HeinVerhallen/Audio-DSP/Documentation/Module Design Document/main.tex

\documentclass[11pt, a4paper]{report}
\usepackage{graphicx}
\usepackage[table,xcdraw]{xcolor}
\usepackage{geometry}
\usepackage{float}
\usepackage{authblk}
\usepackage{anyfontsize}
\usepackage[document]{ragged2e}
\usepackage{titlesec}
\usepackage[parfill]{parskip}
\usepackage{color}   %May be necessary if you want to color links
\usepackage{hyperref}
\usepackage{caption}
\usepackage{longtable}
\usepackage{blindtext}
\usepackage{pdfpages}
\usepackage{cleveref}
\usepackage{calc}
\usepackage[backend=biber]{biblatex}
\usepackage{longtable}

\bibliography{./bibfolder/ref.bib}
\usepackage{listings}
\usepackage{color}

\definecolor{dkgreen}{rgb}{0,0.6,0}
\definecolor{gray}{rgb}{0.5,0.5,0.5}
\definecolor{mauve}{rgb}{0.58,0,0.82}

\lstset{frame=tb,
  language=VHDL,
  aboveskip=3mm,
  belowskip=3mm,
  showstringspaces=false,
  columns=flexible,
  basicstyle={\small\ttfamily},
  numbers=none,
  numberstyle=\tiny\color{gray},
  keywordstyle=\color{blue},
  commentstyle=\color{dkgreen},
  stringstyle=\color{mauve},
  breaklines=true,
  breakatwhitespace=true,
  tabsize=3
}

\hypersetup{
    colorlinks=true, %set true if you want colored links
    linktoc=all,     %set to all if you want both sections and subsections linked
    linkcolor=black,  %choose some color if you want links to stand out
}
\titleformat{\chapter}[hang]
{\normalfont\huge\bfseries}{\chaptertitlename\ \thechapter}{1em}{} 
\geometry{left=2.5cm,right=2.5cm,top=2.5cm,bottom=2.5cm}
\graphicspath{ {./images/} }

\begin{document}  
    \input{titlepage.tex}

    \chapter{Introduction}
    \input{Introduction.tex}

    \chapter{Problem description}
    \input{Problem_description.tex}

    \chapter{Research}
    \input{Research.tex}

    \chapter{Concept Development}
    \input{Concept_development.tex}

    \chapter{Realization}
    \input{Realization.tex}

    \chapter{Verification}
    \input{Verification.tex}

    \chapter{Conclusions}
    \input{Conclusions.tex}

    \chapter{Recommendations}
    \input{Recommendations.tex}

    \nocite{*}
    \printbibliography
    \addcontentsline{toc}{chapter}{Bibliography} 

    \input{Appendix_statespace.tex}
    \input{Appendix_VHDL_Code.tex}
    \input{Appendix_schematics.tex}
    \input{Appendix_Case_and_UI}
    \input{Appendix_verification.tex}
    \input{Appendix_simulation_results.tex}
    \input{Appendix_RD_G.tex}
    
    \end{justify}
\end{document}
