HeinVerhallen/Audio-DSP/Documentation/Module Design Document/Appendix_schematics.tex

\chapter*{Appendix C: Schematics}
\addcontentsline{toc}{chapter}{Appendix C: Schematics}  
\label{chap:appendix-C-schematics}

\section*{Buck converter schematic} \label{Appendix_buck_schematic}
\phantomsection
\addcontentsline{toc}{section}{Buck converter schematic}
\begin{figure}[ht]  
    
    \caption{Schematic of Buck Converter}
    \label{fig:buck-schematic}
\end{figure}

\section*{SEPIC schematic} \label{Appendix_SEPIC_schematic}
\addcontentsline{toc}{section}{SEPIC schematic}  
\begin{figure}[!ht]
    
    \caption{Schematic of SEPIC}
    \label{fig:SEPIC-schematic}
\end{figure}
    
\section*{Linear regulator schematic}\label{Appendix_lin_schematic}
\addcontentsline{toc}{section}{Linear regulator schematic}
\begin{figure}[!htb]
    
    \caption{Schematic of Linear Regulator}
    \label{fig:Linear-regulator-schematic}
\end{figure}  

\section*{Main board schematic} \label{Appendix_main_schematic}
\addcontentsline{toc}{section}{Main board schematic}\

\includepdf[angle=90, pages={2,3,4,5,6,7,8}]{Main_board_schematic.pdf}

\section*{Buck converter calculations} \label{Appendix_buck_calculations}
\addcontentsline{toc}{section}{Buck converter calculations}
  
\includepdf[pages={2,3,4,5,6}]{Calculations_buck_converter.pdf}

\section*{SEPIC calculations} \label{Appendix_SEPIC_calculations}
\addcontentsline{toc}{section}{SEPIC calculations}  
