HeinVerhallen/Audio-DSP/Documentation/Module Design Document/Appendix_statespace.tex

\chapter*{Appendix A: State-space}
\addcontentsline{toc}{chapter}{Appendix A: State-space}  
\label{chap:appendix-A-statespace}

\begin{figure}[!htb]
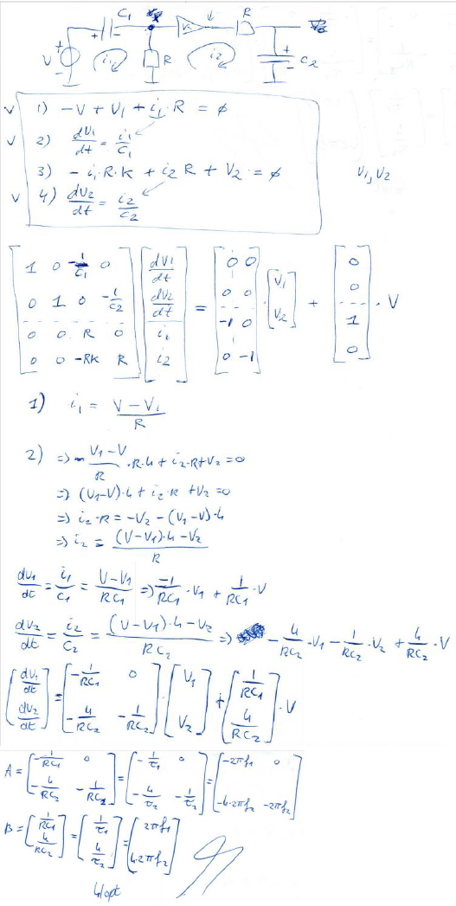
[picture p18: Documentation/Module Design Document/images/State-space_notation_solution.png]
    
    \caption{State-space notation derived from band-pass filter circuit}
    \label{fig:state-space-derived-bpf}
\end{figure}
