HeinVerhallen/Audio-DSP/Documentation/Module Design Document/Realization.tex

\section{Hardware}
\subsection{Schematic}
\input{Schematic.tex}

\subsection{Printed circuit board}
\input{Printed_circuit_board.tex}

\subsection{Case}
\input{Case.tex}

\section{Firmware}
\input{Firmware.tex}

\section{User interface}
\input{UserInterface.tex}
