HeinVerhallen/Audio-DSP/Documentation/PlanOfApproach/Costbenefitoverview.tex

From Fontys we get a budget of €300, - for this project. The most expensive parts will be the FPGA, the ADC’s and the DAC’s.
