HeinVerhallen/Audio-DSP/Plan of Approach.tex

\documentclass[*]{report}
\usepackage{lipsum}
\usepackage{graphicx}
\begin{document}
\title{Plan of Approach \\ \large audio DSP}
\author{Busse Lommers \and Robin van den Dungen \and Silas Kamphuis \and Mahmud Gurler \and Youri Tils \and Ahmed Abdelrahim \and Hein Verhallen}
\date{\today}
\maketitle
\tableofcontents

\chapter{Background}

\section{Be Creative}

\section{The Assignment}

\chapter{Project Result}
\begin{table}
\begin{tabular}{|p{1cm}|l|p{4cm}|l|p{3cm}|l|l|}
\hline
ID & Version & Requirement & Source & Rationale & Priority & Status \\
\hline
U1 & 1 & Two RCA audio inputs & Client & From the project template & Must & Proposed \\
\hline
U2 & 1 & Two XLR audio inputs & Client & From the project template & Must & Proposed \\
\hline
U3 & 1 & Two 6,35mm TRS plug audio inputs & Client & From the project template & Must & Proposed \\
\hline
U4 & 1 & USB type B audio input & Client & From the project template & Must & Proposed \\
\hline
U5 & 1 & Two RCA audio outputs & Client & From the project template & Must & Proposed \\
\hline
U6 & 1 & Four XLR audio outputs & Client & From the project template & Must & Proposed \\
\hline
U7 & 1 & Two 6,35mm TRS plug audio outputs & Client & From the project template & Must & Proposed \\
\hline
U8 & 1 & The system should have a bandwidth (±3 dB) of at least 20 Hz up and till 20 kHz without any filters applied. & Client & From the project template & Must & Proposed \\
\hline
U9 & 1 & Audio sample rate of at least 44.1 kHz & Client & From the project template & Must & Proposed \\
\hline
U10 & 1 & 16-bit ADC & Client & From the project template & Must & Proposed \\
\hline
U11 & 1 & 16-bit DAC & Client & From the project template & Must & Proposed \\
\hline
U12 & 1 & •	The system must work stand alone and be configurable via a basic graphical user interface. & Client & From the project template & Must & Proposed \\
\hline
U13 & 1 &  & Client & From the project template & Must & Proposed \\
\hline
U14 & 1 &  & Client & From the project template & Must & Proposed \\
\hline
U15 & 1 &  & Client & From the project template & Must & Proposed \\
\hline
U16 & 1 &  & Client & From the project template & Must & Proposed \\
\hline
U17 & 1 &  & Client & From the project template & Must & Proposed \\
\hline
U18 & 1 &  & Client & From the project template & Should & Proposed \\
\hline
U19 & 1 &  & Client & From the project template & Should & Proposed \\
\hline
U21 & 1 &  & Client & From the project template & Should & Proposed \\

\hline
\end{tabular}
\caption{User Requirements}
\end{table}

\chapter{Project Activities}
\begin{figure}

\caption{luca me zunne blijen bakkes	}
\end{figure}

\chapter{Project boundaries}
\lipsum[2-5]

\chapter{Milestones}
\lipsum[2-5]

\chapter{Planning}
\lipsum[2-5]

\chapter{Risk Analysis}
\lipsum[2-5]

\end{document}
