HeinVerhallen/Audio-DSP/Documentation/Research document/Research document.tex

\documentclass[11pt, a4paper]{report}
\usepackage{graphicx}
\usepackage[table,xcdraw]{xcolor}
\usepackage{geometry}
\usepackage[backend=biber]{biblatex}
\usepackage{float}
\usepackage{authblk}
\usepackage{anyfontsize}
\usepackage[document]{ragged2e}
\usepackage{titlesec}
\usepackage[parfill]{parskip}
\usepackage{amsmath}
\titleformat{\chapter}[hang] 
{\normalfont\huge\bfseries}{\chaptertitlename\ \thechapter:}{1em}{} 
\geometry{left=2.5cm,right=2.5cm,top=2.5cm,bottom=2.5cm}
\graphicspath{ {./images/} }

\addbibresource{bibfolder/ref.bib}

% CHECK https://www.youtube.com/watch?v=ZYvS52511oQ FOR INFO ON SETTINGS FOR biblatex

\begin{document}

\pagestyle{empty}
\centering
\fontsize{2cm}{2cm}\selectfont{Research document} \\
\vspace{2mm}
\fontsize{1cm}{1cm}\selectfont Audio digital signal processor \\
\vspace{2mm}
\large BeCreative Minor\\
\normalsize
\vspace{4cm}
\\
\vfill
\normalsize Busse Lommers \\
Robin van den Dungen \\
Mahmud Gürler \\
Silas Kamphuis \\
Hein Verhallen \\
Youri Tils \\
Ahmed Abdelrahim \\
Fontys Hogescholen, De Rondom 1, 5612 AP Eindhoven \\
\today

\begin{justify}

\newpage
\tableofcontents
\thispagestyle{empty}

\listoffigures
\thispagestyle{empty}

\listoftables
\thispagestyle{empty}

\newpage
\pagestyle{plain}
\setcounter{page}{1}

\chapter*{List of Abbreviations}
\begin{table}[!h]
	\centering
\begin{tabular}{|c|c|}
	\hline
\textbf{Abbreviation} & \textbf{Explanation}        			\\ \hline
DSP                   & Digital Signal Processor    			\\ \hline
ADC                   & Analog-to-Digital Converter				\\ \hline
DAC                   & Digital-to-Analog Converter				\\ \hline
SNR 				  & Signal-to-Noise Ration    				\\ \hline
THD 				  & Total Harmonic Distortion 				\\ \hline
ENOB 				  & Effective Number Of Bits 		   		\\ \hline
SINAD 				  & Signal-to-noise and distortion ratio	\\ \hline
\end{tabular}
\caption{List of commonly used Abbreviations}
\label{Abbreviation list}
\end{table}

\chapter{Introduction}
%	\input{introduction.tex}

\chapter{Research questions}

	\input{question1.tex}

% Bibliography with heading so it pops up in the table of contents (idkwhy but this is how it works)
\printbibliography[
	heading=bibintoc,
	title={Bibliography}
]

\appendix

\chapter{Appendix A}

\end{justify}
\end{document}
