HeinVerhallen/Audio-DSP/Documentation/PlanOfApproach/PlanOfApproach.tex

\documentclass[11pt, a4paper]{report}
\usepackage{graphicx}
\usepackage[table,xcdraw]{xcolor}
\usepackage{geometry}
\usepackage{float}
\usepackage{authblk}
\usepackage{anyfontsize}
\usepackage[document]{ragged2e}
\usepackage{titlesec}
\usepackage[parfill]{parskip}
\usepackage{color}   %May be necessary if you want to color links
\usepackage{hyperref}
\usepackage{caption}
\usepackage{tabularx}
\usepackage{longtable}
\usepackage{blindtext}
\hypersetup{
    colorlinks=true, %set true if you want colored links
    linktoc=all,     %set to all if you want both sections and subsections linked
    linkcolor=black,  %choose some color if you want links to stand out
}
\titleformat{\chapter}[hang] 
{\normalfont\huge\bfseries}{\chaptertitlename\ \thechapter:}{1em}{} 
\geometry{left=2.5cm,right=2.5cm,top=2.5cm,bottom=2.5cm}
\graphicspath{ {./images/} }

% Handy link: https://artofproblemsolving.com/wiki/index.php/LaTeX:Layout

% CHECK https://www.youtube.com/watch?v=ZYvS52511oQ FOR INFO ON SETTINGS FOR biblatex

\begin{document}
\pagestyle{empty}
\centering
\fontsize{2cm}{2cm}\selectfont{Plan of Approach} \\
\vspace{2mm}
\fontsize{1cm}{1cm}\selectfont Audio digital signal processor \\
\vspace{2mm}
\large BeCreative Minor\\
\normalsize
\vspace{4cm}
\\
\vfill
\normalsize Busse Lommers \\
Robin van den Dungen \\
Mahmud Gürler \\
Silas Kamphuis \\
Hein Verhallen \\
Youri Tils \\
Ahmed Abdelrahim \\
Fontys Hogescholen, De Rondom 1, 5612 AP Eindhoven \\
\today

\begin{justify}

\newpage
\tableofcontents
\thispagestyle{empty}

\listoffigures
\thispagestyle{empty}

\listoftables
\thispagestyle{empty}

\newpage
\pagestyle{plain}
\setcounter{page}{1}

\chapter*{Abbreviation List}

\begin{table}[!h]
	\centering
\begin{tabular}{|c|c|}
	\hline
\textbf{Abbreviation} & \textbf{Explanation}        \\ \hline
DSP                   & Digital Signal Processor    \\ \hline
ADC                   & Analog-to-Digital Converter \\ \hline
DAC                   & Digital-to-Analog Converter \\ \hline
\end{tabular}
\caption{List of commonly used Abbreviations}
\label{Abbreviation list}
\end{table}

\chapter{Background}
	\input{Background}

\chapter{Project result}
	\input{Projectresult}
	
\chapter{Project activities}
	\input{Projectactivities}

\chapter{Project boundaries}
	\input{Projectboundaries}
	
\chapter{Milestones}
	\input{Milestones}

\chapter{Quality assurance}
	\input{Qualityassurance}

\chapter{Project organisation}
	\input{Projectorganisation}

\chapter{Planning}
	\input{Planning}

\chapter{Cost-benefit overview}
	\input{Costbenefitoverview}

\chapter{Risk Analysis}
	\input{Riskanalysis}

% Bibliography with heading so it pops up in the table of contents (i don't know why but this is how it works)
% \printbibliography[
% heading=bibintoc,
% title={Bibliography}
% ]
	\end{justify}
\end{document}
