HeinVerhallen/Audio-DSP/Documentation/PlanOfApproach/Milestones.tex

%Milestones
The following milestones will be achieved as a result of the project activities as in Chapter 3.
\begin{itemize}
    \setlength\itemsep{-0.2em}
    \item Reports:
    \begin{itemize}
        \setlength\itemsep{-0.2em}
        \item Research document
        \item SRD
        \item SDD
        \item MDD
        \item Final report
    \end{itemize}
    \item Designs:
    \begin{itemize}
        \setlength\itemsep{-0.2em}
        \item Firmware design:
        \begin{itemize}
            \setlength\itemsep{-0.2em}
            \item Input MUX design
            \item Sampler design
            \item USB decoder design
            \item Output MUX design
            \item signal processor design
            \begin{itemize}
                \setlength\itemsep{-0.2em}
                \item Effect manager design
                \item Effects design/model
                \item Filters design/model
            \end{itemize}
            \item controller design
        \end{itemize}
        \item Hardware design:
        \begin{itemize}
            \setlength\itemsep{-0.2em}
            \item Input selector design
            \item Anti-aliasing filters design
            \item Output filter design
            \item Buffer design
            \item XLR balanced-to-unbalanced converter design
            \item XLR unbalanced-to-balanced converter design
            \item processor core design
            \item Local power supplies design
            \item Housing design
        \end{itemize}
        \item User interface design
    \end{itemize}
    \item Realistation:
    \begin{itemize}
        \setlength\itemsep{-0.2em}
        \item Firmware:
        \begin{itemize}
            \setlength\itemsep{-0.2em}
            \item Program ADC and DAC interface
            \item Program sampler
            \item Program USB decoder
            \item Program MUX
            \item Program signal processor
            \begin{itemize}
                \setlength\itemsep{-0.2em}
                \item Program effect manager
                \item Program filters
                \item Program effects
            \end{itemize}
            \item Program controller
        \end{itemize}
        \item Hardware:
        \begin{itemize}
            \setlength\itemsep{-0.2em}
            \item Housing
            \item PCB
        \end{itemize}
        \item User interface
    \end{itemize}
\end{itemize}
