HeinVerhallen/Audio-DSP/Documentation/PlanOfApproach/Qualityassurance.tex

To assure that the quality is monitored the following things will be done:
\begin{itemize}
	\setlength\itemsep{-0.3em}
    \item Version-control with GitHub
    \item Documents will be written in LaTeX
    \item Weekly activities will be monitored to guard the process.
    \item The PCB design will be made in KiCad
    \item C++ code is written with Microsoft Visual Studio
\end{itemize}
