HeinVerhallen/Audio-DSP/Firmware/DASstudent2021/DAS docent 1 board.docx

DAS docent 1 board:

1. Start testdas project
2. Compile all by runnig synthesis and analysis
3. Start modelsim
4. Compile das.vhd and all related testbench files
5. Run the do file for adding signals or add them by yourself
6. Run 30000000 or any other number
7. Check the results.
8. Generate programming file
9. Test it.
