HeinVerhallen/Audio-DSP/LTspice/Negatve supply (-15V SEPIC)/LT3579_calculations.docx

Step | PARAMETERS/EQUATIONS
1: Inputs | Pick V_(in) , V_(out) ,and f_(osc) to calculate equations below. | V_(in) =18 V V_(out) =-15 V f_(osc) =1 MHz (<f_(max) =2.5MHz)
2: DC | DC≅(|V_(OUT) |+0.5V)/(V_(IN) +|V_(OUT) |+0.5V-0.27V) | DC≅(|-15|+0.5)/(18+|-15|+0.5-0.27)=46.6%
3: L | L_(TYP) =((V_(IN) -0.27V)∙DC)/(f_(OSC) ∙1.8A) L_(MIN) =((V_(IN) -0.27V)∙(2DC-1))/(4A∙f_(OSC) ∙(1-DC)) L_(MAX) =((V_(IN) -0.27V)∙DC)/(f_(OSC) ∙0.5A) | L_(TYP) =((18-0.27)∙0.466)/(1∙10^6 ∙1.8)=4.59 µH L_(MIN) =((18-0.27)∙(2∙0.466-1))/(4∙1∙10^6 ∙(1-0.466))=-564 nH→564 nH L_(MAX) =((18-0.27)∙0.466)/(1∙10^6 ∙0.5)=16.5 µH
4: I_(RIPPLE) | I_(RIPPLE) =((V_(IN) -0.27)∙DC)/(f_(OSC) ∙L) | I_(RIPPLE) =((18-0.27)∙0.466)/(1∙10^6 ∙4∙10^(-6))=2.066 A
5: I_(OUT) | I_(OUT) =(6A-(I_(RIPPLE))/2)∙(1-DC) | I_(OUT) =(6-2.066/2)∙(1-0.466)=2.652 A
6: D_1 | V_R >V_(IN) +|V_(OUT) |;I_(AVG) >I_(OUT) | V_R >18+|-15|→V_R >33 V I_(AVG) >1vA
7: C_1 | 4.7 μF (typical);V_(RATING) >V_(IN) +|V_(OUT) | | C_1 =4.7 μF V_(RATING) >18+|-15|→V_(RATING) >33 V
8: C_(OUT) | C_(OUT) =(I_(RIPPLE))/(8∙f_(OSC) ∙5∙10^(-3) ∙|V_(OUT) |) | C_(OUT) =2.066/(8∙1∙10^6 ∙5∙10^(-3) ∙|-15|)=3.443 μF
9: C_(IN) | C_(IN) =C_(PWR) +C_(VIN) C_(IN) =(I_(RIPPLE))/(8∙f_(OSC) ∙5∙10^(-3) ∙V_(IN))+(6A∙DC)/(40∙f_(OSC) ∙5∙10^(-3) ∙V_(IN)) | C_(IN) =2.066/(8∙1∙10^6 ∙5∙10^(-3) ∙18)+(6∙0.466)/(40∙1∙10^6 ∙5∙10^(-3) ∙18)=3.646 μF
10: R_(FB) | R_(FB) =(|V_(OUT) |+9mV)/(83.3μA) | R_(FB) =(|-15|+9∙10^(-3))/(83.3∙10^(-6))=180.180 kΩ→180 kΩ
11: R_T | R_T =87.6/(f_(OSC))-1;f_(OSC) in MHz and R_T in kΩ | R_T =87.6/1-1=86.6 kΩ→82 kΩ
