HeinVerhallen/Audio-DSP/LTspice/Front-end/High side switch level shifter schematic.pdf

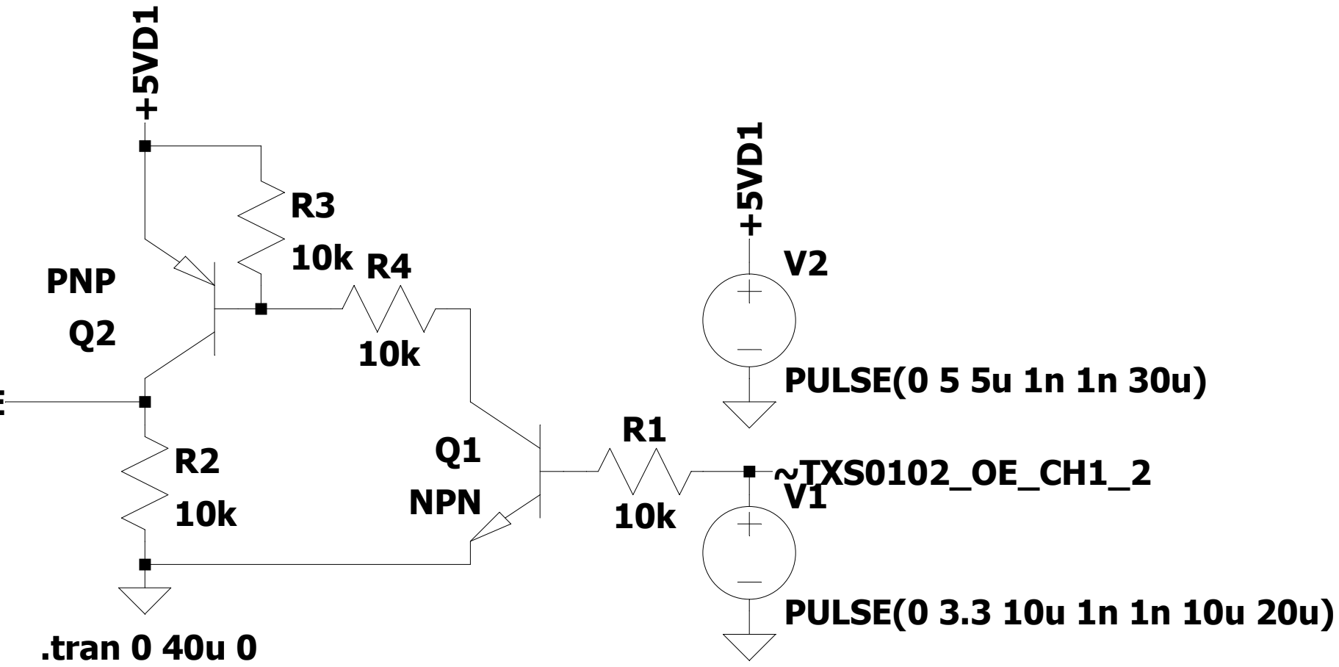
[picture p43: figure]
Q1 NPN; PNP; PULSE(0 3.3 10u 1n 1n 10u 20u); PULSE(0 5 5u 1n 1n 30u) ⁺⁵VD¹; +⁵VD¹; ~TXS0102_OE_CH1_2; .tran 0 40u 0

OE

--- C:\Users\robin\OneDrive\Documenten\School\Fontys\Minor\Be creative minor\Git\Audio-DSP\LTspice\Front-end\High side switch level shifter.asc ---
