HeinVerhallen/Audio-DSP/Block diagrams/System design/Back-end detailed.pdf

# Legend

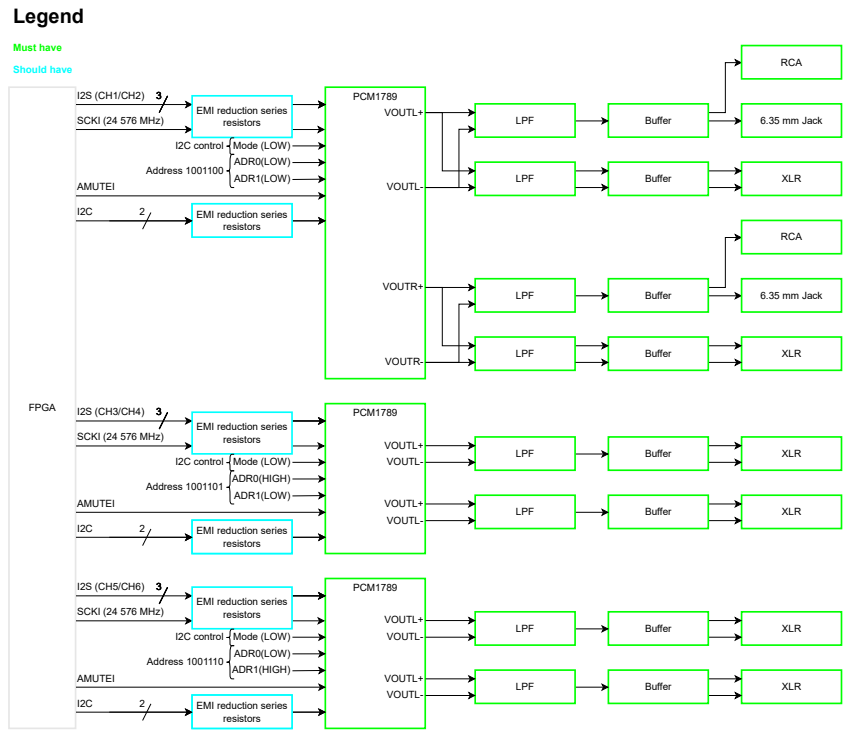
[picture p44: page 1]
Must have; Should have; FPGA; Mode (LOW); SCKI (24 576 MHz)3; PCM1789; LPF; Buffer; XLR; 6.35 mm Jack; RCA; VOUTL-; VOUTL+; ADR0(LOW); ADR1(LOW); AMUTEI; EMI reduction series; VOUTR-; VOUTR+; ADR0(HIGH); I2C control; Address 1001100; Address 1001101; ADR1(HIGH); Address 1001

EMI reduction series
resistors

EMI Red Resistors
