HeinVerhallen/Audio-DSP/Documentation/Module Design Document/images/Calculations_buck_converter.pdf

## Calculations 5V buck:

- Fs = 1MHz
- Cout = 50 uF DC derated
- Vin = 24V
- Vout = 5V
- Iout = 2A
- Fc = Fs/10 = 100KHz
- Vout = 10mV
- ESR = 10mΩ

L =

0.7 ∗ Vout
Fs

=

0.7 ∗ 5
1MHz = 0.0000035H = 3.5μH => 4.7μH

D =

Vout

Vin

=

5V
24V

= 0.208

T =

1
Fs

=

1
1MHz = 1μS

∆Il =

Vin − Vout
L

∗ D ∗ T =

24 − 5
4.7μH ∗ 0.208 ∗ 1μS = 0.841A

Cout =

∆Q

∆Vcout

=

∆Il

8 ∗ Fs ∗ ∆Vcout

=

0.841A
8 ∗ 1MHz ∗ 10mV = 1.5 ∗ 10⁻⁵ = 10.5μF

∆Vcout =

∆Q

Cout

=

∆Il

8 ∗ Fs ∗ Cout

=

0.841A
8 ∗ 1MHz ∗ 50μF = 2.10 ∗ 10⁻³ = 2.10mV

Met ESR:

∆Vcout = ∆Il (

1

8 ∗ Fs ∗ Cout

+ ESR) = 0.841 (

1
8 ∗ 1MHz ∗ 50μF + 10mΩ) = 0.0105 = 10.5mV

## Calculations 8V buck:

- Fs = 1MHz
- Cout = 50 uF DC derated
- Vin = 24V
- Vout = 8V
- Iout = 2A
- Fc = Fs/10 = 100KHz
- Vout = 10mV
- ESR = 10mΩ

L =

0.7 ∗ Vout
Fs

=

0.7 ∗ 8
1MHz = 5.6 ∗ 10⁻⁶ = 5.6μH => 6.8μH

D =

Vout

Vin

=

8V
24V

= 0.3333

T =

1
Fs

=

1
1MHz = 1μS

∆Il =

Vin − Vout
L

∗ D ∗ T =

24 − 8
6.8μH ∗ 0.3333 ∗ 1μS = 0.784

Cout =

∆Q

∆Vcout

=

∆Il

8 ∗ Fs ∗ ∆Vcout

=

0.784A
8 ∗ 1MHz ∗ 10mV = 9.8 ∗ 10⁻⁶ = 9.8μF

∆Vcout =

∆Q

Cout

=

∆Il

8 ∗ Fs ∗ Cout

=

0.784A
8 ∗ 1MHz ∗ 50μF = 1.96 ∗ 10⁻³ = 1.96mV

Met ESR:

∆Vcout = ∆Il (

1

8 ∗ Fs ∗ Cout

+ ESR) = 0.784 (

1
8 ∗ 1MHz ∗ 50μF + 10mΩ) = 9.8 ∗ 10⁻³ = 9.8mV

## Calculations 12V buck:

- Fs = 1MHz
- Cout = 50 uF DC derated
- Vin = 24V
- Vout = 12V
- Iout = 4A of 2A
- Fc = Fs/10 = 100KHz
- Vout = 10mV
- ESR = 10mΩ

L =

0.7 ∗ Vout
Fs

=

0.7 ∗ 12
1MHz = 8.4 ∗ 10⁻⁶ = 8.4μH => 10μH

D =

Vout

Vin

=

12V
24V

= 0.5

T =

1
Fs

=

1
1MHz = 1μS

∆Il =

Vin − Vout
L

∗ D ∗ T =

24 − 12
10μH ∗ 0.5 ∗ 1μS = 0.6

Cout =

∆Q

∆Vcout

=

∆Il

8 ∗ Fs ∗ ∆Vcout

=

0.6A
8 ∗ 1MHz ∗ 10mV = 7.5 ∗ 10⁻⁶ = 7.5μF

∆Vcout =

∆Q

Cout

=

∆Il

8 ∗ Fs ∗ Cout

=

0.6A
8 ∗ 1MHz ∗ 50μF = 1.5 ∗ 10⁻³ = 1.5mV

Met ESR:

∆Vcout = ∆Il (

1

8 ∗ Fs ∗ Cout

+ ESR) = 0.6 (

1
8 ∗ 1MHz ∗ 50μF + 10mΩ) = 7.5 ∗ 10⁻³ = 7.5mV

## Calculations 15V buck:

- Fs = 1MHz
- Cout = 50 uF DC derated
- Vin = 24V
- Vout = 15V
- Iout = 2A
- Fc = Fs/10 = 100KHz
- Vout = 10mV
- ESR = 10mΩ

L =

0.7 ∗ Vout
Fs

=

0.7 ∗ 15
1MHz = 10.5 ∗ 10⁻⁶ = 10.5μH => 15μH

D =

Vout

Vin

=

15V
24V

= 0.625

T =

1
Fs

=

1
1MHz = 1μS

∆Il =

Vin − Vout
L

∗ D ∗ T =

24 − 15
15μH ∗ 0.625 ∗ 1μS = 0.375

Cout =

∆Q

∆Vcout

=

∆Il

8 ∗ Fs ∗ ∆Vcout

=

0.375A
8 ∗ 1MHz ∗ 10mV = 4.68 ∗ 10⁻⁶ = 4.68μF

∆Vcout =

∆Q

Cout

=

∆Il

8 ∗ Fs ∗ Cout

=

0.375A
8 ∗ 1MHz ∗ 50μF = 0.937 ∗ 10⁻³ = 0.937mV

Met ESR:

∆Vcout = ∆Il (

1

8 ∗ Fs ∗ Cout

+ ESR) = 0.375 (

1
8 ∗ 1MHz ∗ 50μF + 10mΩ) = 4.7 ∗ 10⁻³ = 4.7mV

## Voltage divider 5V:

- Vout = 5V
- Feedback voltage = 0.9V

divison =

5
0.9

= 5.55

Vref = Vout ∗

R2
R2 + R1

= 5 ∗

22
100 + 22 = 0.901V

E12 : 100k and 22K for 0.1%

Voltage divider 8V:

- Vout = 8V
- Feedback voltage = 0.9V

divison =

8
0.9

= 8.88

Vref = Vout ∗

R2
R2 + R1

= 8 ∗

15K
120K + 15K

= 0.88V

E12 : 120k and 15K for 1.52%

Voltage divider 12V:

- Vout = 12V
- Feedback voltage = 0.9V

divison =

12
0.9

= 13.33

Vref = Vout ∗

R2
R2 + R1

= 12 ∗

22K
270K + 22K

= 0.904V

E12 : 270k and 22K for 0.47%

Voltage divider 15V:

- Vout = 15V
- Feedback voltage = 0.9V

divison =

12
0.9

= 16.66

Vref = Vout ∗

R2
R2 + R1

= 15 ∗

30K
470K + 30K

= 0.9V

E24 : 470k and 30K for 0.04%

Cin =

Iout(max) ∗ D ∗ (1 − D)
η ∗ Fsw ∗ ∆Vin

=

2A ∗ 0.208 ∗ (1 − 0.208)
0.9 ∗ 1MHz ∗ 200mV = 1.83 ∗ 10⁻⁶ = 1.83 μF

Setting up UVLO. Datasheet recommends for R1 to be 3.3MΩ. Vinu needs to be higher than 0.8 * Vout to avoid hiccups during slow power-up. The highest Vout = 15V so the min Vinu should be 12V. since we want to use a Vout of 15V and we use a buck converter we should set this to more than 15V, let's say 18V

R2 =

R1 ∗ 1.215
Vinu − 1.215 =

3.3MΩ ∗ 1.215
18 − 1.215 = 238873Ω ≈ 220K

This will give a UVLO of:

Vinu =

R1 ∗ 1.215
R2 − 1.215 =

3.3M ∗ 1.215
220K − 1.215 = 18.225V

SS (Soft-Start) Soft-Start Capacitor Selection:

The device implements adjustable soft-start operation to reduce inrush current. A capacitor connected from the SS pin to SGND programs the soft-start time. The selected output capacitance (CSEL) and the output voltage (VOUT) determine the minimum required soft-start capacitor as follows:

Css ≥ 28 × 10⁻⁶ × CSEL × VOUT

The soft-start time (tSS) is related to the capacitor connected at SS (CSS) by the following equation:

tSS =

CSS
5.55 × 10⁻⁶

Because of multiple output voltages, the SS with the highest output voltage is leading. Therefore 15V as the output voltage is the one to choose.

Css ≥ 28 × 10⁻⁶ × 50μ × 15 = 28nF Css = 33nF

tss =

33n
5.55 × 10⁻⁶ = 5.95ms

The RT resistor selection:

The RT is responsible for the switching frequency of the buck converter. In the calculations the determined switching frequency is 1MHz.

RRT(kΩ) ≅

21000

fSW(kHz)

− 1.7 =

21000
1000 − 1.7 = 19.3kΩ

RRT = 20kΩ
