HeinVerhallen/Audio-DSP/LTspice/Front-end/High side switch level shifter simulation.pdf

0µs | 4µs | 8µs | 12µs | 16µs | 20µs | 24µs | 28µs | 32µs | 36µs | 40µs

0.0V

0.5V

1.0V

1.5V

2.0V

2.5V

3.0V

3.5V

4.0V

4.5V

5.0V

0.0V

0.3V

0.6V

0.9V

1.2V

1.5V

1.8V

2.1V

2.4V

2.7V

3.0V

3.3V

0.0V

0.5V

1.0V

1.5V

2.0V

2.5V

3.0V

3.5V

4.0V

4.5V

5.0V

V(oe)

V(~txs0102_oe_ch1_2)

V(+5vd1)

--- C:\Users\robin\OneDrive\Documenten\School\Fontys\Minor\Be creative minor\Git\Audio-DSP\LTspice\Front-end\High side switch level shifter.raw ---
