HeinVerhallen/Audio-DSP/Documentation/PlanOfApproach/Planning.tex

%orange : FF9930

\arrayrulecolor{black}
    \begin{table}[!h]
        \centering
        \addtolength{\leftskip} {-2cm}
        \addtolength{\rightskip}{-2cm}
        \textcolor{white}{
            \begin{tabular}{l|l|l|l|l|l|l|l|l|l|l|l|l|l|l|l|l|l|l|l|}
            \cline{2-20}
             & \multicolumn{19}{c|}{\cellcolor{cyan}Project Week Number}                                                             \\ \hline
             \rowcolor{cyan}
             \multicolumn{1}{|l|}{\cellcolor{cyan}Activities}               &1 &2 &3 &4 &5 &6 &7 &8 &9 &10&11&12&13&14&15&16&17&18&19\\ \hline
             \rowcolor{orange}
             \multicolumn{1}{|l|}{\cellcolor{cyan}Reporting}                &&&&&&&&&&&&&&&&&&&  \\ \hline
             \multicolumn{1}{|l|}{\cellcolor{cyan}Plan of Approach}         &\cellcolor{orange}&\cellcolor{orange}&&&&&&&&&&&&&&&&&  \\ \hline
             \multicolumn{1}{|l|}{\cellcolor{cyan}Researching}              &&\cellcolor{orange}&\cellcolor{orange}&\cellcolor{orange}&&&&&&&&&&&&&&&  \\ \hline
             \multicolumn{1}{|l|}{\cellcolor{cyan}Design firmware}          &&&&\cellcolor{orange}&\cellcolor{orange}&\cellcolor{orange}&\cellcolor{orange}&\cellcolor{orange}&\cellcolor{orange}&\cellcolor{orange}&\cellcolor{orange}&\cellcolor{orange}&&&&&&&  \\ \hline
             \multicolumn{1}{|l|}{\cellcolor{cyan}Design hardware}          &&&&\cellcolor{orange}&\cellcolor{orange}&\cellcolor{orange}&\cellcolor{orange}&\cellcolor{orange}&\cellcolor{orange}&\cellcolor{orange}&\cellcolor{orange}&\cellcolor{orange}&&&&&&&  \\ \hline
             \multicolumn{1}{|l|}{\cellcolor{cyan}Program user interface}   &&&&\cellcolor{orange}&\cellcolor{orange}&\cellcolor{orange}&\cellcolor{orange}&\cellcolor{orange}&\cellcolor{orange}&\cellcolor{orange}&\cellcolor{orange}&\cellcolor{orange}&&&&&&&  \\ \hline
             \multicolumn{1}{|l|}{\cellcolor{cyan}Design user interface}    &&&&&&&&&&&&\cellcolor{orange}&\cellcolor{orange}&\cellcolor{orange}&\cellcolor{orange}&\cellcolor{orange}&\cellcolor{orange}&\cellcolor{orange}&  \\ \hline
             \multicolumn{1}{|l|}{\cellcolor{cyan}Program firmware}         &&&&&&&&&&&&\cellcolor{orange}&\cellcolor{orange}&\cellcolor{orange}&\cellcolor{orange}&\cellcolor{orange}&\cellcolor{orange}&\cellcolor{orange}&  \\ \hline
             \multicolumn{1}{|l|}{\cellcolor{cyan}Create hardware}          &&&&&&&&&&&&\cellcolor{orange}&\cellcolor{orange}&\cellcolor{orange}&\cellcolor{orange}&\cellcolor{orange}&\cellcolor{orange}&\cellcolor{orange}&  \\ \hline
             \multicolumn{1}{|l|}{\cellcolor{cyan}Testing}                  &&&&&&&&&&&&&&&&&&\cellcolor{orange}&\cellcolor{orange}  \\ \hline
            \end{tabular}
        }
        \caption{Planning}
        \end{table}
    
\par
\bigskip
\noindent
This planning will be a guideline through out this project. Small changes can be made in case that is necessary.
