HeinVerhallen/Audio-DSP/Firmware/Signal_processor/20230323_working_sequential_effect_loop.pdf

000000000000000100001110 | 111100010010101000000011 | 000000000000000000000000
000000000000000100001110 | 000000000000001000100000 | 111000100101010000001010 | 000000000000000000000100

UUUUUUUUUUUUUUUUUUUUUUUU

UUUUU

0010000011000100000101011

0000000000000000000000000

0000000000000000000000000

0000000000000000000000000

0000000000000000000000000

0000000000000000000000000

0000000000000000000000000

0000000000000000000000000

0000000000000000000000000

0000000000000000000000000

0000000000000000000000000

0000000000000000000000000

0000000000000000000000000

{0010000011000100000101011} {0000000000000000000000000} {0000000000000000000000000} {0000000000000000000000000} {0000000000000000000000000} {0000000000000000000000000} {0000000000000000000000000} {0000000000000000000000000} {0000000000000000000000000} {0000000000000000000000000} {0000000000000000000000000} {0000000000000000000000000} {0000000000000000000000000}
13

20

00000

00001

00010

00011

0 ns | 10 ns | 20 ns | 30 ns | 40 ns | 50 ns | 60 ns | 70 ns | 80 ns | 90 ns | 100 ns | 110 ns | 120 ns | 130 ns | 140 ns | 150 ns

/signal_proc/clk

/signal_proc/nrst

/signal_proc/input 000000000000000100001110 | 111100010010101000000011 | 000000000000000000000000
/signal_proc/output | 000000000000000100001110 | 000000000000001000100000 | 111000100101010000001010 | 000000000000000000000100

/signal_proc/data UUUUUUUUUUUUUUUUUUUUUUUU

/signal_proc/regSel UUUUU

/signal_proc/enData

/signal_proc/rw

/signal_proc/pos_1 0010000011000100000101011

/signal_proc/pos_2 0000000000000000000000000

/signal_proc/pos_3 0000000000000000000000000

/signal_proc/pos_4 0000000000000000000000000

/signal_proc/eq_f1 0000000000000000000000000

/signal_proc/eq_f2 0000000000000000000000000

/signal_proc/eq_f3 0000000000000000000000000

/signal_proc/eq_f4 0000000000000000000000000

/signal_proc/eff_1 0000000000000000000000000

/signal_proc/eff_2 0000000000000000000000000

/signal_proc/eff_3 0000000000000000000000000

/signal_proc/eff_4 0000000000000000000000000

/signal_proc/eff_5 0000000000000000000000000

/signal_proc/regs {0010000011000100000101011} {0000000000000000000000000} {0000000000000000000000000} {0000000000000000000000000} {0000000000000000000000000} {0000000000000000000000000} {0000000000000000000000000} {0000000000000000000000000} {0000000000000000000000000} {0000000000000000000000000} {0000000000000000000000000} {0000000000000000000000000} {0000000000000000000000000}

/signal_proc/reg_amount 13

/signal_proc/eff_num 20

/signal_proc/wire 00000

/signal_proc/distortion 00001

/signal_proc/reverb 00010

/signal_proc/delay 00011

Entity:signal_proc Architecture:arch Date: Thu Mar 23 12:18:58 CET 2023 Row: 1 Page: 1

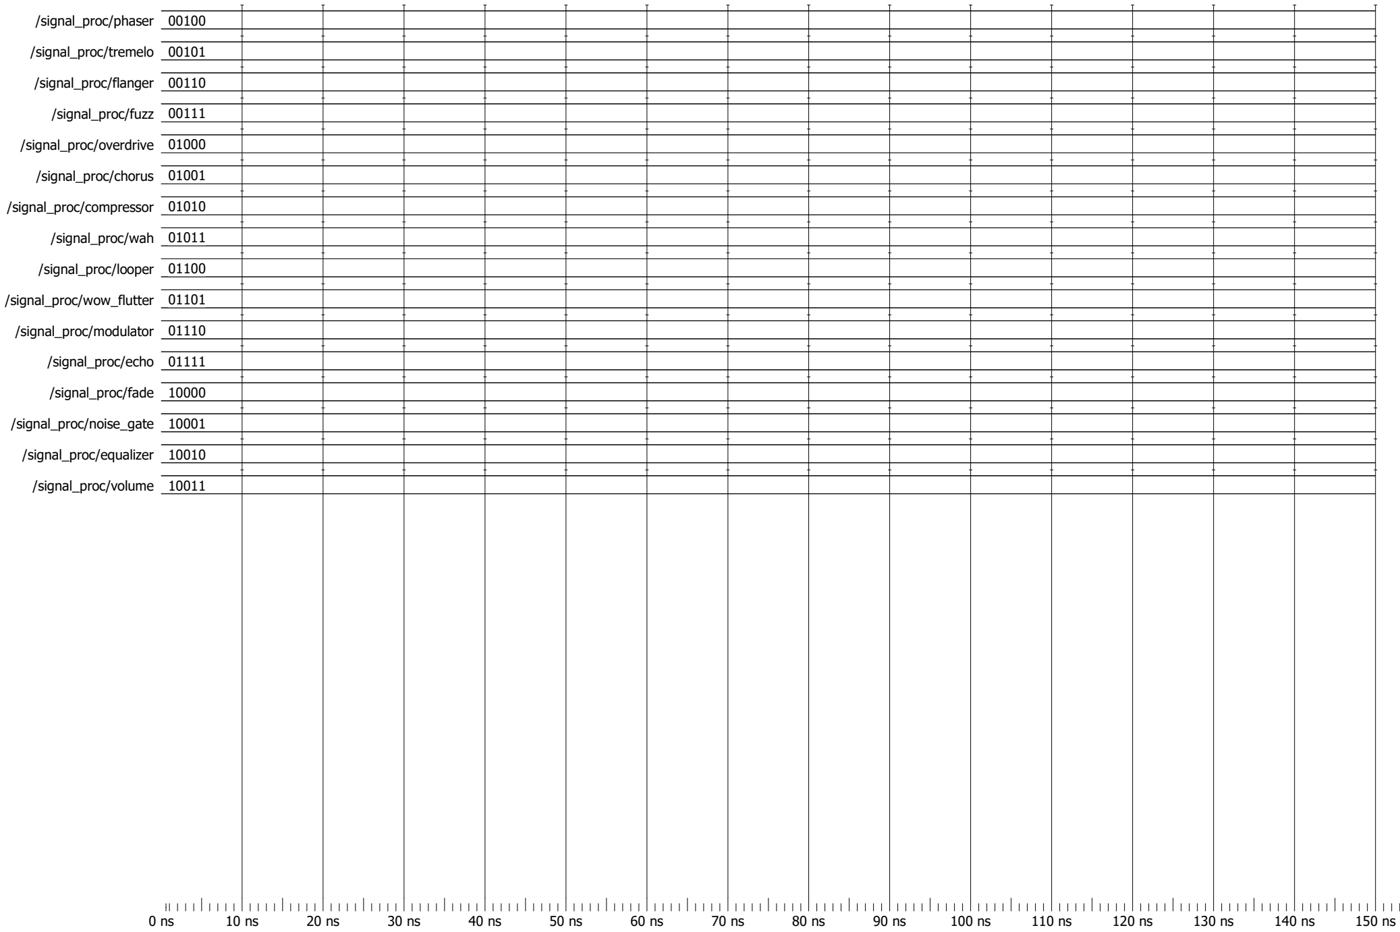
[picture p57: figure]
/signal_proc/phaser 00100; /signal_proc/tremelo 00101; /signal_proc/flanger 00110; /signal_proc/fuzz 00111; /signal_proc/overdrive 01000; /signal_proc/chorus 01001; /signal_proc/compressor 01010; /signal_proc/wah 01011; /signal_proc/looper 01100; /signal_proc/wow_flutter 01101; /signal_proc/modulator 01110; /signal_proc/echo 01111; /signal_proc/fade 10000; /signal_proc/noise_gate 10001; /signal_proc/equalizer 10010; /signal_proc/volume 10011

Entity:signal_proc Architecture:arch Date: Thu Mar 23 12:18:58 CET 2023 Row: 1 Page: 2
