HeinVerhallen/Audio-DSP/LTspice/Negatve supply (-15V SEPIC)/OLD or not working properly/Links.docx

https://www.analog.com/en/products/ltc1624.html

https://www.analog.com/en/products/lt8364.html#product-overview

https://www.analog.com/en/products/ltc7149.html#product-overview

https://www.analog.com/en/products/lt3959.html

https://www.analog.com/en/products/lt3581.html

https://www.analog.com/en/products/lt3844.html

https://www.analog.com/en/products/lt3479.html

https://www.analog.com/en/products/ltc1624.html

https://www.analog.com/en/products/lt1074.html#product-overview

https://nl.mouser.com/ProductDetail/Analog-Devices/LT3579IFEPBF?qs=hVkxg5c3xu9nCx8EMTGWfw%3D%3D

DCDC converter modules

https://nl.mouser.com/c/power/dc-dc-converters/isolated-dc-dc-converters/isolated-dc-dc-converters-through-hole/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
