HeinVerhallen/Audio-DSP/Block diagrams/System design/Sampler design.drawio.png

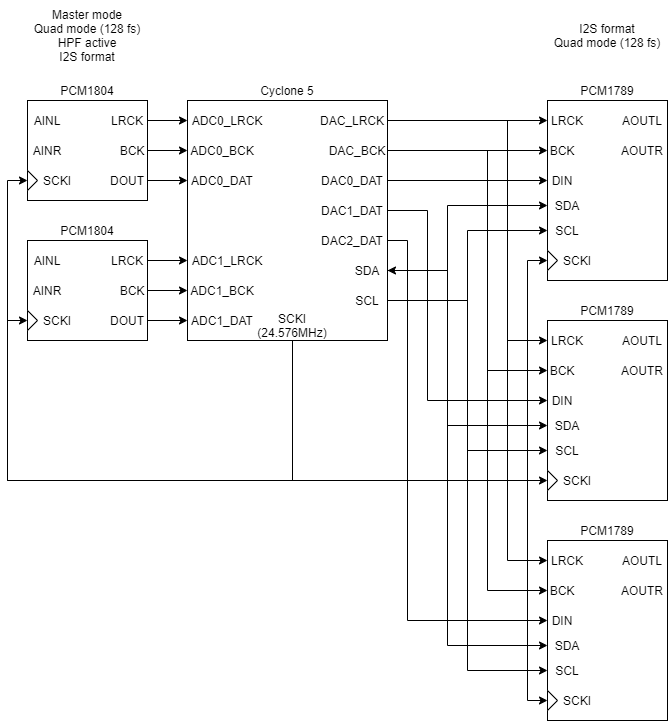
Block diagrams/System design/Sampler design.drawio.png
