HeinVerhallen/Audio-DSP/Block diagrams/System design/SDRAM_bank_assignments-Butterfly VHDL architecture.drawio.png

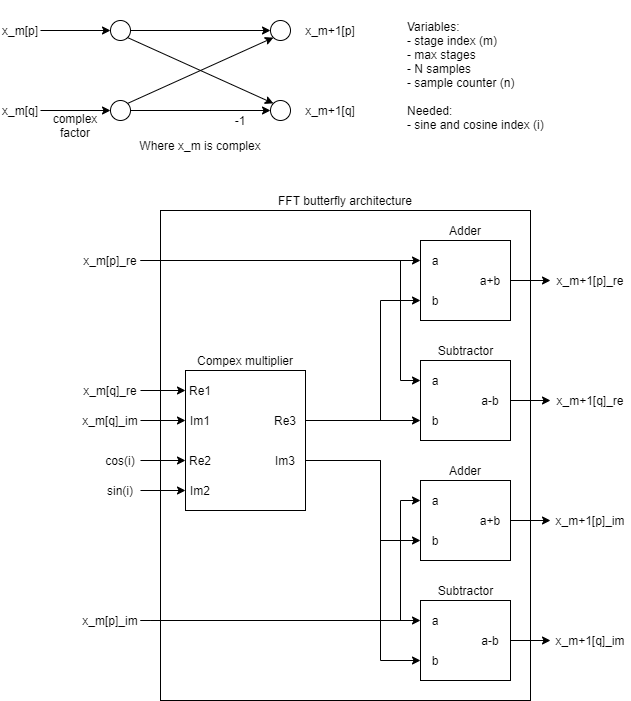
Block diagrams/System design/SDRAM_bank_assignments-Butterfly VHDL architecture.drawio.png
