HeinVerhallen/Audio-DSP/Block diagrams/System design/Signal processor sample bank and FFT process.drawio.png

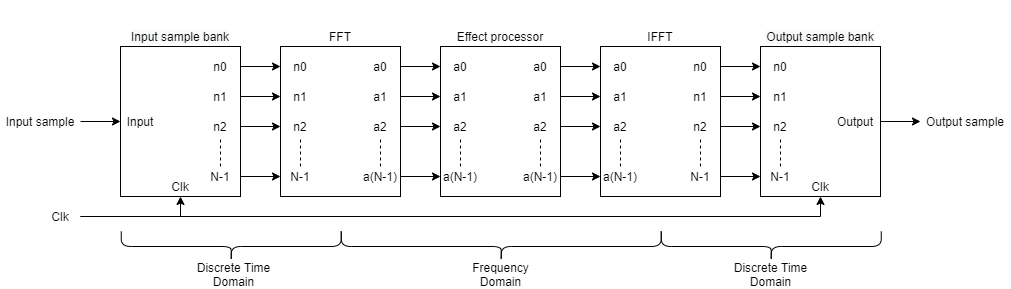
Block diagrams/System design/Signal processor sample bank and FFT process.drawio.png
