HeinVerhallen/Audio-DSP/Documentation/Module Design Document/images/1MHz_FPGA_Clock_NO_OCPGPIO_0_5.png

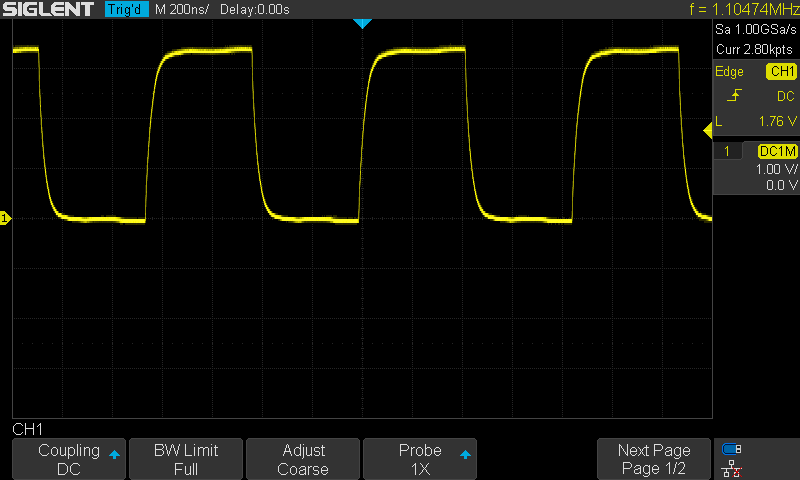
Documentation/Module Design Document/images/1MHz_FPGA_Clock_NO_OCPGPIO_0_5.png
