HeinVerhallen/Audio-DSP/Documentation/Module Design Document/images/3.3V CMOS GPIO_0_2.png

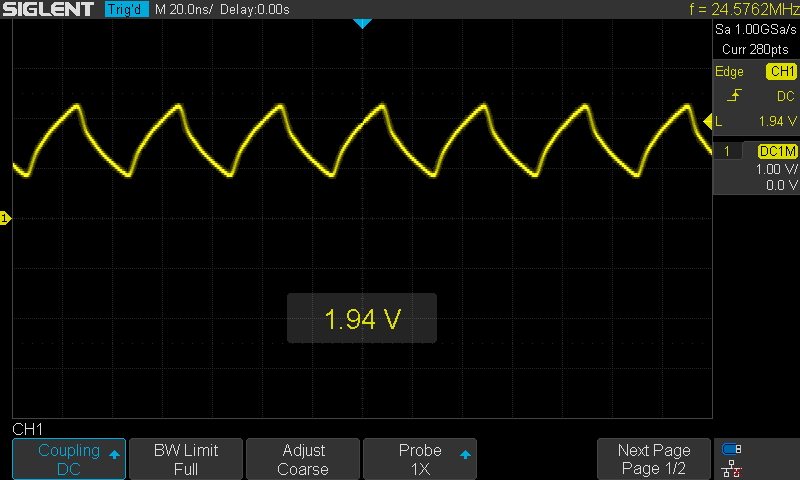
Documentation/Module Design Document/images/3.3V CMOS GPIO_0_2.png
