HeinVerhallen/Audio-DSP/Documentation/Module Design Document/images/adjustpreset1-2.jpg

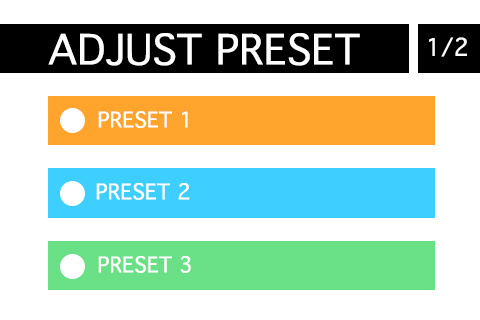
Documentation/Module Design Document/images/adjustpreset1-2.jpg
