HeinVerhallen/Audio-DSP/Documentation/Module Design Document/images/frontviewcase.png

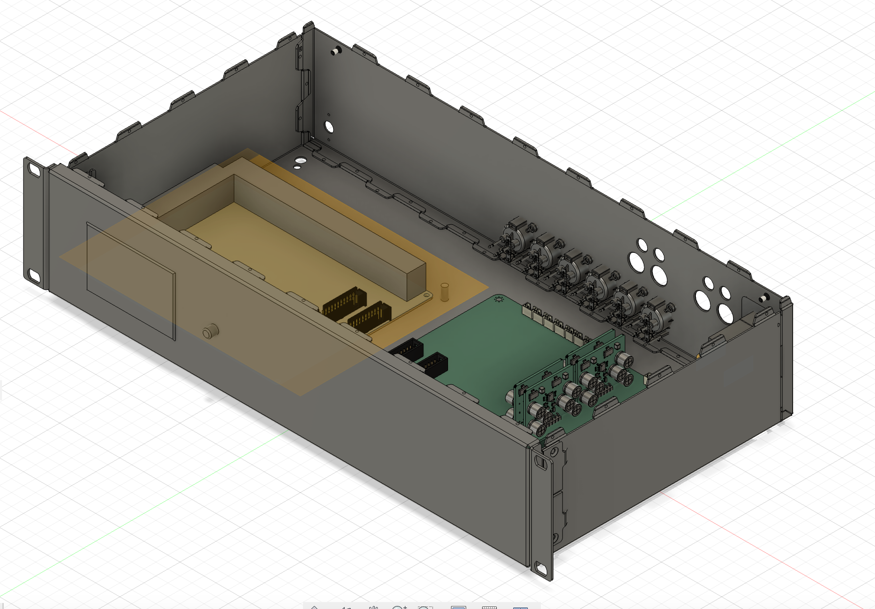
Documentation/Module Design Document/images/frontviewcase.png
