HeinVerhallen/Audio-DSP/Documentation/Module Design Document/images/MainMenu1.jpg

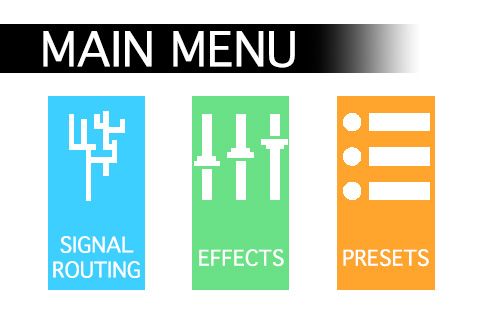
Documentation/Module Design Document/images/MainMenu1.jpg
