HeinVerhallen/Audio-DSP/Documentation/Module Design Document/images/rearviewcase.png

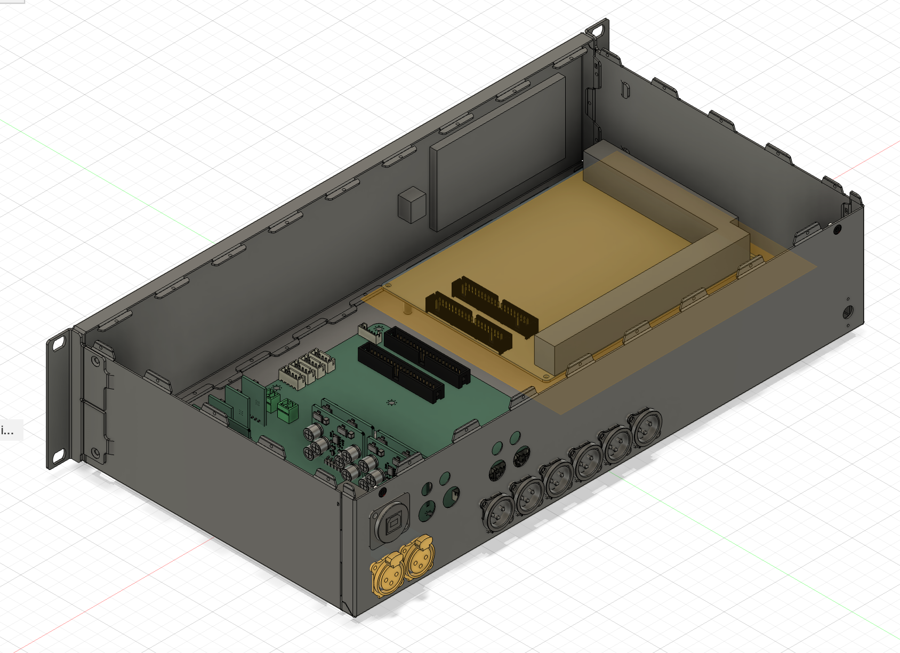
Documentation/Module Design Document/images/rearviewcase.png
