HeinVerhallen/Audio-DSP/Documentation/Module Design Document/images/topviewcase.png

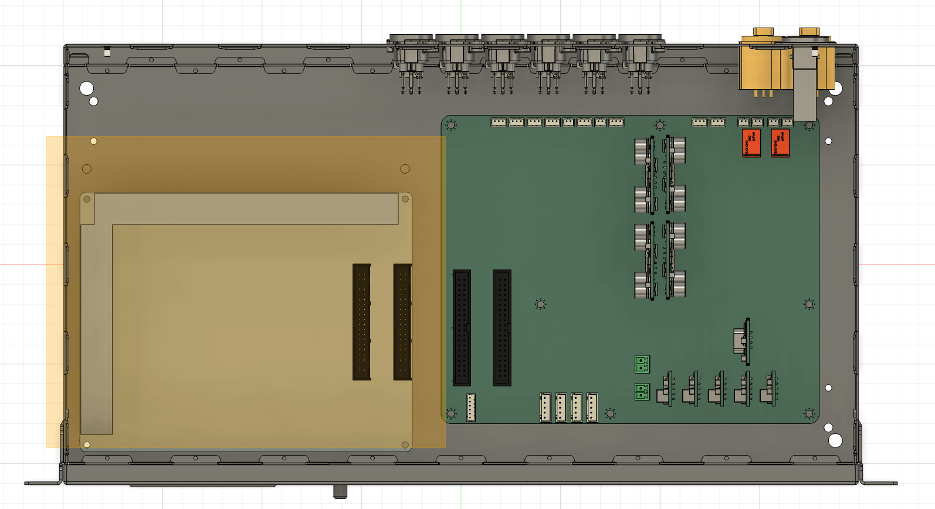
Documentation/Module Design Document/images/topviewcase.png
