HeinVerhallen/Audio-DSP/Documentation/Module Design Document/images/UI controller block diagram.jpg

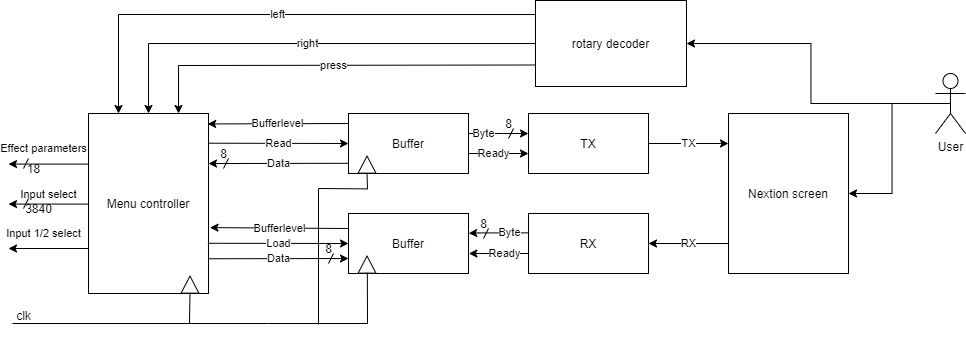
Documentation/Module Design Document/images/UI controller block diagram.jpg
