HeinVerhallen/Audio-DSP/Firmware/Audio_sampler/Compilation_report_audio-dsp_twoBPF1kHz.png

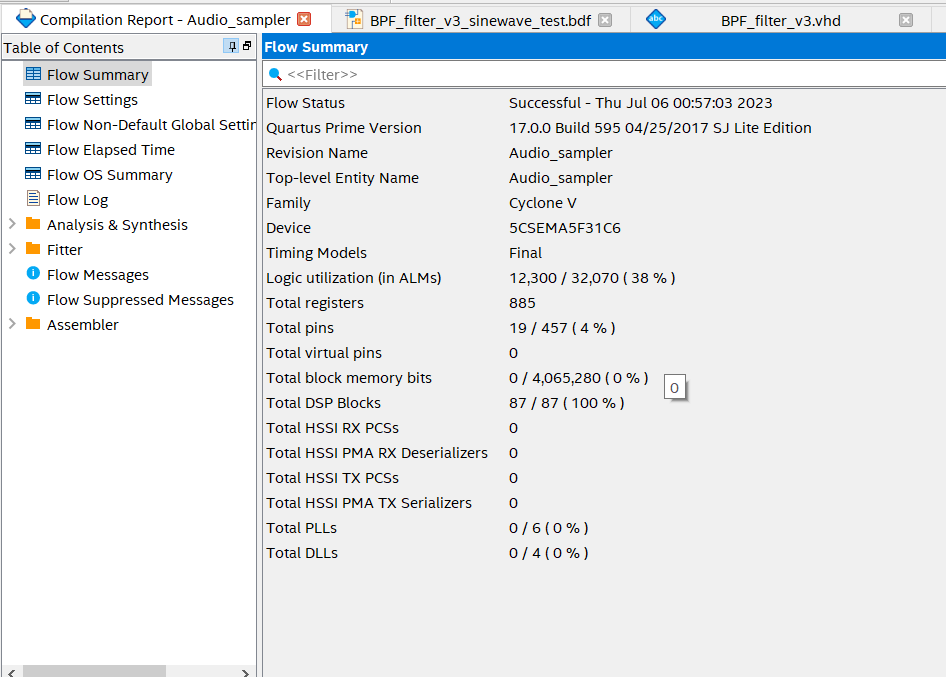
Firmware/Audio_sampler/Compilation_report_audio-dsp_twoBPF1kHz.png
