HeinVerhallen/Audio-DSP/Firmware/DASstudent2021/Compilation report 50ms delay at 84kHz.png

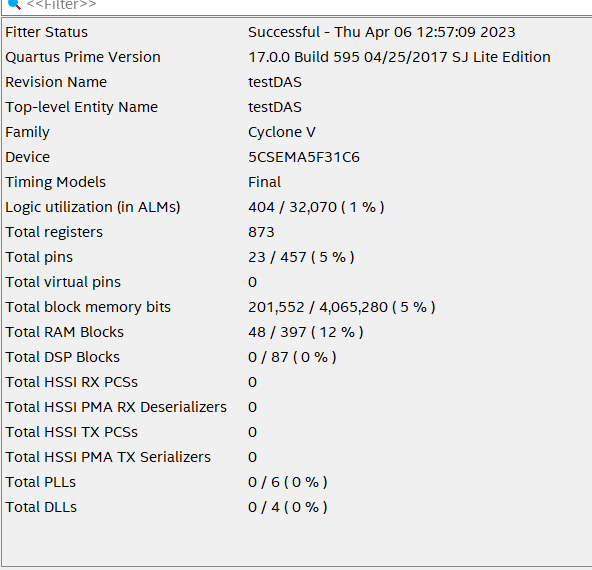
Firmware/DASstudent2021/Compilation report 50ms delay at 84kHz.png
