HeinVerhallen/Audio-DSP/Firmware/Uart protocol/design files/RX state machine.png

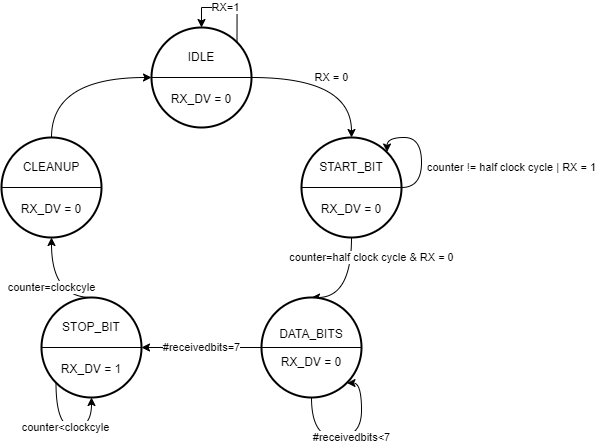
Firmware/Uart protocol/design files/RX state machine.png
