HeinVerhallen/Audio-DSP/Firmware/Uart protocol/design files/TX state machine.png

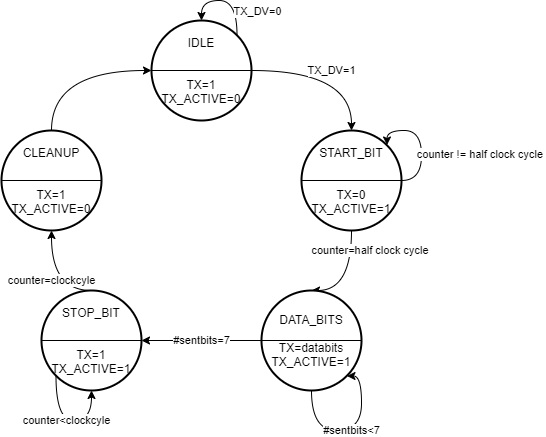
Firmware/Uart protocol/design files/TX state machine.png
