HeinVerhallen/Audio-DSP/UI/link symbol.png

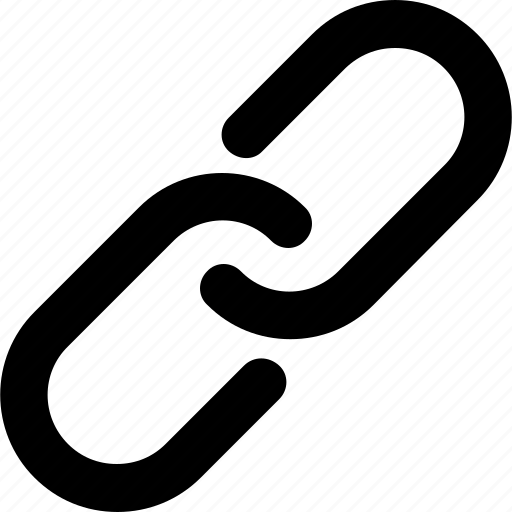
UI/link symbol.png
