HeinVerhallen/Audio-DSP/UI/Photoshop/DSP/JPG/adjustpreset_adjust_delete.jpg

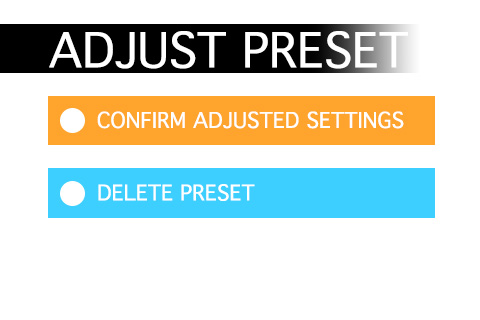
UI/Photoshop/DSP/JPG/adjustpreset_adjust_delete.jpg
