HeinVerhallen/Audio-DSP/UI/Photoshop/DSP/JPG/adjustpresetNIEUW.jpg

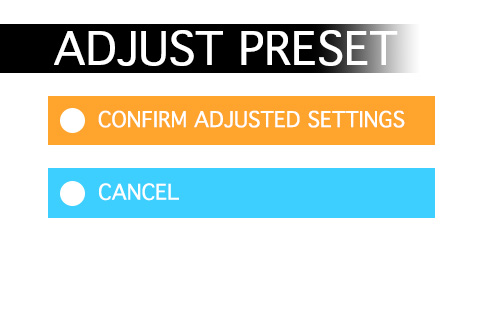
UI/Photoshop/DSP/JPG/adjustpresetNIEUW.jpg
