HeinVerhallen/Audio-DSP/UI/Photoshop/DSP/JPG/channel1-2_2-2.jpg

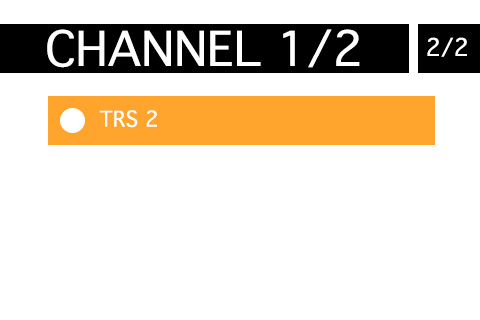
UI/Photoshop/DSP/JPG/channel1-2_2-2.jpg
