HeinVerhallen/Audio-DSP/UI/Photoshop/DSP/JPG/channel3-4.jpg

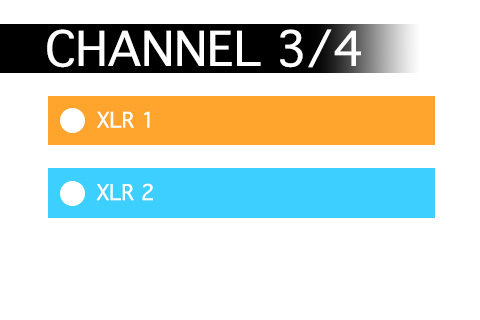
UI/Photoshop/DSP/JPG/channel3-4.jpg
