HeinVerhallen/Audio-DSP/UI/Photoshop/DSP/JPG/createpresetdesiredsettings.jpg

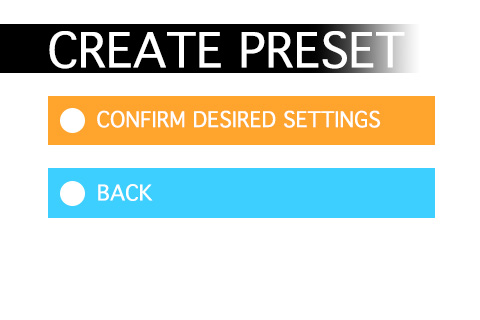
UI/Photoshop/DSP/JPG/createpresetdesiredsettings.jpg
