HeinVerhallen/Audio-DSP/UI/Photoshop/DSP/JPG/delaymenu.jpg

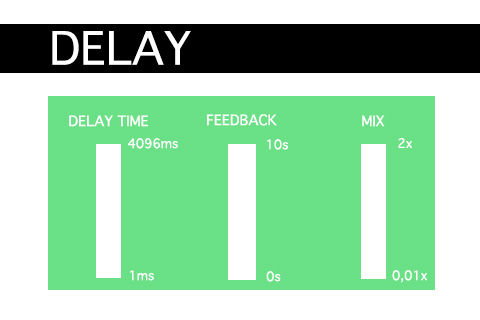
UI/Photoshop/DSP/JPG/delaymenu.jpg
