HeinVerhallen/Audio-DSP/UI/Photoshop/DSP/JPG/effects2-2.jpg

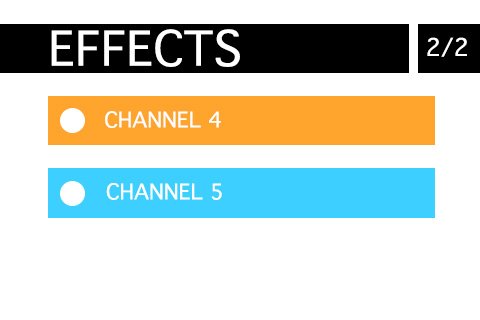
UI/Photoshop/DSP/JPG/effects2-2.jpg
