HeinVerhallen/Audio-DSP/UI/Photoshop/DSP/JPG/effectsmenu2_2.jpg

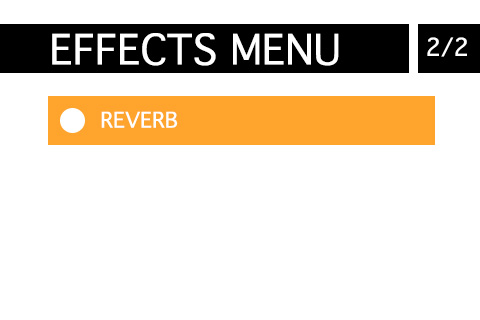
UI/Photoshop/DSP/JPG/effectsmenu2_2.jpg
