HeinVerhallen/Audio-DSP/UI/Photoshop/DSP/JPG/equalizermenuGOED1.jpg

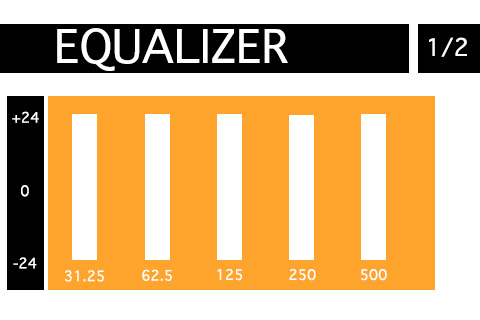
UI/Photoshop/DSP/JPG/equalizermenuGOED1.jpg
