HeinVerhallen/Audio-DSP/UI/Photoshop/DSP/JPG/equalizermenuGOED2.jpg

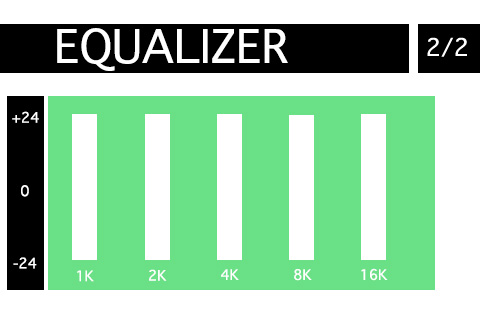
UI/Photoshop/DSP/JPG/equalizermenuGOED2.jpg
