HeinVerhallen/Audio-DSP/UI/Photoshop/DSP/JPG/equalizermenuNIEUW.jpg

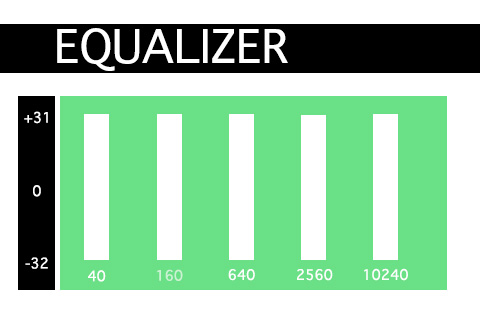
UI/Photoshop/DSP/JPG/equalizermenuNIEUW.jpg
