HeinVerhallen/Audio-DSP/UI/Photoshop/DSP/JPG/firstchannel2-2.jpg

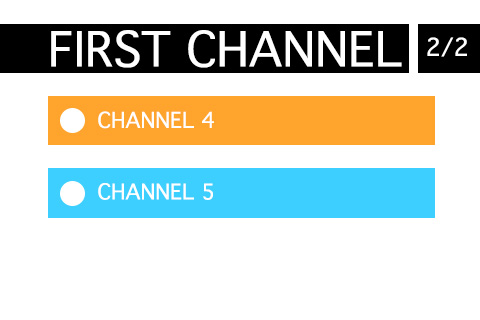
UI/Photoshop/DSP/JPG/firstchannel2-2.jpg
