HeinVerhallen/Audio-DSP/UI/Photoshop/DSP/JPG/gain_menu.jpg

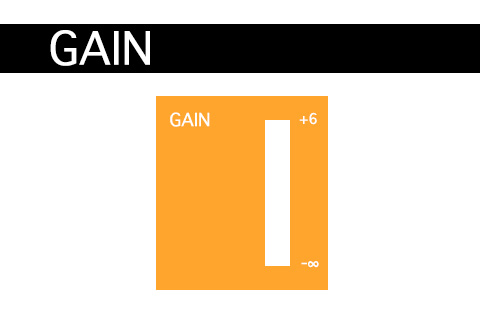
UI/Photoshop/DSP/JPG/gain_menu.jpg
