HeinVerhallen/Audio-DSP/UI/Photoshop/DSP/JPG/gain_TRS.jpg

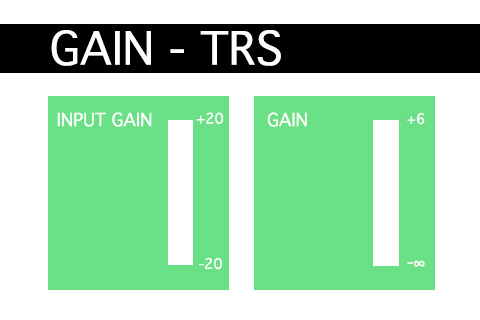
UI/Photoshop/DSP/JPG/gain_TRS.jpg
