HeinVerhallen/Audio-DSP/UI/Photoshop/DSP/JPG/inputselect1-2.jpg

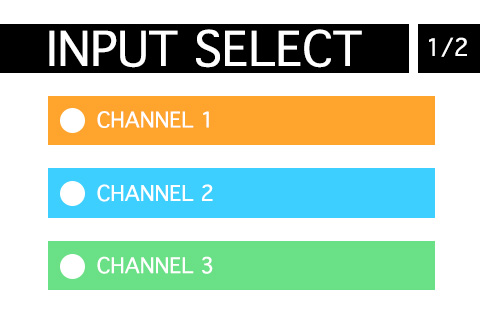
UI/Photoshop/DSP/JPG/inputselect1-2.jpg
