HeinVerhallen/Audio-DSP/UI/Photoshop/DSP/JPG/loadpreset1-2.jpg

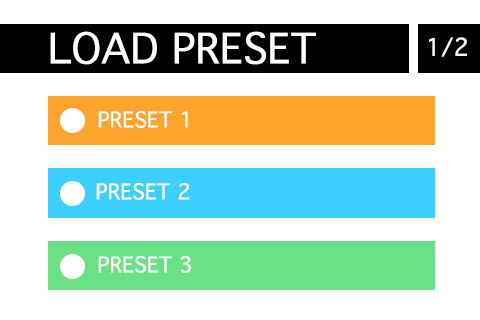
UI/Photoshop/DSP/JPG/loadpreset1-2.jpg
