HeinVerhallen/Audio-DSP/UI/Photoshop/DSP/JPG/loadpresetconfirm.jpg

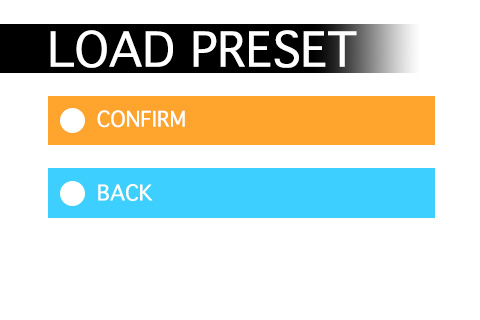
UI/Photoshop/DSP/JPG/loadpresetconfirm.jpg
