HeinVerhallen/Audio-DSP/UI/Photoshop/DSP/JPG/presetmenu.jpg

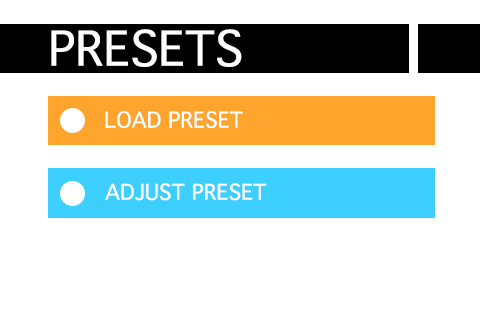
UI/Photoshop/DSP/JPG/presetmenu.jpg
