HeinVerhallen/Audio-DSP/UI/Photoshop/DSP/JPG/presets.jpg

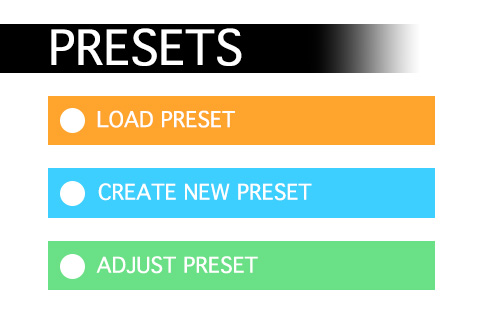
UI/Photoshop/DSP/JPG/presets.jpg
