HeinVerhallen/Audio-DSP/UI/Photoshop/DSP/JPG/reverb_menu.jpg

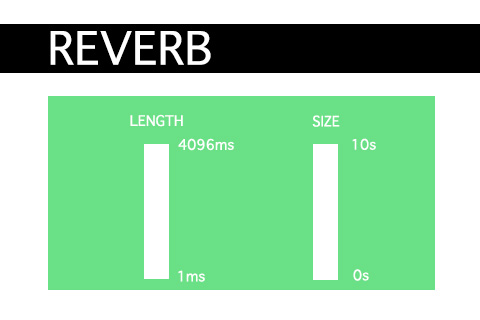
UI/Photoshop/DSP/JPG/reverb_menu.jpg
