HeinVerhallen/Audio-DSP/UI/Photoshop/DSP/JPG/secondchannel1-2.jpg

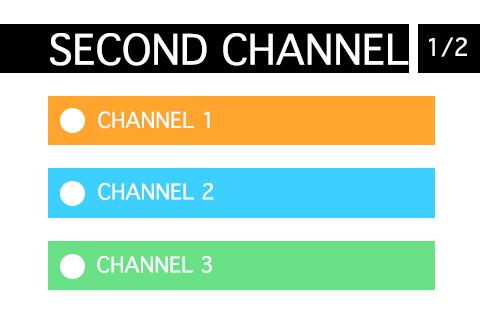
UI/Photoshop/DSP/JPG/secondchannel1-2.jpg
