HeinVerhallen/Audio-DSP/UI/Photoshop/DSP/JPG/secondchannel2_2.jpg

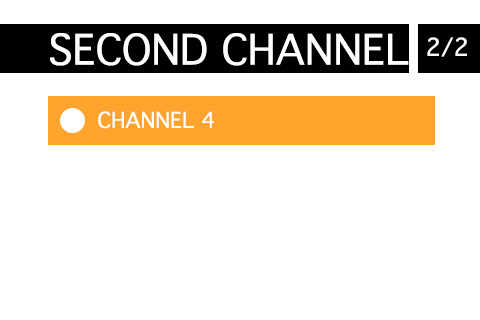
UI/Photoshop/DSP/JPG/secondchannel2_2.jpg
