HeinVerhallen/Audio-DSP/UI/Photoshop/DSP/JPG/secondchannel2_2NIEUW.jpg

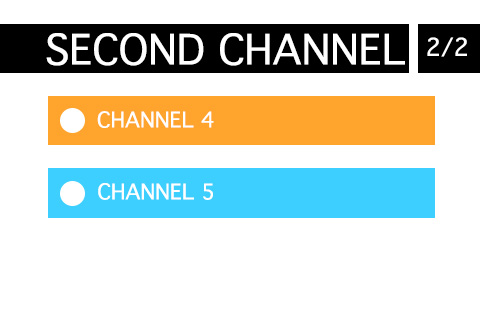
UI/Photoshop/DSP/JPG/secondchannel2_2NIEUW.jpg
