HeinVerhallen/Audio-DSP/UI/Photoshop/DSP/JPG/Signalroutingmenu1.jpg

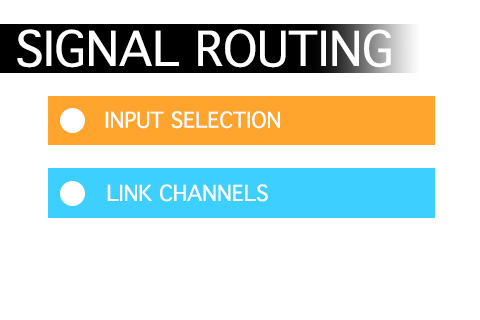
UI/Photoshop/DSP/JPG/Signalroutingmenu1.jpg
