HeinVerhallen/Audio-DSP/KiCAD/Main board/Order forms main board remaining components/Order form 14-06-2023 components main board1.xlsm

Suppliers | Projecten |  | docent
nl.rs-online.com | EXPO | Only use integers!
nl.farnell.com | PROJ2
conrad.nl | SIM |  | FOR 05-01: Aanvraag tot bestelling (V2.51)
tinytronics.nl | S6 minor wrist
leds-buy.nl | EDT
reprapworld.nl
Gegevens |  |  |  | Niet regulier
Datum (*) |  | 11-04-2023 |  | Bedrijfsnaam
Inkoop nummer |  | 043800-11539-101 |  | Naam contact
Type artikel (*) |  | Materiele inkoop | ? | Telefoon
 |  |  |  | Email
Aanvrager info |  |  |  | Adres
Voorletters (*) |  | R.J.A.W. |  | Postcode, stad
Achternaam (*) |  | van den Dungen |  | Land
 |  |  |  | Offertenummer
Kostenplaats (*) |  | 043800 - Elektrotechniek | ? (https://edu.nl/4ja64)
 |  |  |  | Ontvanger info
Deelproject nummer (*) |  | 11539-101 | ? (https://edu.nl/4ja64) | Bestelling te leveren aan | Robin van den Dungen | ?
Ruimte voor opmerkingen |  | BeCreative project Audio DSP (BC1).
 |  |  |  | PCN (*) | 458619
 |  |  |  | E-mail (*) | 458619@student.fontys.nl
Investering |  |  |  | Telefoon | +31 6 46858842
Kapitaal investering |  |  | ? | Gewenste afleverlocatie | Nexus | ?
Velden met een (*) zijn verplicht
Item | Leverancier | Artikel code | Hoeveelheid | Omschrijving (geen links) | Item prijs (excl.BTW) | Totale prijs
1 | nl.mouser.com | 81-GRM155R71H104KE4D | 100 | 100nF, X7R, 0402 | €0.01 | €0.80
2 | nl.mouser.com | 710-860010472003 | 53 | 22uF, Elec, D5 P2 | €0.08 | €4.24
3 | nl.mouser.com | 81-GRM215C1H472JA01D | 4 | 4,7nF, C0G, 0805 | €0.17 | €0.68
4 | nl.mouser.com | 81-GRM2165C2A152JA1D | 10 | 1,5nF, C0G, 0805 | €0.04 | €0.42
5 | nl.mouser.com | 710-885012007039 | 15 | 680pF, C0G, 0805 | €0.07 | €1.05
6 | nl.mouser.com | 187-CL21C222JBFNNNG | 10 | 2,2nF, C0G, 0805 | €0.08 | €0.79
7 | nl.mouser.com | 80-C0805C102J5G | 11 | 1nF, C0G, 0805 | €0.07 | €0.79
8 | nl.mouser.com | 81-GCM2165C2A272JA6J | 10 | 2,7nF, C0G, 0805 | €0.09 | €0.86
9 | nl.mouser.com | 81-GRM155Z71A105KE1D | 10 | 1uF, X7R, 0805 | €0.04 | €0.37
10 | nl.mouser.com | 81-GRM215C1H332JA01J | 10 | 3,3nF, C0G, 0805 | €0.09 | €0.93
11 | nl.mouser.com | 187-CL32B106KBJNNNE | 4 | 10uF, X7R, 1210 | €0.51 | €2.03
12 | nl.mouser.com | 81-GRM1555C1H470JA1D | 10 | 47pF, C0G, 0402 | €0.02 | €0.19
13 | nl.mouser.com | 833-1N4148WX-TP | 12 | 1N4148, SOD-323 | €0.09 | €1.02
14 | nl.mouser.com | 504-STS321050B100 | 3 | TVS 5V, SOD-323 | €0.36 | €1.07
15 | nl.mouser.com | 750-CPDT-12V | 3 | TVS 12V, SOT23 | €0.38 | €1.13
16 | tinytronics.nl | 004214 | 8 | JST PH-3 con | €0.10 | €0.80
17 | tinytronics.nl | 000617 | 8 | JST PH-3 cable | €1.24 | €9.92
18 | tinytronics.nl | 004212 | 6 | JST PH-2 con | €0.08 | €0.48
19 | tinytronics.nl | 001657 | 6 | JST PH-2 cable | €0.33 | €1.98
20 | tinytronics.nl | 004176 | 2 | Phoe 3.81mm-2 PCB | €0.33 | €0.66
21 | tinytronics.nl | 004204 | 2 | Phoe 3.81mm-2 Term | €0.54 | €1.08
22 | tinytronics.nl | 000529 | 1 | 5,5mm jack 90deg | €0.41 | €0.41
23 | nl.farnell.com | 9492453 | 1 | JST PH-6 con | €0.17 | €0.17
24 | tinytronics.nl | 003164 | 1 | JST PH-6 to UI cable | €1.65 | €1.65
25 | tinytronics.nl | 002020 | 5 | JST XH-5 con+cable | €0.74 | €3.70
26 | tinytronics.nl | 000099 | 1 | VU-LEDs | €1.65 | €1.65
27 | nl.mouser.com | 80-EA2-12NU | 2 | Relays | €2.49 | €4.98
28 | nl.mouser.com | 771-BC847C-T/R | 3 | BC847 | €0.13 | €0.40
29 | nl.mouser.com | 833-BC857B-TP | 1 | BC857 | €0.17 | €0.17
30 | nl.mouser.com | 791-RMC1/10-100JTP | 40 | 10R, 0805 | €0.02 | €0.84
31 | nl.mouser.com | 603-RC0805JR-074R7L | 10 | 4,7R, 0805 | €0.03 | €0.34
32 | nl.mouser.com | 667-ERA-6AED103V | 5 | 10kR, ERA, 0805 (4 ERA, 20std) | €0.15 | €0.77
33 | nl.mouser.com | 667-ERA-6ARW102V | 25 | 1kR, ERA, 0805 (24 ERA, 17std) | €0.62 | €15.40
34 | nl.mouser.com | 667-ERA-6AEB472V | 14 | 4,7kR, ERA, 0805 | €0.23 | €3.16
35 | nl.mouser.com | 667-ERA-6AEB821V | 5 | 820, ERA, 0805 | €0.35 | €1.74
36 | nl.mouser.com | 667-ERA-6ARB432V | 5 | 4,3k, ERA, 0805 | €0.66 | €3.29
37 | nl.mouser.com | 667-ERA-6AHD220V | 3 | 22R, ERA, 0805 | €0.40 | €1.19
38 | nl.mouser.com | 667-ERA-6AHD390V | 21 | 39R, ERA, 0805 | €0.17 | €3.55
39 | nl.mouser.com | 667-ERA-6AED272V | 10 | 2,7kR, ERA, 0805 | €0.17 | €1.69
40 | nl.mouser.com | 667-ERA-6AEB473V | 10 | 47kR, ERA, 0805 | €0.15 | €1.49
 |  |  |  |  | Totaal excl. BTW | €77.87
 |  |  |  |  | Totaal incl. BTW. | €94.23
 |  | Budgethouder:
?
 |  | 2e ondertekenaar:
