HeinVerhallen/Audio-DSP/KiCAD/Discrete_linear_regulator/Discrete_linear_regulator.csv

Source: | C:\Users\mgurl\Documents\GitHub\Audio-DSP\KiCAD\Discrete_linear_regulator\Discrete_linear_regulator.kicad_sch
Date: | 25/05/2023 12:39:21
Tool: | Eeschema 7.0.1
Generator: | C:\Program Files\KiCad\7.0\bin\scripting\plugins/bom_csv_grouped_by_value.py
Component Count: | 40
Collated Components:
Item | Qty | Reference(s) | Value | LibPart | Footprint | Datasheet | DNP | Datasheet2
1 | 2 | C1, C3 | 100nF | Device:C | Capacitor_SMD:C_0402_1005Metric | https://nl.mouser.com/ProductDetail/Murata-Electronics/GRM155R71H104KE14D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
2 | 2 | C2, C15 | 100p | Device:C | Capacitor_SMD:C_0402_1005Metric | https://nl.mouser.com/ProductDetail/KEMET/CBR04C101J5GACAUTO?qs=By6Nw2ByBD2z15b9CQ8m6A%3D%3D
3 | 2 | C4, C14 | 100n | Device:C | Capacitor_SMD:C_0402_1005Metric | https://nl.mouser.com/ProductDetail/Murata-Electronics/GRM155R71H104KE14D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
4 | 6 | C5, C6, C10, C11, C12, C16 | 100u | Device:C_Polarized | Capacitor_THT:CP_Radial_D8.0mm_P3.50mm | https://nl.mouser.com/ProductDetail/Rubycon/25ML100MEFC8X7?qs=T3oQrply3y%252BTg1YES5rCUw%3D%3D
5 | 2 | C9, C13 | 10u | Device:C | Capacitor_SMD:C_1210_3225Metric | https://nl.mouser.com/ProductDetail/Samsung-Electro-Mechanics/CL32B106KBJNNNE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
6 | 2 | D1, D3 | LED | Device:LED | LED_SMD:LED_0805_2012Metric | https://nl.mouser.com/ProductDetail/Broadcom-Avago/HSMH-C170?qs=YDL0qNrpDT6b21G9HrN9ig%3D%3D
7 | 1 | J1 | Conn_01x06 | Connector_Generic:Conn_01x06 | Connector_PinHeader_2.54mm:PinHeader_1x06_P2.54mm_Horizontal | ~
8 | 2 | Q1, Q4 | PZT2222AT3G | Audio_DSP:PZT2222AT3G | Package_TO_SOT_SMD:SOT-223 | https://nl.farnell.com/on-semiconductor/pzt2222at3g/transistor-bipol-npn-40v-sot-223/dp/2533342?st=pzt2222a
9 | 4 | Q2, Q3, Q10, Q11 | BC857 | Transistor_BJT:BC857 | Package_TO_SOT_SMD:SOT-23 | https://www.onsemi.com/pub/Collateral/BC860-D.pdf
10 | 2 | Q5, Q8 | PZT2907AT3G | Audio_DSP:PZT2907AT3G | Package_TO_SOT_SMD:SOT-223 | https://nl.farnell.com/on-semiconductor/pzt2907at3g/transistor-bipol-pnp-60v-sot-223/dp/2533343?st=pzt2907a
11 | 2 | R1, R12 | 820R | Device:R | Resistor_SMD:R_0402_1005Metric | https://nl.mouser.com/ProductDetail/YAGEO/RT0402FRE07820RL?qs=iFuT%252BolKbR7tOecAWZmkmw%3D%3D
12 | 2 | R2, R11 | 10k | Device:R | Resistor_SMD:R_0402_1005Metric | https://nl.mouser.com/ProductDetail/Vishay-Dale/CRCW040210K0FKEDC?qs=E3Y5ESvWgWPiNLcGzwCGPg%3D%3D
13 | 2 | R3, R10 | 47R | Device:R | Resistor_SMD:R_0402_1005Metric | https://nl.mouser.com/ProductDetail/YAGEO/RT0402FRE0747RL
14 | 2 | R4, R8 | 100R | Device:R | Resistor_SMD:R_0402_1005Metric | https://nl.mouser.com/ProductDetail/YAGEO/RT0402FRE07100RL
15 | 2 | R5, R9 | 100k | Device:R | Resistor_SMD:R_0402_1005Metric | https://nl.mouser.com/ProductDetail/Vishay-Dale/CRCW0402100KFKEDC?qs=E3Y5ESvWgWPiKlL6PvtQMQ%3D%3D
16 | 2 | R6, R13 | 6K8 | Device:R | Resistor_SMD:R_0402_1005Metric | https://nl.mouser.com/ProductDetail/Susumu/RG1005P-682-D-T10?qs=v5GkGT6DDHhLDDYpYvRXHQ%3D%3D |  | https://nl.mouser.com/ProductDetail/Susumu/RG1005P-272-D-T10?qs=y7y%2FNpWpM9kYXyOrAmBBBw%3D%3D
17 | 2 | R7, R14 | 1K2 | Device:R | Resistor_SMD:R_0402_1005Metric | https://nl.mouser.com/ProductDetail/Susumu/RR0510P-122-D?qs=nCAm%252BcMdy9x80DxeUz5E6w%3D%3D |  | https://nl.mouser.com/ProductDetail/Susumu/RG1005P-272-D-T10?qs=y7y%2FNpWpM9kYXyOrAmBBBw%3D%3D
18 | 1 | U1 | LM4562 | Audio_DSP:LM4562 | Package_SO:SOIC-8_3.9x4.9mm_P1.27mm | https://nl.farnell.com/texas-instruments/lm4562max-nopb/audio-amplifier-55mhz-20v-us-soic/dp/3004534?st=lm4562
