HeinVerhallen/Audio-DSP/KiCAD/Ordered from JLCPCB 27-06-2023/JLCPCB invoice.pdf

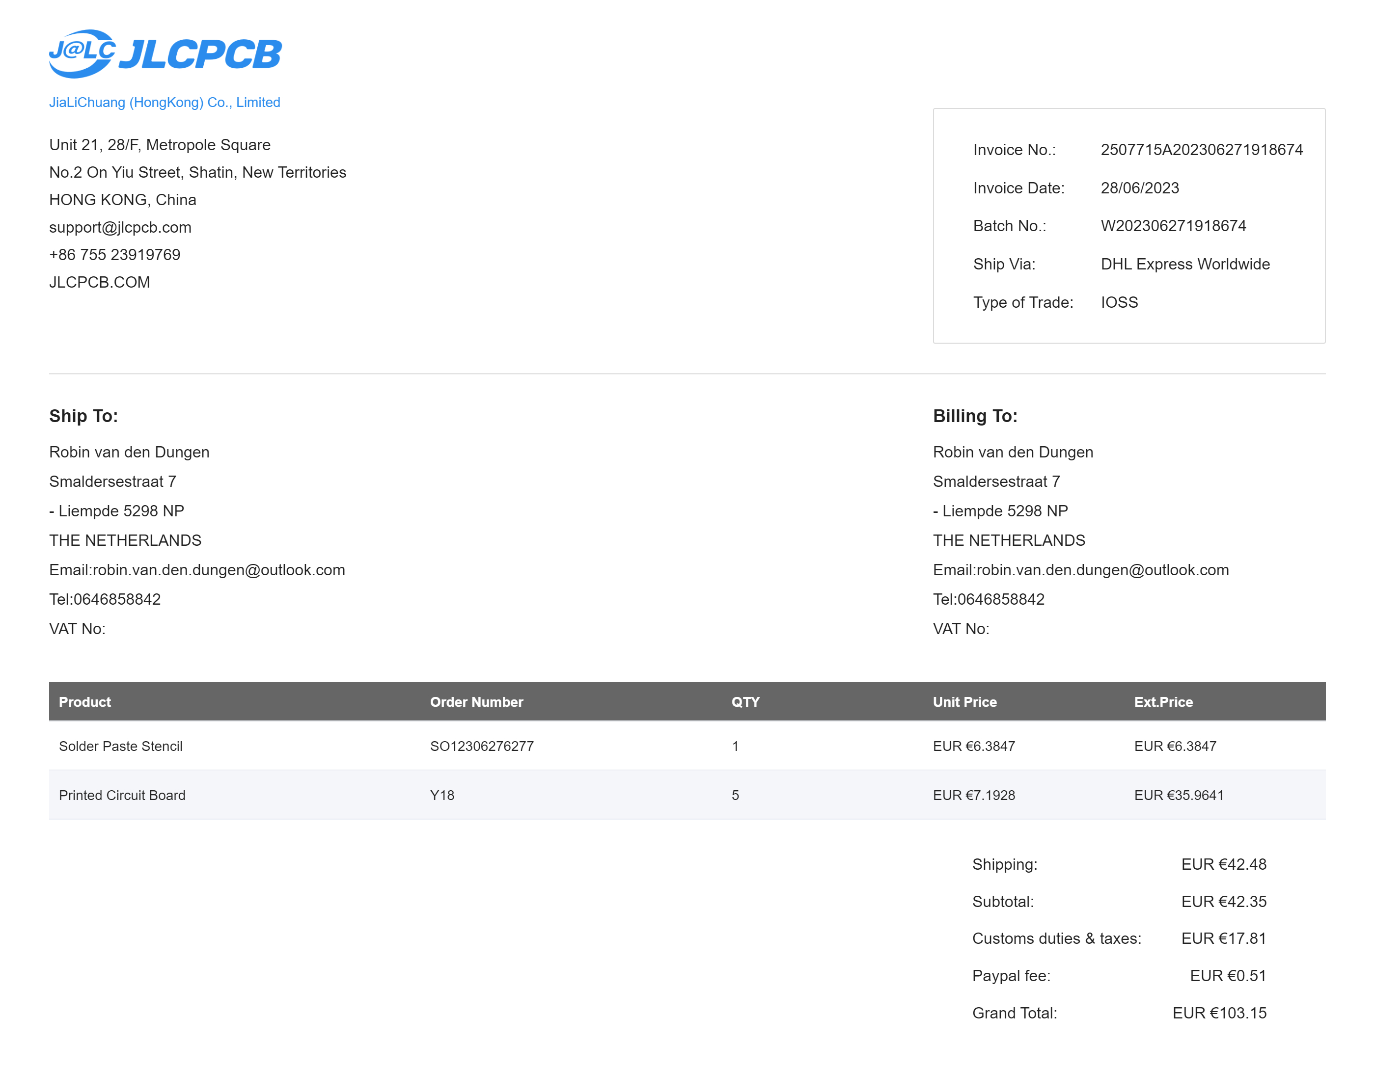
[picture p99: figure]
