HeinVerhallen/Audio-DSP/KiCAD/Ordered from JLCPCB 31-05-2023/JLCPCB invoice.pdf

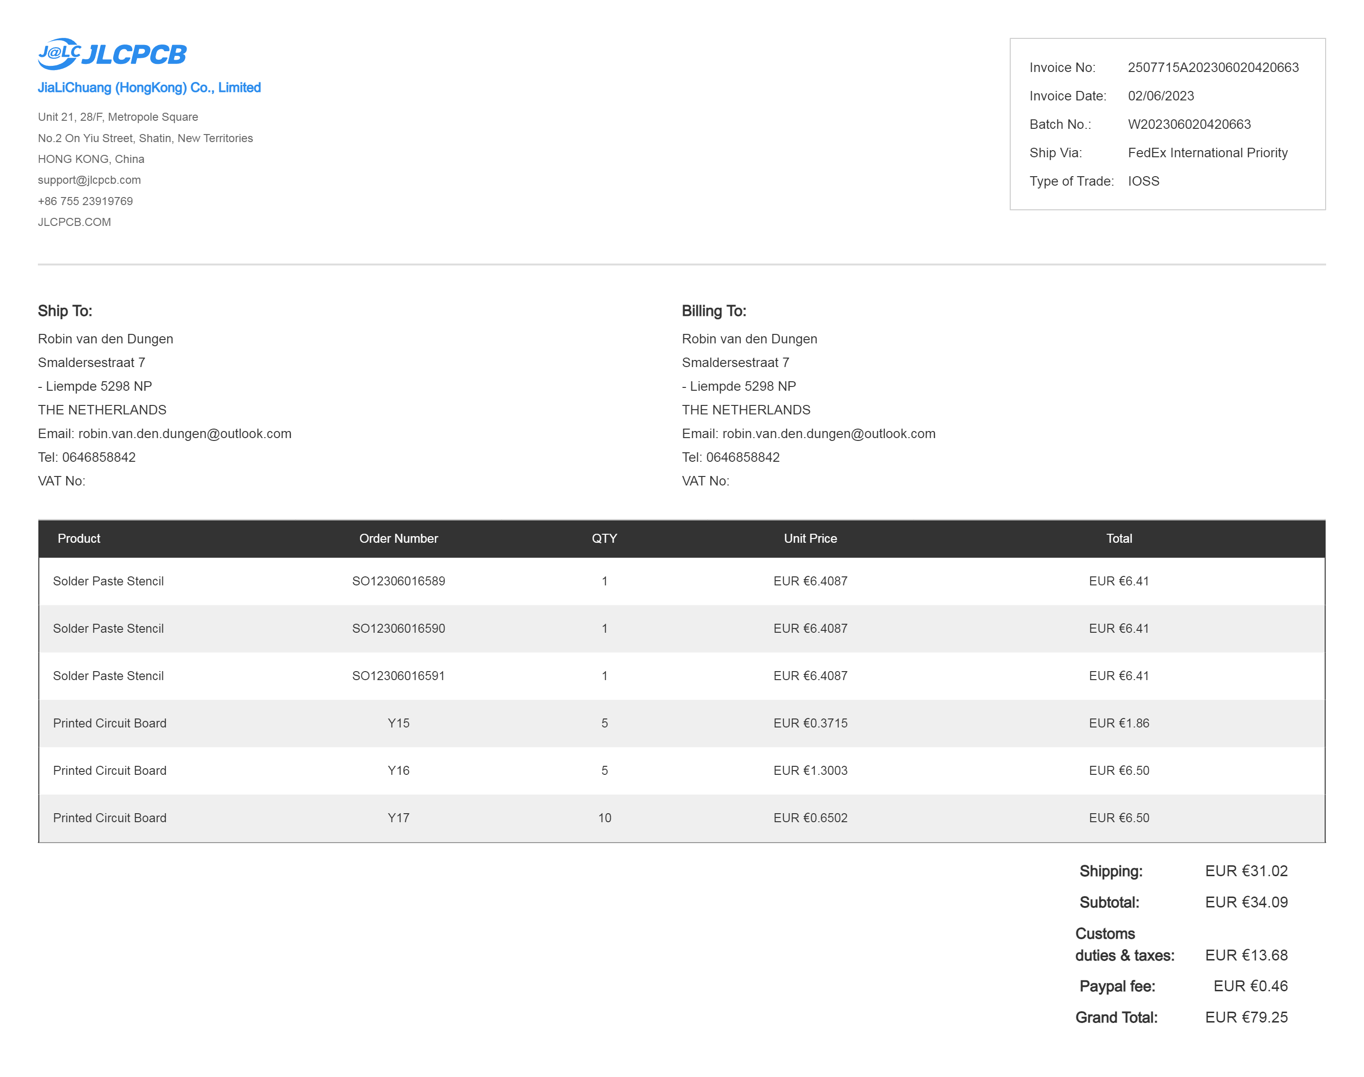
[picture p100: figure]
