HeinVerhallen/Audio-DSP/KiCAD/Ordered from JLCPCB 31-05-2023/Order form 31-05-2023 JLCPCB.xlsm

Suppliers | Projecten |  | docent
nl.rs-online.com | EXPO | Only use integers!
nl.farnell.com | PROJ2
conrad.nl | SIM |  | FOR 05-01: Aanvraag tot bestelling (V2.51)
tinytronics.nl | S6 minor wrist
leds-buy.nl | EDT
reprapworld.nl
Gegevens |  |  |  | Niet regulier
Datum (*) |  | 11-04-2023 |  | Bedrijfsnaam | JLCPCB
Inkoop nummer |  | 043800-11539-101 |  | Naam contact | Robin van den Dungen
Type artikel (*) |  | Materiele inkoop | ? | Telefoon | +31 6 46858842
 |  |  |  | Email | 458619@student.fontys.nl
Aanvrager info |  |  |  | Adres
Voorletters (*) |  | R.J.A.W. |  | Postcode, stad
Achternaam (*) |  | van den Dungen |  | Land | China
 |  |  |  | Offertenummer | 01919095JG172181V
Kostenplaats (*) |  | 043800 - Elektrotechniek | ? (https://edu.nl/4ja64)
 |  |  |  | Ontvanger info
Deelproject nummer (*) |  | 11539-101 | ? (https://edu.nl/4ja64) | Bestelling te leveren aan | Robin van den Dungen | ?
Ruimte voor opmerkingen |  | BeCreative project Audio DSP (BC1). JLCPCB
 |  |  |  | PCN (*) | 458619
 |  |  |  | E-mail (*) | 458619@student.fontys.nl
Investering |  |  |  | Telefoon | +31 6 46858842
Kapitaal investering |  |  | ? | Gewenste afleverlocatie | Nexus | ?
Velden met een (*) zijn verplicht
Item | Leverancier | Artikel code | Hoeveelheid | Omschrijving (geen links) | Item prijs (excl.BTW) | Totale prijs
1 | JLCPCB | PCBs+stencils Audio-DSP | 1 | Total PCB cost | €30.36 | €30.36
2 | JLCPCB | Shipping | 1 | Shipping cost | €39.28 | €39.28
3 |  |  |  |  |  | €0.00
4 |  |  |  |  |  | €0.00
5 |  |  |  |  |  | €0.00
6 |  |  |  |  |  | €0.00
7 |  |  |  |  |  | €0.00
8 |  |  |  |  |  | €0.00
9 |  |  |  |  |  | €0.00
10 |  |  |  |  |  | €0.00
11 |  |  |  |  |  | €0.00
12 |  |  |  |  |  | €0.00
13 |  |  |  |  |  | €0.00
14 |  |  |  |  |  | €0.00
15 |  |  |  |  |  | €0.00
16 |  |  |  |  |  | €0.00
17 |  |  |  |  |  | €0.00
18 |  |  |  |  |  | €0.00
19 |  |  |  |  |  | €0.00
20 |  |  |  |  |  | €0.00
21 |  |  |  |  |  | €0.00
22 |  |  |  |  |  | €0.00
23 |  |  |  |  |  | €0.00
24 |  |  |  |  |  | €0.00
25 |  |  |  |  |  | €0.00
26 |  |  |  |  |  | €0.00
27 |  |  |  |  |  | €0.00
28 |  |  |  |  |  | €0.00
29 |  |  |  |  |  | €0.00
30 |  |  |  |  |  | €0.00
31 |  |  |  |  |  | €0.00
32 |  |  |  |  |  | €0.00
33 |  |  |  |  |  | €0.00
34 |  |  |  |  |  | €0.00
35 |  |  |  |  |  | €0.00
36 |  |  |  |  |  | €0.00
37 |  |  |  |  |  | €0.00
38 |  |  |  |  |  | €0.00
39 |  |  |  |  |  | €0.00
40 |  |  |  |  |  | €0.00
 |  |  |  |  | Totaal excl. BTW | €69.64
 |  |  |  |  | Totaal incl. BTW. | €84.26
 |  | Budgethouder:
?
 |  | 2e ondertekenaar:
