HeinVerhallen/Audio-DSP/KiCAD/Main board/Order forms main board remaining components/Order form 14-06-2023 components main board2.xlsm

Suppliers | Projecten |  | docent
nl.rs-online.com | EXPO | Only use integers!
nl.farnell.com | PROJ2
conrad.nl | SIM |  | FOR 05-01: Aanvraag tot bestelling (V2.51)
tinytronics.nl | S6 minor wrist
leds-buy.nl | EDT
reprapworld.nl
Gegevens |  |  |  | Niet regulier
Datum (*) |  | 11-04-2023 |  | Bedrijfsnaam
Inkoop nummer |  | 043800-11539-101 |  | Naam contact
Type artikel (*) |  | Materiele inkoop | ? | Telefoon
 |  |  |  | Email
Aanvrager info |  |  |  | Adres
Voorletters (*) |  | R.J.A.W. |  | Postcode, stad
Achternaam (*) |  | van den Dungen |  | Land
 |  |  |  | Offertenummer
Kostenplaats (*) |  | 043800 - Elektrotechniek | ? (https://edu.nl/4ja64)
 |  |  |  | Ontvanger info
Deelproject nummer (*) |  | 11539-101 | ? (https://edu.nl/4ja64) | Bestelling te leveren aan | Robin van den Dungen | ?
Ruimte voor opmerkingen |  | BeCreative project Audio DSP (BC1).
 |  |  |  | PCN (*) | 458619
 |  |  |  | E-mail (*) | 458619@student.fontys.nl
Investering |  |  |  | Telefoon | +31 6 46858842
Kapitaal investering |  |  | ? | Gewenste afleverlocatie | Nexus | ?
Velden met een (*) zijn verplicht
Item | Leverancier | Artikel code | Hoeveelheid | Omschrijving (geen links) | Item prijs (excl.BTW) | Totale prijs
1 | nl.mouser.com | 667-ERA-6AEB221V | 10 | 220, ERA, 0805 | €0.15 | €1.49
2 | nl.mouser.com | 667-ERJ-6ENF2204V | 3 | 2,2M, ERJ, 0805 | €0.09 | €0.28
3 | nl.mouser.com | 594-MCU08050Z0000ZP5 | 10 | 0R, VIS, 0805 | €0.14 | €1.39
4 | nl.mouser.com | 652-CR0402-J/-000GLF | 12 | 0R, 0402 | €0.004 | €0.05
5 | nl.mouser.com | 667-ERA-6AED104V | 3 | 100k, ERA, 0805 | €0.43 | €1.30
6 | nl.mouser.com | 603-AC0805JR-07330RL | 17 | 330, 0805 | €0.02 | €0.41
7 | nl.mouser.com | 652-CR0805FX-2001ELF | 10 | 2k, 0805 | €0.03 | €0.27
8 | nl.mouser.com | 652-CR0805FX-3901ELF | 10 | 3,9k, 0805 | €0.03 | €0.29
9 | nl.mouser.com | 603-RC0805JR-0724KL | 10 | 24k, 0805 | €0.02 | €0.21
10 | nl.mouser.com | 667-ERA-6AEB271V | 10 | 270, ERA, 0805 | €0.18 | €1.80
11 | nl.mouser.com | 667-ERA-6AED154V | 10 | 150k, ERA, 0805 | €0.17 | €1.69
12 | nl.mouser.com | 667-EXB-28V220JX | 10 | RN 22R, 4x0402 | €0.04 | €0.41
13 | nl.mouser.com | 595-TL072CDRG4 | 5 | TL072, SO8 | €0.40 | €2.02
14 | nl.mouser.com | 595-LM339PWR | 4 | LM339, TSSOP14 | €0.37 | €1.47
15 | nl.mouser.com | 595-TXS0102DCUR | 1 | 2B level shifter | €0.90 | €0.90
16 | nl.mouser.com | 603-RC0805JR-101KL | 18 | 1k, 0805 (24 ERA, 17std) | €0.02 | €0.38
17 | nl.mouser.com | 603-AA0805FR-0710KL | 21 | 10k, 0805 (4 ERA, 20std) | €0.04 | €0.82
18 | nl.farnell.com | 3269809 | 3 | MAX17634C | €3.42 | €10.26
19 | tinytronics.nl | 000469 | 1 | Encoder | €0.62 | €0.62
20 | tinytronics.nl | 000124 | 1 | Encoder knob | €0.62 | €0.62
21 | tinytronics.nl | 001322 | 1 | 5,5/2,1 DC jack | €0.41 | €0.41
22 | nl.mouser.com | 187-CL32B106KBJNNNE | 10 | 10u, 1210 | €0.35 | €3.55
23 | nl.mouser.com | 81-GRM155Z71A225KE1D | 1 | 2,2u, 0402 | €0.17 | €0.17
24 | nl.mouser.com | 81-GCM155R71E333KA5D | 1 | 33n, 0402 | €0.09 | €0.09
25 | nl.farnell.com | 2289091 | 1 | 10uH | €3.84 | €3.84
26 | nl.mouser.com | 71-CRCW040222K0FKEDC | 2 | 22k, 0402 | €0.09 | €0.19
27 | nl.mouser.com | 71-CRCW0402270KFKEDC | 1 | 270k, 0402 | €0.09 | €0.09
28 | nl.mouser.com | 667-ERJ-2RKF2002X | 1 | 20k, 0402 | €0.09 | €0.09
29 | nl.mouser.com | 71-CRCW04023M30FKEDC | 1 | 3M3, 0402 | €0.09 | €0.09
30 | nl.mouser.com | 71-CRCW040210K0FKEDC | 1 | 10k, 0402 | €0.09 | €0.09
31 | nl.mouser.com | 71-CRCW0402220KFKEDC | 1 | 220k, 0402 | €0.09 | €0.09
32 |  |  |  |  |  | €0.00
33 |  |  |  |  |  | €0.00
34 |  |  |  |  |  | €0.00
35 |  |  |  |  |  | €0.00
36 |  |  |  |  |  | €0.00
37 |  |  |  |  |  | €0.00
38 |  |  |  |  |  | €0.00
39 |  |  |  |  |  | €0.00
40 |  |  |  |  |  | €0.00
 |  |  |  |  | Totaal excl. BTW | €35.39
 |  |  |  |  | Totaal incl. BTW. | €42.82
 |  | Budgethouder:
?
 |  | 2e ondertekenaar:
