HeinVerhallen/Audio-DSP/KiCAD/Generic_Buck_Converter/Generic_Buck_Converter.xlsx

Prj: | Generic_Buck_Converter.xml |  |  |  | Board Qty: | 100
Co.: |  |  |  |  | Unit Cost: | $0.00
Prj date: | 11/05/2023 11:53:13 |  |  |  | Total Cost: | $0.00
$ date: | 2023-06-14 15:09:15
Global Part Info
Refs | Value | Footprint | Manf# | Qty | Unit$ | Ext$
C1,C2,C4,C7-C11 | 10u | C_1210_3225Metric | https://nl.mouser.com/ProductDetail/Samsung-Electro-Mechanics/CL32B106KBJNNNE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 | 800
C3 | 2.2u | C_0402_1005Metric | https://eu.mouser.com/ProductDetail/Murata-Electronics/GRM155Z71A225KE01D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 | 100
C5 | 0.1u | C_0402_1005Metric | https://nl.mouser.com/ProductDetail/Murata-Electronics/GRM155R71H104KE14D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 | 100
C6 | 33n | C_0402_1005Metric | https://nl.mouser.com/ProductDetail/Murata-Electronics/GCM155R71E333KA55D?qs=pDxNbvYGEH41UMKAOj1GxA%3D%3D | 100
IC1 | MAX17634C | TQFN-20-1EP_4x4mm_P0.5mm_EP2.9x2.9mm_ThermalVias_(JLCPCB_Compatible) | https://nl.farnell.com/analog-devices/max17634catp/dc-dc-conv-sync-buck-2-2mhz-125deg/dp/3269809?st=max17634c | 100
J1 | Conn_01x05 | PinHeader_1x05_P2.54mm_Horizontal |  | 100
L1 | X | L_Coilcraft_XAL6060-XXX | https://nl.farnell.com/coilcraft/xal6060-472mec/inductor-4-7uh-11a-20-pwr-21mhz/dp/2289085?ost=2289085 | 100
R1,R2 | X | R_0402_1005Metric |  | 200
R3 | 20k | R_0402_1005Metric | https://nl.mouser.com/ProductDetail/Panasonic/ERJ-2RKF2002X?qs=H7k1u0Mp9JTOxRcN%252B6dzQw%3D%3D | 100
R4 | 3M3 | R_0402_1005Metric | https://nl.mouser.com/ProductDetail/Vishay-Dale/CRCW04023M30FKEDC?qs=E3Y5ESvWgWOo6fd7ydr7cw%3D%3D | 100
R5 | 10k | R_0402_1005Metric | https://nl.mouser.com/ProductDetail/Vishay-Dale/CRCW040210K0FKEDC?qs=E3Y5ESvWgWPiNLcGzwCGPg%3D%3D | 100
R6 | 220k | R_0402_1005Metric | https://nl.mouser.com/ProductDetail/Vishay-Dale/CRCW0402220KFKEDC?qs=E3Y5ESvWgWPROPxHdQlAsQ%3D%3D | 100
KiCost® v1.1.17
