HeinVerhallen/Audio-DSP/Firmware/Test_FPGA_routing/Compilation_Test_FPGA_routing_const_order.png

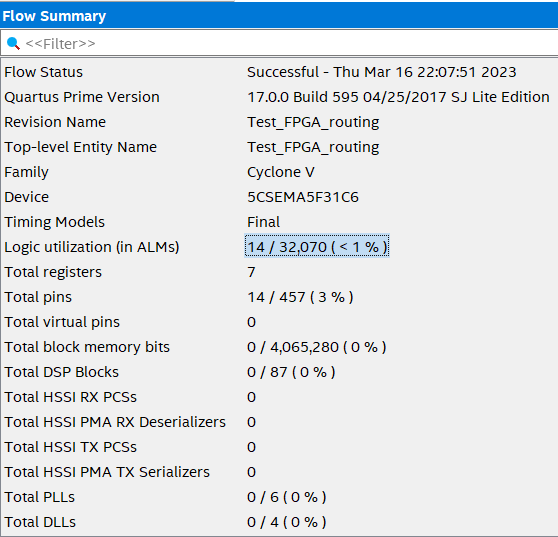
Firmware/Test_FPGA_routing/Compilation_Test_FPGA_routing_const_order.png
