HeinVerhallen/Audio-DSP/KiCAD/Main board/VU-meter-wiring.png

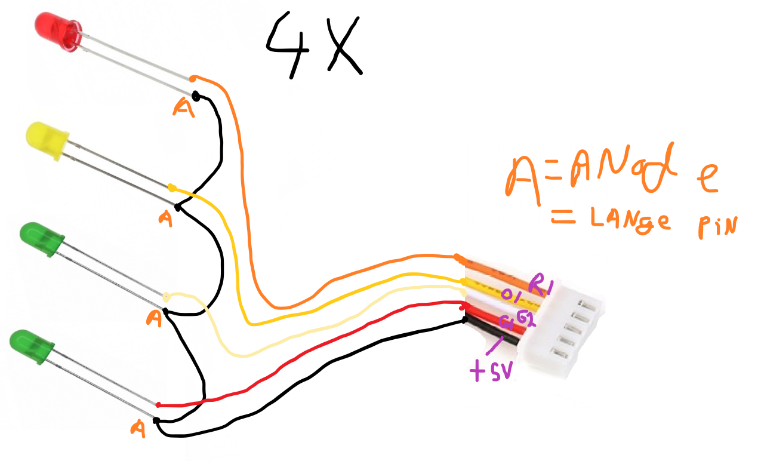
KiCAD/Main board/VU-meter-wiring.png
