HeinVerhallen/Audio-DSP/Documentation/Module Design Document/Appendix_simulation_results.tex

\chapter*{Appendix G: Simulation results of Firmware}
\addcontentsline{toc}{chapter}{Appendix G: Simulation results of Firmware}  
\label{chap:appendix-G-simulation-results}

\begin{figure}[!ht]
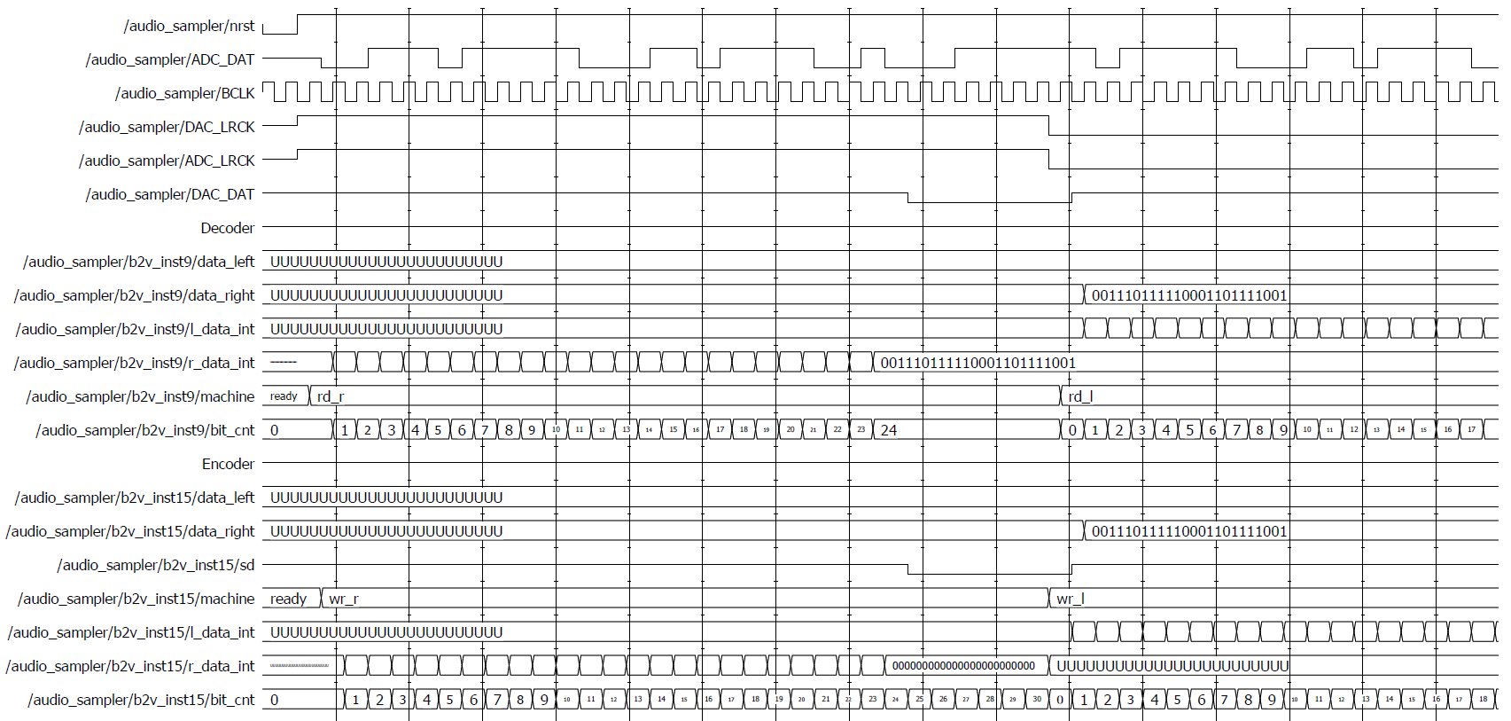
[picture p103: Documentation/Module Design Document/images/Audio_sampler_result.png]
    
    \caption{Simulation result of I2S decoder and encoder}
    \label{fig:sim_result_i2s_dec_enc}
\end{figure}

\begin{figure}[!ht]
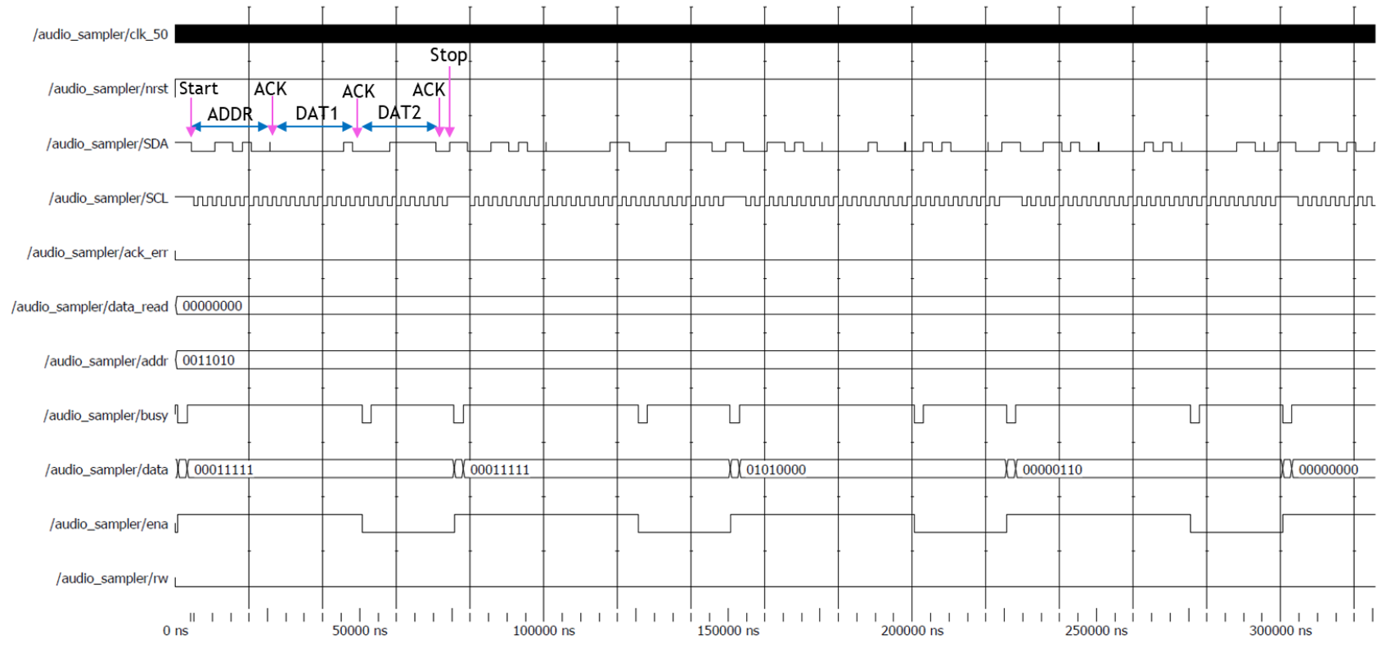
[picture p104: Documentation/Module Design Document/images/I2C_master_result.png]
    
    \caption{Simulation result of I2C master}
    \label{fig:sim_result_i2c-master}
\end{figure}

\begin{figure}[!ht]
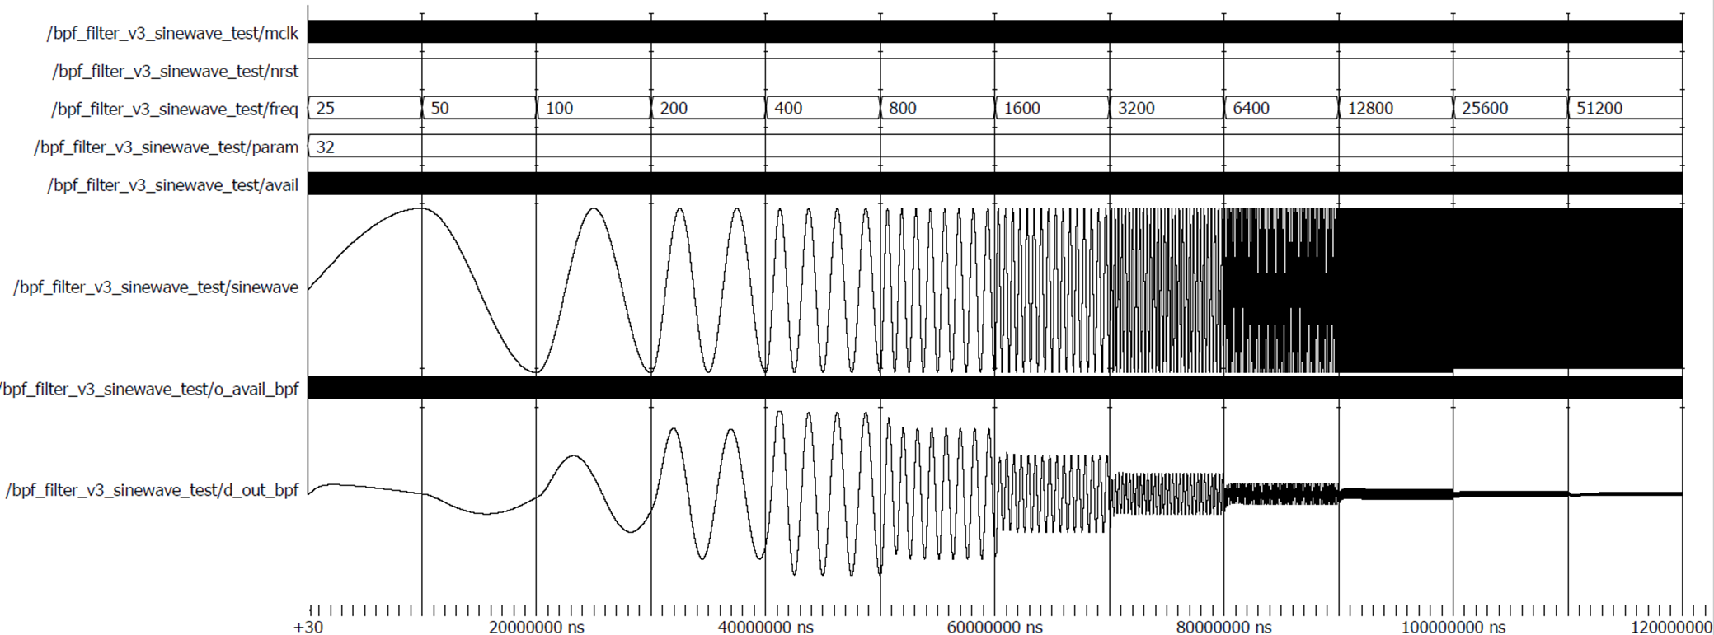
[picture p105: Documentation/Module Design Document/images/bpf_frequency_response_result.png]
    
    \caption{Simulation result of frequency response of state-space BPF}
    \label{fig:sim_result_bpf}
\end{figure}

\begin{figure}[!ht]
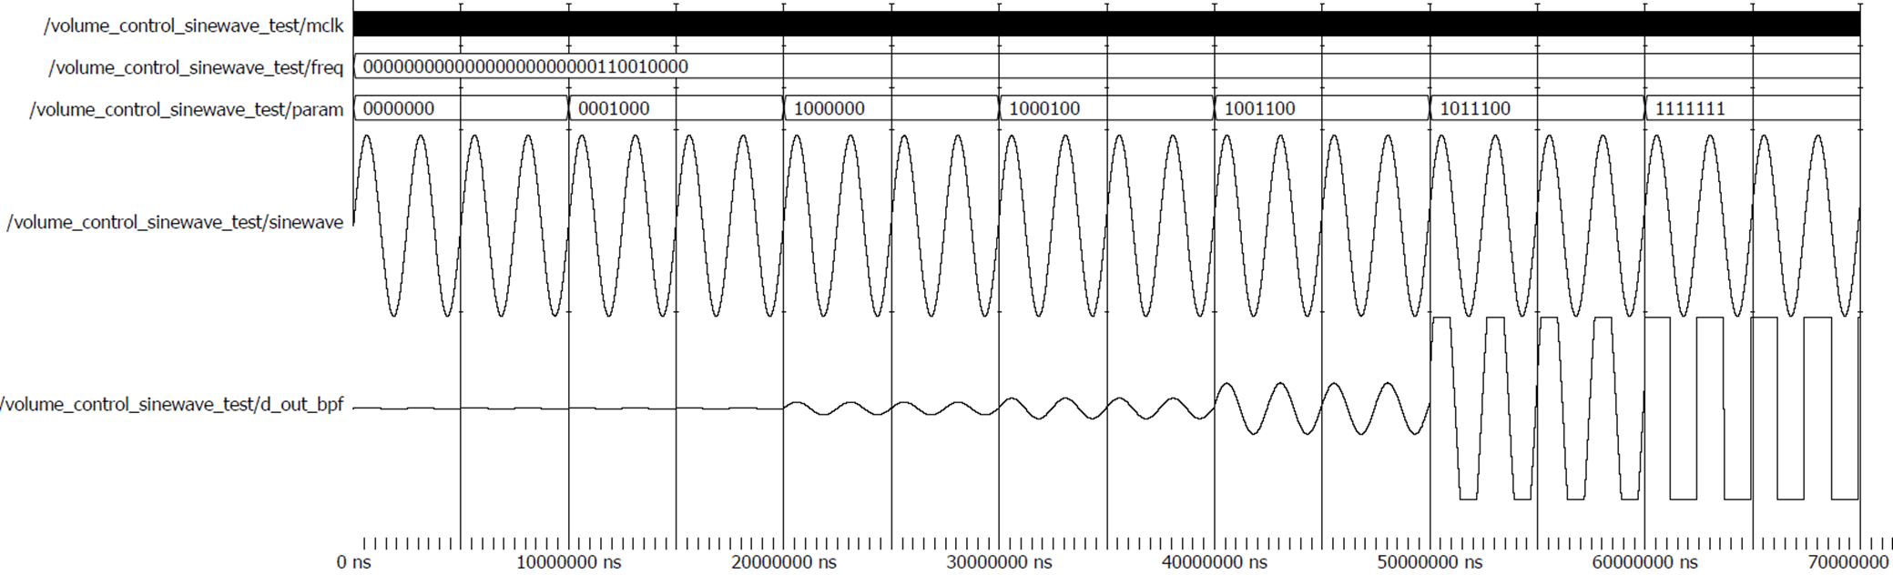
[picture p106: Documentation/Module Design Document/images/volume_control_result.png]
    
    \caption{Simulation result of volume control}
    \label{fig:sim_result_vol_ctrl}
\end{figure}
