HeinVerhallen/Audio-DSP/Hardware verification/Pictures of boards/Bare main board/WhatsApp Image 2023-07-03 at 19.37.03.jpeg

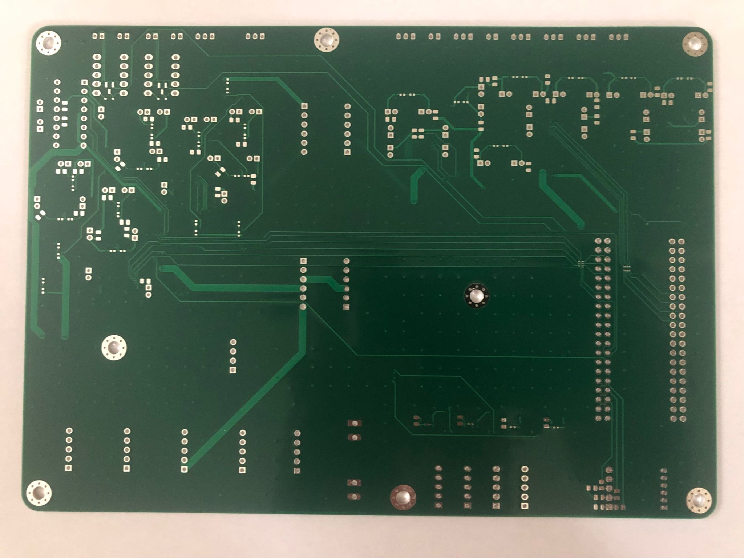
Hardware verification/Pictures of boards/Bare main board/WhatsApp Image 2023-07-03 at 19.37.03.jpeg
