HeinVerhallen/Audio-DSP/Hardware verification/Pictures of boards/Buck converters.jpeg

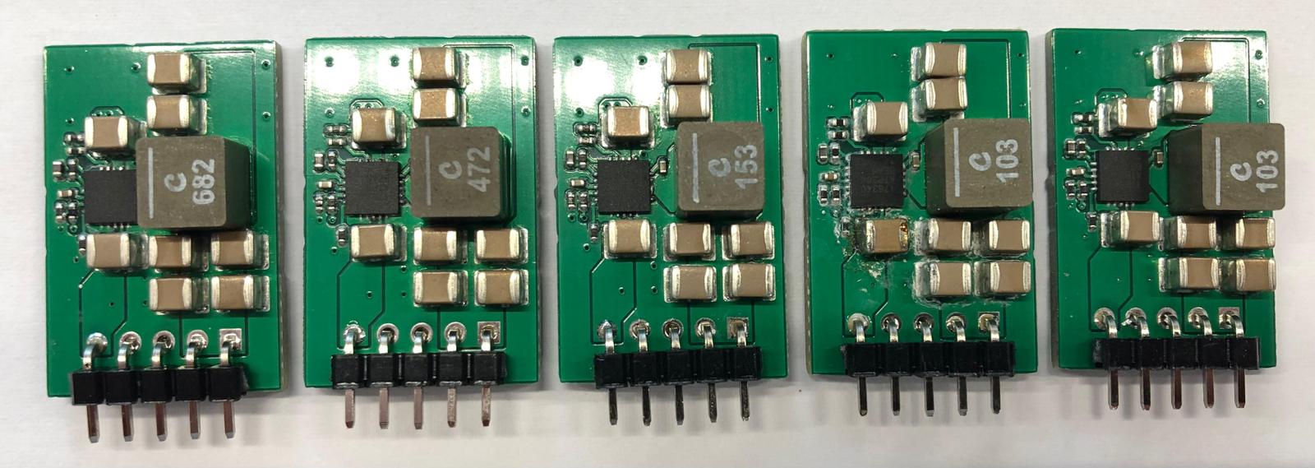
Hardware verification/Pictures of boards/Buck converters.jpeg
