HeinVerhallen/Audio-DSP/Hardware verification/Pictures of boards/Discrete linear voltage regulators.jpeg

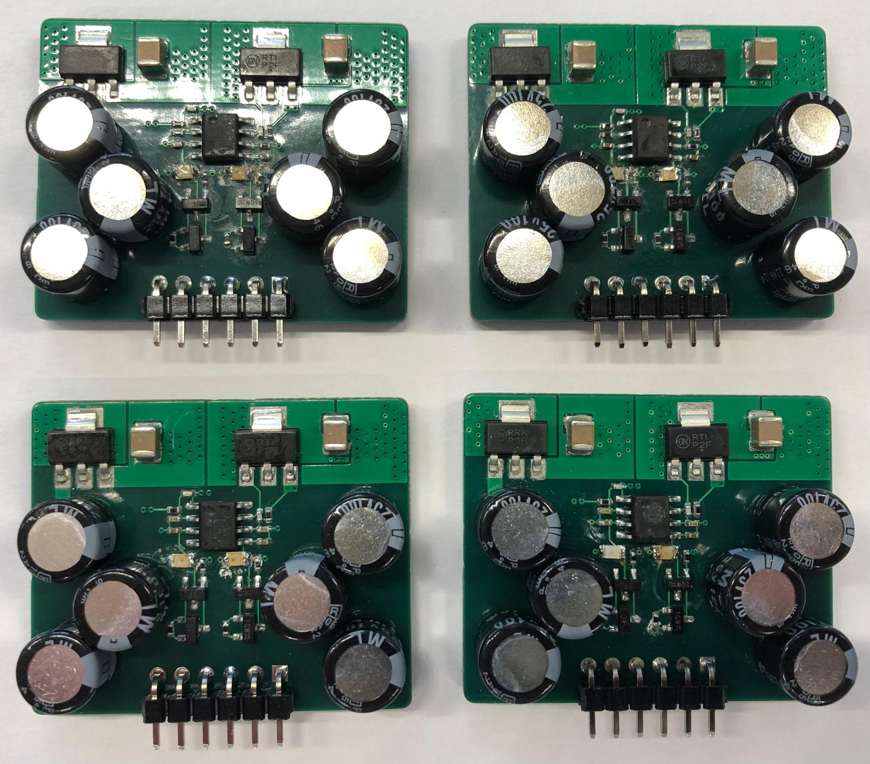
Hardware verification/Pictures of boards/Discrete linear voltage regulators.jpeg
