HeinVerhallen/Audio-DSP/Hardware verification/Pictures of boards/Main board/WhatsApp Image 2023-07-11 at 09.10.42 (5).jpeg

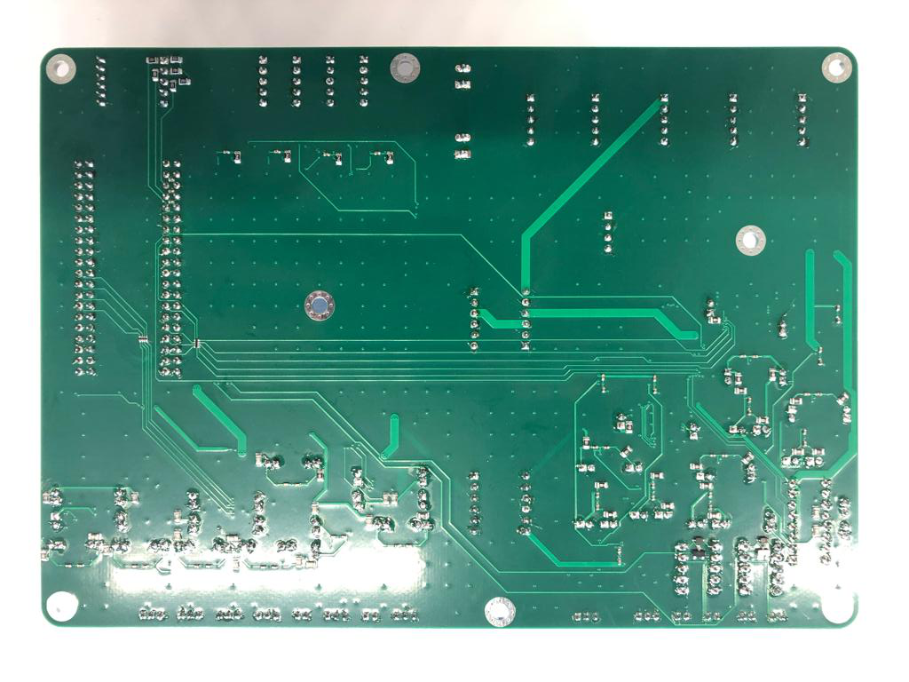
Hardware verification/Pictures of boards/Main board/WhatsApp Image 2023-07-11 at 09.10.42 (5).jpeg
