HeinVerhallen/Audio-DSP/Hardware verification/Pictures of boards/SEPIC.jpeg

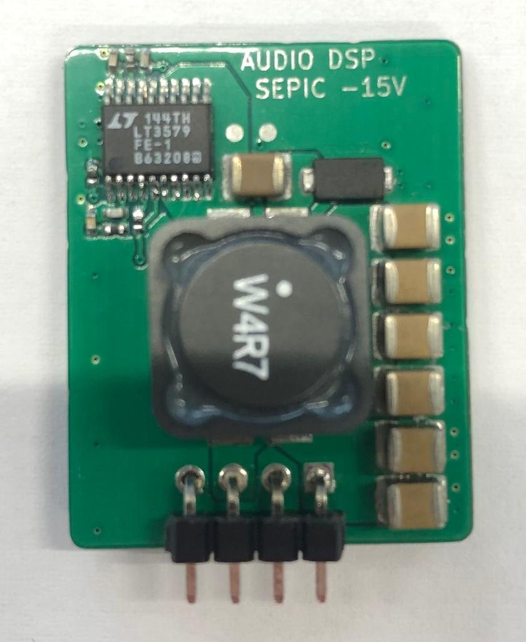
Hardware verification/Pictures of boards/SEPIC.jpeg
