HeinVerhallen/Audio-DSP/Hardware verification/SEPIC/Sepic_1A.png

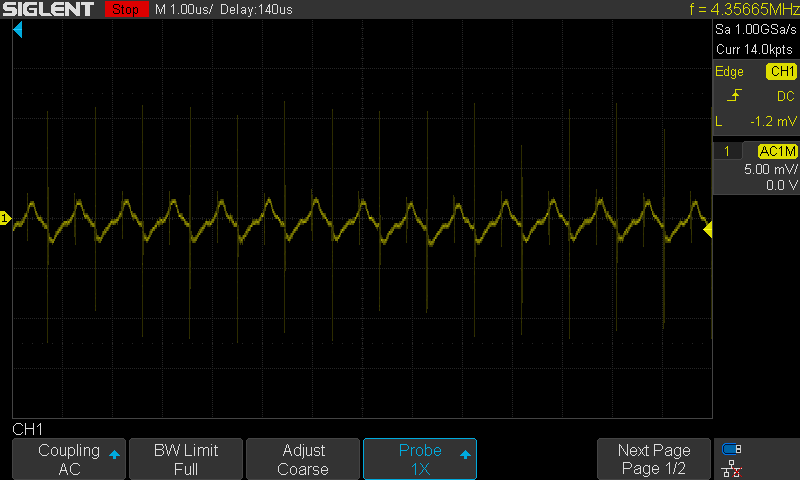
Hardware verification/SEPIC/Sepic_1A.png
