HeinVerhallen/Audio-DSP/Hardware verification/SEPIC/Sepic_500mA.png

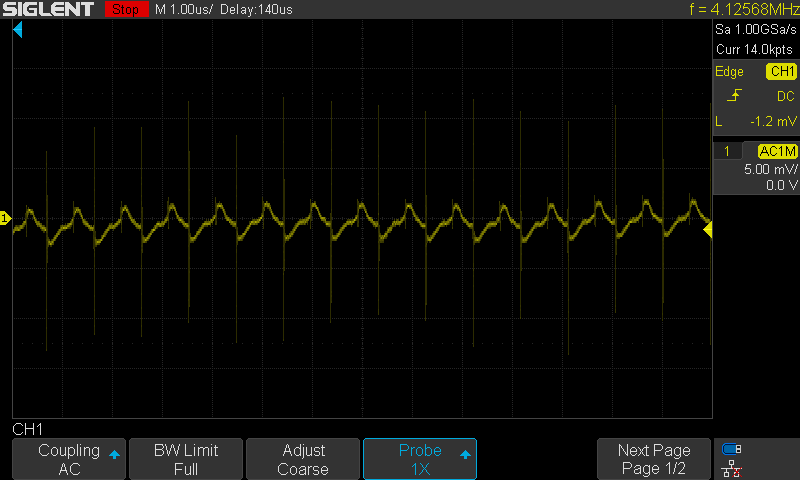
Hardware verification/SEPIC/Sepic_500mA.png
