HeinVerhallen/Audio-DSP/Hardware verification/SEPIC/Sepic_No_Load.png

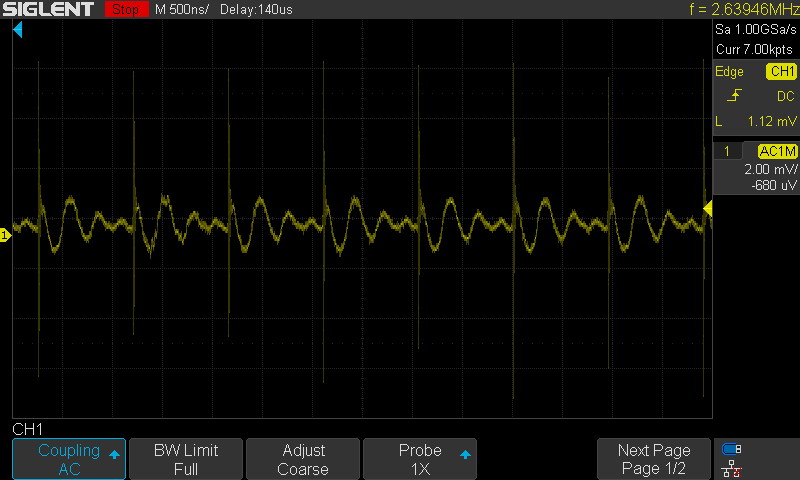
Hardware verification/SEPIC/Sepic_No_Load.png
