HeinVerhallen/Audio-DSP/Documentation/PlanOfApproach/Riskanalysis.tex

%FILE FOR RISK ANALYSIS
There are many risks and reasons why a project might fail or go bad, A change in organizational priorities is the most common reason. A change in project objectives is also common as poor communication and unclear risk definition.
	\begin{itemize}
		\setlength\itemsep{-0.3em}
		\item Unclear or shifting goals.
		\item lack of planning.
		\item lack of follow up.
		\item timing issues 
		\item Lack of risk management.
		\item Unsuitable tools.
		\item Too many unsuitable tools
	\end{itemize}

\noindent
For these reasons and many more, we’ve created an overall table with ratings which rate the opportunity/effect and risk.
	
% Please add the following required packages to your document preamble:
% \usepackage{graphicx}
% \usepackage[table,xcdraw]{xcolor}
% If you use beamer only pass "xcolor=table" option, i.e. \documentclass[xcolor=table]{beamer}
% \begin{table}[!h]
% \centering
% \resizebox{\textwidth}{!}{%
% \begin{tabular}{|l|
% >{\columncolor[HTML]{9AFF99}}l |l|l|l|
% >{\columncolor[HTML]{9AFF99}}l |
% >{\columncolor[HTML]{9AFF99}}l |l|}
% \hline
% \cellcolor[HTML]{CBCEFB}Risk                                                                       & \cellcolor[HTML]{CBCEFB}Opportunity & \cellcolor[HTML]{CBCEFB}Effects & \cellcolor[HTML]{CBCEFB}Risk & \cellcolor[HTML]{CBCEFB}\begin{tabular}[c]{@{}l@{}}Measure to prevent /\\ Remedy it\end{tabular}                                                                 & \cellcolor[HTML]{CBCEFB}Change after & \cellcolor[HTML]{CBCEFB}Consequences afterwards & \cellcolor[HTML]{CBCEFB}Ultimate risk \\ \hline
% \begin{tabular}[c]{@{}l@{}}A group member\\ lacks in work / failed\\ deadlines.\end{tabular}       & \cellcolor[HTML]{FFFC9E}4           & \cellcolor[HTML]{9AFF99}2       & \cellcolor[HTML]{FFCCC9}8    & \begin{tabular}[c]{@{}l@{}}Code of conduct created and\\ singed by everyone\end{tabular}                                                                         & 3                                    & 3                                               & \cellcolor[HTML]{FFFC9E}4             \\ \hline
% \begin{tabular}[c]{@{}l@{}}Clear file locations\\ and easy to map.\end{tabular}                    & 3                                   & \cellcolor[HTML]{9AFF99}3       & \cellcolor[HTML]{FFFC9E}6    & \begin{tabular}[c]{@{}l@{}}Weekly document tracking\\ and documentation is taken.\end{tabular}                                                                   & 2                                    & 3                                               & \cellcolor[HTML]{9AFF99}3             \\ \hline
% \begin{tabular}[c]{@{}l@{}}Behind schedule for\\ lack of knowledge or\\ confusion.\end{tabular}    & 4                                   & \cellcolor[HTML]{9AFF99}3       & \cellcolor[HTML]{FFCCC9}7    & \begin{tabular}[c]{@{}l@{}}Ask for help in time from\\ fellow group members or\\ teachers.\end{tabular}                                                          & 1                                    & 2                                               & \cellcolor[HTML]{9AFF99}2             \\ \hline
% Running low on budget.                                                                             & 1                                   & \cellcolor[HTML]{FFFC9E}6       & \cellcolor[HTML]{9AFF99}5    & Budget is documented.                                                                                                                                            & 1                                    & 3                                               & \cellcolor[HTML]{9AFF99}1             \\ \hline
% \begin{tabular}[c]{@{}l@{}}There is insufficient\\ communication in the\\ group.\end{tabular}      & 2                                   & \cellcolor[HTML]{9AFF99}3       & \cellcolor[HTML]{FFFC9E}6    & \begin{tabular}[c]{@{}l@{}}Meetings will be scheduled 2-3\\ times a week, minutes and\\ notes are taken and uploaded\\ up to date.\end{tabular}                  & 1                                    & 3                                               & \cellcolor[HTML]{9AFF99}3             \\ \hline
% \begin{tabular}[c]{@{}l@{}}Clear results are\\ missing.\end{tabular}                               & \cellcolor[HTML]{FFFC9E}4           & \cellcolor[HTML]{FFFC9E}6       & \cellcolor[HTML]{FFCCC9}9    & \begin{tabular}[c]{@{}l@{}}The strip planning clearly\\ states which part you need to\\ complete to be on schedule\\ with each part of the project.\end{tabular} & 2                                    & 3                                               & \cellcolor[HTML]{FFFC9E}6             \\ \hline
% \begin{tabular}[c]{@{}l@{}}Shortage in\\ components\end{tabular}                                   & 2                                   & \cellcolor[HTML]{FFCCC9}9       & \cellcolor[HTML]{9AFF99}3    & \begin{tabular}[c]{@{}l@{}}A delay in ordering or\\ receiving parts\end{tabular}                                                                                 & \cellcolor[HTML]{FFFC9E}6            & \cellcolor[HTML]{FFFC9E}6                       & \cellcolor[HTML]{FFCCC9}9             \\ \hline
% \begin{tabular}[c]{@{}l@{}}The planning of\\ Fontys teaching\\ material is incorrect.\end{tabular} & \cellcolor[HTML]{FFFC9E}4           & \cellcolor[HTML]{FFFC9E}5       & \cellcolor[HTML]{FFCCC9}9    & Read documents carefully                                                                                                                                         & \cellcolor[HTML]{FFFC9E}4            & \cellcolor[HTML]{FFCCC9}7                       & \cellcolor[HTML]{FFCCC9}7             \\ \hline
% \end{tabular}%
% }
% \caption{Risk analysis}
% \label{Risk analysis}
% \end{table}

\newpage
\begin{table}[!h]
	\centering
	\begin{tabular}{|>{\columncolor{gray}}c|c|c|c|c|c|}
		\cline{2-6}
		\rowcolor{gray}
		\multicolumn{1}{l|}{\cellcolor{white}}&Very low&Low		&Medium					&High					&Very high 				\\ \hline
		Very likely	&\cellcolor{yellow}5&\cellcolor{orange}10	&\cellcolor{red}15		&\cellcolor{red}20		&\cellcolor{red}25 		\\ \hline
		likely		&\cellcolor{green}4	&\cellcolor{yellow}8	&\cellcolor{orange}12	&\cellcolor{red}16		&\cellcolor{red}20 		\\ \hline
		possible	&\cellcolor{green}3	&\cellcolor{yellow}6	&\cellcolor{yellow}9	&\cellcolor{orange}12	&\cellcolor{red}15 		\\ \hline
		Unlikely	&\cellcolor{green}2	&\cellcolor{green}4		&\cellcolor{yellow}6	&\cellcolor{yellow}8	&\cellcolor{orange}10	\\ \hline
		Rare		&\cellcolor{green}1	&\cellcolor{green}2		&\cellcolor{green}3		&\cellcolor{green}4		&\cellcolor{yellow}5	\\ \hline
	\end{tabular}
	\caption{risk analysis index}
\end{table}

\renewcommand\tabularxcolumn[1]{m{#1}}% for vertical centering text in X column

\begin{table}[!h]
	\begin{tabularx}{\textwidth}{|c|X|X|c|c|c|} \hline
		\# 	& Risk 													& Action 																				& Probability 	& Impact 	& Score 	\\ \hline
		1 	& A group member lacks in word/failed deadlines			& Code of Conduct created and signed by everyone										& 4	& 2			& \cellcolor{yellow}8	\\ \hline
		2 	& Messy file structure									& The version-controller looks after the structure of the folders						& 2	& 3			& \cellcolor{yellow}6	\\ \hline
		3 	& Behind schedule for lack of knowledge or confusion	& Ask for help in time from fellow group members or teachers							& 2	& 3			& \cellcolor{yellow}6	\\ \hline
		4 	& Running low on budget									& Budget will be tracked and roughly planned											& 1	& 5			& \cellcolor{yellow}5	\\ \hline
		5 	& There is insufficient communication in the group		& Weekly meetings where progress and tasks are discussed.								& 2	& 3			& \cellcolor{yellow}6	\\ \hline
		6 	& Clear results are missing								& The weekly meeting notes state clearly what activities have to be done the next week	& 1	& 3			& \cellcolor{green}3	\\ \hline
		7 	& Shortage in components								& Order parts early or look for available alternatives									& 2	& 4			& \cellcolor{yellow}8	\\ \hline
		8 	& The planning of Fontys teaching material is incorrect	& Read documents carefully																& 4	& 1			& \cellcolor{green}4	\\ \hline
	\end{tabularx}
	\caption{Risk analysis}
\end{table}
