HeinVerhallen/Audio-DSP/Documentation/PlanOfApproach/images/risk.jpg

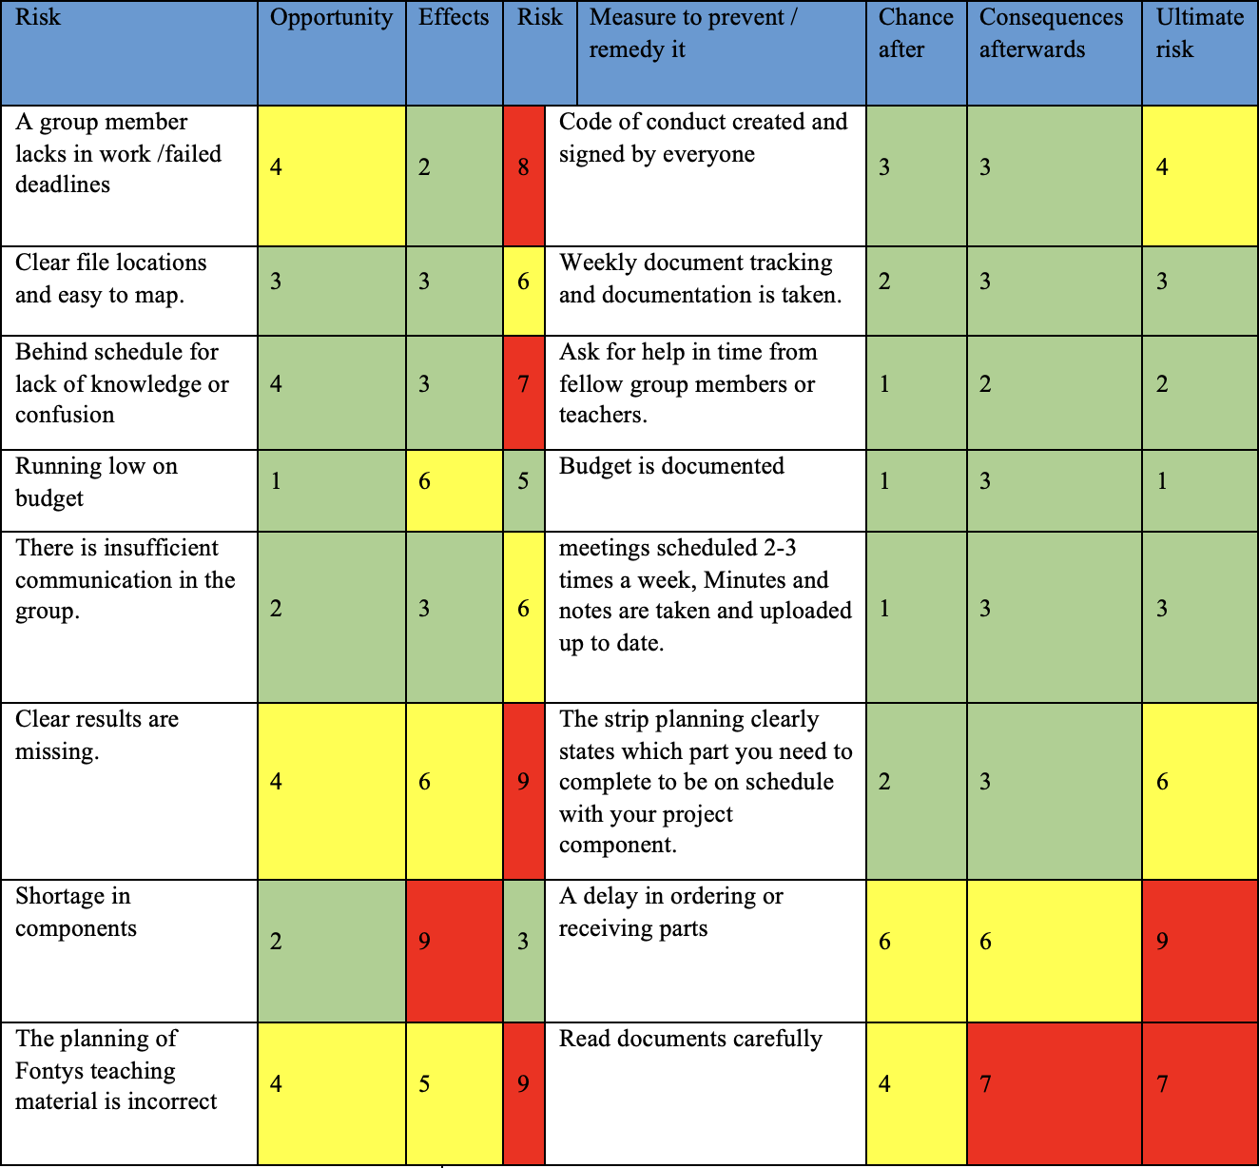
Documentation/PlanOfApproach/images/risk.jpg
