HeinVerhallen/Audio-DSP/KiCAD/Main board/Main_board_schematic.pdf

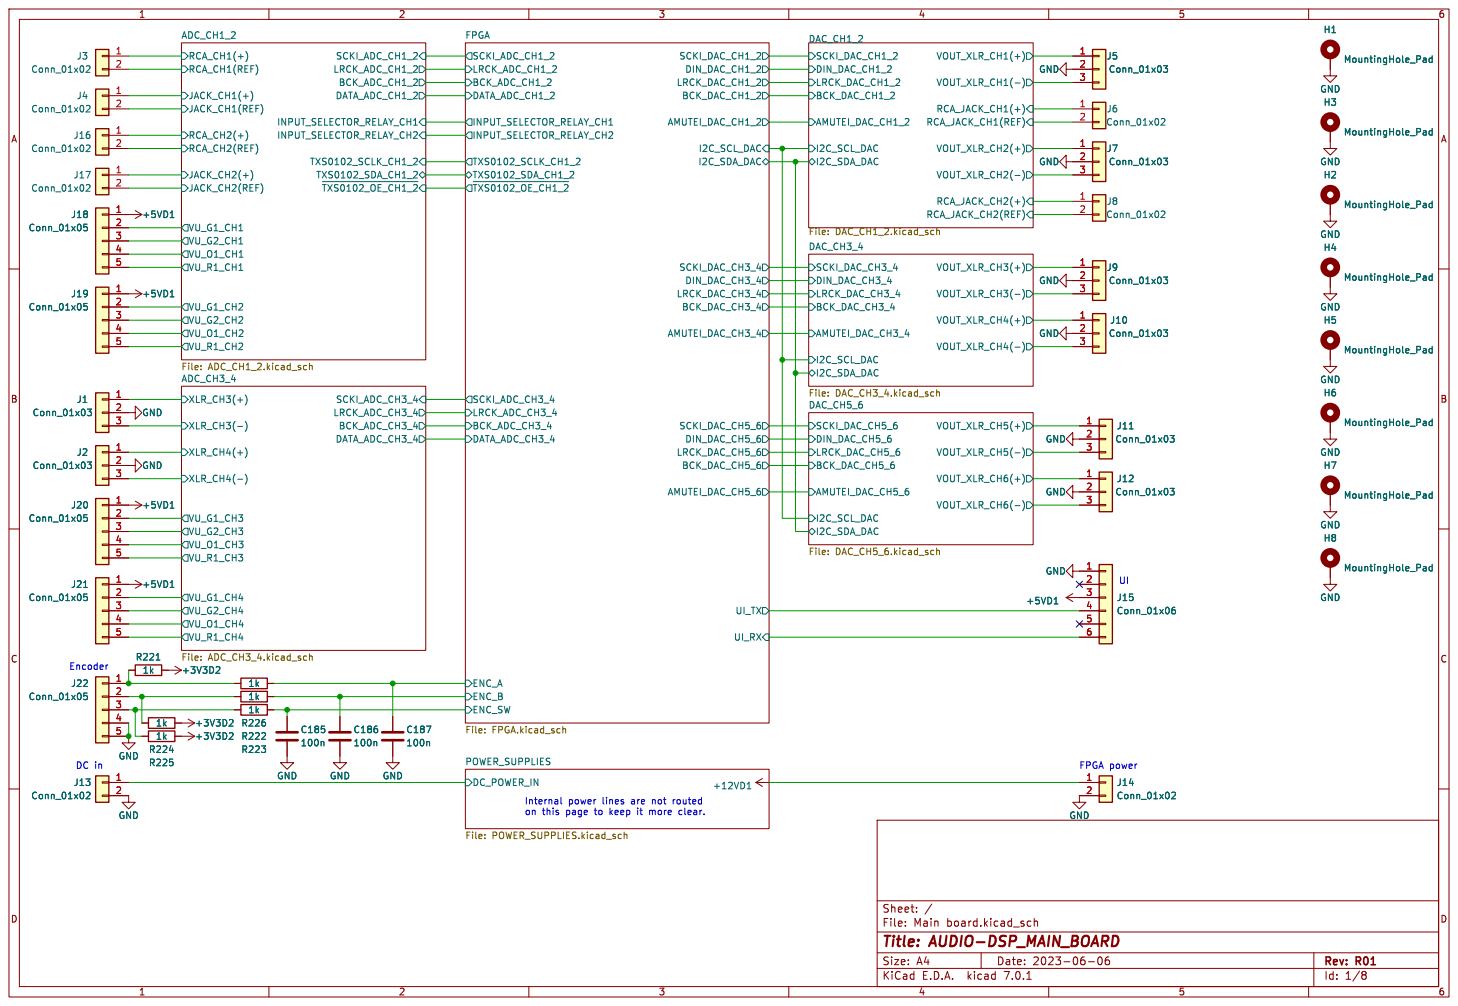
[picture p132: page 1]

on this page to keep it more clear. R224

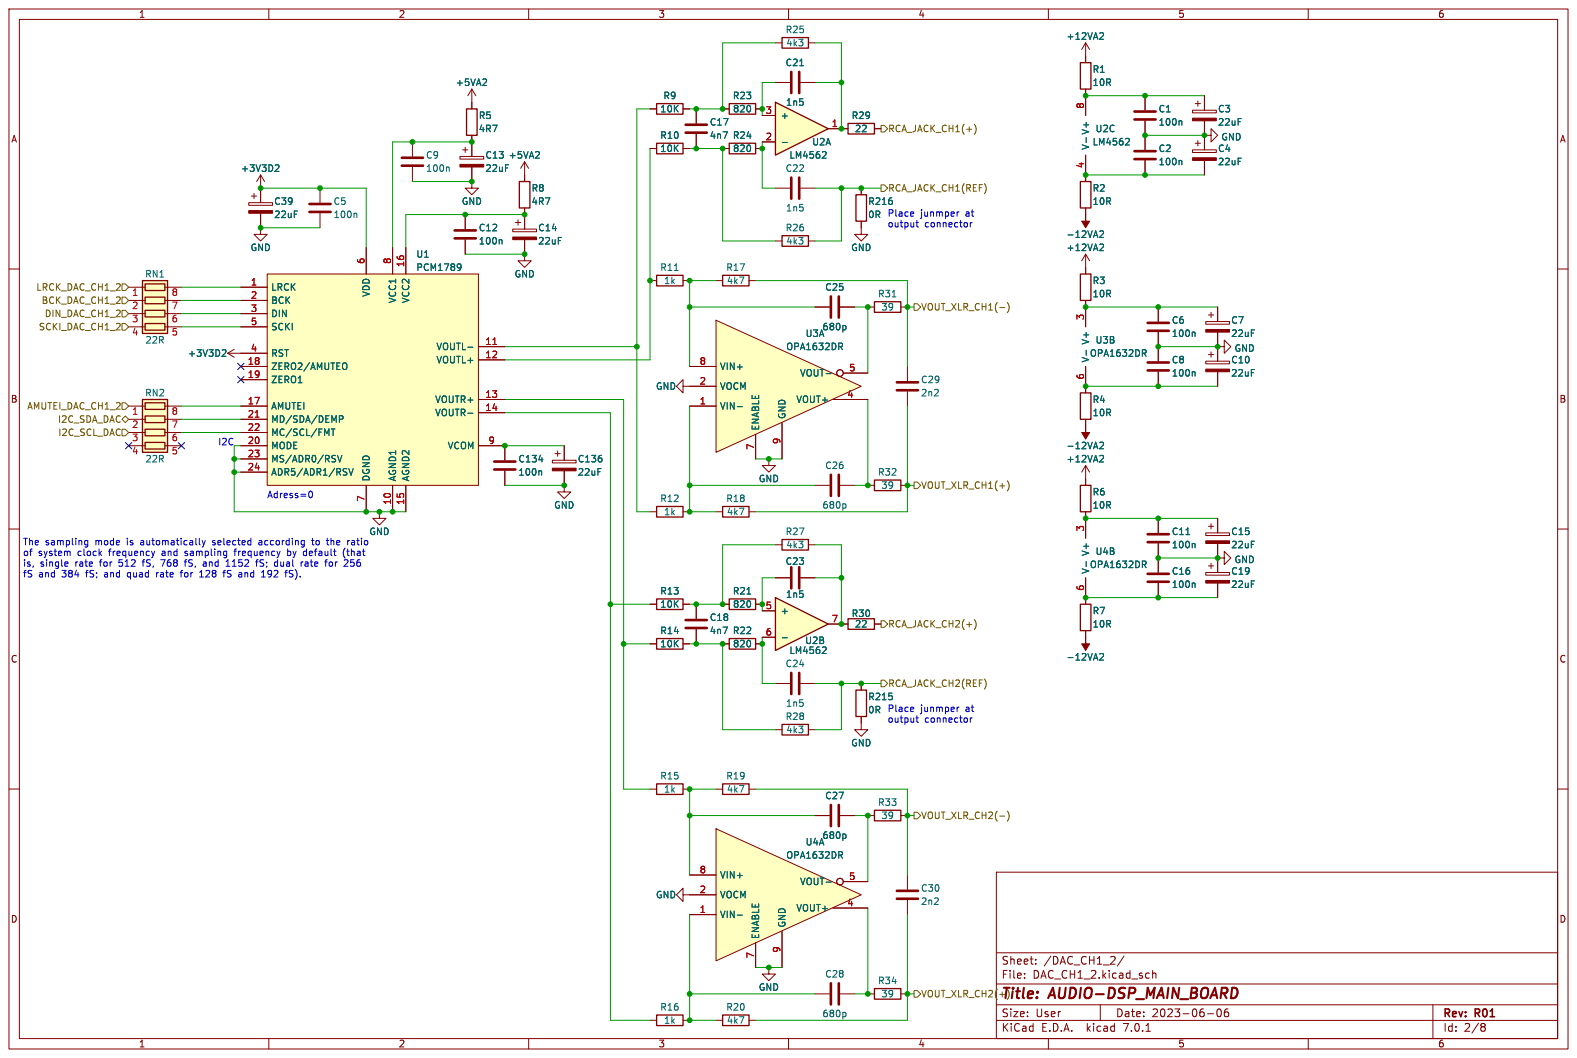
[picture p133: page 2]

is, single rate for 512 fS, 768 fS, and 1152 fS; dual rate for 256

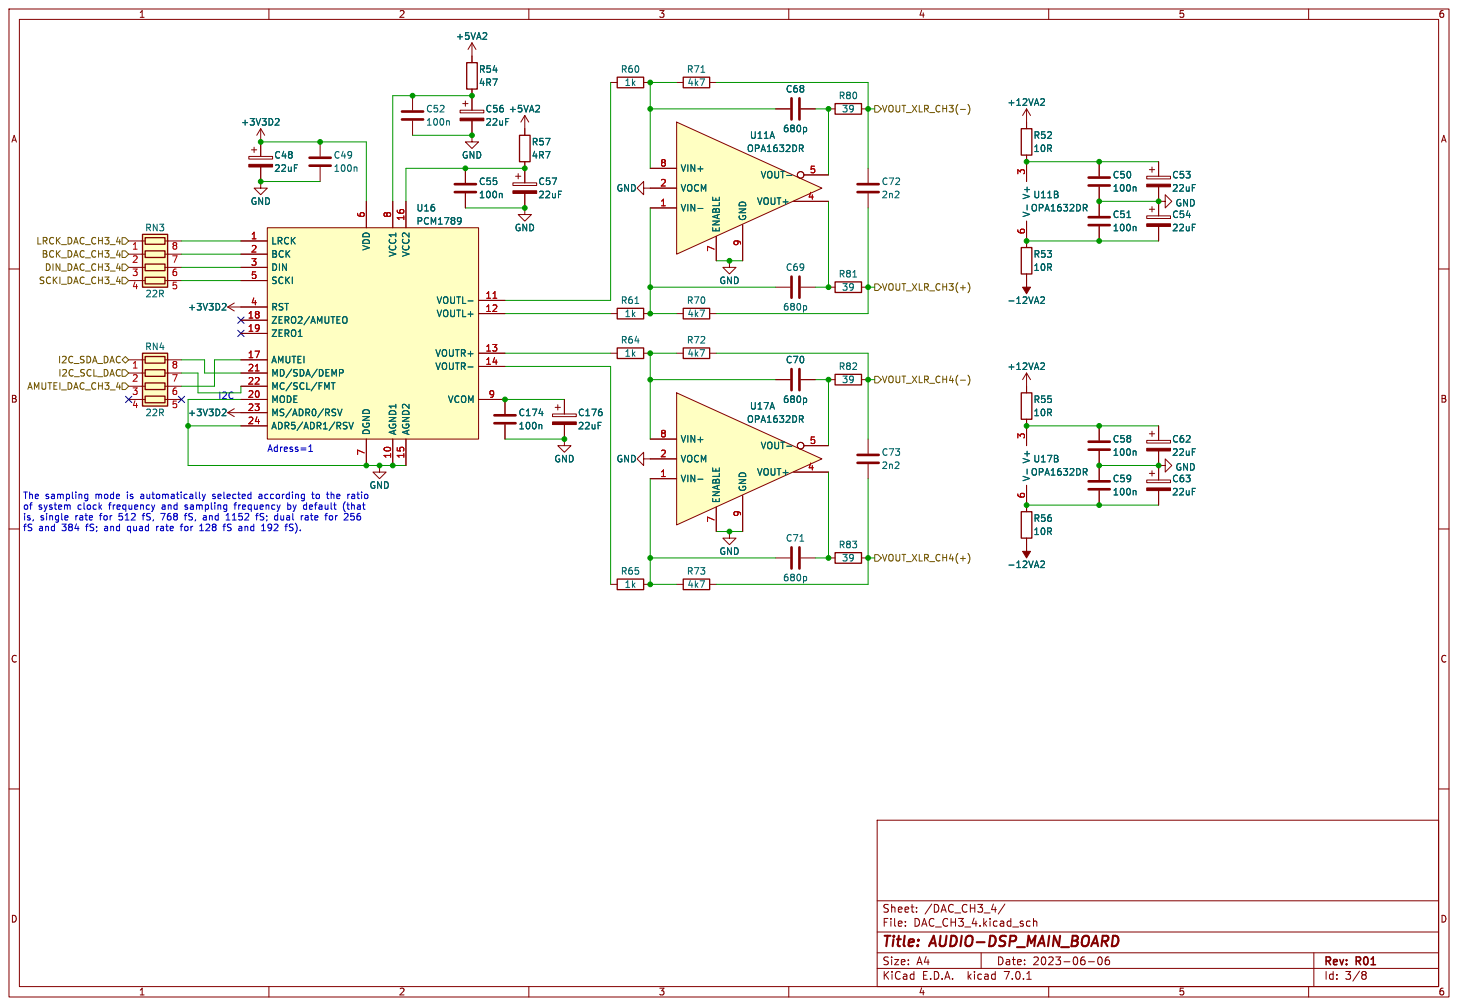
[picture p134: page 3]

is, single rate for 512 fS, 768 fS, and 1152 fS; dual rate for 256
fS and 384 fS; and quad rate for 128 fS and 192 fS).

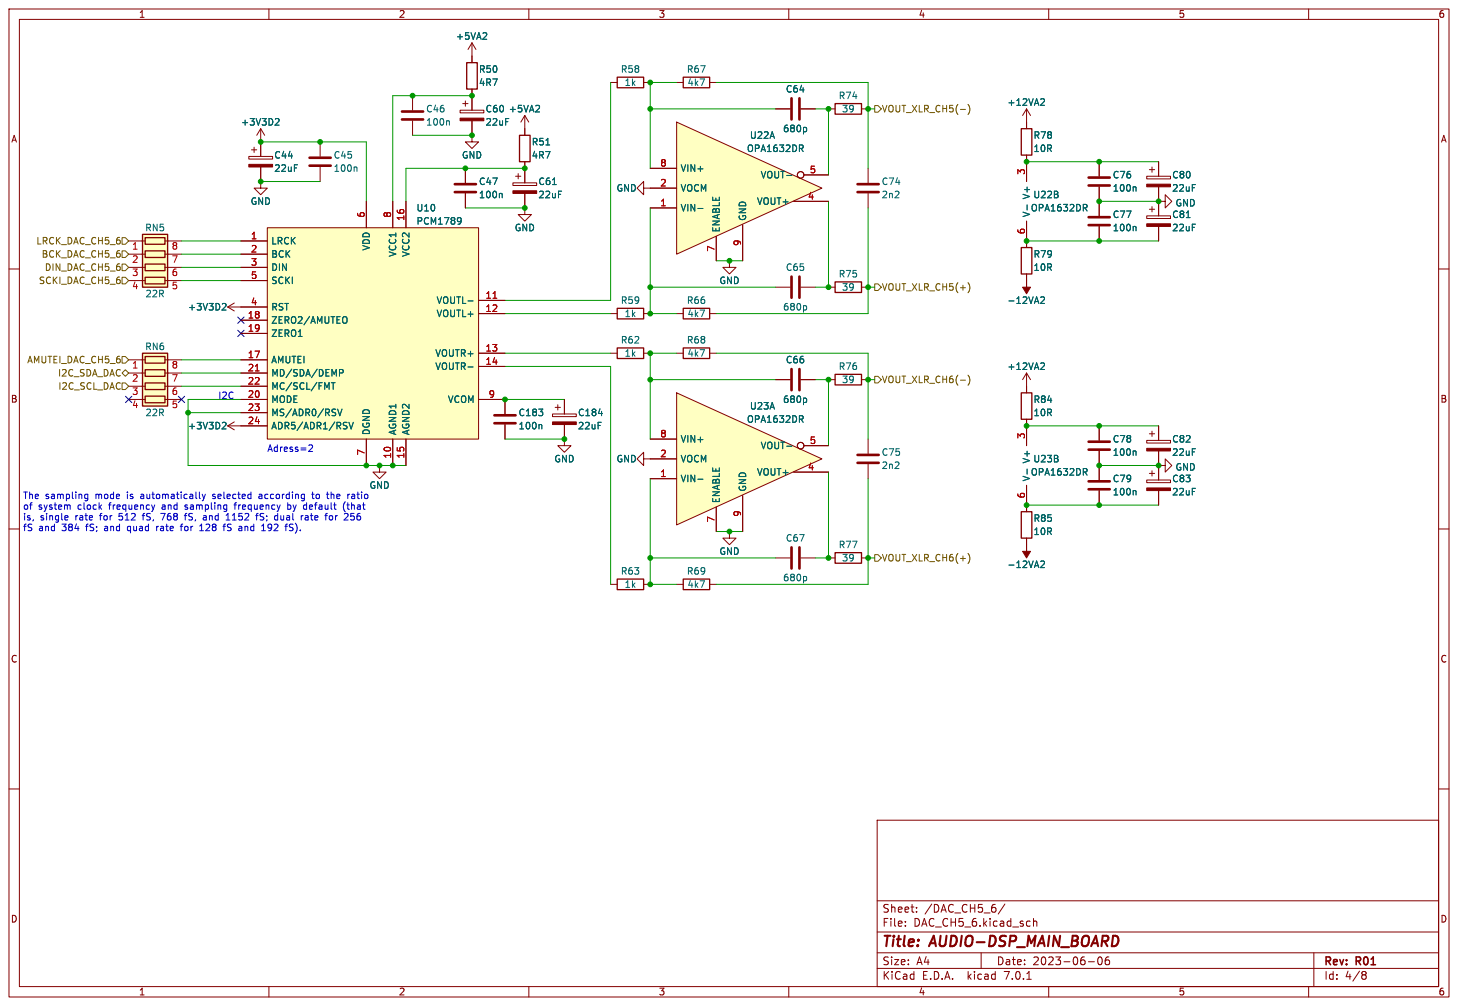
[picture p135: page 4]

is, single rate for 512 fS, 768 fS, and 1152 fS; dual rate for 256

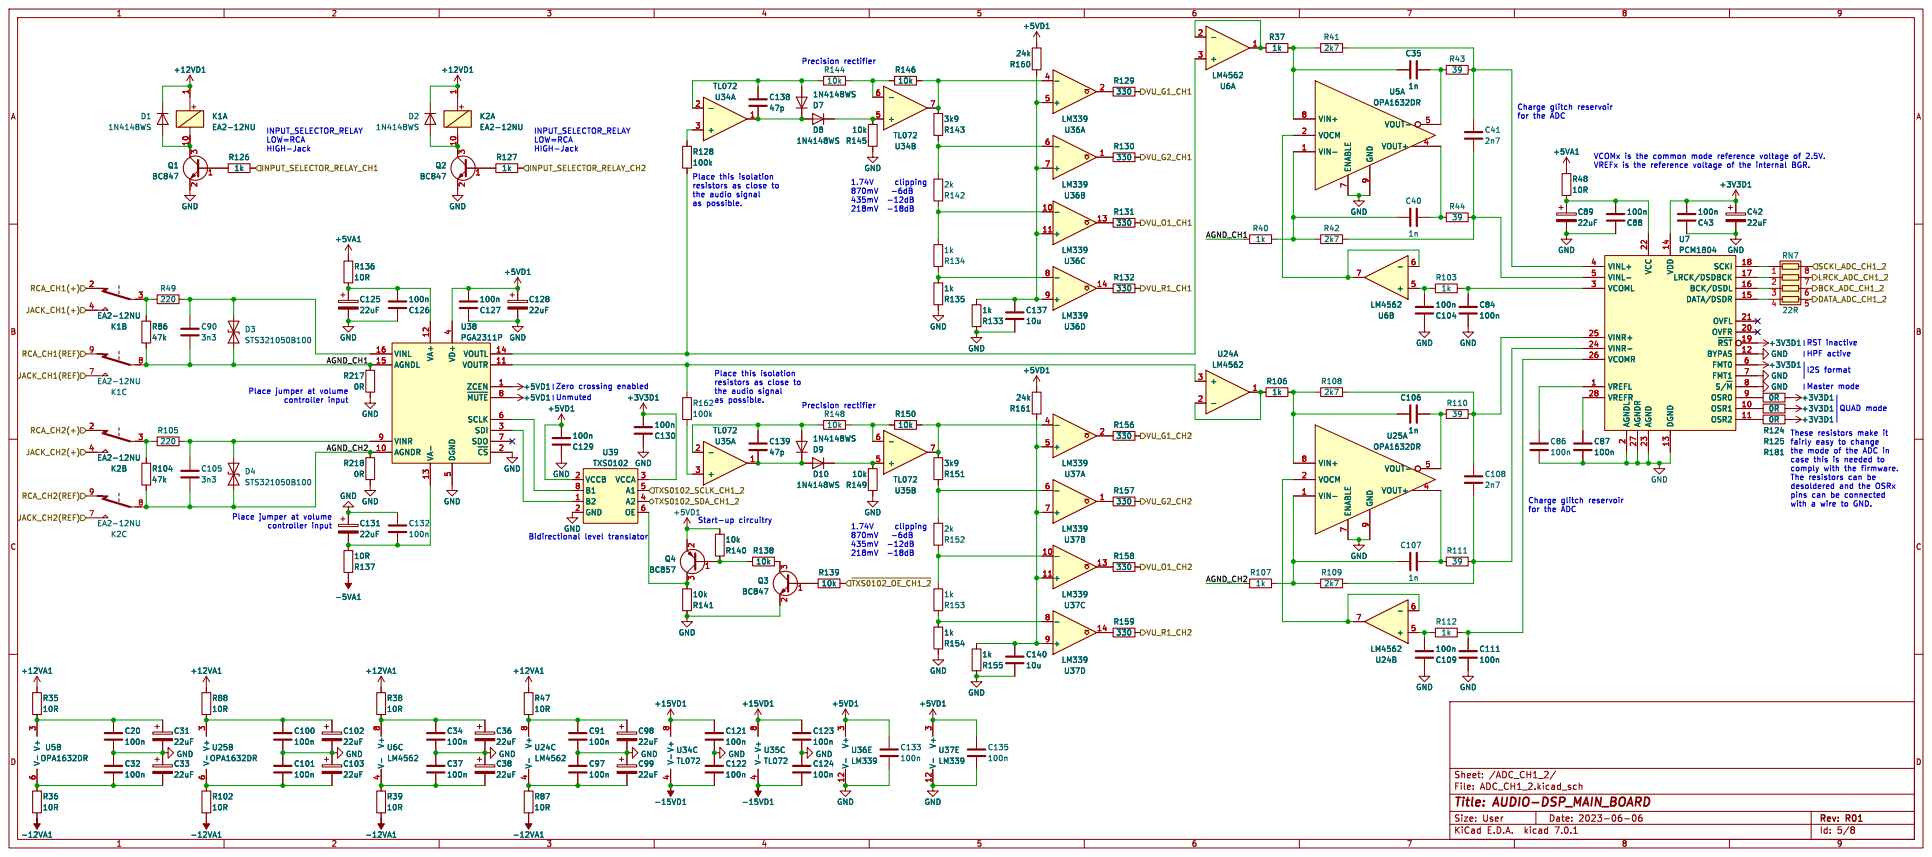
[picture p136: page 5]

5 SCLK 6 SDO 7 ~{MUTE}8 VINR 9 U38 PGA2311P R218

5 SCLK 6 SDO 7 ~{MUTE}8 VINR 9 R218

fairly easy to change
the mode of the ADC in
case this is needed to

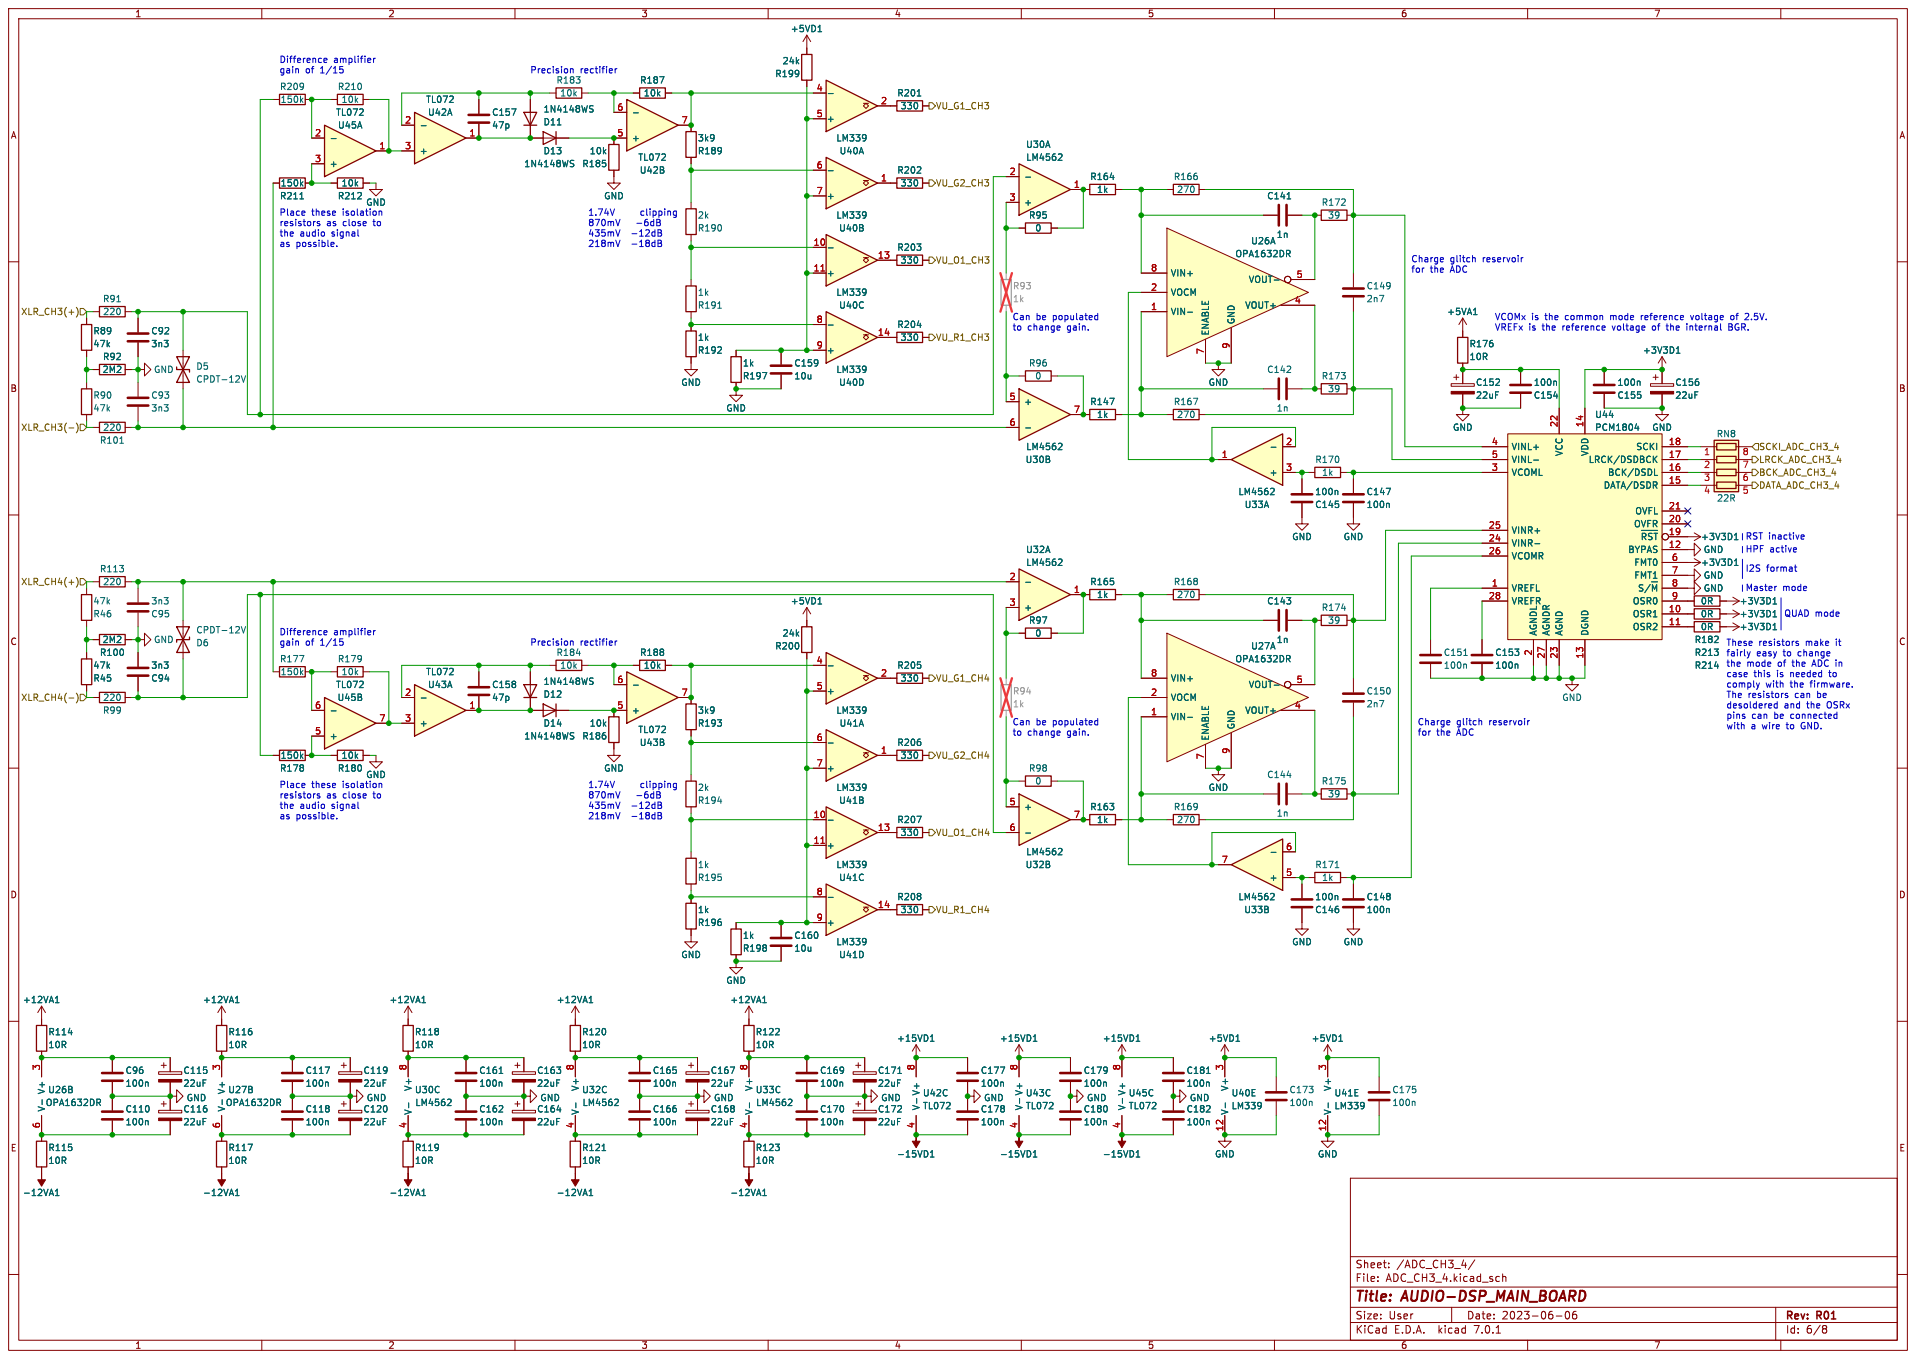
[picture p137: page 6]

2 OVFR 20 OVFL 21 VCC 22 AGND 23 VINR- 24 VINR+ 25 VCOMR 26 AGNDR 27 VREFR 28 VCOML 3 VINL+ 4 VINL- 5 FMT0 6 FMT1 7 S/~{M} 8 OSR0 9 U44 PCM1804 GND GND

2 OVFR 20 OVFL 21 VCC 22 AGND 23 VINR- 24 VINR+ 25 VCOMR 26 AGNDR 27 VREFR 28 VCOML 3 VINL+ 4 VINL- 5 FMT0 6 FMT1 7 S/~{M} 8 OSR0 9 GND

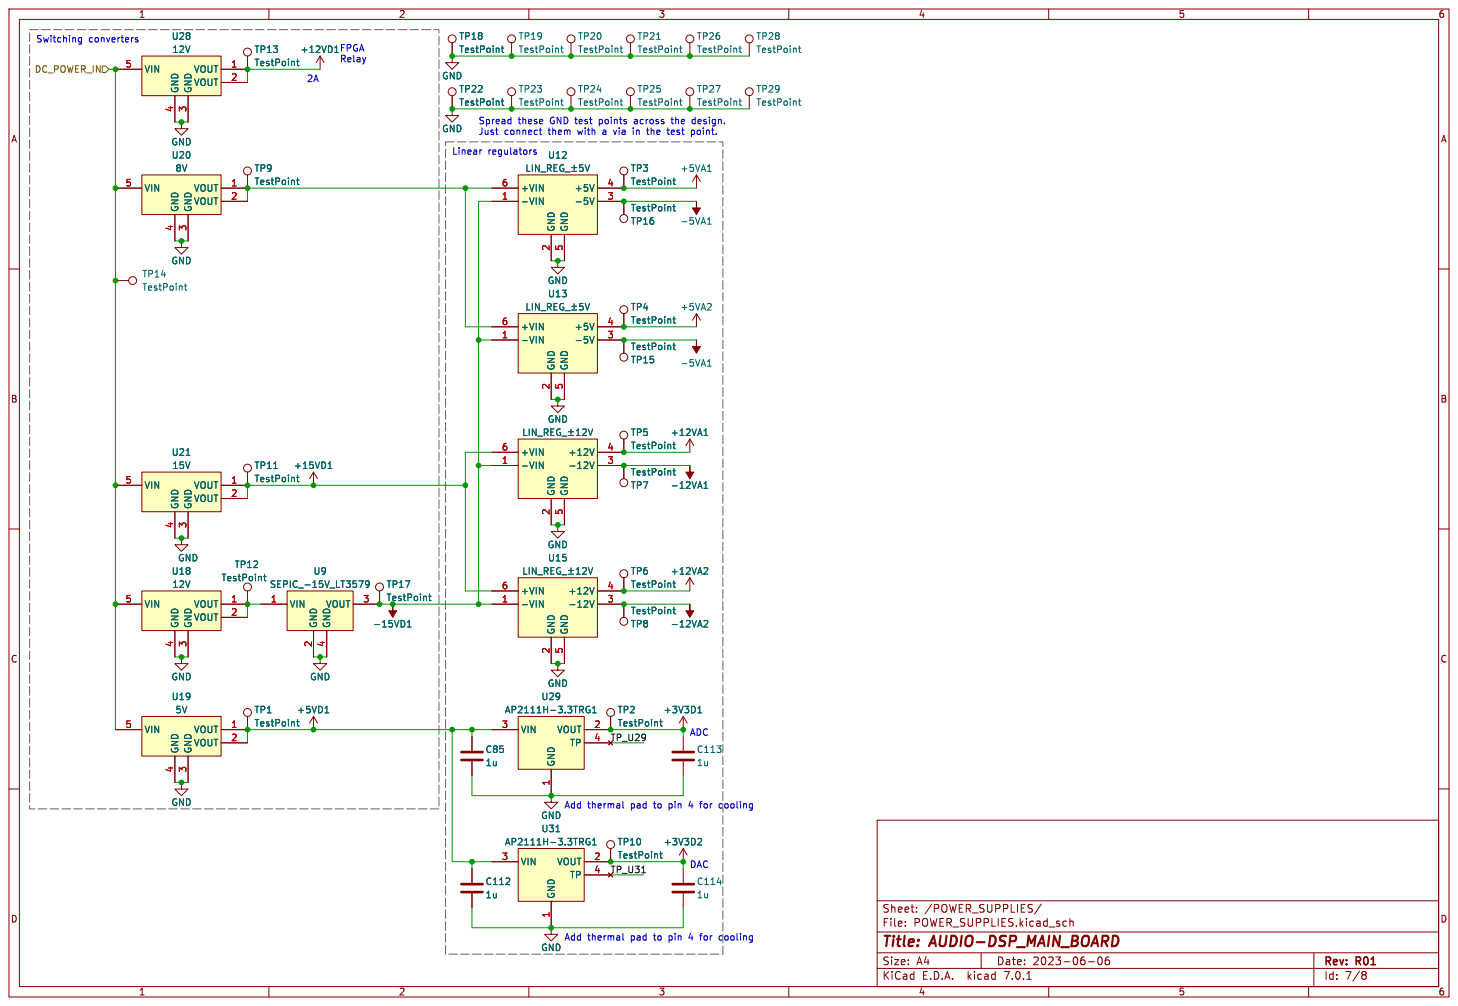
[picture p138: page 7]

Add thermal pad to pin 4 for cooling DAC
GND

Add thermal pad to pin 4 for cooling

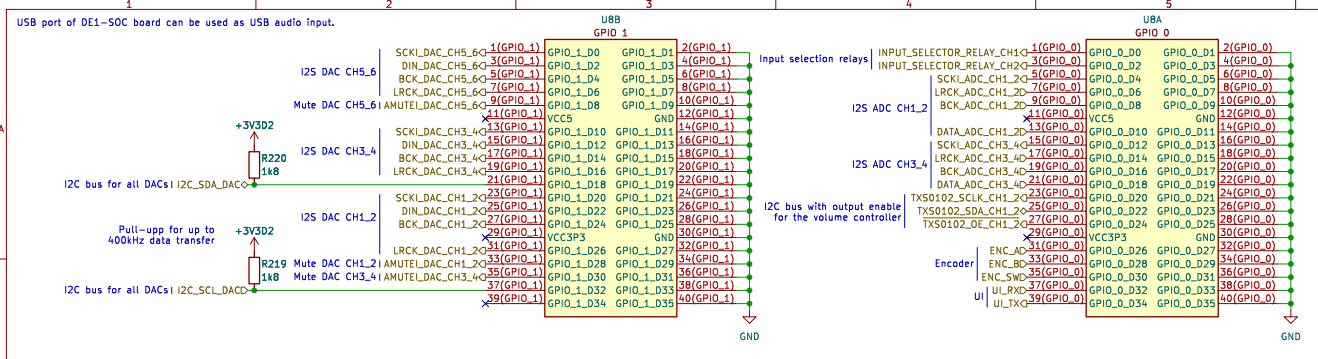
[picture p139: page 8]

I2C bus for all DACs USB port of DE1-SOC board can be used as USB audio input.

I2C bus with output enable

I2C bus for all DACs
