HeinVerhallen/Audio-DSP/Block diagrams/System design/Front-end detailed.pdf

# Legend

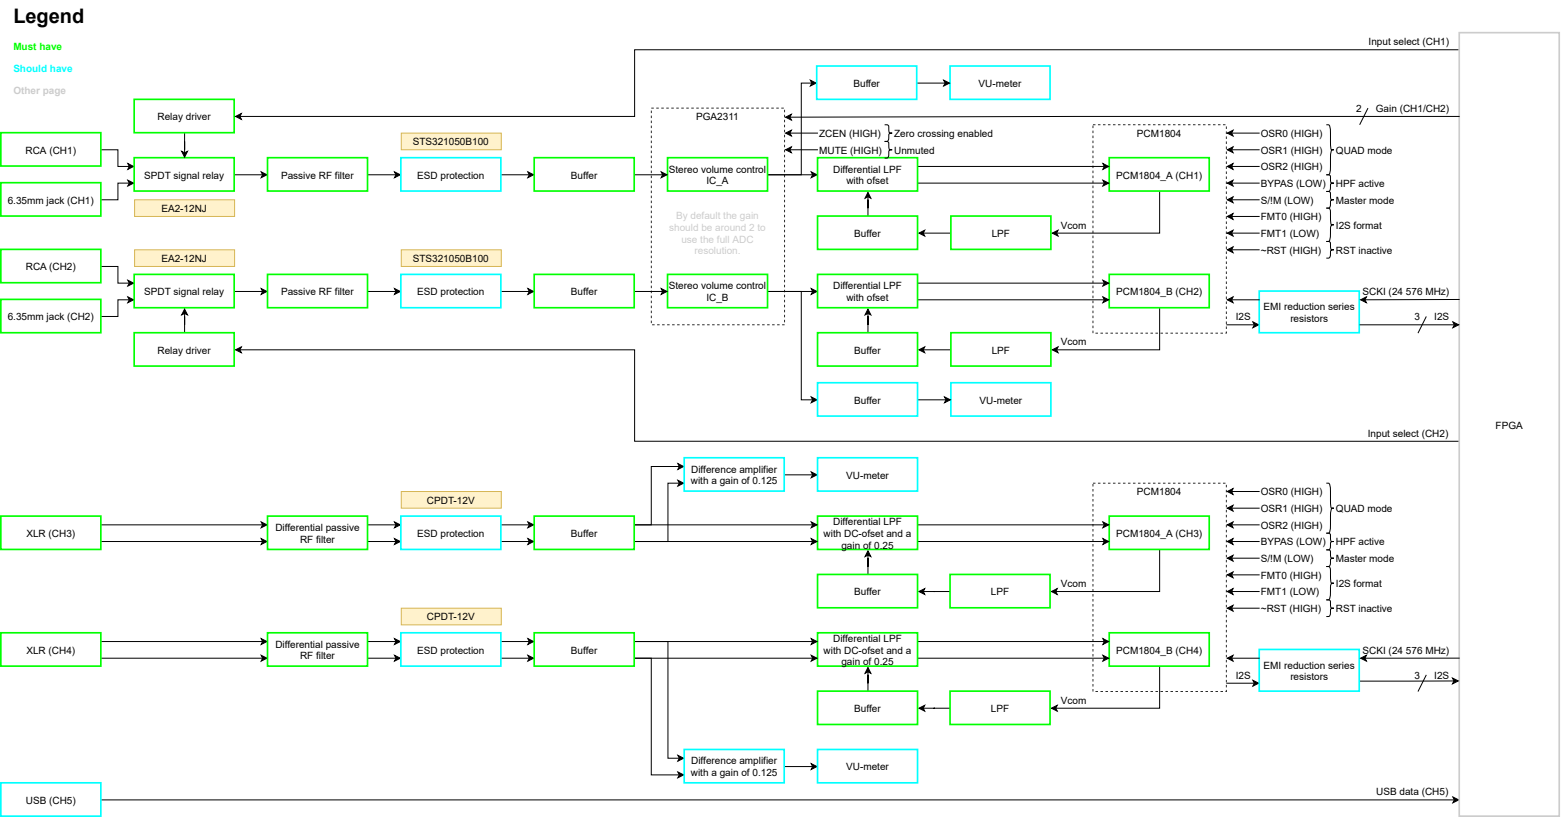
[picture p140: page 1]
USB (CH5); RCA (CH1); 6.35mm jack (CH1); RCA (CH2); 6.35mm jack (CH2); XLR (CH3); XLR (CH4); PCM1804_A (CH1); Buffer; LPF; Vcom; STS321050B100; PCM1804_B (CH2); Differential LPF with ofset; PCM1804; PCM1804_A (CH3); PCM1804_B (CH4); Must have; Should have; Other page; CPDT-12V; Relay driver; OSR0 (HIGH); OSR1 (HIGH); OSR2 (HIGH); FPGA; Input select (CH1); Input select (CH2); resistors; USB data (CH5); BYPAS (LOW); Gain (CH1/CH2); S/!M (LOW); FMT0 (HIGH); FMT1 (LOW); PGA2311; I2S format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

ZCEN (HIGH)
MUTE (HIGH) Unmuted
Differential LPF
with ofset

Zero crossing enabled

SPDT signal relay

Stereo volume control

By default the gain
should be around 2 to
use the full ADC
resolution.

EMI reduction series

Difference amplifier
with a gain of 0.125

with DC-ofset and a
gain of 0.25
