HeinVerhallen/Audio-DSP/KiCAD/Discrete_linear_regulator/Discrete_linear_regulator_schematic.pdf

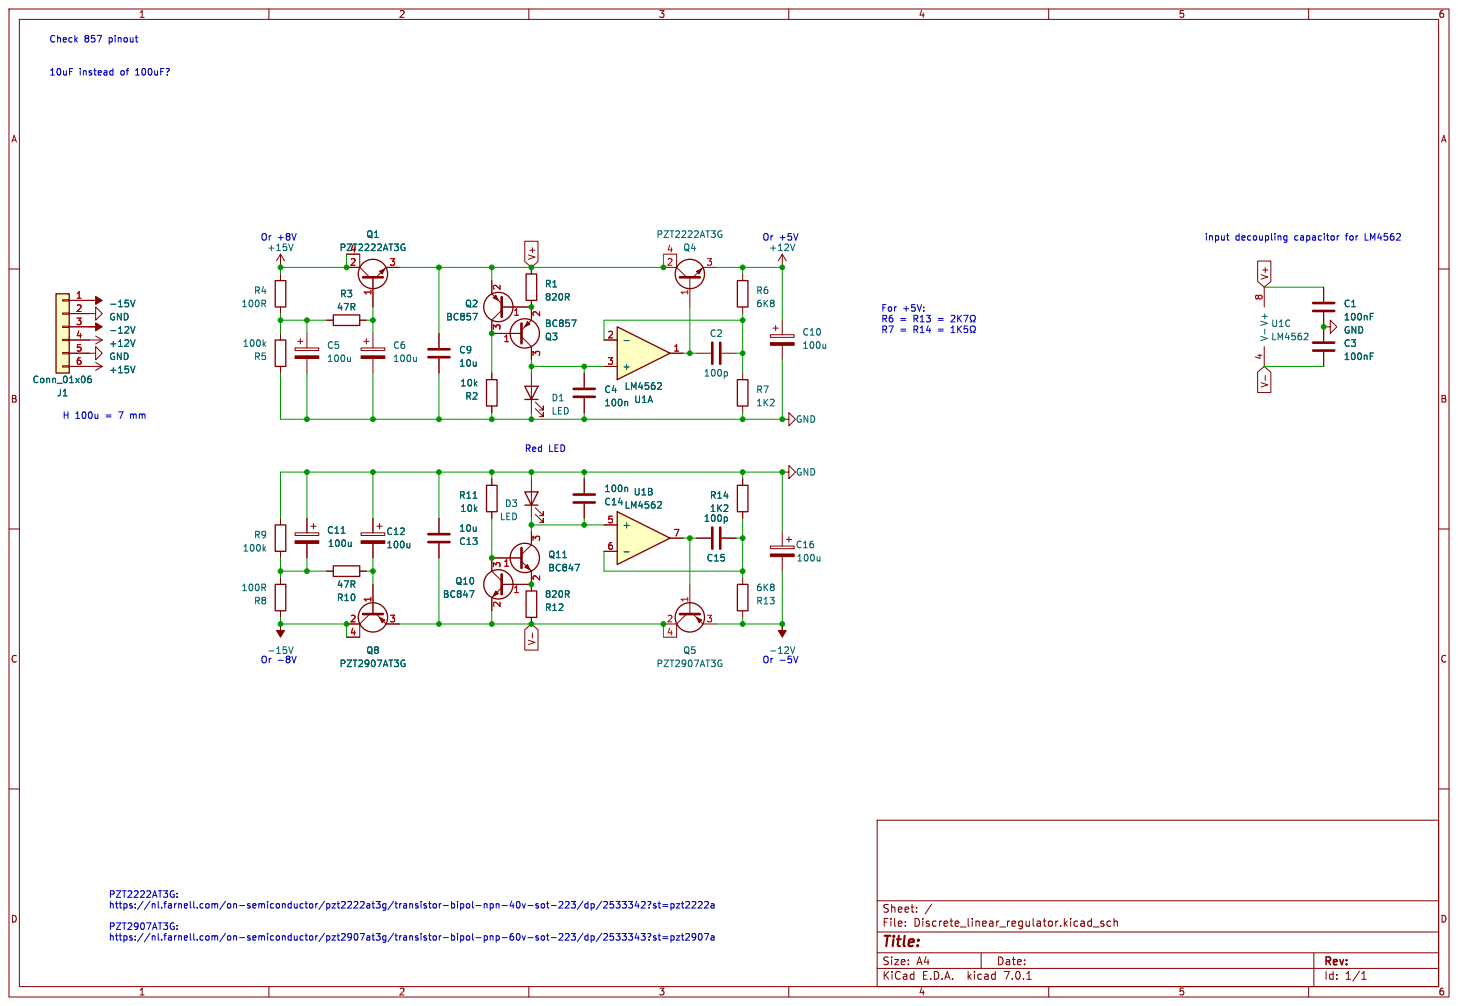
[picture p141: page 1]

PZT2222AT3G: https://nl.farnell.com/on-semiconductor/pzt2222at3g/transistor-bipol-npn-40v-sot-223/dp/2533342?st=pzt2222a PZT2907AT3G: https://nl.farnell.com/on-semiconductor/pzt2907at3g/transistor-bipol-pnp-60v-sot-223/dp/2533343?st=pzt2907a
