HeinVerhallen/Audio-DSP/KiCAD/Generic_Buck_Converter/Generic_Buck_Converter_schematic.pdf

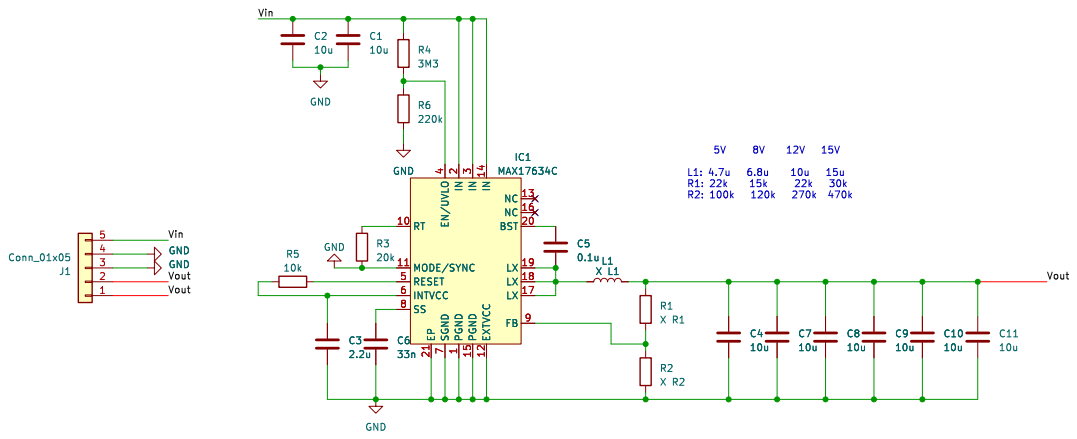
[picture p142: page 1]

1 RT 10 MODE/SYNC 11 EXTVCC 12 NC 13 IN 14 PGND 15

Id: 1/1 Title: File: Generic_Buck_Converter.kicad_sch Sheet: /
