HeinVerhallen/Audio-DSP/LTspice/Negatve supply (-15V SEPIC)/LT3579 LTspice schematic.pdf

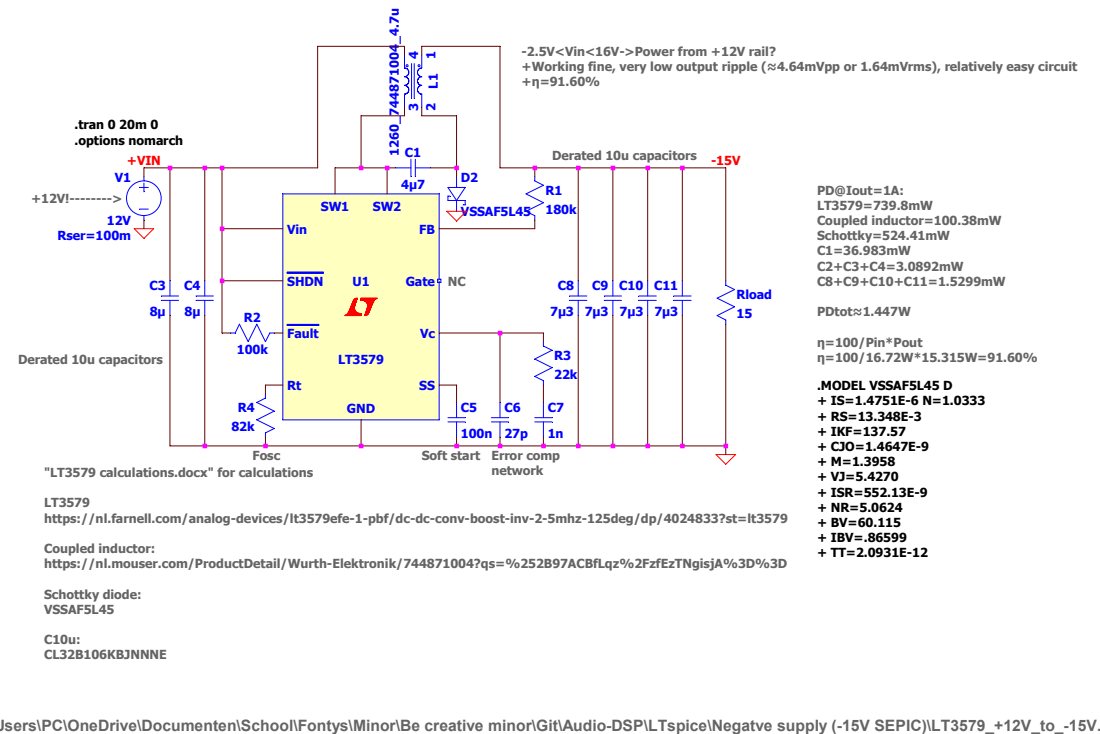
[picture p143: page 1]

-2.5V<Vin<16V->Power from +12V rail?
+Working fine, very low output ripple (≈4.64mVpp or 1.64mVrms), relatively easy circuit

"LT3579 calculations.docx" for calculations

https://nl.farnell.com/analog-devices/lt3579efe-1-pbf/dc-dc-conv-boost-inv-2-5mhz-125deg/dp/4024833?st=lt3579

Coupled inductor:
https://nl.mouser.com/ProductDetail/Wurth-Elektronik/744871004?qs=%252B97ACBfLqz%2FzfEzTNgisjA%3D%3D

--- C:\Users\PC\OneDrive\Documenten\School\Fontys\Minor\Be creative minor\Git\Audio-DSP\LTspice\Negatve supply (-15V SEPIC)\LT3579_+12V_to_-15V.asc ---
