HeinVerhallen/Audio-DSP/LTspice/Front-end/RCA-JACK RF filter, AAF with ADC driver LTspice schematic.pdf

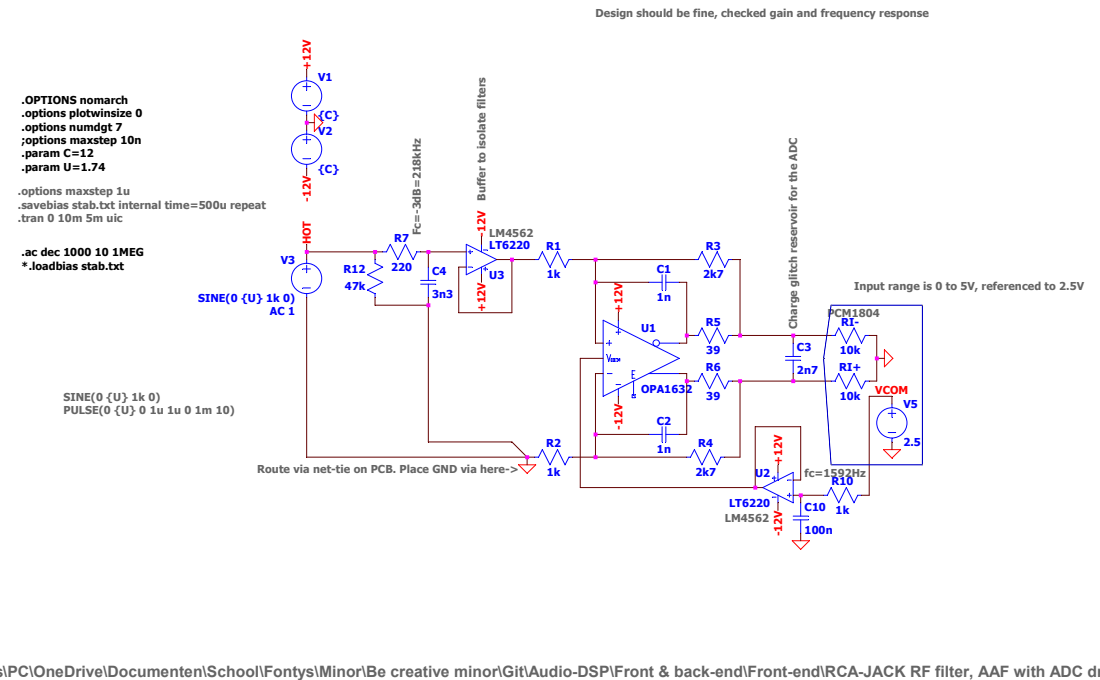
[picture p144: page 1]

Design should be fine, checked gain and frequency response
PCM1804 Charge glitch reservoir for the ADC

Route via net-tie on PCB. Place GND via here-> Buffer to isolate filters

.OPTIONS nomarch
.options plotwinsize 0
.options numdgt 7
;options maxstep 10n
.param C=12
.param U=1.74
.options maxstep 1u
.savebias stab.txt internal time=500u repeat
.tran 0 10m 5m uic

Input range is 0 to 5V, referenced to 2.5V

--- C:\Users\PC\OneDrive\Documenten\School\Fontys\Minor\Be creative minor\Git\Audio-DSP\Front & back-end\Front-end\RCA-JACK RF filter, AAF with ADC driver.asc ---
