HeinVerhallen/Audio-DSP/LTspice/Front-end/XLR RF filter, AAF with ADC driver LTspice schematic.pdf

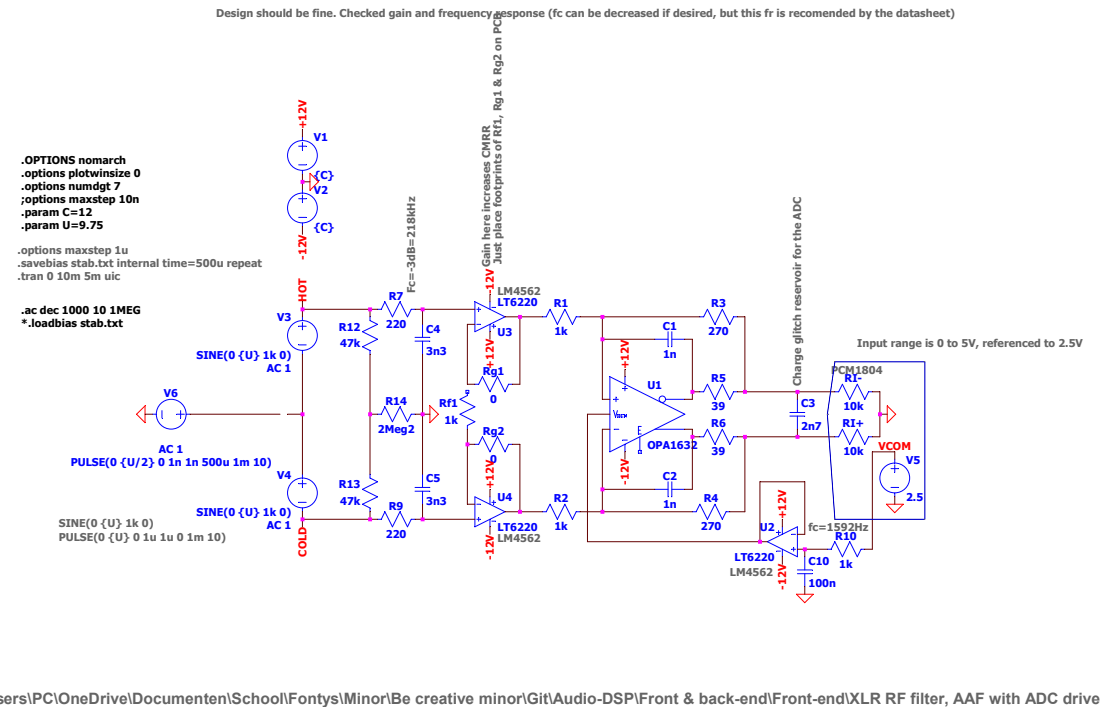
[picture p145: page 1]

Design should be fine. Checked gain and frequency response (fc can be decreased if desired, but this fr is recomended by the datasheet)

Input range is 0 to 5V, referenced to 2.5V Just place footprints of Rf1, Rg1 & Rg2 on PCB

LM4562 Gain here increases CMRR

.OPTIONS nomarch
.options plotwinsize 0
.options numdgt 7
;options maxstep 10n
.param C=12
.param U=9.75
.options maxstep 1u
.savebias stab.txt internal time=500u repeat
.tran 0 10m 5m uic

PCM1804 Charge glitch reservoir for the ADC

--- C:\Users\PC\OneDrive\Documenten\School\Fontys\Minor\Be creative minor\Git\Audio-DSP\Front & back-end\Front-end\XLR RF filter, AAF with ADC driver.asc ---
