HeinVerhallen/Audio-DSP/Documentation/Module Design Document/images/Main_board_schematic.pdf

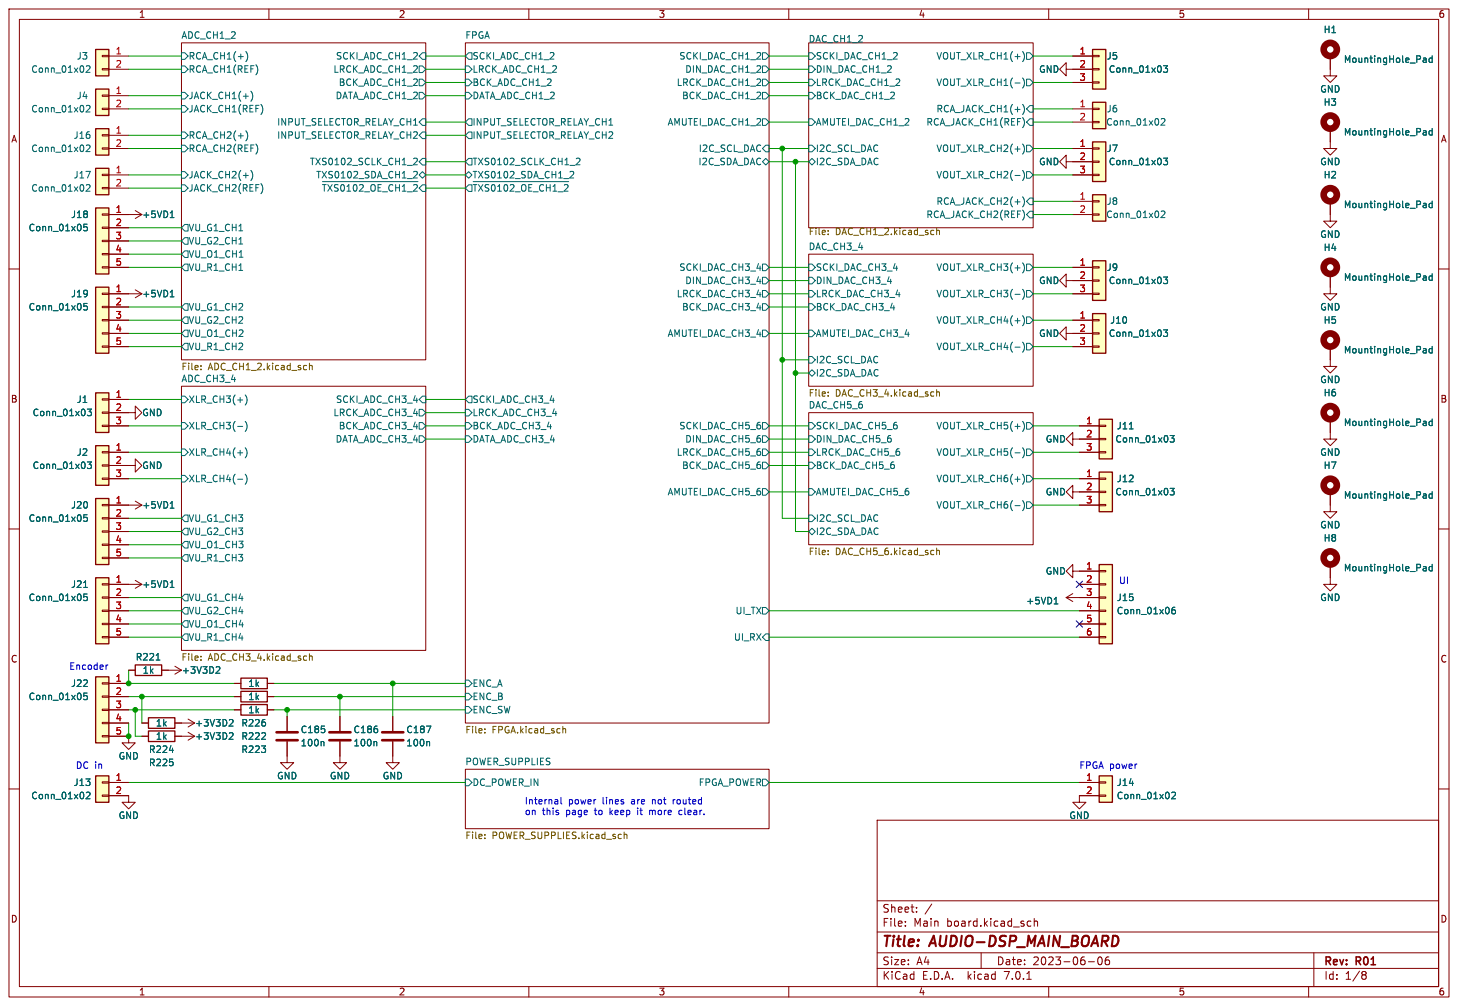
[picture p146: page 1]

H1 MountingHole_Pad GND GND
GND GND
H4 MountingHole_Pad H3 MountingHole_Pad H2 MountingHole_Pad GND GND GND

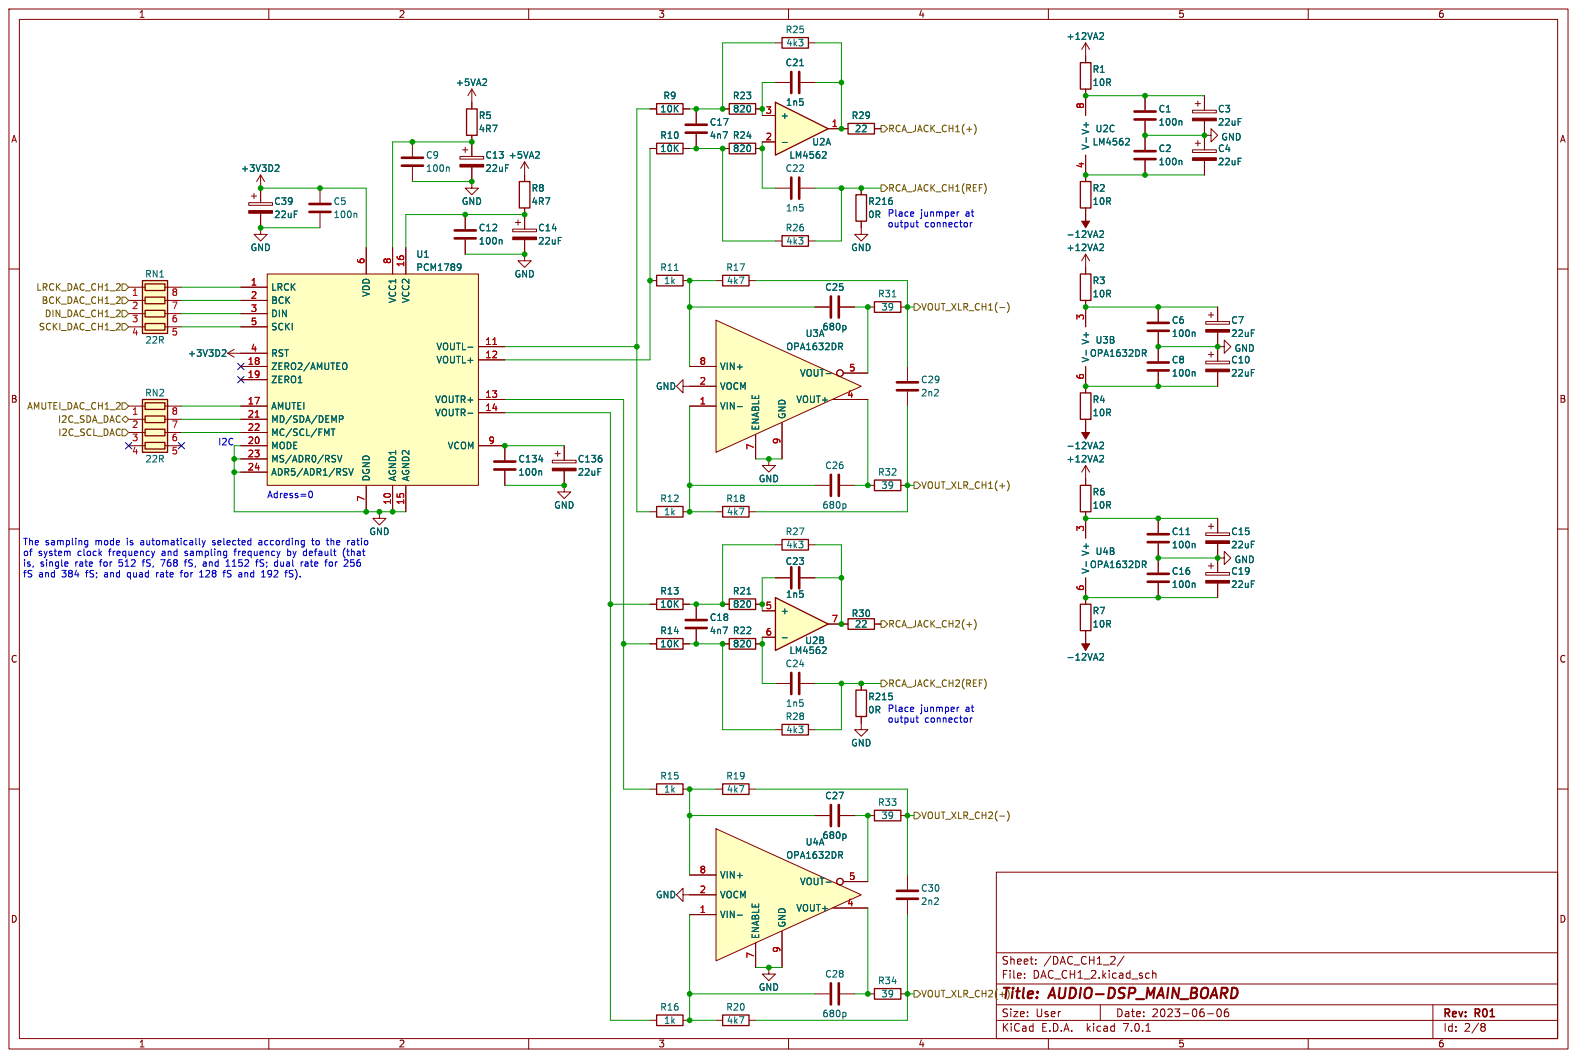
[picture p147: page 2]

is, single rate for 512 fS, 768 fS, and 1152 fS; dual rate for 256

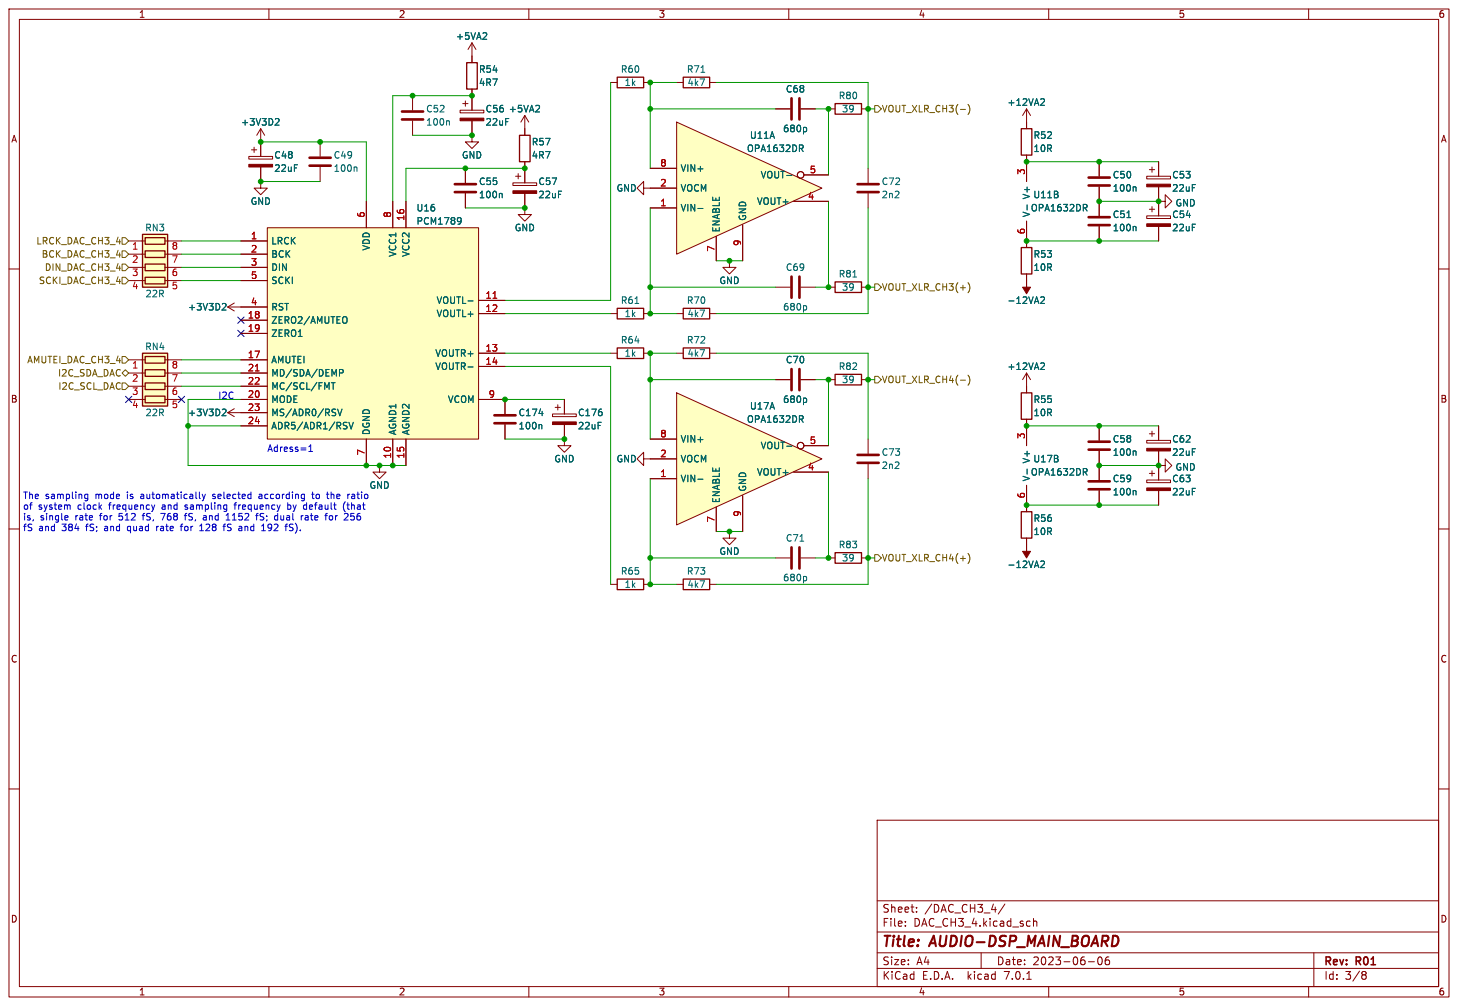
[picture p148: page 3]

fS and 384 fS; and quad rate for 128 fS and 192 fS). Adress=1

is, single rate for 512 fS, 768 fS, and 1152 fS; dual rate for 256


is, single rate for 512 fS, 768 fS, and 1152 fS; dual rate for 256

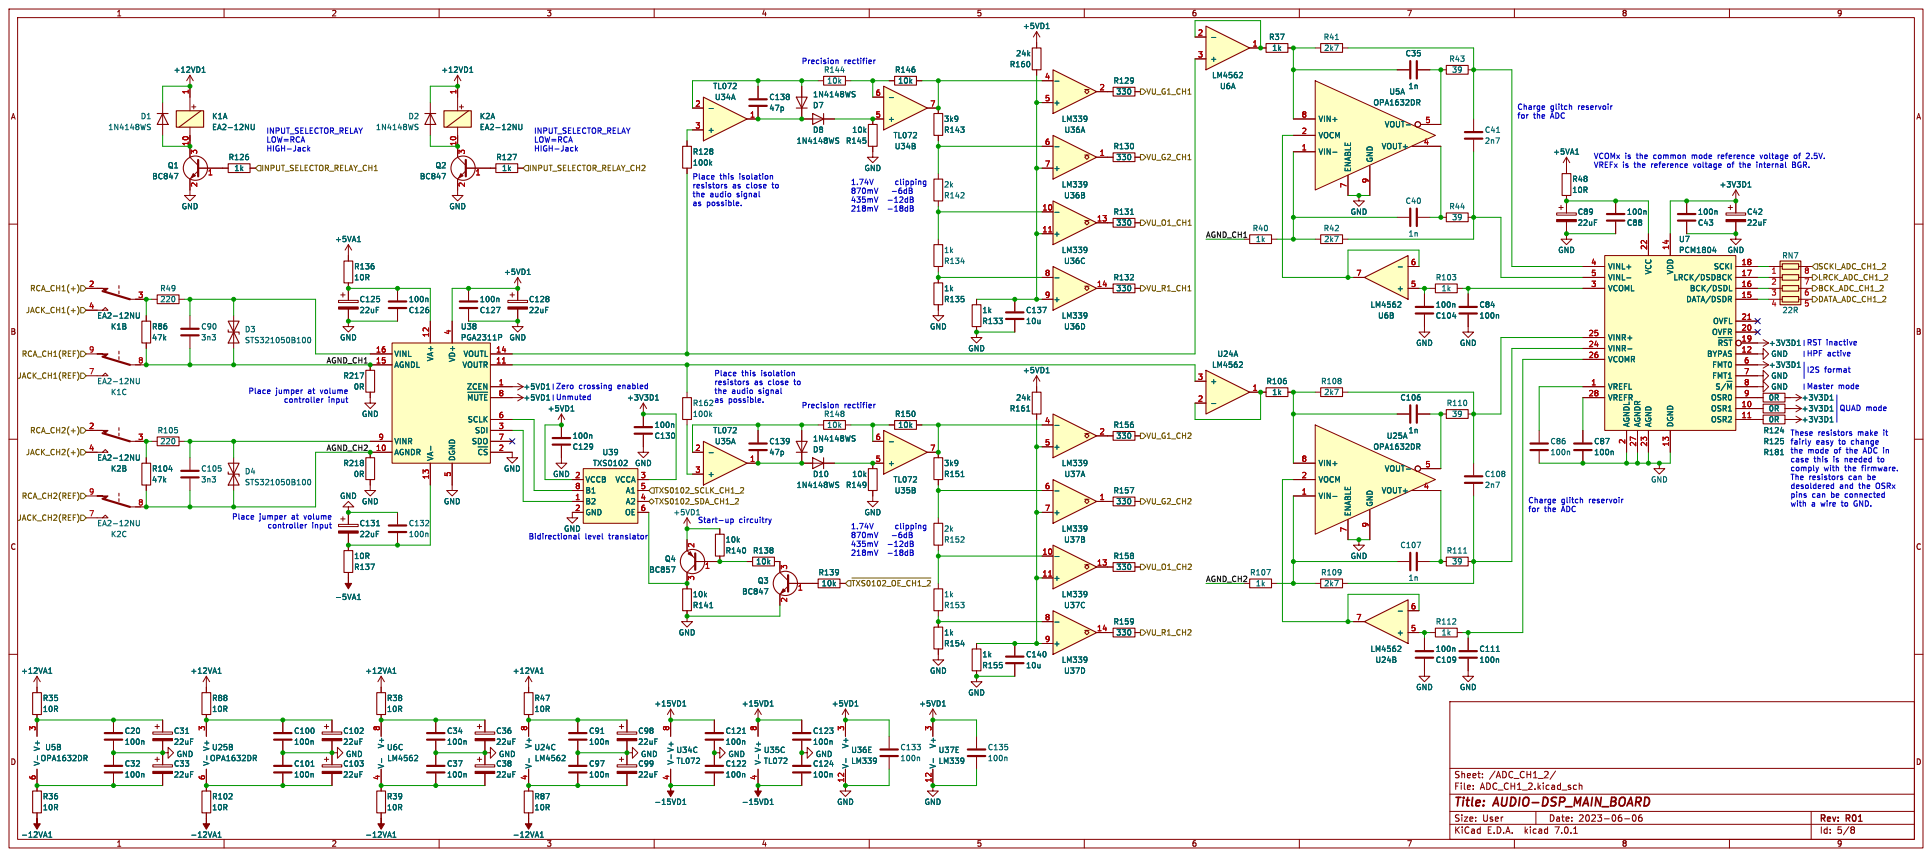
[picture p149: page 5]

INPUT_SELECTOR_RELAY
LOW=RCA HIGH-Jack

5 SCLK 6 SDO 7 ~{MUTE}8 VINR 9 U38 PGA2311P R218

HPF active RST inactive

I2S format Place jumper at volume

Place this isolation
the audio signal as possible.

5 SCLK 6 SDO 7 ~{MUTE}8 VINR 9 R218

fairly easy to change
the mode of the ADC in
case this is needed to

Place jumper at volume


the audio signal as possible.

I2S format Master mode Can be populated

2 OVFR 20 OVFL 21 VCC 22 AGND 23 VINR- 24 VINR+ 25 VCOMR 26 AGNDR 27 VREFR 28 VCOML 3 VINL+ 4 VINL- 5 FMT0 6 FMT1 7 S/~{M} 8 OSR0 9 C154

2 OVFR 20 OVFL 21 VCC 22 AGND 23 VINR- 24 VINR+ 25 VCOMR 26 AGNDR 27 VREFR 28 VCOML 3 VINL+ 4 VINL- 5 FMT0 6 FMT1 7 S/~{M} 8 OSR0 9 U44 PCM1804 GND

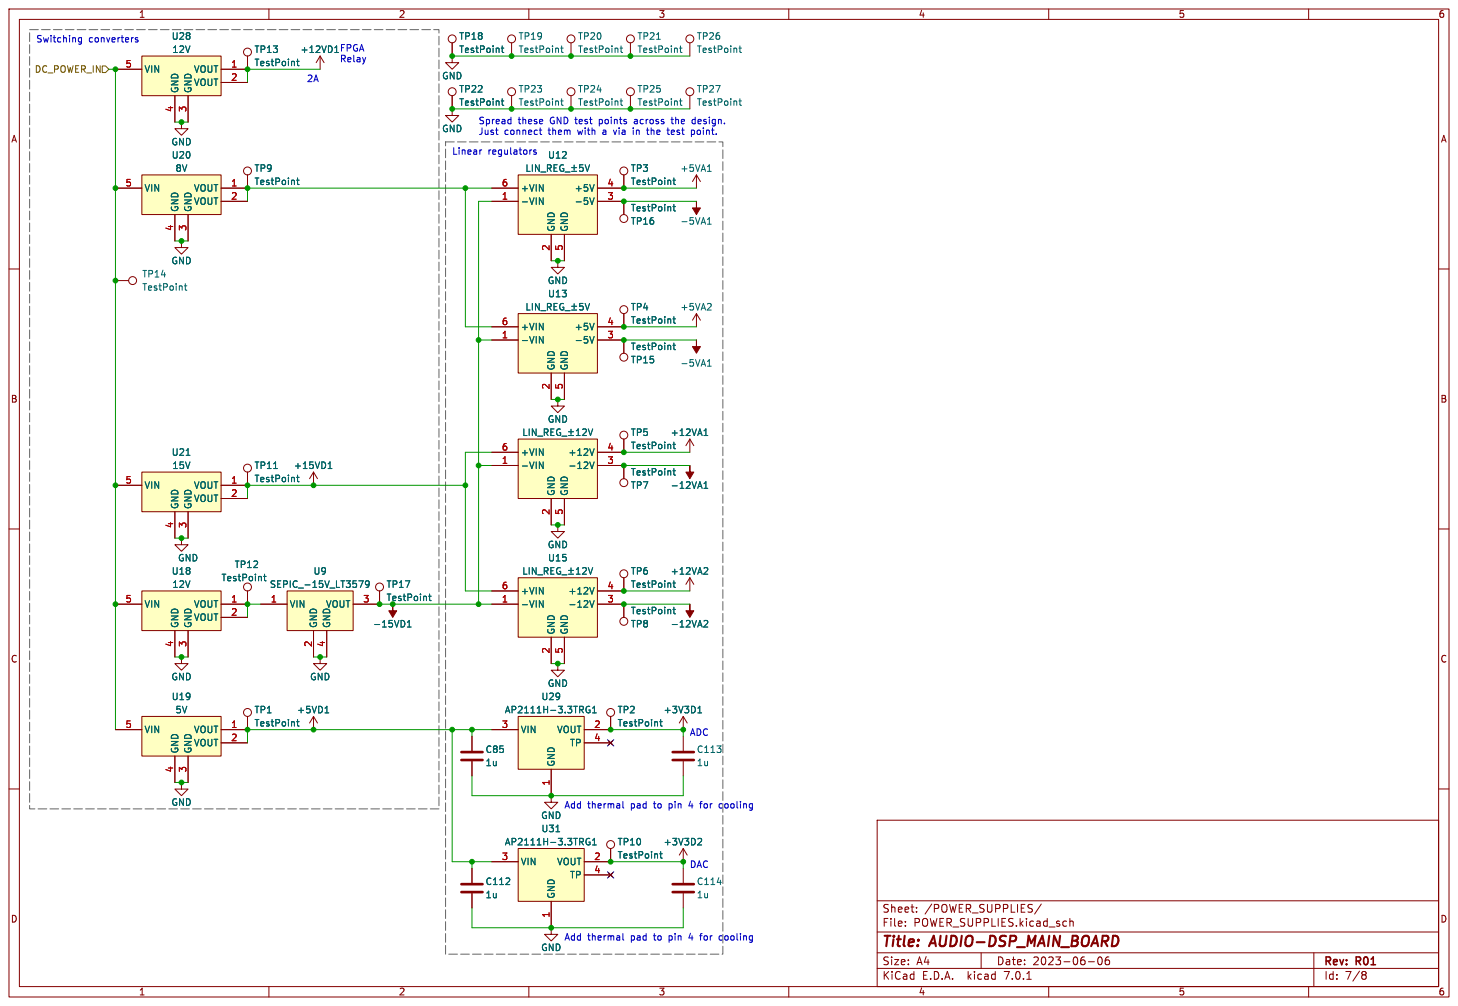
[picture p150: page 7]

TP19 TestPoint TP18 TestPoint TP22 TestPoint GND
-5VA1 +12VA1 GND GND
TP5 TestPoint TP8 TestPoint TP7 TestPoint GND

TP3 TestPoint TP16 TestPoint TP18 TestPoint TP22 TestPoint

Spread these GND test points across the design. Just connect them with a via in the test point.

Add thermal pad to pin 4 for cooling Add thermal pad to pin 4 for cooling DAC

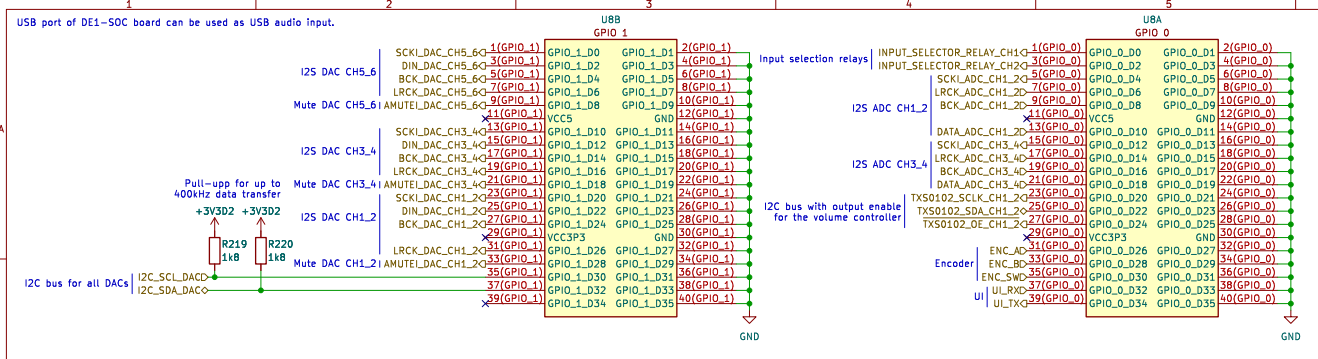
[picture p151: page 8]

I2S DAC CH3_4 USB port of DE1-SOC board can be used as USB audio input.

I2C bus with output enable
for the volume controller

I2C bus for all DACs
