HeinVerhallen/Audio-DSP/Block diagrams/Functional decomposition.pdf

DSP

Power supplys | IO | Core

Power supplys

Core

Crossover | Equalizer | Effects

Power from mains
power supply | Local power supplys

Power from mains
power supply | Local power supplys

IO

UI

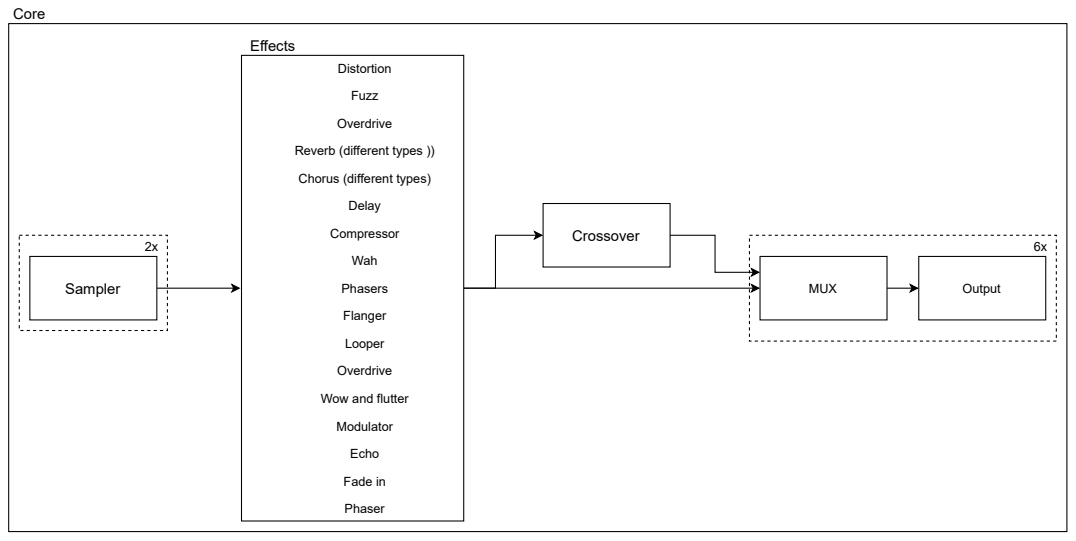
[picture p152: page 2]
Core; Sampler; Distortion; Fuzz; Overdrive; Delay; Compressor Wah; Phasers; Flanger; Looper; Modulator; Echo; Fade in; Phaser; Crossover; Effects; MUX; Output

Reverb (different types ))

Chorus (different types)

Wow and flutter
