HeinVerhallen/Audio-DSP/Block diagrams/System context diagram.pdf

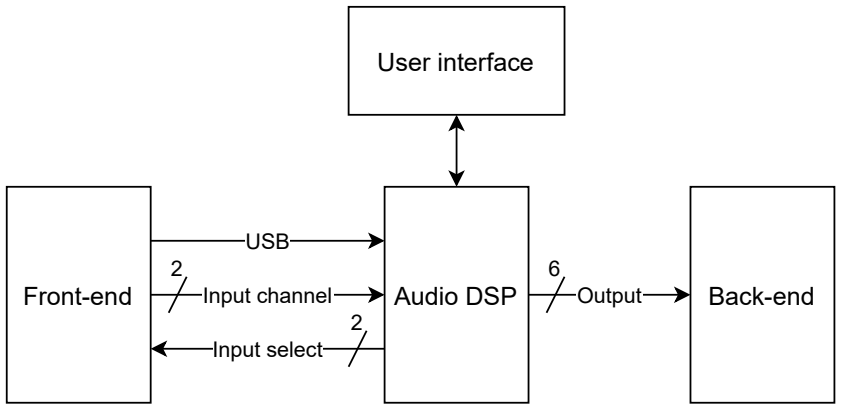
[picture p153: figure]
Input select; Audio DSP; Output; USB; Front-end; Input channel; Back-end; User interface

## Front-end

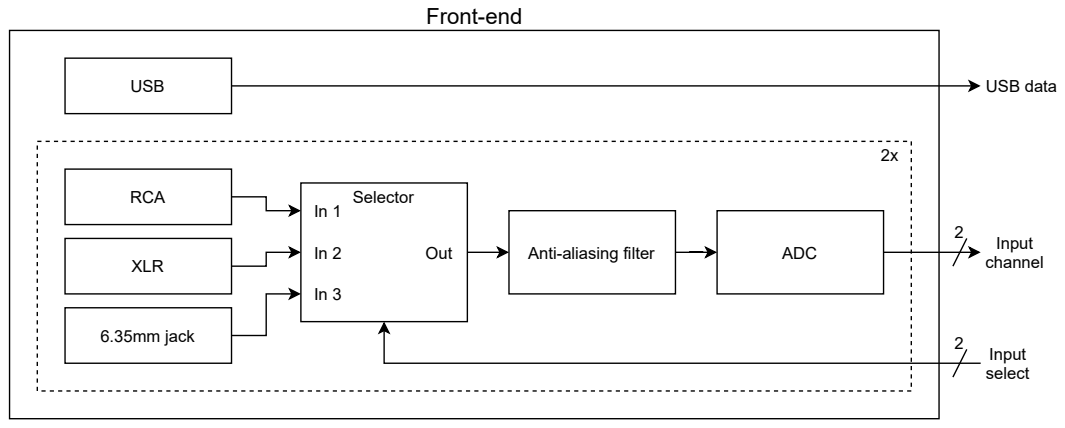
[picture p154: page 2]
Anti-aliasing filter; ADC; RCA; XLR; USB; 6.35mm jack; USB data; Input channel; Out; Selector; Input select

## Back-end

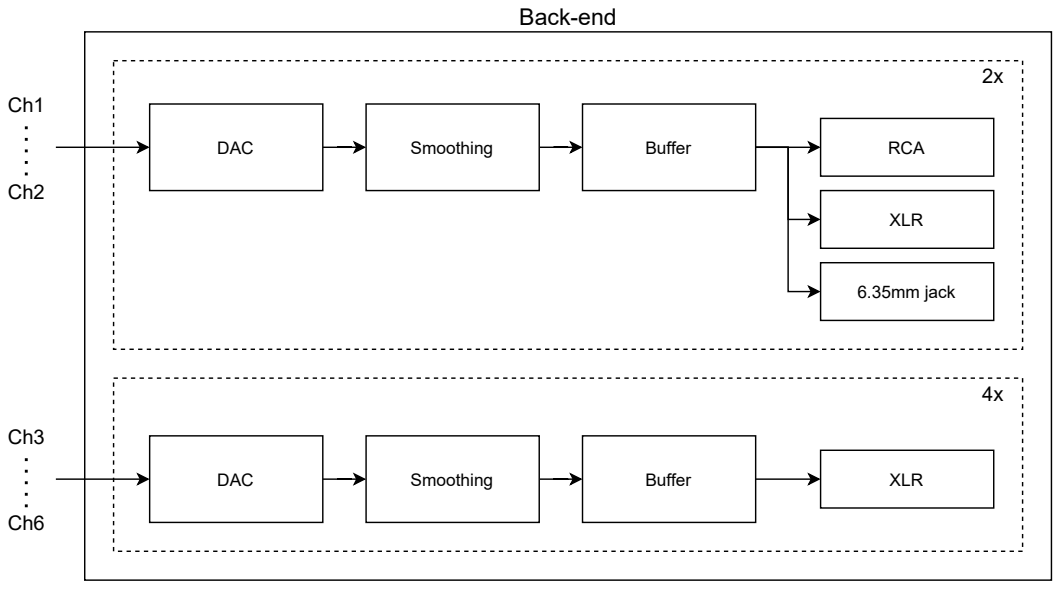
[picture p155: page 3]
DAC; Smoothing; Buffer; RCA; XLR; 6.35mm jack

## Audio DSP

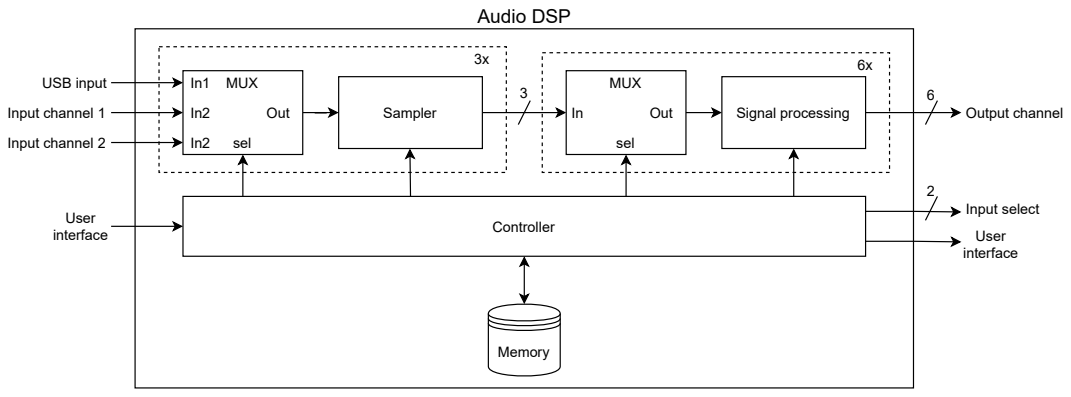
[picture p156: page 4]
In1 MUX; Out; Sampler; Controller; Input select; sel; User; interface; USB input; Input channel 1; Signal processing; Memory; Input channel 2; MUX; Output channel

## Signal processor

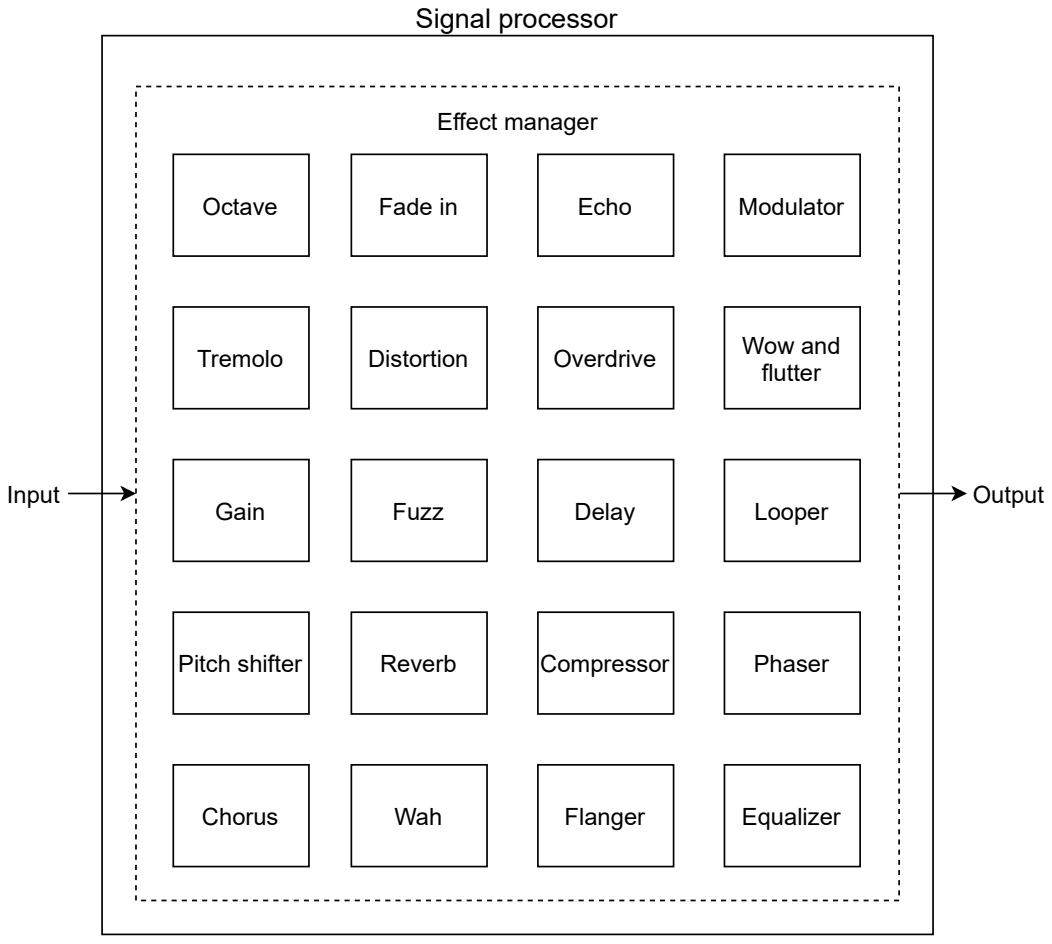
[picture p157: page 5]
Delay; Distortion; Fuzz; Reverb; Chorus; Compressor; Wah; Phaser; Flanger; Looper; Overdrive; Wow and; flutter; Fade in; Echo; Modulator; Tremolo; Octave; Gain; Pitch shifter; Effect manager; Input; Output; Equalizer
