HeinVerhallen/Audio-DSP/KiCAD/-15V SEPIC/-15V_SEPIC_schematic.pdf

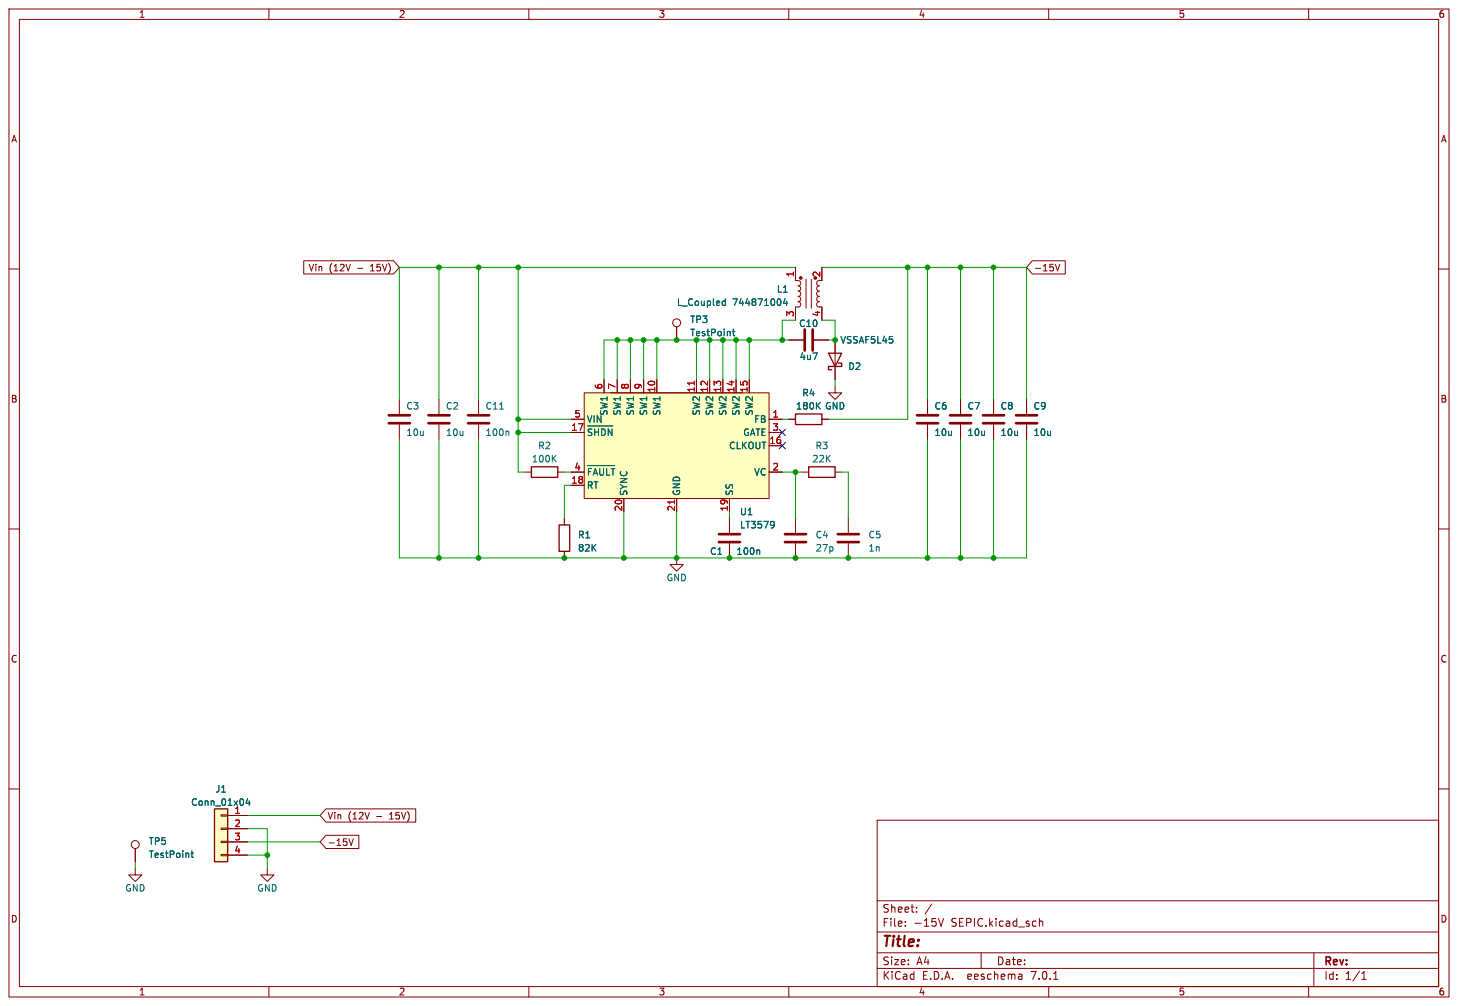
[picture p158: page 1]
