HeinVerhallen/Audio-DSP/KiCAD/Ordered from JLCPCB 31-05-2023/(1)PayPal invoice.pdf

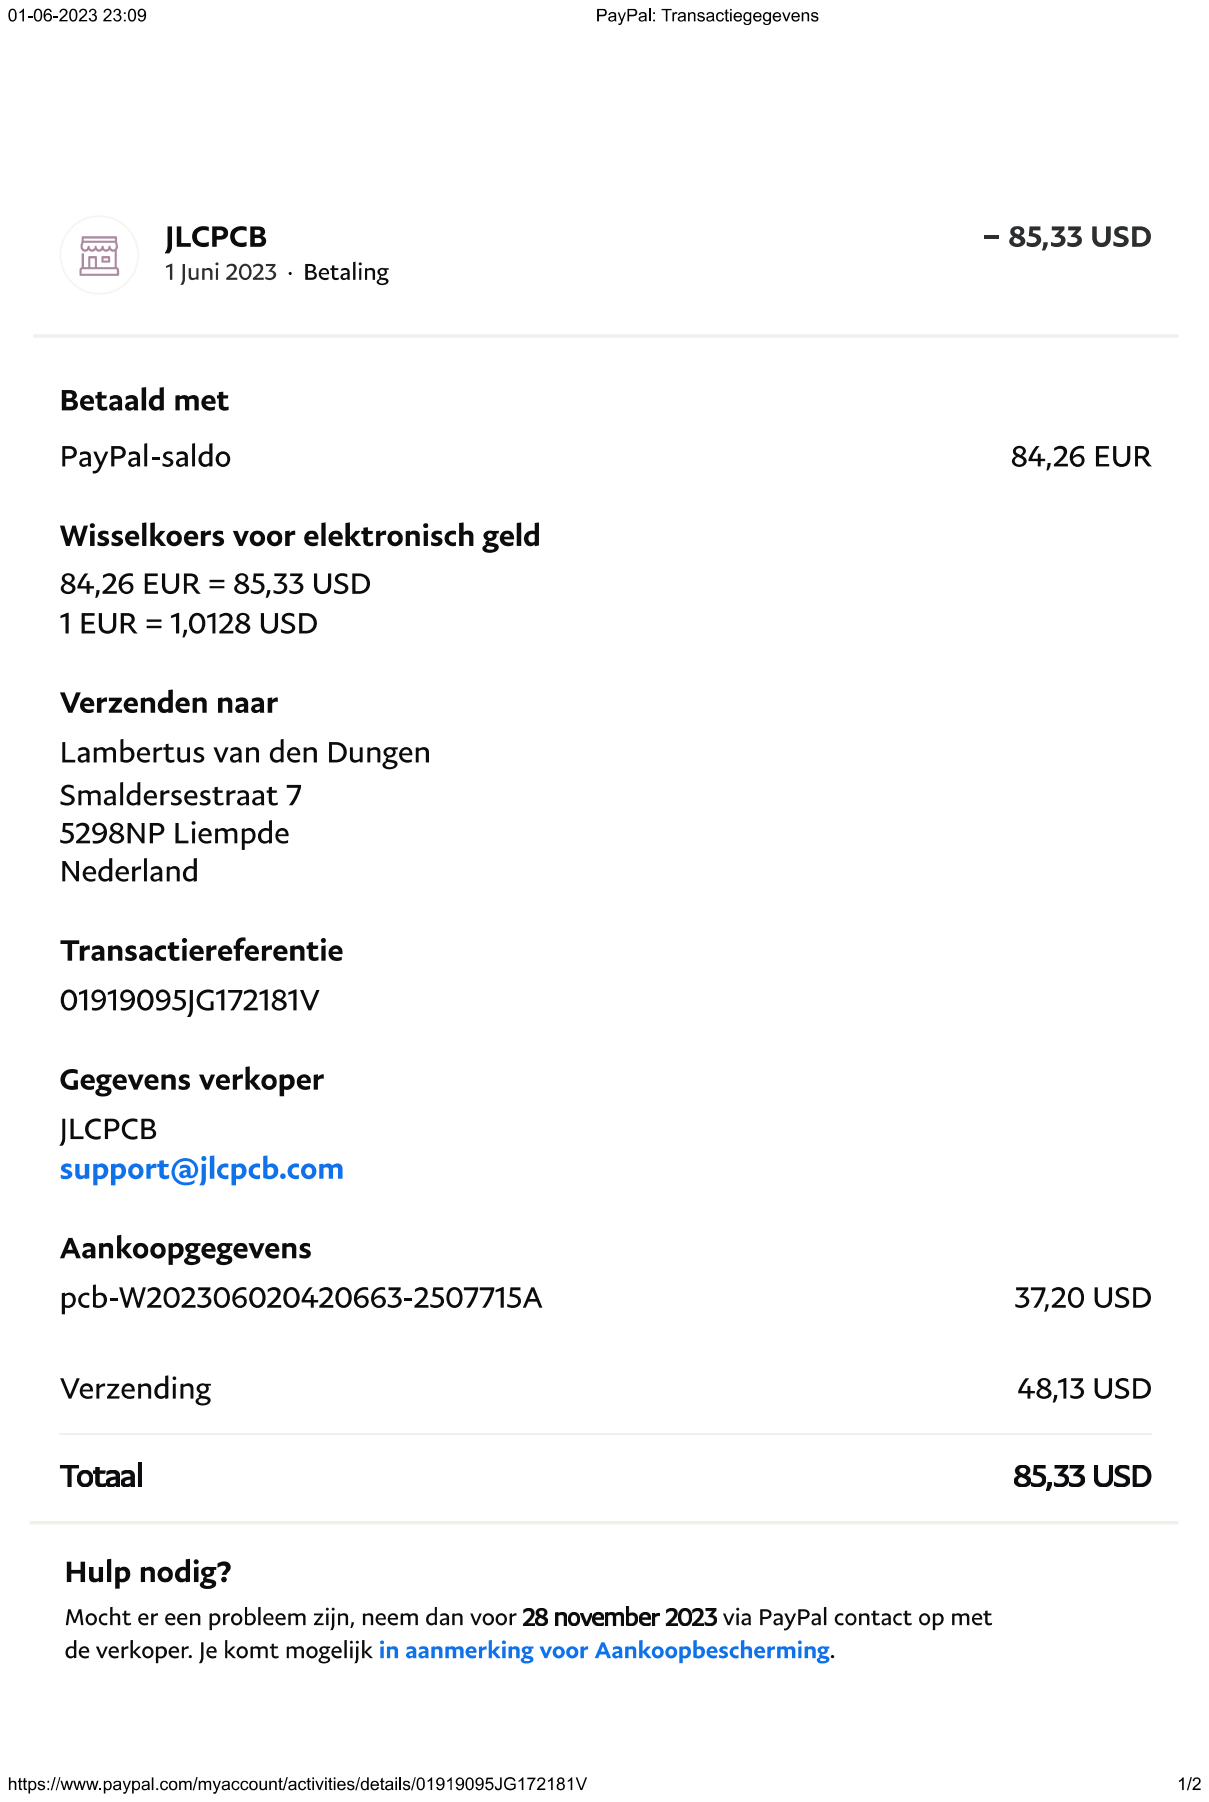
[picture p159: page 1]

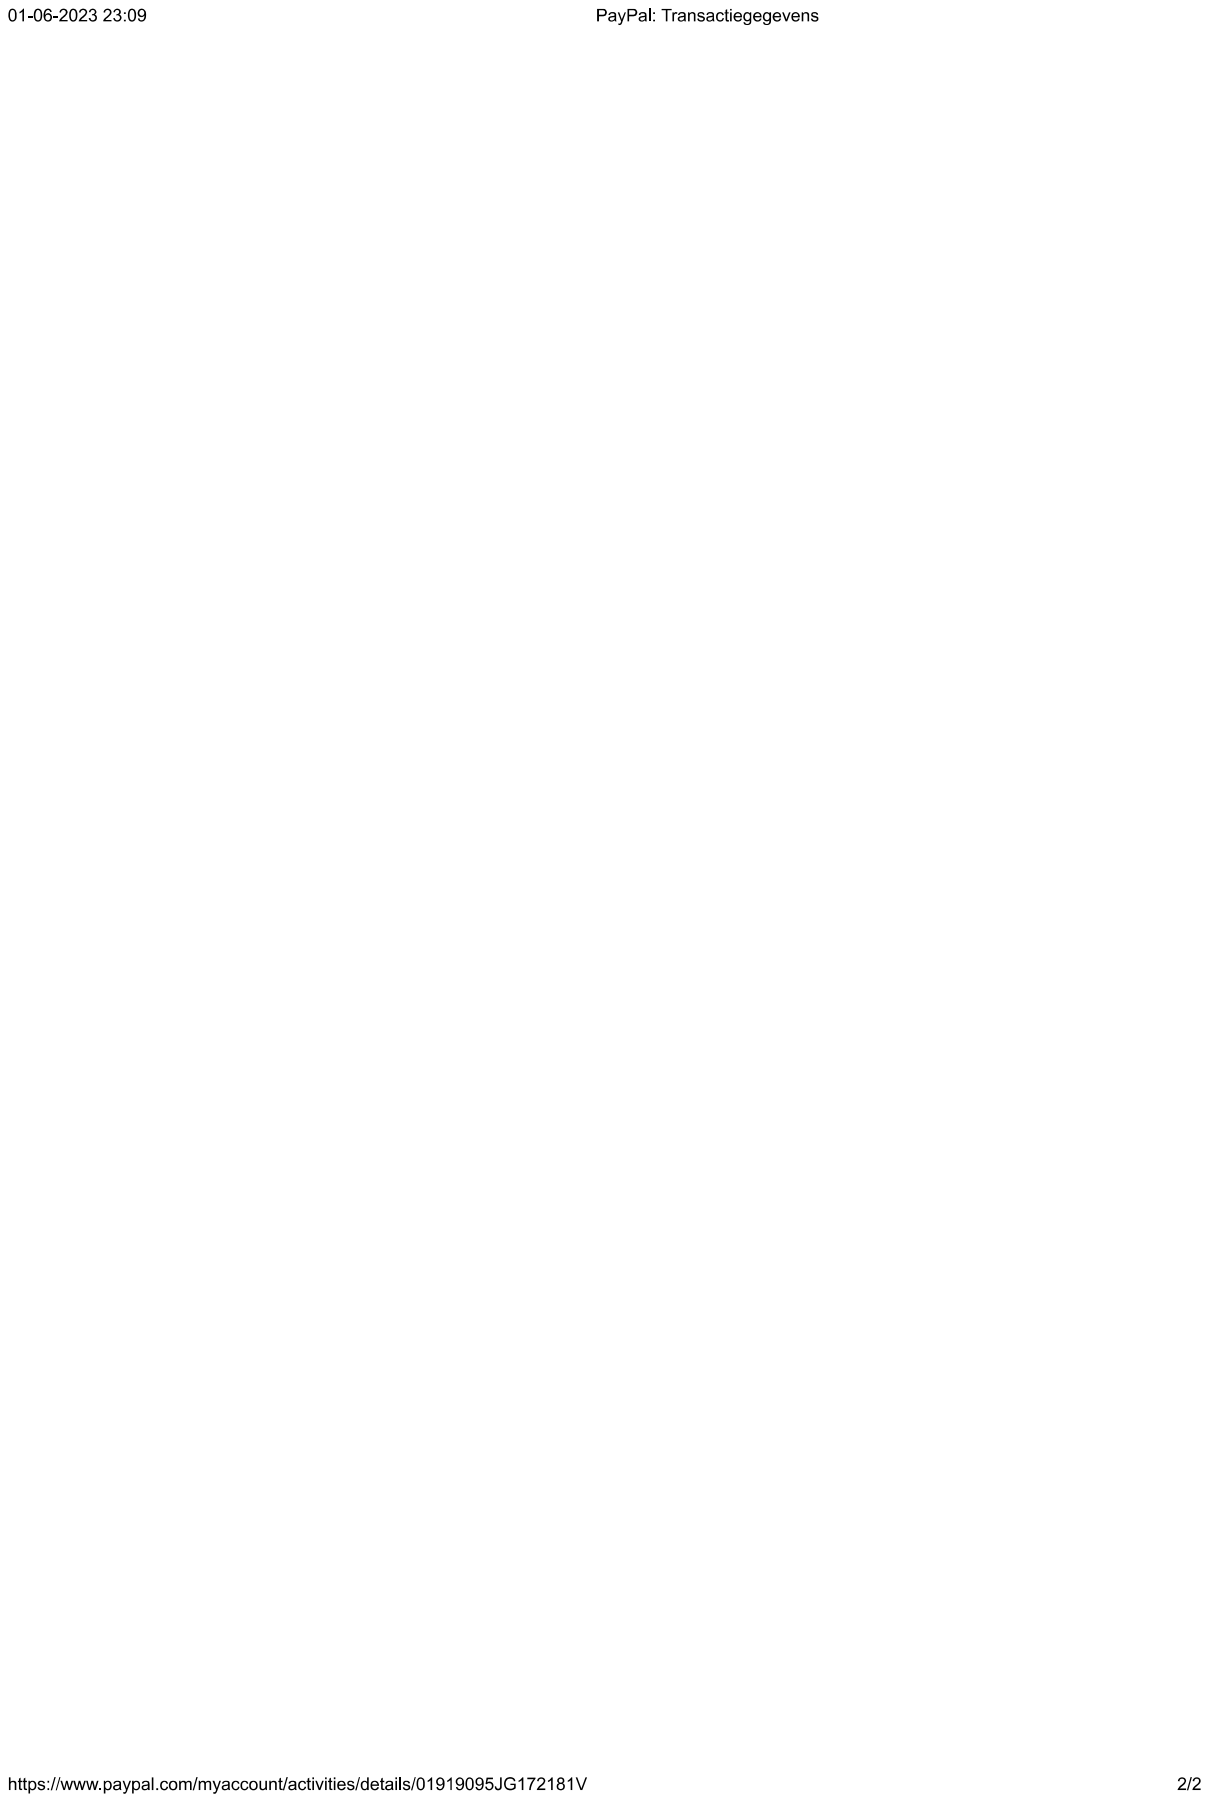
[picture p160: page 2]
