HeinVerhallen/Audio-DSP/Firmware/Audio_sampler/Audio_sampler_result_32bit_works_24bits_notworking.pdf

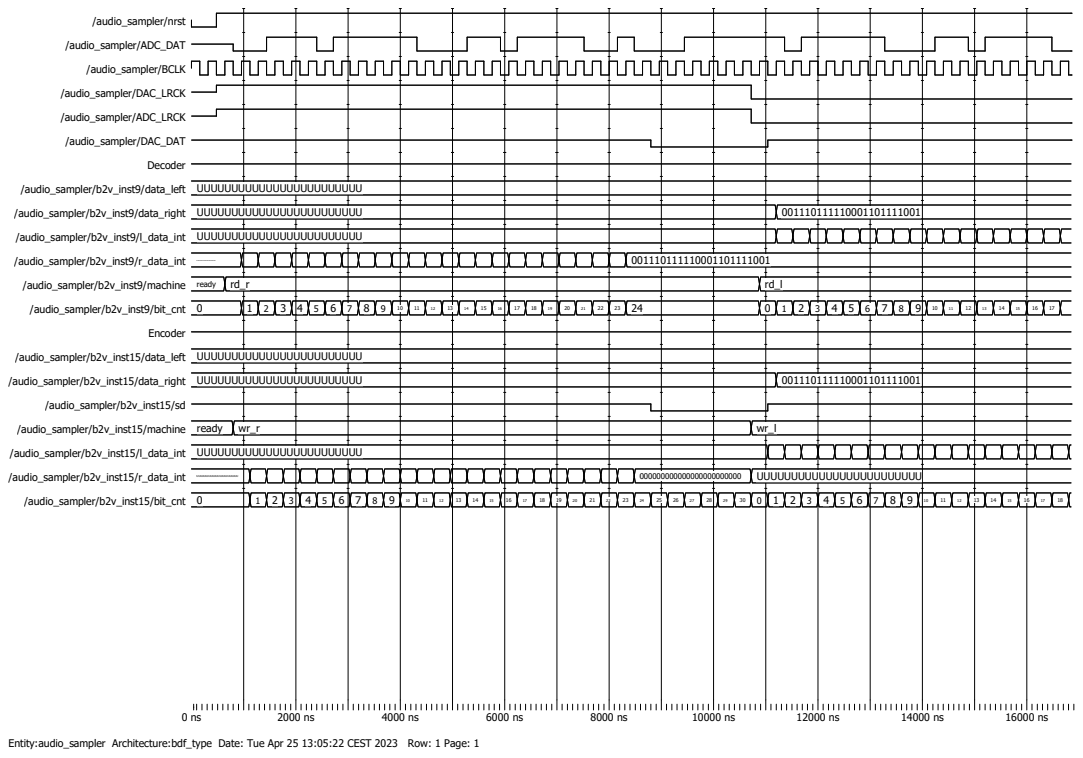
[picture p161: page 1]
Decoder; UUUUUUUUUUUUUUUUUUUUUUUU; ready; Encoder; /audio_sampler/nrst; /audio_sampler/ADC_DAT; /audio_sampler/BCLK; /audio_sampler/DAC_LRCK; /audio_sampler/ADC_LRCK; /audio_sampler/DAC_DAT; /audio_sampler/b2v_inst9/data_left UUUUUUUUUUUUUUUUUUUUUUUU; /audio_sampler/b2v_inst9/data_right UUUUUUUUUUUUUUUUUUUUUUUU; /audio_sampler/b2v_inst9/l_data_int UUUUUUUUUUUUUUUUUUUUUUUU; /audio_sampler/b2v_inst9/r_data_int UUUUUUUUUUUUUUUUUUUUUUUU; /audio_sampler/b2v_inst9/machine ready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

Entity:audio_sampler Architecture:bdf_type Date: Tue Apr 25 13:05:22 CEST 2023 Row: 1 Page: 1
