HeinVerhallen/Audio-DSP/Firmware/Audio_sampler/Audio_sampler_result_v2.pdf

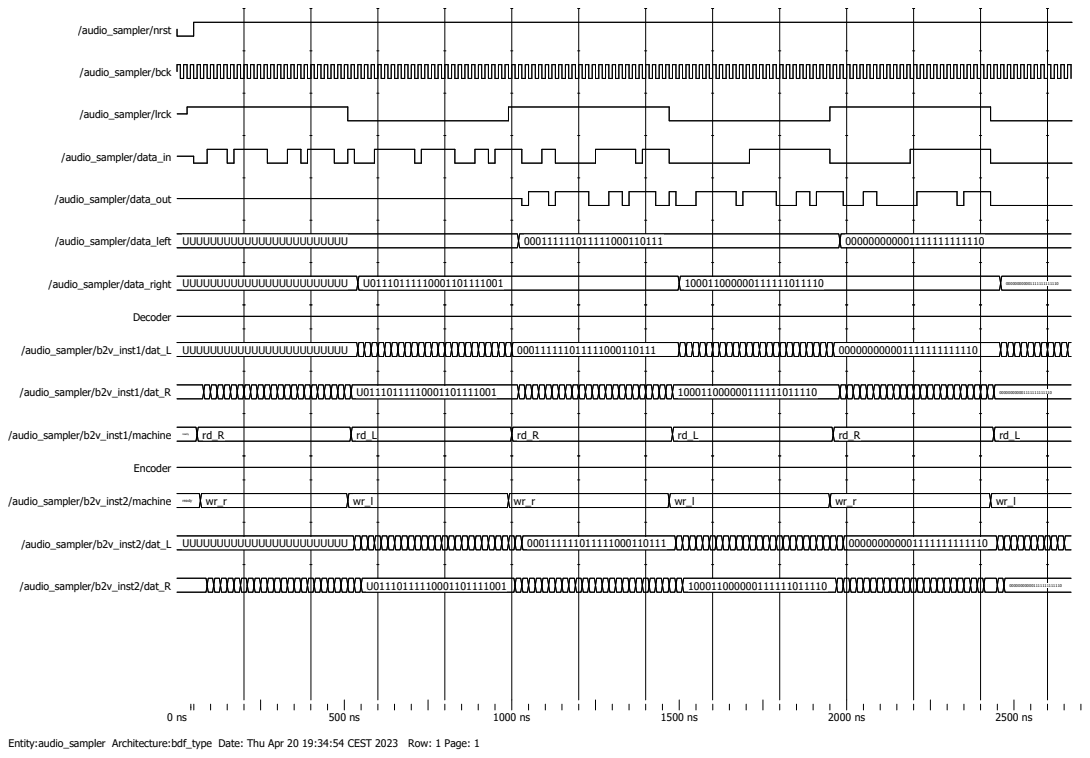
[picture p162: page 1]
UUUUUUUUUUUUUUUUUUUUUUUU; Decoder; ready; Encoder; /audio_sampler/nrst; /audio_sampler/bck; /audio_sampler/lrck; /audio_sampler/data_in; /audio_sampler/data_out; /audio_sampler/data_left UUUUUUUUUUUUUUUUUUUUUUUU; /audio_sampler/data_right UUUUUUUUUUUUUUUUUUUUUUUU; /audio_sampler/b2v_inst1/dat_L UUUUUUUUUUUUUUUUUUUUUUUU; /audio_sampler/b2v_inst1/dat_R; /audio_sampler/b2v_inst1/machine ready; /audio_sampler/b2v_inst2/machine ready; /audio_sampler/b2v_inst2/dat_L UUUUUUUUUUUUUUUUUUUUUUUU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

Entity:audio_sampler Architecture:bdf_type Date: Thu Apr 20 19:34:54 CEST 2023 Row: 1 Page: 1
