HeinVerhallen/Audio-DSP/Firmware/Test_FPGA_routing/Result_Test_FPGA_routing_const_order.pdf

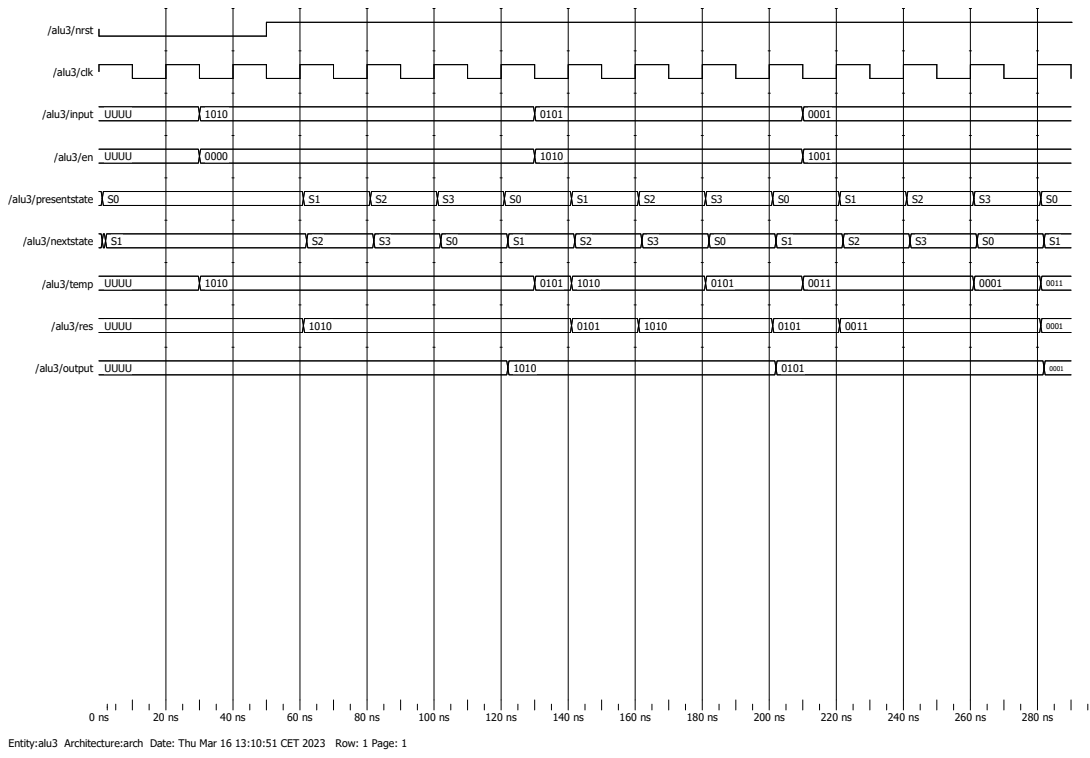
[picture p163: page 1]
UUUU; /alu3/nrst; /alu3/clk; /alu3/input UUUU; /alu3/en UUUU; /alu3/presentstate S0; /alu3/nextstate; /alu3/temp UUUU; /alu3/res UUUU; /alu3/output UUUU

Entity:alu3 Architecture:arch Date: Thu Mar 16 13:10:51 CET 2023 Row: 1 Page: 1
