HeinVerhallen/Audio-DSP/Firmware/Test_FPGA_routing/Result_Test_FPGA_routing_variable_order.pdf

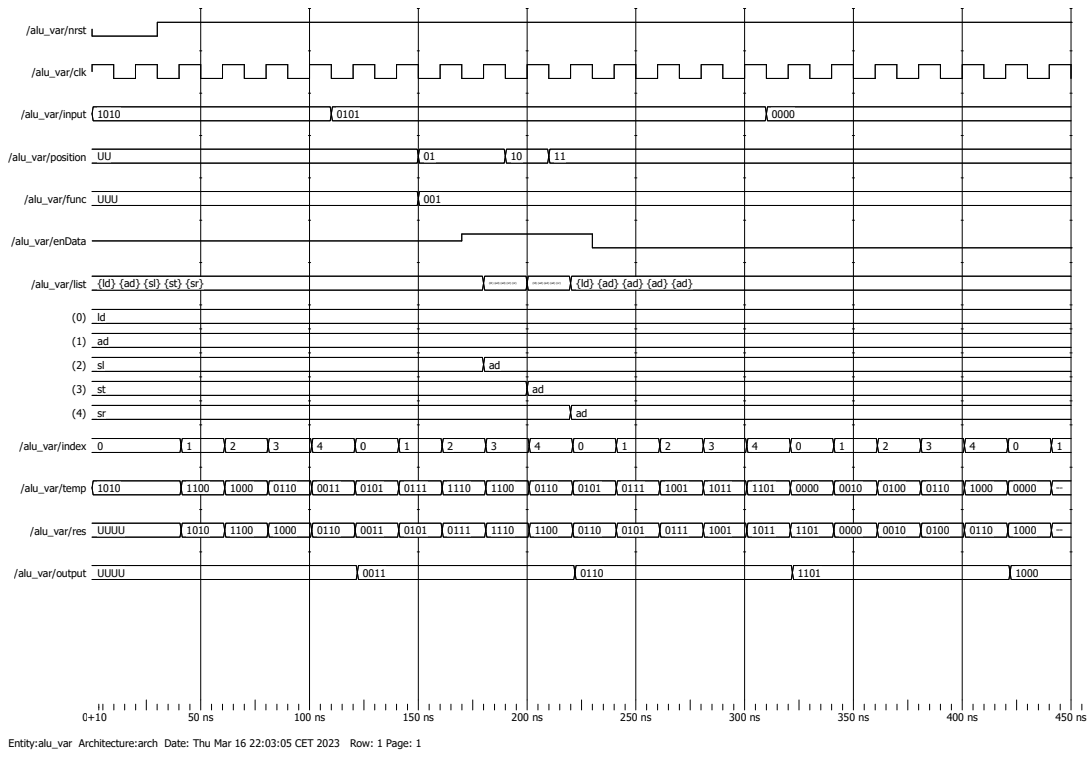
[picture p164: page 1]
UUU; UUUU; /alu_var/nrst; /alu_var/clk; /alu_var/input 1010; /alu_var/position UU; /alu_var/func UUU; /alu_var/enData; /alu_var/list {ld} {ad} {sl} {st} {sr}; /alu_var/index 0; /alu_var/temp 1010; /alu_var/res UUUU; /alu_var/output UUUU

Entity:alu_var Architecture:arch Date: Thu Mar 16 22:03:05 CET 2023 Row: 1 Page: 1
