HeinVerhallen/Audio-DSP/Firmware/Audio_sampler/Audio_sampler_decoder+encoder_including_availPulse.pdf

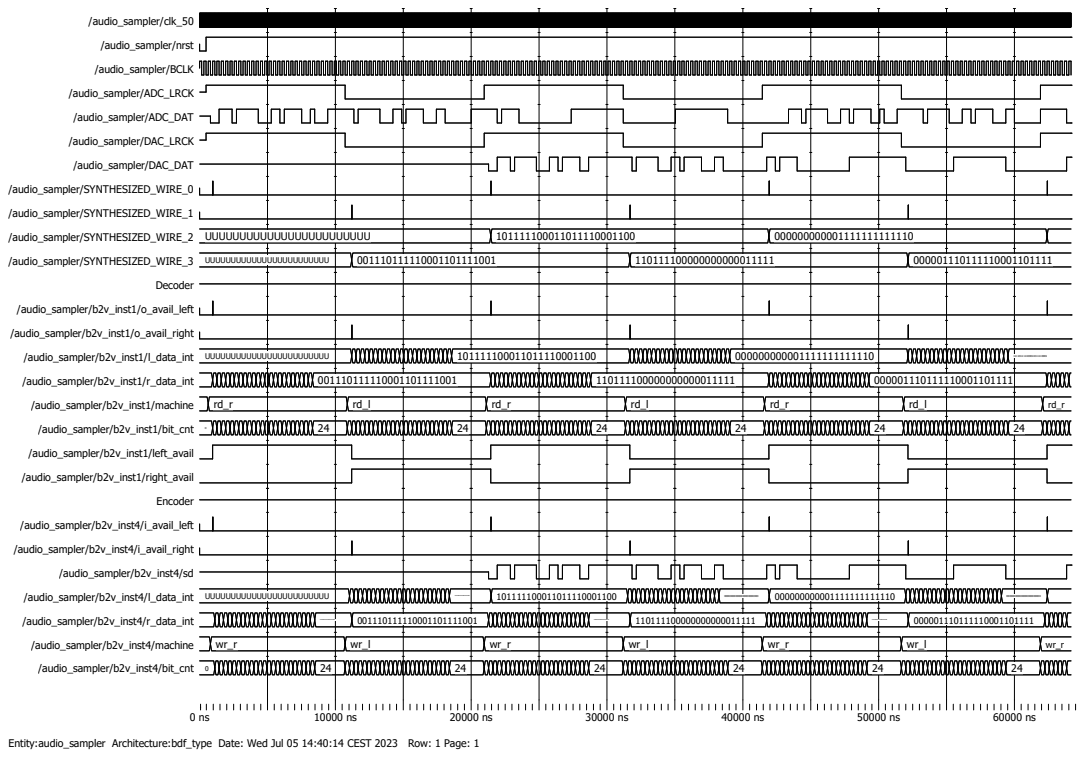
[picture p165: page 1]
UUUUUUUUUUUUUUUUUUUUUUUU; Decoder; Encoder; /audio_sampler/clk_50; /audio_sampler/nrst; /audio_sampler/BCLK; /audio_sampler/ADC_LRCK; /audio_sampler/ADC_DAT; /audio_sampler/DAC_LRCK; /audio_sampler/DAC_DAT; /audio_sampler/SYNTHESIZED_WIRE_0; /audio_sampler/SYNTHESIZED_WIRE_1; /audio_sampler/SYNTHESIZED_WIRE_2 UUUUUUUUUUUUUUUUUUUUUUUU; /audio_sampler/SYNTHESIZED_WIRE_3 UUUUUUUUUUUUUUUUUUUUUUUU; /audio_sampler/b2v_inst1/o_avail_left; /audio_sampler/b2v_inst1/o_avail_right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

Entity:audio_sampler Architecture:bdf_type Date: Wed Jul 05 14:40:14 CEST 2023 Row: 1 Page: 1
