HeinVerhallen/Audio-DSP/Firmware/Audio_sampler/Audio_sampler_decoder+encoder_including_availPulse_v2.pdf

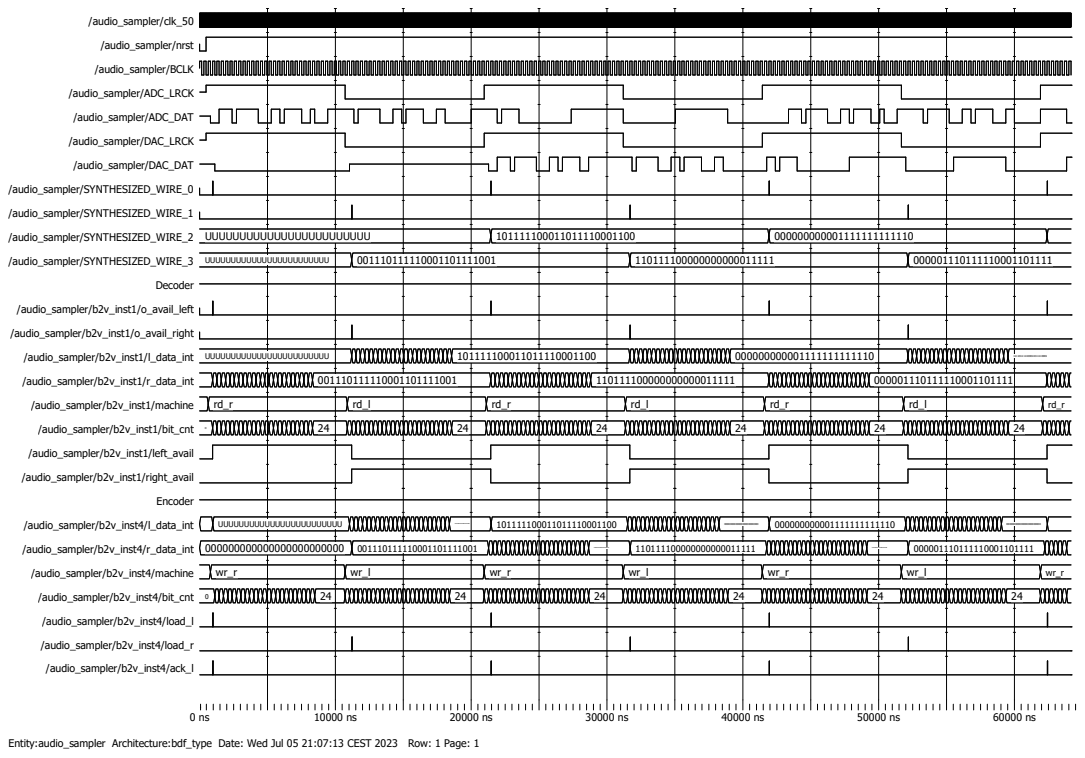
[picture p166: page 1]
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

Entity:audio_sampler Architecture:bdf_type Date: Wed Jul 05 21:07:13 CEST 2023 Row: 1 Page: 1

0 ns | 10000 ns | 20000 ns | 30000 ns | 40000 ns | 50000 ns | 60000 ns

/audio_sampler/b2v_inst4/ack_r

Entity:audio_sampler Architecture:bdf_type Date: Wed Jul 05 21:07:13 CEST 2023 Row: 1 Page: 2
