HeinVerhallen/Audio-DSP/KiCAD/Main board/Drill stencil.pdf

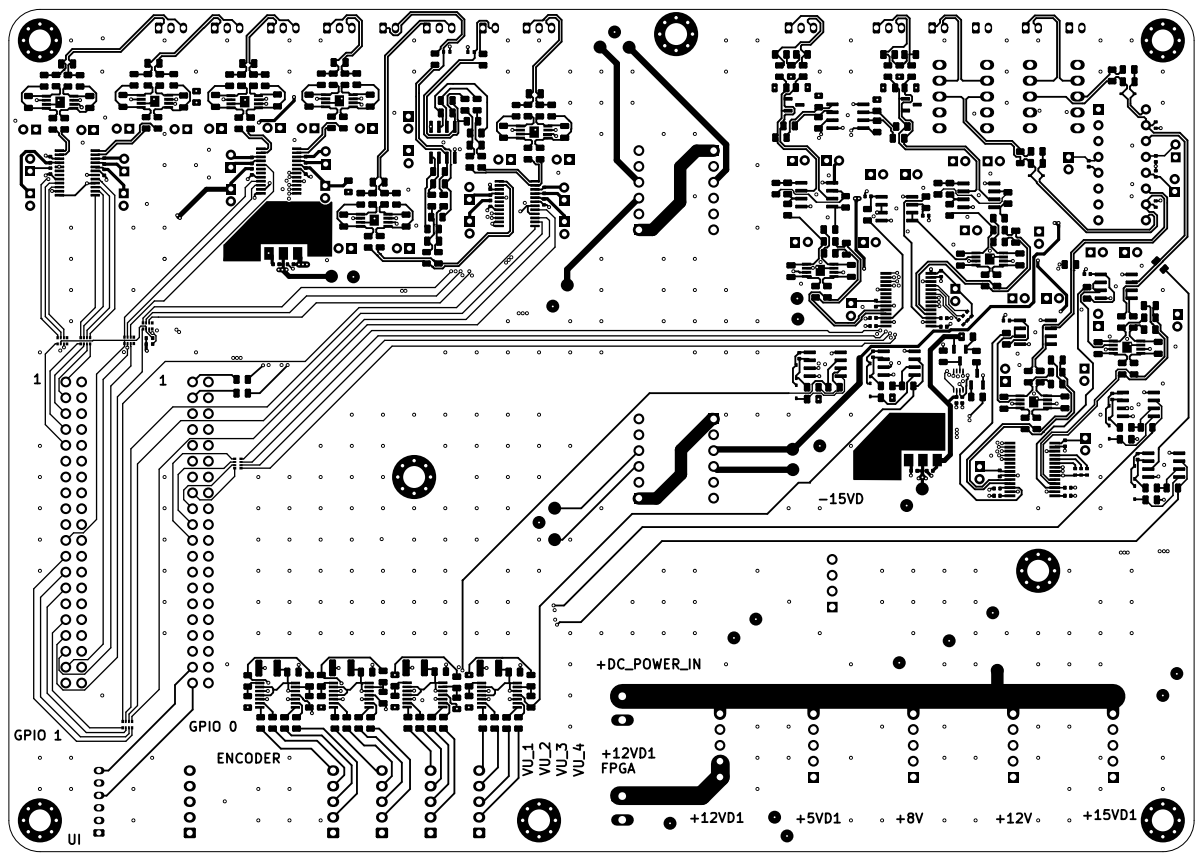
[picture p167: page 1]
