HeinVerhallen/Audio-DSP/LTspice/Front-end/VU-meter simulation.pdf

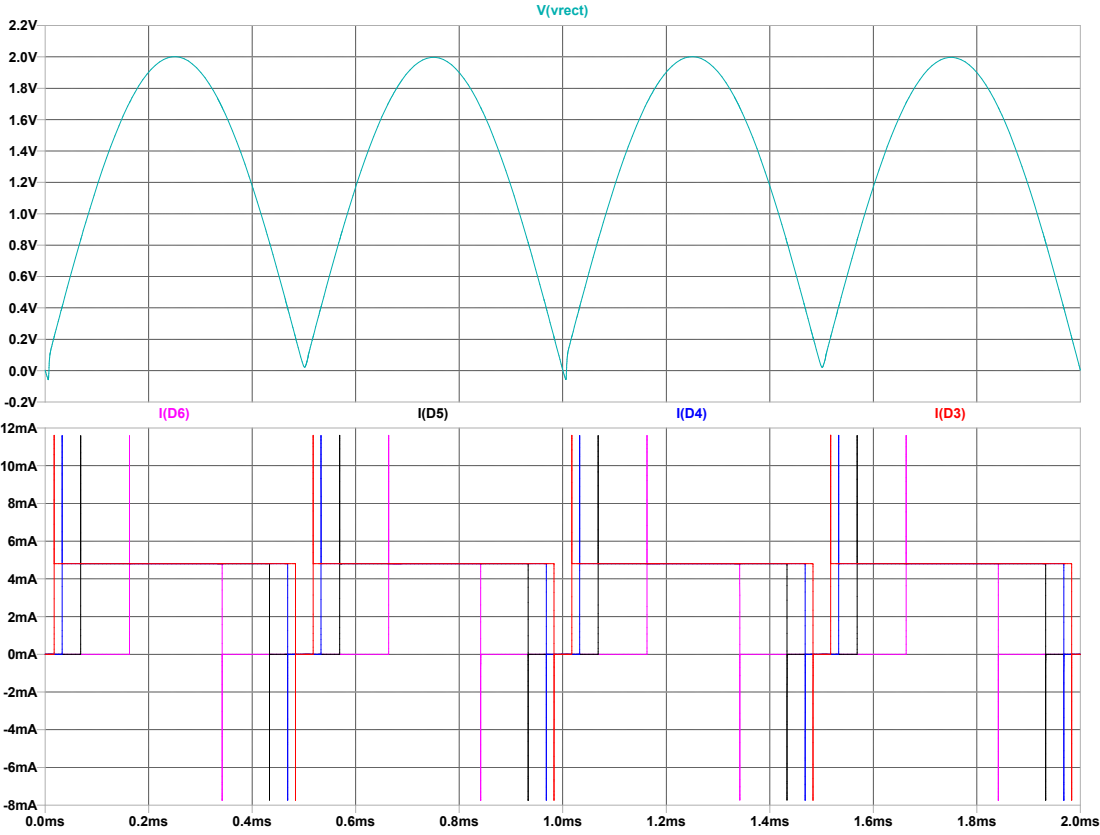
[picture p168: page 1]
V(vrect)

--- C:\Users\robin\OneDrive\Documenten\School\Fontys\Minor\Be creative minor\Git\Audio-DSP\LTspice\Front-end\VU-meter.raw ---
