HeinVerhallen/Audio-DSP/LTspice/Front-end/Sub-designs/Frontend without AAF.asc

C3: cap; 3n3
C8: cap; 3n3
R1: EuropeanResistor; 220
R3: EuropeanResistor; 1k
R4: EuropeanResistor; 1k
R5: EuropeanResistor; 47k
R6: EuropeanResistor; 2Meg2
R7: EuropeanResistor; 47k
R8: EuropeanResistor; 1k
R9: EuropeanResistor; 1k
R10: EuropeanResistor; 220
U1: LT6220
U2: LT6220
U3: LT6220
V1: voltage; {C}
V2: voltage; {C}
V3: voltage; SINE(0 {U/2} 1k 0); AC 1
V4: voltage; SINE(0 {U/2} 1k 0); AC 1
Named nets: 0, -12V, +12V, HOT, COLD, AAF_IN
.OPTIONS nomarch
.options plotwinsize 0
.options numdgt 7
;options maxstep 10n
.param C=12
.param U=1
;tran 0 6m 1m uic
savebias stab.txt internal time=500u repeat
.ac dec 1000 10 1MEG
*.loadbias stab.txt
.options maxstep 1u
;tran 0 10m 5m uic
PWL(1m 0 +1m 0 +1u {U/2} +{1m-1u} {U/2} +1u 0 +{1m-1u} 0 +1u {-U/2} +{1m-1u} {-U/2} +1u 0)
SINE(0 {U/2} 1k 0)
Fc=-3dB=218kHz
SINE(0 {U/2} 10k 0)
