HeinVerhallen/Audio-DSP/LTspice/Front-end/Sub-designs/ADC Driver for Professional Audio OPA1632 reference design.asc

C1: cap; 1n
C2: cap; 1n
C3: cap; 2n7
C10: cap; 100n
R1: EuropeanResistor; 1k
R2: EuropeanResistor; 1k
R3: EuropeanResistor; 270
R4: EuropeanResistor; 270
R5: EuropeanResistor; 40
R6: EuropeanResistor; 40
R10: EuropeanResistor; 1k
RI+: EuropeanResistor; 10k
RI-: EuropeanResistor; 10k
U1: OPA1632
U2: LT6220
V1: voltage; {C}
V2: voltage; {C}
V3: voltage; 0; AC 0
V4: voltage; 0; AC 0
V5: voltage; 2.5
V6: voltage; PULSE(0 {U/2} 0 1n 1n 500u 1m 10); AC 1
Named nets: 0, -12V, +12V, VCOM, HOT, COLD
.OPTIONS nomarch
.options plotwinsize 0
.options numdgt 7
;options maxstep 10n
.param C=12
.param U=1
.ac dec 1000 10 1MEG
*.loadbias stab.txt
.options maxstep 1u
.savebias stab.txt internal time=500u repeat
.tran 0 10m 5m uic
fc=1592Hz
PCM1804
Charge glitch reservoir for the ADC
External LPF before AAF?
SINE(0 {U/2} 1k 0)
PULSE(0 {U/2} 0 1u 1u 0 1m 10)
