HeinVerhallen/Audio-DSP/LTspice/Back-end/LPF.asc

C1: cap; 4n7
C2: cap; 1n5
C3: cap; 1n5
C4: cap; 2.2n
C5: cap; 680p
C6: cap; 680p
R1: res; 10k
R2: res; 10k
R3: res; 820
R4: res; 820
R5: res; 4.3k
R6: res; 22
R7: res; 4.3k
R8: res; 1k
R9: res; 4k7
R10: res; 1k
R11: res; 4.7k
R13: res; 39
R14: res; 39
U1: LT6220
U2: OPA1632
V1: voltage; SINE(2.5V 2 1K); AC 1
V2: voltage; SINE(-2.5 2 1K); AC 1
V3: voltage; 12
V4: voltage; 12
Named nets: 0, VOUT+, VOUT-, V+, V-, RCA/JACK, +XLR, -XLR
DAC
100k & 470k
1R & 4R7
fc=42 kHz (-3dB) with an flatness of ±0.7 dB in the audio band (20 Hz up and till 20 kHz)
.tran 1
.ac dec 1 1k 1MEG
+-0.5dB in audio band (20-20kHz)
fc=40kHz (-3dB)
