HeinVerhallen/Audio-DSP/LTspice/Front-end/High side switch level shifter.asc

Q1: npn
Q2: pnp
R1: res; 10k
R2: res; 10k
R3: res; 10k
R4: res; 10k
V1: voltage; PULSE(0 3.3 10u 1n 1n 10u 20u)
V2: voltage; PULSE(0 5 5u 1n 1n 30u)
Named nets: 0, +5VD1, OE, ~TXS0102_OE_CH1_2
.tran 0 40u 0
