HeinVerhallen/Audio-DSP/LTspice/Front-end/VU-meter.asc

C1: cap; 47p
C2: cap; 10µ
D1: diode; 1N4148
D2: diode; 1N4148
D3: LED; NSCW100
D4: LED; NSCW100
D5: LED; NSCW100
D6: LED; NSCW100
R1: res; 100k
R2: res; 10k
R3: res; 10k
R4: res; 10k
R5: res; 1k
R6: res; 150k
R7: res; 24k
R8: res; 3k9
R9: res; 330
R10: res; 2k
R11: res; 330
R12: res; 1k
R13: res; 1k
R14: res; 330
R15: res; 330
R16: res; 150k
R17: res; 10k
R18: res; 10k
U1: LT6220
U2: LT6220
U3: LT1720
U4: LT1720
U5: LT1720
U6: LT1720
U7: LT6220
V1: voltage; 15
V2: voltage; 15
V3: voltage; SINE(0 2 1k)
V4: voltage; 5
V5: voltage; SINE(0 12 1k)
V6: voltage; SINE(0 12 1k)
Named nets: 0, +15VD, -15VD, VRECT, Audio, +5VD, +200mV_REF, R1, O1, G2, G1
.tran 0 100m 98m
Precision rectifier
LPF
1.74V     clipping
870mV   -6dB
435mV  -12dB
218mV  -18dB
TL072
LM339
Difference amplifier with gain of 1/15
TL072
