HeinVerhallen/Audio-DSP/LTspice/Buck converters/MAX17634C_12V.asc

C1: cap; {Cout}; Rser=10m
C2: cap; {Cin}; Rser=10m
D1: diode; Dideal
L1: ind; 10µ; Ipk=7.6 Rser=0.027 Rpar=942 Cpar=0 mfg="Coilcraft" pn="XAL6060-103"
Rload: res; 4
S1: sw
V1: voltage; {Vin}; Rser={Rin}
V2: voltage; PULSE(0 1 0 1n 1n {Ton} {Tper})
Named nets: 0
.PARAM Vin=24
.PARAM Vout=12
.PARAM Rin=100m
.PARAM D=Vout/Vin
.PARAM Fsw=1MEG
.PARAM Tper=1/Fsw
.PARAM Ton=Tper*D
.PARAM Cin=10u
.PARAM Cout=50u
.model Dideal D(Ron=1m Roff=1G Vfwd=0)
.model SW SW(Ron=1m Roff=1G Vt=0.5 Vh=0.1 Lser=0 Vser=0)
.tran 0 10m 9m99
