HeinVerhallen/Audio-DSP/LTspice/Buck converters/5V-buck.asc

C1: cap; 10µ; Rser=20m
C2: cap; 470n
C3: cap; 1n
C4: cap; 10µ; Rser=20m
C5: cap; 3300p; Rser=1m
C6: cap; 10µ; Rser=20m
C7: cap; 10µ; Rser=20m
C8: cap; 10µ; Rser=20m
C9: cap; 10µ; Rser=20m
C10: cap; 10µ; Rser=20m
C11: cap; 0.1µ
D1: schottky; VSSAF5L45
L1: ind; 10µ; Rser=36m
load: res; 2.5
M1: pmos; FDD4141
R1: res; 40K
R2: res; 1K
R3: res; 5m
R4: res; 10k
R5: res; 3.3k
R6: res; 66.5K
U1: LM25085_TRANS
V1: voltage; 24V
Named nets: 0, Supply, Vout
.OPTIONS nomarch
 .options plotwinsize 0
 .options numdgt 7
 ;options maxstep 10n
.tran 0 50m 40m startup
.meas tran x pp v(Vout)
step param R list 10k 40.2k 100k 200k 500k 1meg
.MODEL VSSAF5L45 D
+ IS=1.4751E-6 N=1.0333
+ RS=13.348E-3
+ IKF=137.57
+ CJO=1.4647E-9
+ M=1.3958
+ VJ=5.4270
+ ISR=552.13E-9
+ NR=5.0624
+ BV=60.115
+ IBV=.86599
+ TT=2.0931E-12
 .ENDS
* still need to change the value of R1 dependant on de PMOS
