HeinVerhallen/Audio-DSP/LTspice/Buck converters/12V-buck.asc

C1: cap; 10µ; Rser=20m
C2: cap; 470n
C3: cap; 1n
C4: cap; 10µ; Rser=200m
C5: cap; 5n6
C6: cap; 10µ; Rser=200m
C7: cap; 10µ; Rser=200m
C8: cap; 10µ; Rser=20m
C9: cap; 10µ; Rser=200m
C10: cap; 10µ; Rser=200m
D1: schottky; 1N5819
L1: ind; 8µ2; Rser=20m
load: res; 4
R1: res; 10k
R2: res; 1k8
R3: res; 10m
R4: res; 43k
R5: res; 5k1
U1: LM25085_TRANS
V1: voltage; 24; Rser=100m
X1: BUK6Y24-40P
Named nets: Supply, 0, Vout
.OPTIONS nomarch
.options plotwinsize 0
.options numdgt 7
;options maxstep 10n
.tran 10m startup
.meas tran x pp v(Vout)
E24 resistors were used to get the desired voltage
TODO:
-Calculate Rt (with our MOSFET)
-Check inductance
-Add extra ripple feedback network to furthur supress output ripple
LM25085:
xx
 
MOSFET:
https://nl.farnell.com/nexperia/buk6y24-40px/mosfet-p-ch-40v-39a-lfpak56/dp/3438515
 
MLCC 10u 35V X7R 1206:
https://nl.farnell.com/taiyo-yuden/gmk316ab7106kl-tr/cap-10-f-35v-10-x7r-1206/dp/2309034
<-----Update FB network
<-----Update Rt network
<-----Check if inductance is still correct
