HeinVerhallen/Audio-DSP/LTspice/Buck converters/8V-buck.asc

C1: cap; 10µ; Rser=20m
C2: cap; 470n
C3: cap; 1n
C4: cap; 10µ; Rser=20m
C5: cap; 2.2n
C6: cap; 10µ; Rser=20m
C7: cap; 10µ; Rser=20m
C8: cap; 10µ; Rser=20m
C9: cap; 10µ; Rser=20m
C10: cap; 10µ; Rser=20m
D1: schottky; 1N5819
L1: ind; 15µ; Rser=20m
load: res; 16
M1: pmos; FDC5614P
R1: res; 47k
R2: res; 1.05k
R3: res; 10m
R4: res; 22k
R5: res; 3.3k
R6: res; 4.7k
U1: LM25085_TRANS
V1: voltage; 24; Rser=100m
Named nets: Supply, Vout, 0
.OPTIONS nomarch
.options plotwinsize 0
.options numdgt 7
;options maxstep 10n
.tran 10m startup
.meas tran x pp v(Vout)
E24 resistors were used to get the desired voltage
TODO:
-Calculate Rt (with our MOSFET)
-Check inductance
-Add extra ripple feedback network to furthur supress output ripple
