HeinVerhallen/Audio-DSP/LTspice/Input filter/Input filter.asc

C1: cap; 10µ; Rser=20m
C12: cap; 10µ; Rser=20m
C13: cap; 10µ; Rser=20m
C14: cap; 10µ; Rser=20m
C15: cap; 10µ; Rser=20m
D1: zener; BZX84C12L
L1: WE-DD
L2: ind; 4µ7
L3: ind; 4µ7
M1: pmos
R1: res; 100k
Rload: res; 7
V1: voltage; SINE(0 100m 100k)
V2: voltage; PWL(0 0 5m -24 10m 24)
Named nets: +VIN, 0, +24V
.tran 0 15m 0
.options nomarch
CM filter
DM filter
Zener or TVS diode
RVPP
MOSFET with internal body diode
