HeinVerhallen/Audio-DSP/LTspice/Front-end/XLR RF filter, AAF with ADC driver.asc

C1: cap; 1n
C2: cap; 1n
C3: cap; 2n7
C4: cap; 3n3
C5: cap; 3n3
C10: cap; 100n
R1: res; 1k
R2: res; 1k
R3: res; 270
R4: res; 270
R5: res; 39
R6: res; 39
R7: res; 220
R9: res; 220
R10: res; 1k
R12: res; 47k
R13: res; 47k
R14: res; 2Meg2
Rf1: res; 1k
Rg1: res; 0
Rg2: res; 0
RI+: res; 10k
RI-: res; 10k
U1: OPA1632
U2: LT6220
U3: LT6220
U4: LT6220
V1: voltage; {C}
V2: voltage; {C}
V3: voltage; SINE(0 {U} 1k 0); AC 1
V4: voltage; SINE(0 {U} 1k 0); AC 1
V5: voltage; 2.5
V6: voltage; PULSE(0 {U/2} 0 1n 1n 500u 1m 10); AC 1
Named nets: 0, -12V, +12V, VCOM, HOT, COLD
.OPTIONS nomarch
.options plotwinsize 0
.options numdgt 7
;options maxstep 10n
.param C=12
.param U=9.75
.ac dec 1000 10 1MEG
*.loadbias stab.txt
.options maxstep 1u
.savebias stab.txt internal time=500u repeat
.tran 0 10m 5m uic
fc=1592Hz
PCM1804
Charge glitch reservoir for the ADC
SINE(0 {U} 1k 0)
PULSE(0 {U} 0 1u 1u 0 1m 10)
Fc=-3dB=218kHz
LM4562
Gain here increases CMRR
Input range is 0 to 5V, referenced to 2.5V
Just place footprints of Rf1, Rg1 & Rg2 on PCB
LM4562
LM4562
Design should be fine. Checked gain and frequency response (fc can be decreased if desired, but this fr is recomended by the datasheet)
