HeinVerhallen/Audio-DSP/KiCAD/Main board/Main board.kicad_pcb

## KiCad design KiCAD/Main board/Main board.kicad_pcb (2023-06-26)

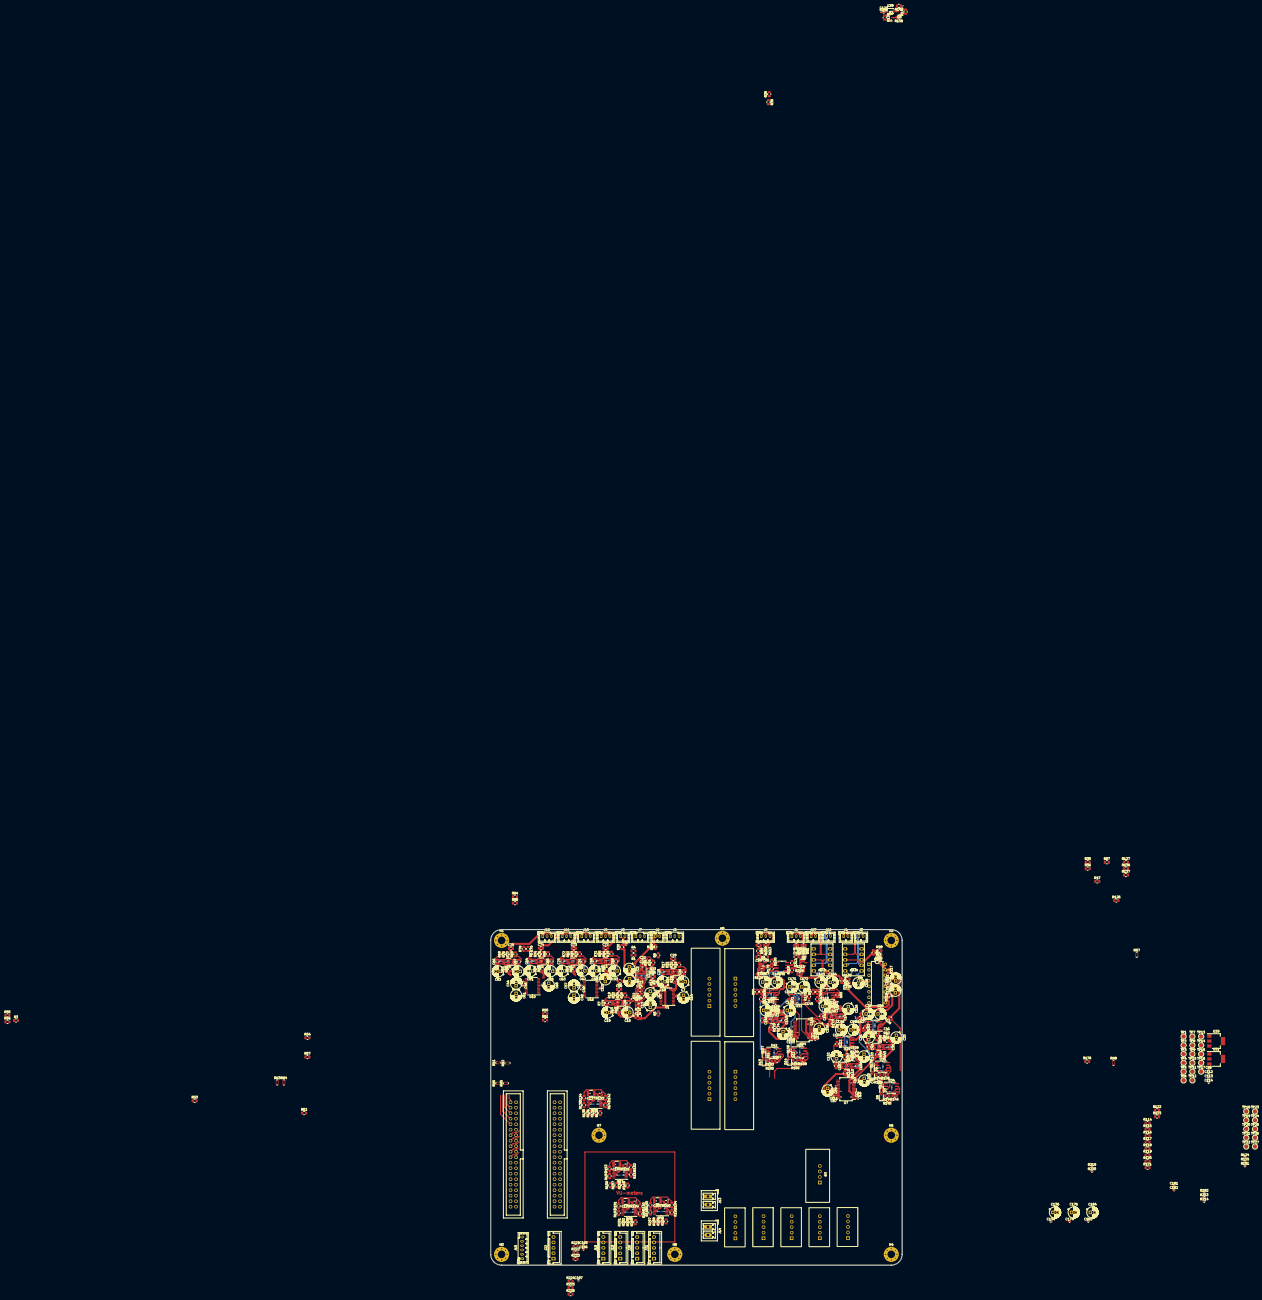
[picture p169: board Main board.kicad_pcb from above]

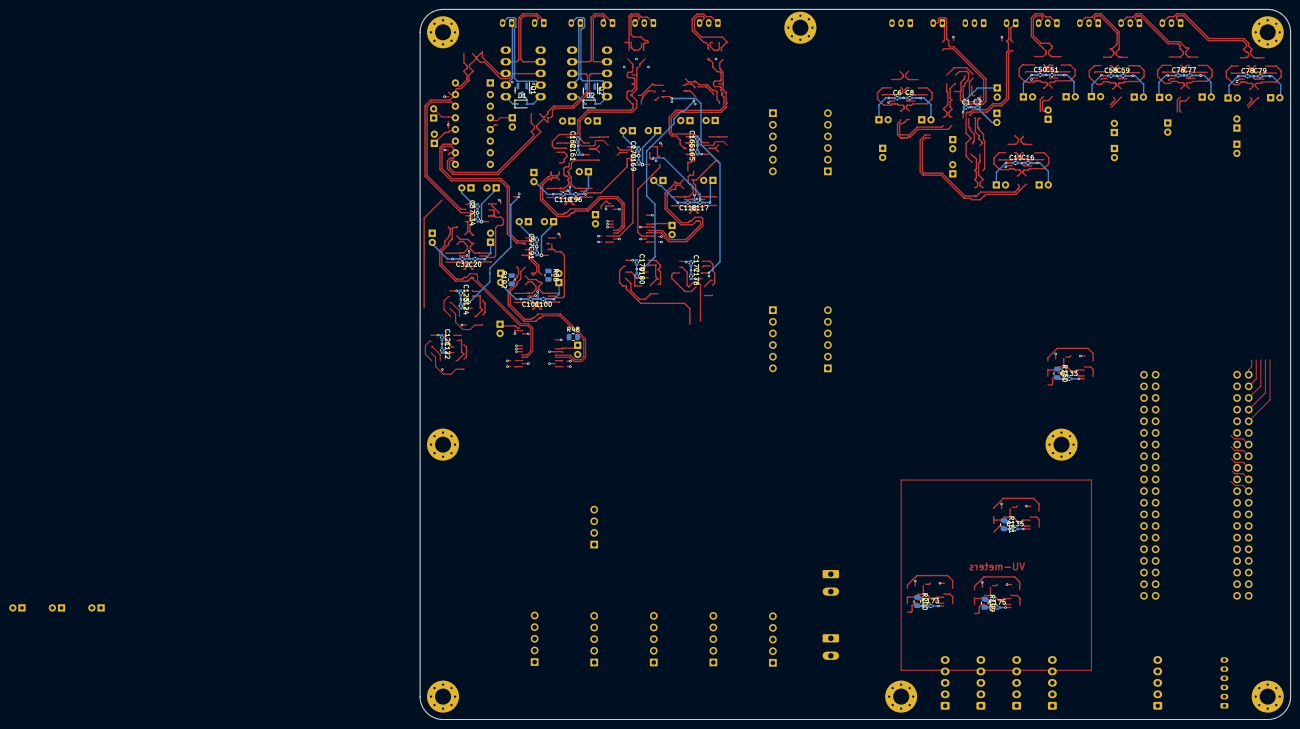
[picture p170: board Main board.kicad_pcb from below]

Board: 4 copper layers, 190.0 x 155.0 mm, 543 parts (55 on the bottom side), 359 nets.

Parts:
C1, C2, C5, C6, C8, C9, C11, C12, C16, C20, C32, C34, C37, C43, C45, C46, C47, C49, C50, C51, C52, C55, C58, C59, C76, C77, C78, C79, C84, C86, C87, C88, C91, C96, C97, C100, C101, C104, C109, C110, C111, C117, C118, C121, C122, C123, C124, C126, C127, C129, C130, C132, C133, C134, C135, C145, C146, C147, C148, C151, C153, C154, C155, C161, C162, C165, C166, C169, C170, C173, C174, C175, C177, C178, C179, C180, C181, C182, C183, C185, C186, C187: 100n; C_0402_1005Metric
C3, C4, C7, C10, C13, C14, C15, C19, C31, C33, C36, C38, C39, C42, C44, C48, C53, C54, C56, C57, C60, C61, C62, C63, C80, C81, C82, C83, C89, C98, C99, C102, C103, C115, C116, C119, C120, C125, C128, C131, C136, C152, C156, C163, C164, C167, C168, C171, C172, C176, C184: 22uF; CP_Radial_D5.0mm_P2.00mm
C17, C18: 4n7; C_0805_2012Metric
C21, C22, C23, C24: 1n5; C_0805_2012Metric
C25, C26, C27, C28, C64, C65, C66, C67, C68, C69, C70, C71: 680p; C_0805_2012Metric
C29, C30, C72, C73, C74, C75: 2n2; C_0805_2012Metric
C35, C40, C106, C107, C141, C142, C143, C144: 1n; C_0805_2012Metric
C41, C108, C149, C150: 2n7; C_0805_2012Metric
C85, C112, C113, C114: 1u; C_0402_1005Metric
C90, C92, C93, C94, C95, C105: 3n3; C_0805_2012Metric
C137, C140, C159, C160: 10u; C_1210_3225Metric
C138, C139, C157, C158: 47p; C_0402_1005Metric
D1, D2, D7, D8, D9, D10, D11, D12, D13, D14: 1N4148WS; D_SOD-323
D3, D4: STS321050B100; D_SOD-323
D5, D6: CPDT-12V; SOT-23
H1, H2, H3, H4, H5, H6, H7, H8: MountingHole_Pad; MountingHole_3.5mm_Pad_Via
J1, J2, J5, J7, J9, J10, J11, J12: Conn_01x03; JST_PH_B3B-PH-K_1x03_P2.00mm_Vertical
J3, J4, J6, J8, J16, J17: Conn_01x02; JST_PH_B2B-PH-K_1x02_P2.00mm_Vertical
J13, J14: Conn_01x02; PhoenixContact_MCV_1,5_2-G-3.81_1x02_P3.81mm_Vertical
J15: Conn_01x06; JST_PH_B6B-PH-K_1x06_P2.00mm_Vertical
J18, J19, J20, J21, J22: Conn_01x05; JST_XH_B5B-XH-A_1x05_P2.50mm_Vertical
K1, K2: EA2-12NU
Q1, Q2, Q3: BC847; SOT-23
Q4: BC857; SOT-23
R1, R2, R3, R4, R6, R7, R35, R36, R38, R39, R47, R48, R52, R53, R55, R56, R78, R79, R84, R85, R87, R88, R102, R114, R115, R116, R117, R118, R119, R120, R121, R122, R123, R136, R137, R176: 10R; R_0805_2012Metric
R5, R8, R50, R51, R54, R57: 4R7; R_0805_2012Metric
R9, R10, R13, R14: 10K; R_0805_2012Metric
R11, R12, R15, R16, R37, R40, R58, R59, R60, R61, R62, R63, R64, R65, R93, R94, R103, R106, R107, R112, R126, R127, R133, R134, R135, R147, R153, R154, R155, R163, R164, R165, R170, R171, R191, R192, R195, R196, R197, R198, R221, R222, R223, R224, R225, R226: 1k; R_0805_2012Metric
R17, R18, R19, R20, R66, R67, R68, R69, R70, R71, R72, R73: 4k7; R_0805_2012Metric
R21, R22, R23, R24: 820; R_0805_2012Metric
R25, R26, R27, R28: 4k3; R_0805_2012Metric
R29, R30: 22; R_0805_2012Metric
R31, R32, R33, R34, R43, R44, R74, R75, R76, R77, R80, R81, R82, R83, R110, R111, R172, R173, R174, R175: 39; R_0805_2012Metric
R41, R42, R108, R109: 2k7; R_0805_2012Metric
R45, R46, R86, R89, R90, R104: 47k; R_0805_2012Metric
R49, R91, R99, R101, R105, R113: 220; R_0805_2012Metric
R92, R100: 2M2; R_0805_2012Metric
R95, R96, R97, R98: 0; R_0805_2012Metric
R124, R125, R181, R182, R213, R214, R215, R216, R217, R218: 0R; R_0402_1005Metric
R128, R162: 100k; R_0805_2012Metric
R129, R130, R131, R132, R156, R157, R158, R159, R201, R202, R203, R204, R205, R206, R207, R208: 330; R_0805_2012Metric
R138, R139, R140, R141, R144, R145, R146, R148, R149, R150, R179, R180, R183, R184, R185, R186, R187, R188, R210, R212: 10k; R_0805_2012Metric
R142, R152, R190, R194: 2k; R_0805_2012Metric
R143, R151, R189, R193: 3k9; R_0805_2012Metric
R160, R161, R199, R200: 24k; R_0805_2012Metric
R166, R167, R168, R169: 270; R_0805_2012Metric
R177, R178, R209, R211: 150k; R_0805_2012Metric
R219, R220: 1k8; R_0402_1005Metric
RN1, RN2, RN3, RN4, RN5, RN6, RN7, RN8: 22R; R_Array_Convex_4x0402
TP1, TP2, TP3, TP4, TP5, TP6, TP7, TP8, TP9, TP10, TP11, TP12, TP13, TP14, TP15, TP16, TP17, TP18, TP19, TP20, TP21, TP22, TP23, TP24, TP25, TP26, TP27: TestPoint; TestPoint_Pad_D2.0mm
U1, U10, U16: PCM1789; TSSOP-24_4.4x7.8mm_P0.65mm
U2, U6, U24, U30, U32, U33: LM4562; SOIC-8_3.9x4.9mm_P1.27mm
U3, U4, U5, U11, U17, U22, U23, U25, U26, U27: OPA1632DR; VSSOP-8_3.0x3.0mm_P0.65_TP1.8x1.5
U7, U44: PCM1804; SSOP-28_5.3x10.2mm_P0.65mm
U8: DE1-SoC
U9: SEPIC_-15V_LT3579
U12, U13: LIN_REG_±5V; LIN_REG_±xxV
U14, U15: LIN_REG_±12V; LIN_REG_±xxV
U18, U28: 12V; BUCK_MAX17634C_xxV
U19: 5V; BUCK_MAX17634C_xxV
U20: 8V; BUCK_MAX17634C_xxV
U21: 15V; BUCK_MAX17634C_xxV
U29, U31: AP2111H-3.3TRG1; SOT-223
U34, U35, U42, U43, U45: TL072; SOIC-8_3.9x4.9mm_P1.27mm
U36, U37, U40, U41: LM339; TSSOP-14_4.4x5mm_P0.65mm
U38: PGA2311P; DIP-16_W7.62mm
U39: TXS0102; VSSOP-8_2.4x2.1mm_P0.5mm

Connections:
+3V3D1: C42.1, C43.2, C113.1, C130.2, C155.2, C156.1, R124.2, R125.2, R181.2, R182.2, R213.2, R214.2, TP2.1, U7.6 (FMT0), U7.14 (VDD), U7.19 (~RST), U29.2 (VOUT), U39.3 (VCCA), U44.6 (FMT0), U44.14 (VDD), U44.19 (~RST)
+3V3D2: C5.1, C39.1, C44.1, C45.1, C48.1, C49.1, C114.1, R219.1, R220.1, R221.1, R224.1, R225.1, TP10.1, U1.4 (RST), U1.6 (VDD), U10.4 (RST), U10.6 (VDD), U10.24 (ADR5/ADR1/RSV), U16.4 (RST), U16.6 (VDD), U16.23 (MS/ADR0/RSV), U31.2 (VOUT)
+5VA1: R48.1, R136.1, R176.1, TP3.1, U12.4 (+5V)
+5VA2: R5.1, R8.1, R50.1, R51.1, R54.1, R57.1, TP4.1, U13.4 (+5V)
+5VD1: C85.1, C112.1, C127.2, C128.1, C129.2, C133.1, C135.1, C173.1, C175.1, J15.3, J18.1, J19.1, J20.1, J21.1, Q4.2 (E), R140.2, R160.2, R161.2, R199.2, R200.2, TP1.1, U19.1 (VOUT), U19.2 (VOUT), U29.3 (VIN), U31.3 (VIN), U36.3 (V+), U37.3 (V+), U38.1 (ZCEN), U38.4 (VD+), U38.8 (~MUTE), U39.2 (VCCB), U40.3 (V+), U41.3 (V+)
+12VA1: R35.1, R38.1, R47.1, R88.1, R114.1, R116.1, R118.1, R120.1, R122.1, TP5.1, U14.4 (+12V)
+12VA2: R1.1, R3.1, R6.1, R52.1, R55.1, R78.1, R84.1, TP6.1, U15.4 (+12V)
+12VD1: D1.1 (K), D2.1 (K), K1.1, K2.1, TP13.1, U28.1 (VOUT), U28.2 (VOUT)
+15VD1: C121.1, C123.1, C177.1, C179.1, C181.1, TP11.1, U14.6 (+VIN), U15.6 (+VIN), U21.1 (VOUT), U21.2 (VOUT), U34.8 (V+), U35.8 (V+), U42.8 (V+), U43.8 (V+), U45.8 (V+)
-5VA1: R137.1, TP15.1, TP16.1, U12.3 (-5V), U13.3 (-5V)
-12VA1: R36.2, R39.2, R87.2, R102.2, R115.2, R117.2, R119.2, R121.2, R123.2, TP7.1, U14.3 (-12V)
-12VA2: R2.2, R4.2, R7.2, R53.2, R56.2, R79.2, R85.2, TP8.1, U15.3 (-12V)
-15VD1: C122.2, C124.2, C178.2, C180.2, C182.2, TP17.1, U9.3 (VOUT), U12.1 (-VIN), U13.1 (-VIN), U14.1 (-VIN), U15.1 (-VIN), U34.4 (V-), U35.4 (V-), U42.4 (V-), U43.4 (V-), U45.4 (V-)
/ADC_CH1_2/AGND_CH1: C90.2, D3.1 (A1), K1.8, R40.1, R86.2, R217.1, U38.15 (AGNDL)
/ADC_CH1_2/AGND_CH2: C105.2, D4.1 (A1), K2.8, R104.2, R107.1, R218.1, U38.10 (AGNDR)
/ADC_CH1_2/BCK_ADC_CH1_2: RN7.6 (R3.2), U8.9(GPIO_0) (GPIO_0_D8)
/ADC_CH1_2/DATA_ADC_CH1_2: RN7.5 (R4.2), U8.13(GPIO_0) (GPIO_0_D10)
/ADC_CH1_2/INPUT_SELECTOR_RELAY_CH1: R126.2, U8.1(GPIO_0) (GPIO_0_D0)
/ADC_CH1_2/INPUT_SELECTOR_RELAY_CH2: R127.2, U8.3(GPIO_0) (GPIO_0_D2)
/ADC_CH1_2/JACK_CH1(+): J4.1, K1.4
/ADC_CH1_2/JACK_CH1(REF): J4.2, K1.7
/ADC_CH1_2/JACK_CH2(+): J17.1, K2.4
/ADC_CH1_2/JACK_CH2(REF): J17.2, K2.7
/ADC_CH1_2/LRCK_ADC_CH1_2: RN7.7 (R2.2), U8.7(GPIO_0) (GPIO_0_D6)
/ADC_CH1_2/RCA_CH1(+): J3.1, K1.2
/ADC_CH1_2/RCA_CH1(REF): J3.2, K1.9
/ADC_CH1_2/RCA_CH2(+): J16.1, K2.2
/ADC_CH1_2/RCA_CH2(REF): J16.2, K2.9
/ADC_CH1_2/SCKI_ADC_CH1_2: RN7.8 (R1.2), U8.5(GPIO_0) (GPIO_0_D4)
/ADC_CH1_2/TXS0102_SCLK_CH1_2: U8.23(GPIO_0) (GPIO_0_D20), U39.5 (A1)
/ADC_CH1_2/TXS0102_SDA_CH1_2: U8.25(GPIO_0) (GPIO_0_D22), U39.4 (A2)
/ADC_CH1_2/VU_G1_CH1: J18.2, R129.1
/ADC_CH1_2/VU_G1_CH2: J19.2, R156.1
/ADC_CH1_2/VU_G2_CH1: J18.3, R130.1
/ADC_CH1_2/VU_G2_CH2: J19.3, R157.1
/ADC_CH1_2/VU_O1_CH1: J18.4, R131.1
/ADC_CH1_2/VU_O1_CH2: J19.4, R158.1
/ADC_CH1_2/VU_R1_CH1: J18.5, R132.1
/ADC_CH1_2/VU_R1_CH2: J19.5, R159.1
/ADC_CH1_2/~TXS0102_OE_CH1_2: R139.2, U8.27(GPIO_0) (GPIO_0_D24)
/ADC_CH3_4/BCK_ADC_CH3_4: RN8.6 (R3.2), U8.19(GPIO_0) (GPIO_0_D16)
/ADC_CH3_4/DATA_ADC_CH3_4: RN8.5 (R4.2), U8.21(GPIO_0) (GPIO_0_D18)
/ADC_CH3_4/LRCK_ADC_CH3_4: RN8.7 (R2.2), U8.17(GPIO_0) (GPIO_0_D14)
/ADC_CH3_4/SCKI_ADC_CH3_4: RN8.8 (R1.2), U8.15(GPIO_0) (GPIO_0_D12)
/ADC_CH3_4/VU_G1_CH3: J20.2, R201.1
/ADC_CH3_4/VU_G1_CH4: J21.2, R205.1
/ADC_CH3_4/VU_G2_CH3: J20.3, R202.1
/ADC_CH3_4/VU_G2_CH4: J21.3, R206.1
/ADC_CH3_4/VU_O1_CH3: J20.4, R203.1
/ADC_CH3_4/VU_O1_CH4: J21.4, R207.1
/ADC_CH3_4/VU_R1_CH3: J20.5, R204.1
/ADC_CH3_4/VU_R1_CH4: J21.5, R208.1
/ADC_CH3_4/XLR_CH3(+): J1.1, R89.1, R91.1
/ADC_CH3_4/XLR_CH3(-): J1.3, R90.2, R101.1
/ADC_CH3_4/XLR_CH4(+): J2.1, R46.2, R113.1
/ADC_CH3_4/XLR_CH4(-): J2.3, R45.1, R99.1
/DAC_CH1_2/AMUTEI_DAC_CH1_2: RN2.1 (R1.1), U8.33(GPIO_1) (GPIO_1_D28)
/DAC_CH1_2/BCK_DAC_CH1_2: RN1.2 (R2.1), U8.27(GPIO_1) (GPIO_1_D24)
/DAC_CH1_2/DIN_DAC_CH1_2: RN1.3 (R3.1), U8.25(GPIO_1) (GPIO_1_D22)
/DAC_CH1_2/I2C_SCL_DAC: R219.2, RN2.3 (R3.1), RN4.3 (R3.1), RN6.3 (R3.1), U8.35(GPIO_1) (GPIO_1_D30)
/DAC_CH1_2/I2C_SDA_DAC: R220.2, RN2.2 (R2.1), RN4.2 (R2.1), RN6.2 (R2.1), U8.37(GPIO_1) (GPIO_1_D32)
/DAC_CH1_2/LRCK_DAC_CH1_2: RN1.1 (R1.1), U8.31(GPIO_1) (GPIO_1_D26)
/DAC_CH1_2/RCA_JACK_CH1(+): J6.1, R29.2
/DAC_CH1_2/RCA_JACK_CH1(REF): C22.2, J6.2, R26.2, R216.1
/DAC_CH1_2/RCA_JACK_CH2(+): J8.1, R30.2
/DAC_CH1_2/RCA_JACK_CH2(REF): C24.2, J8.2, R28.2, R215.1
/DAC_CH1_2/SCKI_DAC_CH1_2: RN1.4 (R4.1), U8.23(GPIO_1) (GPIO_1_D20)
/DAC_CH1_2/VOUT_XLR_CH1(+): C29.2, J5.1, R18.2, R32.2
/DAC_CH1_2/VOUT_XLR_CH1(-): C29.1, J5.3, R17.2, R31.2
/DAC_CH1_2/VOUT_XLR_CH2(+): C30.2, J7.1, R20.2, R34.2
/DAC_CH1_2/VOUT_XLR_CH2(-): C30.1, J7.3, R19.2, R33.2
/DAC_CH3_4/AMUTEI_DAC_CH3_4: RN4.1 (R1.1), U8.21(GPIO_1) (GPIO_1_D18)
/DAC_CH3_4/BCK_DAC_CH3_4: RN3.2 (R2.1), U8.17(GPIO_1) (GPIO_1_D14)
/DAC_CH3_4/DIN_DAC_CH3_4: RN3.3 (R3.1), U8.15(GPIO_1) (GPIO_1_D12)
/DAC_CH3_4/LRCK_DAC_CH3_4: RN3.1 (R1.1), U8.19(GPIO_1) (GPIO_1_D16)
/DAC_CH3_4/SCKI_DAC_CH3_4: RN3.4 (R4.1), U8.13(GPIO_1) (GPIO_1_D10)
/DAC_CH3_4/VOUT_XLR_CH3(+): C72.2, J9.1, R70.2, R81.2
/DAC_CH3_4/VOUT_XLR_CH3(-): C72.1, J9.3, R71.2, R80.2
/DAC_CH3_4/VOUT_XLR_CH4(+): C73.2, J10.1, R73.2, R83.2
/DAC_CH3_4/VOUT_XLR_CH4(-): C73.1, J10.3, R72.2, R82.2
/DAC_CH5_6/AMUTEI_DAC_CH5_6: RN6.1 (R1.1), U8.9(GPIO_1) (GPIO_1_D8)
/DAC_CH5_6/BCK_DAC_CH5_6: RN5.2 (R2.1), U8.5(GPIO_1) (GPIO_1_D4)
/DAC_CH5_6/DIN_DAC_CH5_6: RN5.3 (R3.1), U8.3(GPIO_1) (GPIO_1_D2)
/DAC_CH5_6/LRCK_DAC_CH5_6: RN5.1 (R1.1), U8.7(GPIO_1) (GPIO_1_D6)
/DAC_CH5_6/SCKI_DAC_CH5_6: RN5.4 (R4.1), U8.1(GPIO_1) (GPIO_1_D0)
/DAC_CH5_6/VOUT_XLR_CH5(+): C74.2, J11.1, R66.2, R75.2
/DAC_CH5_6/VOUT_XLR_CH5(-): C74.1, J11.3, R67.2, R74.2
/DAC_CH5_6/VOUT_XLR_CH6(+): C75.2, J12.1, R69.2, R77.2
/DAC_CH5_6/VOUT_XLR_CH6(-): C75.1, J12.3, R68.2, R76.2
/FPGA/ENC_A: C187.1, R226.1, U8.31(GPIO_0) (GPIO_0_D26)
/FPGA/ENC_B: C186.1, R222.1, U8.33(GPIO_0) (GPIO_0_D28)
/FPGA/ENC_SW: C185.1, R223.1, U8.35(GPIO_0) (GPIO_0_D30)
/FPGA/UI_RX: J15.6, U8.37(GPIO_0) (GPIO_0_D32)
/FPGA/UI_TX: J15.4, U8.39(GPIO_0) (GPIO_0_D34)
/POWER_SUPPLIES/DC_POWER_IN: J13.1, TP14.1, U18.5 (VIN), U19.5 (VIN), U20.5 (VIN), U21.5 (VIN), U28.5 (VIN)
GND: C1.2, C2.1, C3.2, C4.1, C5.2, C6.2, C7.2, C8.1, C9.2, C10.1, C11.2, C12.2, C13.2, C14.2, C15.2, C16.1, C19.1, C20.2, C31.2, C32.1, C33.1, C34.2, C36.2, C37.1, C38.1, C39.2, C42.2, C43.1, C44.2, C45.2, C46.2, C47.2, C48.2, C49.2, C50.2, C51.1, C52.2, C53.2, C54.1, C55.2, C56.2, C57.2, C58.2, C59.1, C60.2, C61.2, C62.2, C63.1, C76.2, C77.1, C78.2, C79.1, C80.2, C81.1, C82.2, C83.1, C84.2, C85.2, C86.2, C87.2, C88.1, C89.2, C91.2, C92.2, C93.1, C94.2, C95.1, C96.2, C97.1, C98.2, C99.1, C100.2, C101.1, C102.2, C103.1, C104.1, C109.1, C110.1, C111.2, C112.2, C113.2, C114.2, C115.2, C116.1, C117.2, C118.1, C119.2, C120.1, C121.2, C122.1, C123.2, C124.1, C125.2, C126.1, C127.1, C128.2, C129.1, C130.1, C131.1, C132.1, C133.2, C134.2, C135.2, C136.2, C137.2, C140.2, C145.1, C146.1, C147.2, C148.2, C151.2, C152.2, C153.2, C154.1, C155.1, C156.2, C159.2, C160.2, C161.2, C162.1, C163.2, C164.1, C165.2, C166.1, C167.2, C168.1, C169.2, C170.1, C171.2, C172.1, C173.2, C174.2, C175.2, C176.2, C177.2, C178.1, C179.2, C180.1, C181.2, C182.1, C183.2, C184.2, C185.2, C186.2, C187.2, H1.1, H2.1, H3.1, H4.1, H5.1, H6.1, H7.1, H8.1, J1.2, J2.2, J5.2, J7.2, J9.2, J10.2, J11.2, J12.2, J13.2, J14.2, J15.1, J22.4, J22.5, Q1.2 (E), Q2.2 (E), Q3.2 (E), R92.2, R100.2, R133.1, R135.1, R141.1, R145.1, R149.1, R154.1, R155.1, R180.1, R185.1, R186.1, R192.1, R196.1, R197.1, R198.1, R212.1, R215.2, R216.2, R217.2, R218.2, TP18.1, TP19.1, TP20.1, TP21.1, TP22.1, TP23.1, TP24.1, TP25.1, TP26.1, TP27.1, U1.7 (DGND), U1.10 (AGND1), U1.15 (AGND2), U1.20 (MODE), U1.23 (MS/ADR0/RSV), U1.24 (ADR5/ADR1/RSV), U3.2 (VOCM), U3.7 (ENABLE), U3.9 (GND), U4.2 (VOCM), U4.7 (ENABLE), U4.9 (GND), U5.7 (ENABLE), U5.9 (GND), U7.2 (AGNDL), U7.7 (FMT1), U7.8 (S/~M), U7.12 (BYPAS), U7.13 (DGND), U7.23 (AGND), U7.27 (AGNDR), U8.2(GPIO_0) (GPIO_0_D1), U8.2(GPIO_1) (GPIO_1_D1), U8.4(GPIO_0) (GPIO_0_D3), U8.4(GPIO_1) (GPIO_1_D3), U8.6(GPIO_0) (GPIO_0_D5), U8.6(GPIO_1) (GPIO_1_D5), U8.8(GPIO_0) (GPIO_0_D7), U8.8(GPIO_1) (GPIO_1_D7), U8.10(GPIO_0) (GPIO_0_D9), U8.10(GPIO_1) (GPIO_1_D9), U8.12(GPIO_0) (GND), U8.12(GPIO_1) (GND), U8.14(GPIO_0) (GPIO_0_D11), U8.14(GPIO_1) (GPIO_1_D11), U8.16(GPIO_0) (GPIO_0_D13), U8.16(GPIO_1) (GPIO_1_D13), U8.18(GPIO_0) (GPIO_0_D15), U8.18(GPIO_1) (GPIO_1_D15), U8.20(GPIO_0) (GPIO_0_D17), U8.20(GPIO_1) (GPIO_1_D17), U8.22(GPIO_0) (GPIO_0_D19), U8.22(GPIO_1) (GPIO_1_D19), U8.24(GPIO_0) (GPIO_0_D21), U8.24(GPIO_1) (GPIO_1_D21), U8.26(GPIO_0) (GPIO_0_D23), U8.26(GPIO_1) (GPIO_1_D23), U8.28(GPIO_0) (GPIO_0_D25), U8.28(GPIO_1) (GPIO_1_D25), U8.30(GPIO_0) (GND), U8.30(GPIO_1) (GND), U8.32(GPIO_0) (GPIO_0_D27), U8.32(GPIO_1) (GPIO_1_D27), U8.34(GPIO_0) (GPIO_0_D29), U8.34(GPIO_1) (GPIO_1_D29), U8.36(GPIO_0) (GPIO_0_D31), U8.36(GPIO_1) (GPIO_1_D31), U8.38(GPIO_0) (GPIO_0_D33), U8.38(GPIO_1) (GPIO_1_D33), U8.40(GPIO_0) (GPIO_0_D35), U8.40(GPIO_1) (GPIO_1_D35), U9.2 (GND), U9.4 (GND), U10.7 (DGND), U10.10 (AGND1), U10.15 (AGND2), U10.20 (MODE), U10.23 (MS/ADR0/RSV), U11.2 (VOCM), U11.7 (ENABLE), U11.9 (GND), U12.2 (GND), U12.5 (GND), U13.2 (GND), U13.5 (GND), U14.2 (GND), U14.5 (GND), U15.2 (GND), U15.5 (GND), U16.7 (DGND), U16.10 (AGND1), U16.15 (AGND2), U16.20 (MODE), U16.24 (ADR5/ADR1/RSV), U17.2 (VOCM), U17.7 (ENABLE), U17.9 (GND), U18.3 (GND), U18.4 (GND), U19.3 (GND), U19.4 (GND), U20.3 (GND), U20.4 (GND), U21.3 (GND), U21.4 (GND), U22.2 (VOCM), U22.7 (ENABLE), U22.9 (GND), U23.2 (VOCM), U23.7 (ENABLE), U23.9 (GND), U25.7 (ENABLE), U25.9 (GND), U26.7 (ENABLE), U26.9 (GND), U27.7 (ENABLE), U27.9 (GND), U28.3 (GND), U28.4 (GND), U29.1 (GND), U31.1 (GND), U36.12 (V-), U37.12 (V-), U38.2 (~CS), U38.5 (DGND), U40.12 (V-), U41.12 (V-), U44.2 (AGNDL), U44.7 (FMT1), U44.8 (S/~M), U44.12 (BYPAS), U44.13 (DGND), U44.23 (AGND), U44.27 (AGNDR)
unnamed: C17.1, R9.1, R23.1, R25.1
unnamed: C17.2, R10.2, R24.1, R26.1
unnamed: C18.1, R13.1, R21.1, R27.1
unnamed: C18.2, R14.2, R22.1, R28.1
unnamed: C21.2, R25.2, R29.1, U2.1
unnamed: C23.2, R27.2, R30.1, U2.7
unnamed: D1.2 (A), K1.10, Q1.3 (C)
unnamed: D2.2 (A), K2.10, Q2.3 (C)
unnamed: C90.1, D3.2 (A2), R49.2, U38.16 (VINL)
unnamed: C105.1, D4.2 (A2), R105.2, U38.9 (VINR)
unnamed: C93.2, D5.1 (A1), R101.2, R211.2, U30.6 (-)
unnamed: C92.1, D5.2 (A2), R91.2, R209.2, U30.2 (-)
unnamed: C95.2, D6.1 (A1), R113.2, R177.2, U32.2 (-)
unnamed: C94.1, D6.2 (A2), R99.2, R178.2, U32.6 (-)
unnamed: C138.1, D7.2 (A), R144.2, U34.2 (-)
unnamed: C138.2, D7.1 (K), D8.2 (A), U34.1
unnamed: D8.1 (K), R145.2, U34.5 (+)
unnamed: C139.1, D9.2 (A), R148.2, U35.2 (-)
unnamed: C139.2, D9.1 (K), D10.2 (A), U35.1
unnamed: D10.1 (K), R149.2, U35.5 (+)
unnamed: C157.1, D11.2 (A), R183.2, U42.2 (-)
unnamed: C157.2, D11.1 (K), D13.2 (A), U42.1
unnamed: C158.1, D12.2 (A), R184.2, U43.2 (-)
unnamed: C158.2, D12.1 (K), D14.2 (A), U43.1
unnamed: D13.1 (K), R185.2, U42.5 (+)
unnamed: D14.1 (K), R186.2, U43.5 (+)
unnamed: J22.1, R221.2, R226.2
unnamed: J22.2, R222.2, R224.2
unnamed: J22.3, R223.2, R225.2
unnamed: K1.3, R49.1, R86.1
unnamed: K2.3, R104.1, R105.1
unnamed: Q1.1 (B), R126.1
unnamed: Q2.1 (B), R127.1
unnamed: Q3.1 (B), R139.1
unnamed: Q3.3 (C), R138.2
unnamed: Q4.1 (B), R138.1, R140.1
unnamed: Q4.3 (C), R141.2, U39.6 (OE)
unnamed: R89.2, R90.1, R92.1
unnamed: R45.2, R46.1, R100.1
unnamed: R129.2, U36.2
unnamed: R130.2, U36.1
unnamed: R131.2, U36.13
unnamed: R132.2, U36.14
unnamed: R96.2, R147.1, U30.7
unnamed: R156.2, U37.2
unnamed: R157.2, U37.1
unnamed: R158.2, U37.13
unnamed: R159.2, U37.14
unnamed: R98.2, R163.1, U32.7
unnamed: R95.2, R164.1, U30.1
unnamed: R97.2, R165.1, U32.1
unnamed: R201.2, U40.2
unnamed: R202.2, U40.1
unnamed: R203.2, U40.13
unnamed: R204.2, U40.14
unnamed: R205.2, U41.2
unnamed: R206.2, U41.1
unnamed: R207.2, U41.13
unnamed: R208.2, U41.14
unnamed: RN1.8 (R1.2), U1.1 (LRCK)
unnamed: RN1.7 (R2.2), U1.2 (BCK)
unnamed: RN1.6 (R3.2), U1.3 (DIN)
unnamed: RN1.5 (R4.2), U1.5 (SCKI)
unnamed: RN2.8 (R1.2), U1.17 (AMUTEI)
unnamed: RN2.7 (R2.2), U1.21 (MD/SDA/DEMP)
unnamed: RN2.6 (R3.2), U1.22 (MC/SCL/FMT)
unnamed: RN3.8 (R1.2), U16.1 (LRCK)
unnamed: RN3.7 (R2.2), U16.2 (BCK)
unnamed: RN3.6 (R3.2), U16.3 (DIN)
unnamed: RN3.5 (R4.2), U16.5 (SCKI)
unnamed: RN4.8 (R1.2), U16.17 (AMUTEI)
unnamed: RN4.7 (R2.2), U16.21 (MD/SDA/DEMP)
unnamed: RN4.6 (R3.2), U16.22 (MC/SCL/FMT)
unnamed: RN5.8 (R1.2), U10.1 (LRCK)
unnamed: RN5.7 (R2.2), U10.2 (BCK)
unnamed: RN5.6 (R3.2), U10.3 (DIN)
unnamed: RN5.5 (R4.2), U10.5 (SCKI)
unnamed: RN6.8 (R1.2), U10.17 (AMUTEI)
unnamed: RN6.7 (R2.2), U10.21 (MD/SDA/DEMP)
unnamed: RN6.6 (R3.2), U10.22 (MC/SCL/FMT)
unnamed: RN7.1 (R1.1), U7.18 (SCKI)
unnamed: RN7.2 (R2.1), U7.17 (LRCK/DSDBCK)
unnamed: RN7.3 (R3.1), U7.16 (BCK/DSDL)
unnamed: RN7.4 (R4.1), U7.15 (DATA/DSDR)
unnamed: RN8.1 (R1.1), U44.18 (SCKI)
unnamed: RN8.2 (R2.1), U44.17 (LRCK/DSDBCK)
unnamed: RN8.3 (R3.1), U44.16 (BCK/DSDL)
unnamed: RN8.4 (R4.1), U44.15 (DATA/DSDR)
unnamed: C9.1, C13.1, R5.2, U1.8 (VCC1)
unnamed: C12.1, C14.1, R8.2, U1.16 (VCC2)
unnamed: C134.1, C136.1, U1.9 (VCOM)
unnamed: R10.1, R11.1, U1.12 (VOUTL+)
unnamed: R9.2, R12.1, U1.11 (VOUTL-)
unnamed: R14.1, R15.1, U1.13 (VOUTR+)
unnamed: R13.2, R16.1, U1.14 (VOUTR-)
unnamed: C21.1, R23.2, U2.3 (+)
unnamed: C22.1, R24.2, U2.2 (-)
unnamed: C23.1, R21.2, U2.5 (+)
unnamed: C24.1, R22.2, U2.6 (-)
unnamed: C1.1, C3.1, R1.2, U2.8 (V+)
unnamed: C2.2, C4.2, R2.1, U2.4 (V-)
unnamed: C25.1, R11.2, R17.1, U3.8 (VIN+)
unnamed: C26.1, R12.2, R18.1, U3.1 (VIN-)
unnamed: C26.2, R32.1, U3.4 (VOUT+)
unnamed: C25.2, R31.1, U3.5 (VOUT-)
unnamed: C6.1, C7.1, R3.2, U3.3 (V+)
unnamed: C8.2, C10.2, R4.1, U3.6 (V-)
unnamed: C27.1, R15.2, R19.1, U4.8 (VIN+)
unnamed: C28.1, R16.2, R20.1, U4.1 (VIN-)
unnamed: C28.2, R34.1, U4.4 (VOUT+)
unnamed: C27.2, R33.1, U4.5 (VOUT-)
unnamed: C11.1, C15.1, R6.2, U4.3 (V+)
unnamed: C16.2, C19.2, R7.1, U4.6 (V-)
unnamed: C35.1, R37.2, R41.1, U5.8 (VIN+)
unnamed: C40.1, R40.2, R42.1, U5.1 (VIN-)
unnamed: U5.2 (VOCM), U6.6 (-), U6.7
unnamed: C40.2, R44.1, U5.4 (VOUT+)
unnamed: C35.2, R43.1, U5.5 (VOUT-)
unnamed: C20.1, C31.1, R35.2, U5.3 (V+)
unnamed: C32.2, C33.2, R36.1, U5.6 (V-)
unnamed: R37.1, U6.1, U6.2 (-)
unnamed: C104.2, R103.1, U6.5 (+)
unnamed: C34.1, C36.1, R38.2, U6.8 (V+)
unnamed: C37.2, C38.2, R39.1, U6.4 (V-)
unnamed: R124.1, U7.9 (OSR0)
unnamed: R125.1, U7.10 (OSR1)
unnamed: R181.1, U7.11 (OSR2)
unnamed: C88.2, C89.1, R48.2, U7.22 (VCC)
unnamed: C84.1, R103.2, U7.3 (VCOML)
unnamed: C111.1, R112.2, U7.26 (VCOMR)
unnamed: C41.1, R41.2, R43.2, U7.4 (VINL+)
unnamed: C41.2, R42.2, R44.2, U7.5 (VINL-)
unnamed: C108.1, R108.2, R110.2, U7.25 (VINR+)
unnamed: C108.2, R109.2, R111.2, U7.24 (VINR-)
unnamed: C86.1, U7.1 (VREFL)
unnamed: C87.1, U7.28 (VREFR)
unnamed: TP12.1, U9.1 (VIN), U18.1 (VOUT), U18.2 (VOUT)
unnamed: C46.1, C60.1, R50.2, U10.8 (VCC1)
unnamed: C47.1, C61.1, R51.2, U10.16 (VCC2)
unnamed: C183.1, C184.1, U10.9 (VCOM)
unnamed: R59.1, U10.12 (VOUTL+)
unnamed: R58.1, U10.11 (VOUTL-)
unnamed: R62.1, U10.13 (VOUTR+)
unnamed: R63.1, U10.14 (VOUTR-)
unnamed: C68.1, R60.2, R71.1, U11.8 (VIN+)
unnamed: C69.1, R61.2, R70.1, U11.1 (VIN-)
unnamed: C69.2, R81.1, U11.4 (VOUT+)
unnamed: C68.2, R80.1, U11.5 (VOUT-)
unnamed: C50.1, C53.1, R52.2, U11.3 (V+)
unnamed: C51.2, C54.2, R53.1, U11.6 (V-)
unnamed: TP9.1, U12.6 (+VIN), U13.6 (+VIN), U20.1 (VOUT), U20.2 (VOUT)
unnamed: C52.1, C56.1, R54.2, U16.8 (VCC1)
unnamed: C55.1, C57.1, R57.2, U16.16 (VCC2)
unnamed: C174.1, C176.1, U16.9 (VCOM)
unnamed: R61.1, U16.12 (VOUTL+)
unnamed: R60.1, U16.11 (VOUTL-)
unnamed: R64.1, U16.13 (VOUTR+)
unnamed: R65.1, U16.14 (VOUTR-)
unnamed: C70.1, R64.2, R72.1, U17.8 (VIN+)
unnamed: C71.1, R65.2, R73.1, U17.1 (VIN-)
unnamed: C71.2, R83.1, U17.4 (VOUT+)
unnamed: C70.2, R82.1, U17.5 (VOUT-)
unnamed: C58.1, C62.1, R55.2, U17.3 (V+)
unnamed: C59.2, C63.2, R56.1, U17.6 (V-)
unnamed: C64.1, R58.2, R67.1, U22.8 (VIN+)
unnamed: C65.1, R59.2, R66.1, U22.1 (VIN-)
unnamed: C65.2, R75.1, U22.4 (VOUT+)
unnamed: C64.2, R74.1, U22.5 (VOUT-)
unnamed: C76.1, C80.1, R78.2, U22.3 (V+)
unnamed: C77.2, C81.2, R79.1, U22.6 (V-)
unnamed: C66.1, R62.2, R68.1, U23.8 (VIN+)
unnamed: C67.1, R63.2, R69.1, U23.1 (VIN-)
unnamed: C67.2, R77.1, U23.4 (VOUT+)
unnamed: C66.2, R76.1, U23.5 (VOUT-)
unnamed: C78.1, C82.1, R84.2, U23.3 (V+)
unnamed: C79.2, C83.2, R85.1, U23.6 (V-)
unnamed: R162.1, U24.3 (+), U38.11 (VOUTR)
unnamed: R106.1, U24.1, U24.2 (-)
unnamed: C109.2, R112.1, U24.5 (+)
unnamed: U24.6 (-), U24.7, U25.2 (VOCM)
unnamed: C91.1, C98.1, R47.2, U24.8 (V+)
unnamed: C97.2, C99.2, R87.1, U24.4 (V-)
unnamed: C106.1, R106.2, R108.1, U25.8 (VIN+)
unnamed: C107.1, R107.2, R109.1, U25.1 (VIN-)
unnamed: C107.2, R111.1, U25.4 (VOUT+)
unnamed: C106.2, R110.1, U25.5 (VOUT-)
unnamed: C100.1, C102.1, R88.2, U25.3 (V+)
unnamed: C101.2, C103.2, R102.1, U25.6 (V-)
unnamed: C141.1, R164.2, R166.1, U26.8 (VIN+)
unnamed: C142.1, R147.2, R167.1, U26.1 (VIN-)
unnamed: U26.2 (VOCM), U33.1, U33.2 (-)
unnamed: C142.2, R173.1, U26.4 (VOUT+)
unnamed: C141.2, R172.1, U26.5 (VOUT-)
unnamed: C96.1, C115.1, R114.2, U26.3 (V+)
unnamed: C110.2, C116.2, R115.1, U26.6 (V-)
unnamed: C143.1, R165.2, R168.1, U27.8 (VIN+)
unnamed: C144.1, R163.2, R169.1, U27.1 (VIN-)
unnamed: U27.2 (VOCM), U33.6 (-), U33.7
unnamed: C144.2, R175.1, U27.4 (VOUT+)
unnamed: C143.2, R174.1, U27.5 (VOUT-)
unnamed: C117.1, C119.1, R116.2, U27.3 (V+)
unnamed: C118.2, C120.2, R117.1, U27.6 (V-)
unnamed: R93.1, R95.1, U30.3 (+)
unnamed: R93.2, R96.1, U30.5 (+)
unnamed: C161.1, C163.1, R118.2, U30.8 (V+)
unnamed: C162.2, C164.2, R119.1, U30.4 (V-)
unnamed: R94.1, R97.1, U32.3 (+)
unnamed: R94.2, R98.1, U32.5 (+)
unnamed: C165.1, C167.1, R120.2, U32.8 (V+)
unnamed: C166.2, C168.2, R121.1, U32.4 (V-)
unnamed: C145.2, R170.1, U33.3 (+)
unnamed: C146.2, R171.1, U33.5 (+)
unnamed: C169.1, C171.1, R122.2, U33.8 (V+)
unnamed: C170.2, C172.2, R123.1, U33.4 (V-)
unnamed: R128.1, U34.3 (+)
unnamed: R144.1, R146.2, U34.6 (-)
unnamed: R162.2, U35.3 (+)
unnamed: R148.1, R150.2, U35.6 (-)
unnamed: C137.1, R133.2, R160.1, U36.5 (+), U36.7 (+), U36.9 (+), U36.11 (+)
unnamed: R143.2, R146.1, U34.7, U36.4 (-)
unnamed: R142.2, R143.1, U36.6 (-)
unnamed: R134.2, R142.1, U36.10 (-)
unnamed: R134.1, R135.2, U36.8 (-)
unnamed: C140.1, R155.2, R161.1, U37.5 (+), U37.7 (+), U37.9 (+), U37.11 (+)
unnamed: R150.1, R151.2, U35.7, U37.4 (-)
unnamed: R151.1, R152.2, U37.6 (-)
unnamed: R152.1, R153.2, U37.10 (-)
unnamed: R153.1, R154.2, U37.8 (-)
unnamed: U38.6 (SCLK), U39.8 (B1)
unnamed: U38.3 (SDI), U39.1 (B2)
unnamed: C125.1, C126.2, R136.2, U38.12 (VA+)
unnamed: C131.2, C132.2, R137.2, U38.13 (VA-)
unnamed: R128.2, U6.3 (+), U38.14 (VOUTL)
unnamed: C159.1, R197.2, R199.1, U40.5 (+), U40.7 (+), U40.9 (+), U40.11 (+)
unnamed: R187.1, R189.2, U40.4 (-), U42.7
unnamed: R189.1, R190.2, U40.6 (-)
unnamed: R190.1, R191.2, U40.10 (-)
unnamed: R191.1, R192.2, U40.8 (-)
unnamed: C160.1, R198.2, R200.1, U41.5 (+), U41.7 (+), U41.9 (+), U41.11 (+)
unnamed: R188.1, R193.2, U41.4 (-), U43.7
unnamed: R193.1, R194.2, U41.6 (-)
unnamed: R194.1, R195.2, U41.10 (-)
unnamed: R195.1, R196.2, U41.8 (-)
unnamed: R210.1, U42.3 (+), U45.1
unnamed: R183.1, R187.2, U42.6 (-)
unnamed: R179.1, U43.3 (+), U45.7
unnamed: R184.1, R188.2, U43.6 (-)
unnamed: R182.1, U44.9 (OSR0)
unnamed: R213.1, U44.10 (OSR1)
unnamed: R214.1, U44.11 (OSR2)
unnamed: C152.1, C154.2, R176.2, U44.22 (VCC)
unnamed: C147.1, R170.2, U44.3 (VCOML)
unnamed: C148.1, R171.2, U44.26 (VCOMR)
unnamed: C149.1, R166.2, R172.2, U44.4 (VINL+)
unnamed: C149.2, R167.2, R173.2, U44.5 (VINL-)
unnamed: C150.1, R168.2, R174.2, U44.25 (VINR+)
unnamed: C150.2, R169.2, R175.2, U44.24 (VINR-)
unnamed: C151.1, U44.1 (VREFL)
unnamed: C153.1, U44.28 (VREFR)
unnamed: R211.1, R212.2, U45.3 (+)
unnamed: R209.1, R210.2, U45.2 (-)
unnamed: R178.1, R180.2, U45.5 (+)
unnamed: R177.1, R179.2, U45.6 (-)
