HeinVerhallen/Audio-DSP/KiCAD/-15V SEPIC/-15V SEPIC.kicad_pcb

## KiCad design KiCAD/-15V SEPIC/-15V SEPIC.kicad_pcb (2023-06-15)

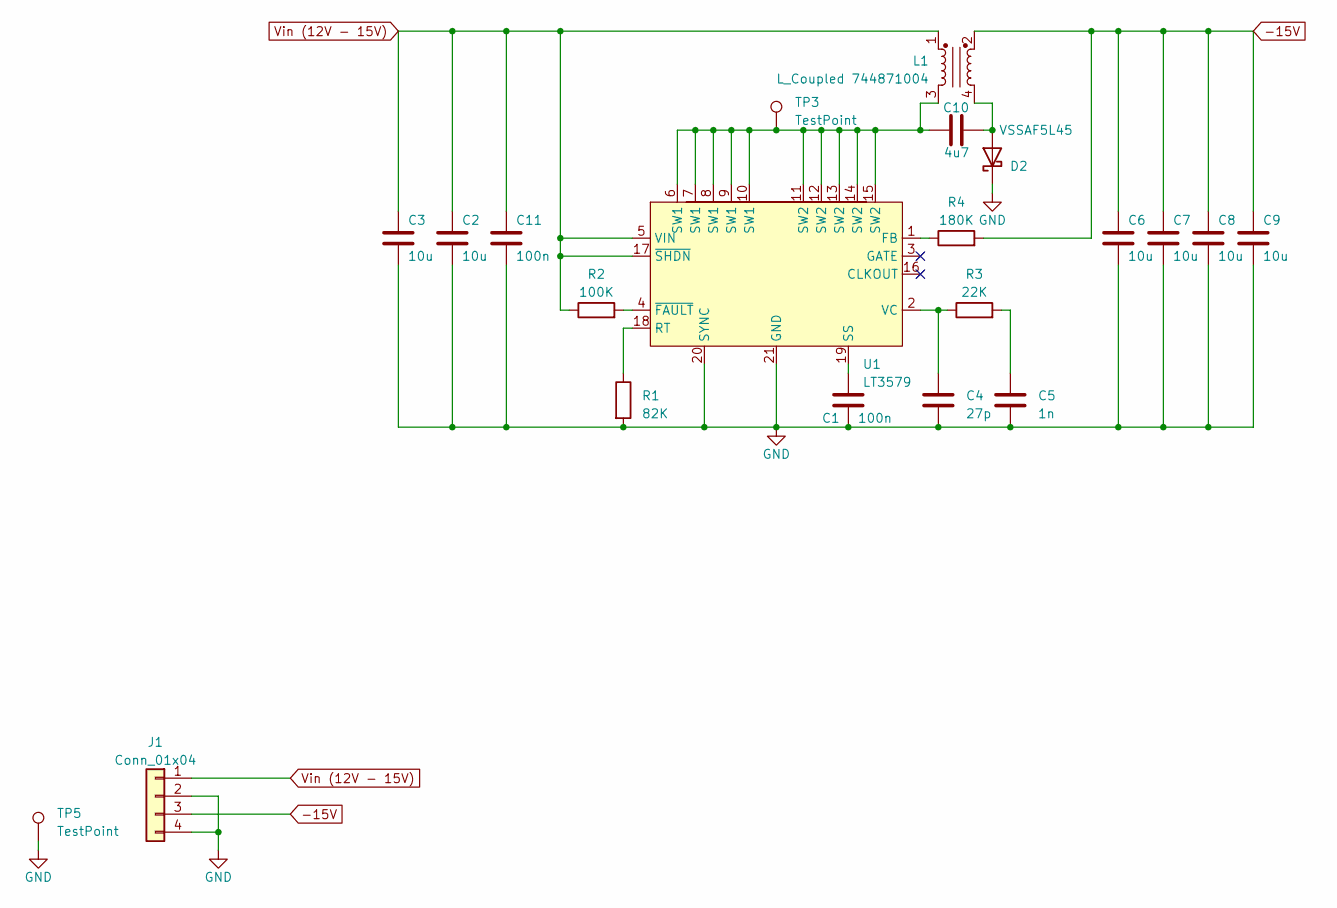
[picture p171: schematic -15V SEPIC.kicad_sch]

Parts:
C1, C11: 100n; C_0402_1005Metric
C2, C3, C6, C7, C8, C9: 10u; C_1210_3225Metric
C4: 27p; C_0402_1005Metric
C5: 1n; C_0402_1005Metric
C10: 4u7; C_1210_3225Metric
D2: VSSAF5L45; DO-221AC
J1: Conn_01x04; PinHeader_1x04_P2.54mm_Horizontal
L1: L_Coupled 744871004; L_Wuerth_WE-DD-Typ-L-Typ-XL-Typ-XXL
R1: 82K; R_0402_1005Metric
R2: 100K; R_0402_1005Metric
R3: 22K; R_0402_1005Metric
R4: 180K; R_0402_1005Metric
TP3, TP5: TestPoint; TestPoint_Pad_D1.0mm
U1: LT3579; TSSOP-20-1EP_4.4x6.5mm_P0.65mm_EP2.75x3.85mm

Connections:
-15V: C6.1, C7.1, C8.1, C9.1, J1.3, L1.2, R4.2
GND: C1.2, C2.2, C3.2, C4.2, C5.2, C6.2, C7.2, C8.2, C9.2, C11.2, D2.1 (K), J1.2, J1.4, R1.2, TP5.1, U1.20 (SYNC), U1.21 (GND)
unnamed: C5.1, R3.2
unnamed: C10.1, L1.3, TP3.1, U1.6 (SW1), U1.7 (SW1), U1.8 (SW1), U1.9 (SW1), U1.10 (SW1), U1.11 (SW2), U1.12 (SW2), U1.13 (SW2), U1.14 (SW2), U1.15 (SW2)
unnamed: C10.2, D2.2 (A), L1.4
unnamed: R4.1, U1.1 (FB)
unnamed: R1.1, U1.18 (RT)
unnamed: C1.1, U1.19 (SS)
unnamed: C4.1, R3.1, U1.2 (VC)
unnamed: R2.2, U1.4 (~FAULT)
Vin (12V - 15V): C2.1, C3.1, C11.1, J1.1, L1.1, R2.1, U1.5 (VIN), U1.17 (~SHDN)

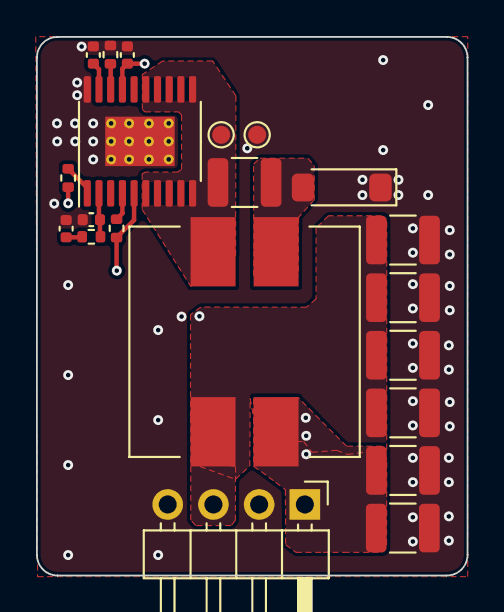
[picture p172: board -15V SEPIC.kicad_pcb from above]

Board: 4 copper layers, 23.9 x 29.9 mm, 21 parts (0 on the bottom side), 11 nets.
