HeinVerhallen/Audio-DSP/KiCAD/Discrete_linear_regulator/Discrete_linear_regulator.kicad_pcb

## KiCad design KiCAD/Discrete_linear_regulator/Discrete_linear_regulator.kicad_pcb (2023-06-15)

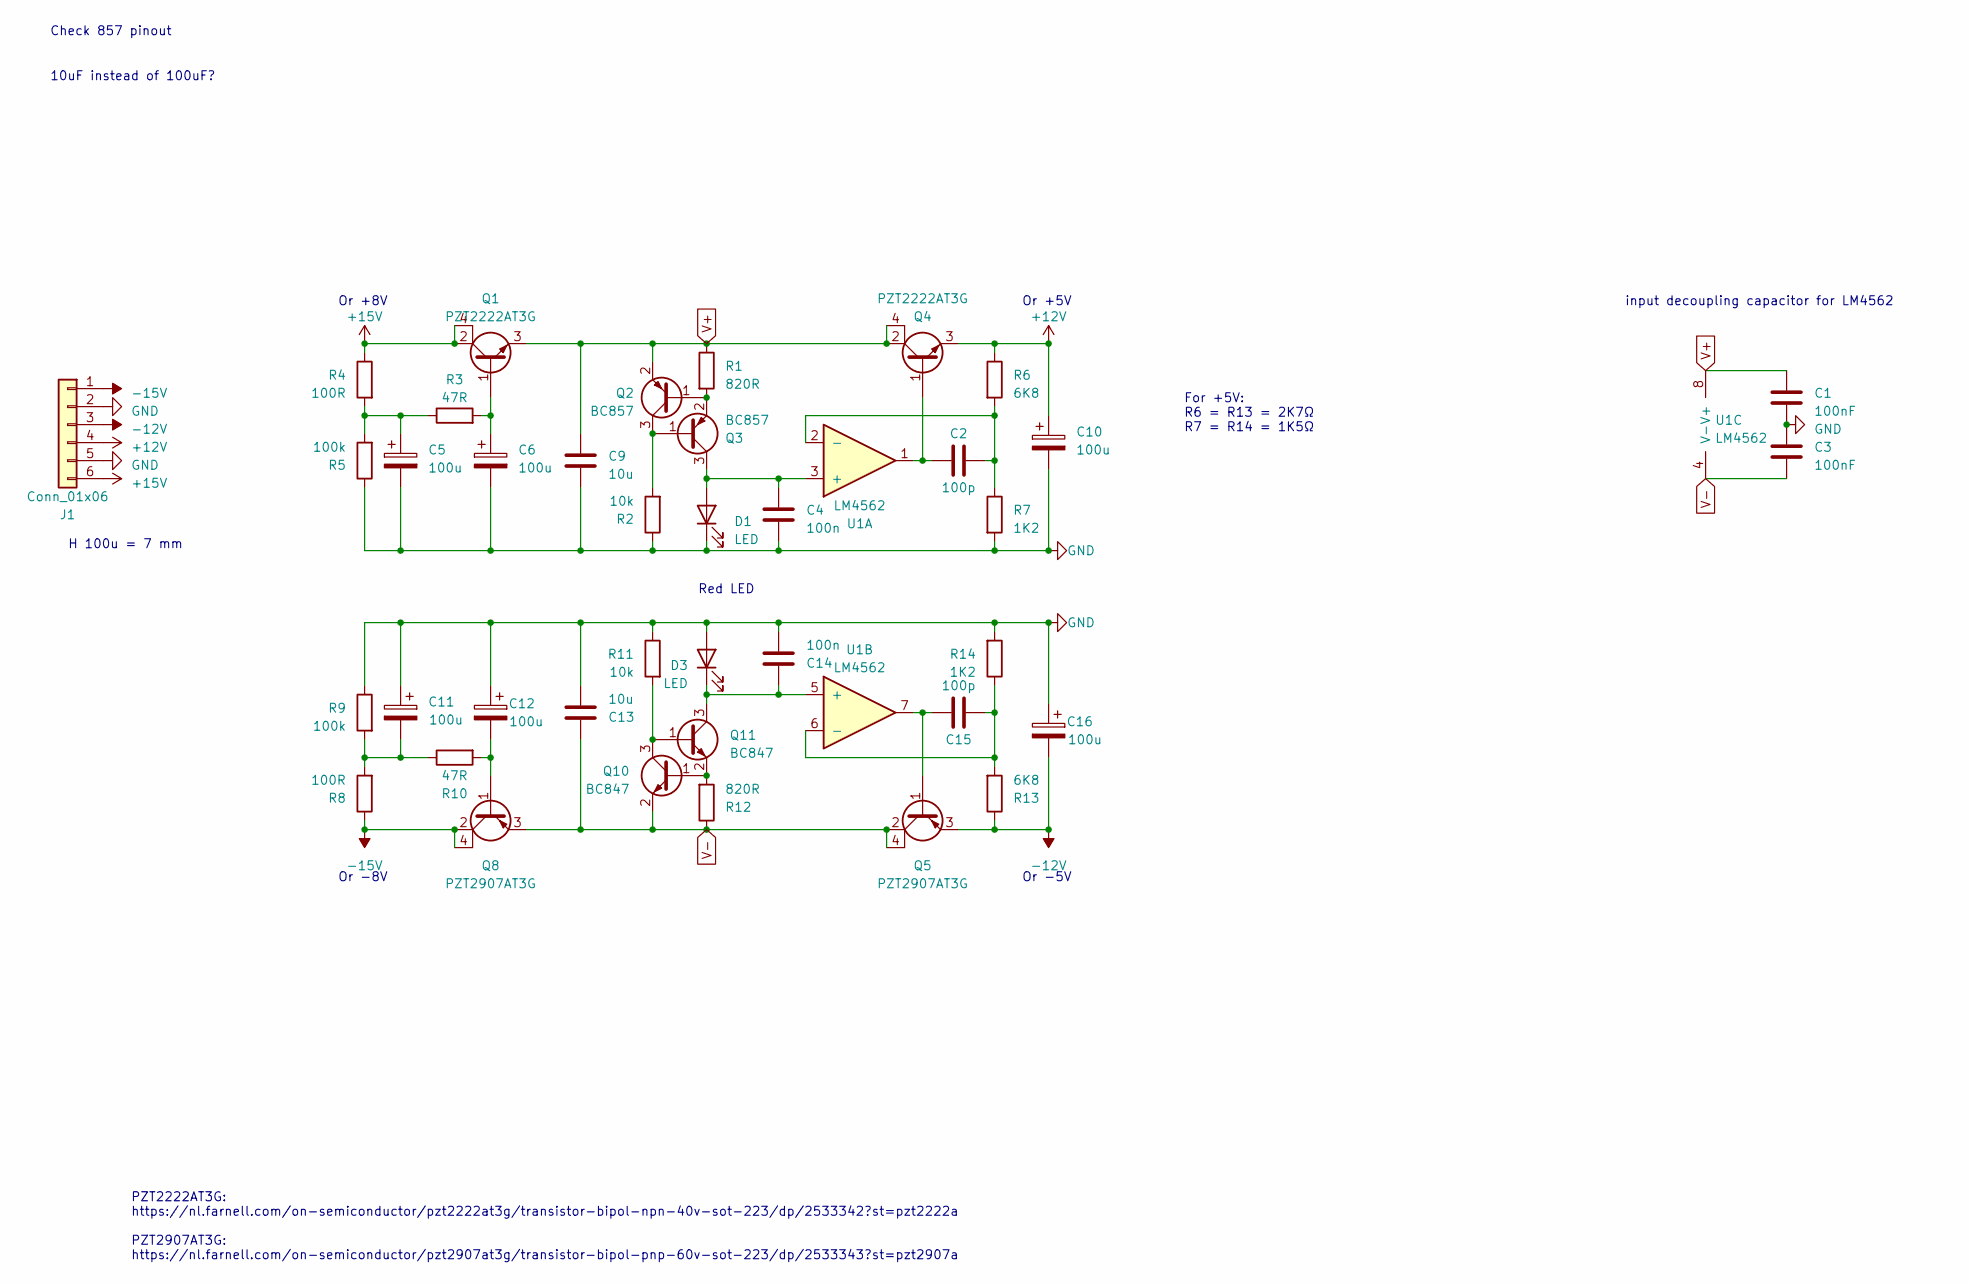
[picture p173: schematic Discrete_linear_regulator.kicad_sch]

Parts:
C1, C3: 100nF; C_0402_1005Metric
C2, C15: 100p; C_0402_1005Metric
C4, C14: 100n; C_0402_1005Metric
C5, C6, C10, C11, C12, C16: 100u; CP_Radial_D8.0mm_P3.50mm
C9, C13: 10u; C_1210_3225Metric
D1, D3: LED; LED_0805_2012Metric
J1: Conn_01x06; PinHeader_1x06_P2.54mm_Horizontal
Q1, Q4: PZT2222AT3G; SOT-223
Q2, Q3: BC857; SOT-23
Q5, Q8: PZT2907AT3G; SOT-223
Q10, Q11: BC847; SOT-23
R1, R12: 820R; R_0402_1005Metric
R2, R11: 10k; R_0402_1005Metric
R3, R10: 47R; R_0402_1005Metric
R4, R8: 100R; R_0402_1005Metric
R5, R9: 100k; R_0402_1005Metric
R6, R13: 6K8; R_0402_1005Metric
R7, R14: 1K2; R_0402_1005Metric
U1: LM4562; SOIC-8_3.9x4.9mm_P1.27mm

Connections:
+12V: C10.1, J1.4, Q4.3, R6.1
+15V: J1.6, Q1.2, Q1.4, R4.1
-12V: C16.2, J1.3, Q5.3, R13.1
-15V: J1.1, Q8.2, Q8.4, R8.1
GND: C1.2, C3.1, C4.2, C5.2, C6.2, C9.2, C10.2, C11.1, C12.1, C13.2, C14.2, C16.1, D1.1 (K), D3.2 (A), J1.2, J1.5, R2.1, R5.1, R7.2, R9.1, R11.1, R14.2
unnamed: C2.2, Q4.1, U1.1
unnamed: C5.1, R3.1, R4.2, R5.2
unnamed: C6.1, Q1.1, R3.2
unnamed: C11.2, R8.2, R9.2, R10.1
unnamed: C12.2, Q8.1, R10.2
unnamed: C15.2, Q5.1, U1.7
unnamed: C4.1, D1.2 (A), Q3.3 (C), U1.3 (+)
unnamed: C14.1, D3.1 (K), Q11.3 (C), U1.5 (+)
unnamed: Q2.1 (B), Q3.2 (E), R1.2
unnamed: Q2.3 (C), Q3.1 (B), R2.2
unnamed: Q10.1 (B), Q11.2 (E), R12.2
unnamed: Q10.3 (C), Q11.1 (B), R11.2
unnamed: C2.1, R6.2, R7.1, U1.2 (-)
unnamed: C15.1, R13.2, R14.1, U1.6 (-)
V+: C1.1, C9.1, Q1.3, Q2.2 (E), Q4.2, Q4.4, R1.1, U1.8 (V+)
V-: C3.2, C13.1, Q5.2, Q5.4, Q8.3, Q10.2 (E), R12.1, U1.4 (V-)

Notes on the sheet:
PZT2222AT3G: https://nl.farnell.com/on-semiconductor/pzt2222at3g/transistor-bipol-npn-40v-sot-223/dp/2533342?st=pzt2222a PZT2907AT3G: https://nl.farnell.com/on-semiconductor/pzt2907at3g/transistor-bipol-pnp-60v-sot-223/dp/2533343?st=pzt2907a
Or +5V
Check 857 pinout
Or -5V
For +5V: R6 = R13 = 2K7Ω R7 = R14 = 1K5Ω
Or -8V
input decoupling capacitor for LM4562
10uF instead of 100uF?
Or +8V
H 100u = 7 mm
Red LED

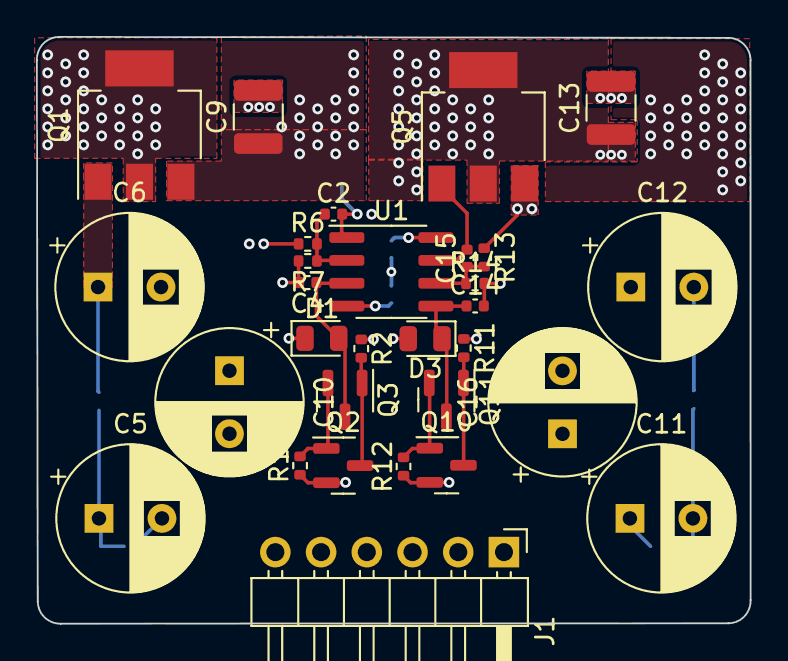
[picture p174: board Discrete_linear_regulator.kicad_pcb from above]

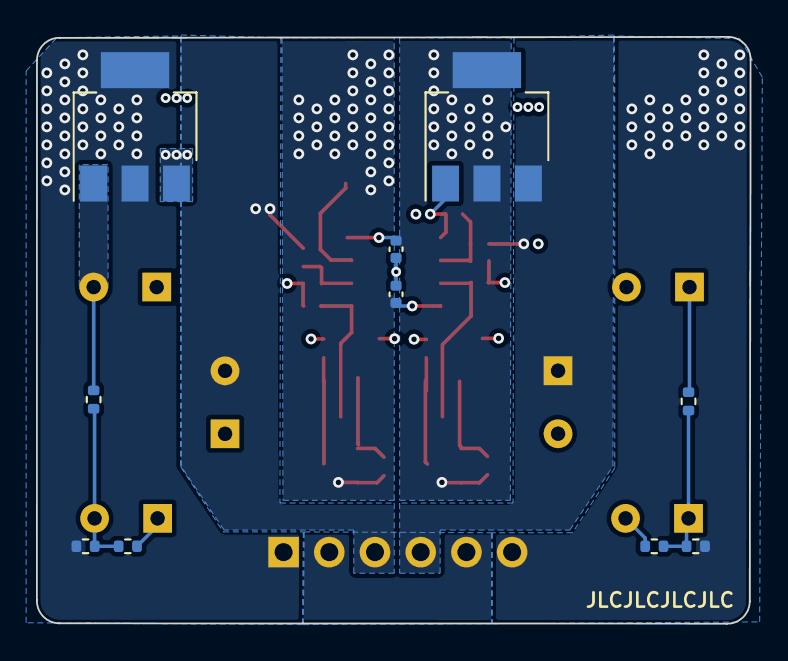
[picture p175: board Discrete_linear_regulator.kicad_pcb from below]

Board: 4 copper layers, 39.7 x 32.6 mm, 40 parts (10 on the bottom side), 21 nets.
