HeinVerhallen/Audio-DSP/KiCAD/Generic_Buck_Converter/Generic_Buck_Converter.kicad_pcb

## KiCad design KiCAD/Generic_Buck_Converter/Generic_Buck_Converter.kicad_pcb (2023-05-11)

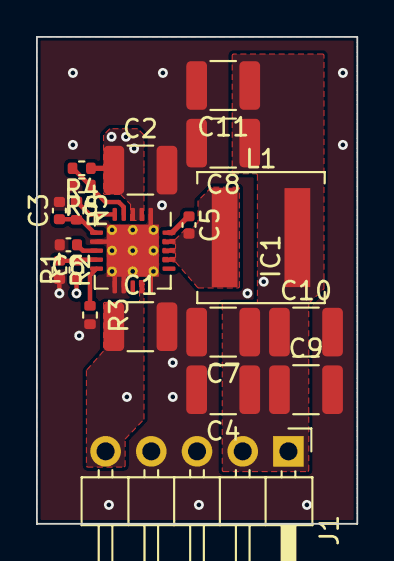
[picture p176: board Generic_Buck_Converter.kicad_pcb from above]

Board: 4 copper layers, 17.8 x 27.0 mm, 20 parts (0 on the bottom side), 11 nets.

Parts:
C1, C2, C4, C7, C8, C9, C10, C11: C; C_1210_3225Metric
C3, C5, C6: C; C_0402_1005Metric
IC1: MAX17634C; TQFN-20-1EP_4x4mm_P0.5mm_EP2.9x2.9mm_ThermalVias_(JLCPCB_Co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
J1: Conn_01x05; PinHeader_1x05_P2.54mm_Horizontal
L1: L; L_Coilcraft_XAL6060-XXX
R1, R2, R3, R4, R5, R6: R; R_0402_1005Metric

Connections:
/Vin: C1.1, C2.1, IC1.2 (IN), IC1.3 (IN), IC1.14 (IN), J1.5, R4.1
/Vout: C4.1, C7.1, C8.1, C9.1, C10.1, C11.1, J1.1, J1.2, L1.2, R1.1
GND: C1.2, C2.2, C3.2, C4.2, C6.2, C7.2, C8.2, C9.2, C10.2, C11.2, IC1.1 (PGND), IC1.7 (SGND), IC1.11 (MODE/SYNC), IC1.12 (EXTVCC), IC1.15 (PGND), IC1.21 (EP), J1.3, J1.4, R2.2, R3.2, R6.2
unnamed: C5.2, IC1.17 (LX), IC1.18 (LX), IC1.19 (LX), L1.1
unnamed: C5.1, IC1.20 (BST)
unnamed: IC1.4 (EN/UVLO), R4.2, R6.1
unnamed: IC1.9 (FB), R1.2, R2.1
unnamed: C3.1, IC1.6 (INTVCC), R5.2
unnamed: IC1.5 (RESET), R5.1
unnamed: IC1.10 (RT), R3.1
unnamed: C6.1, IC1.8 (SS)
