HeinVerhallen/Audio-DSP/KiCAD/12V_linear_regulator/12V_linear_regulator.kicad_pcb

## KiCad design KiCAD/12V_linear_regulator/12V_linear_regulator.kicad_pcb (2023-04-18)

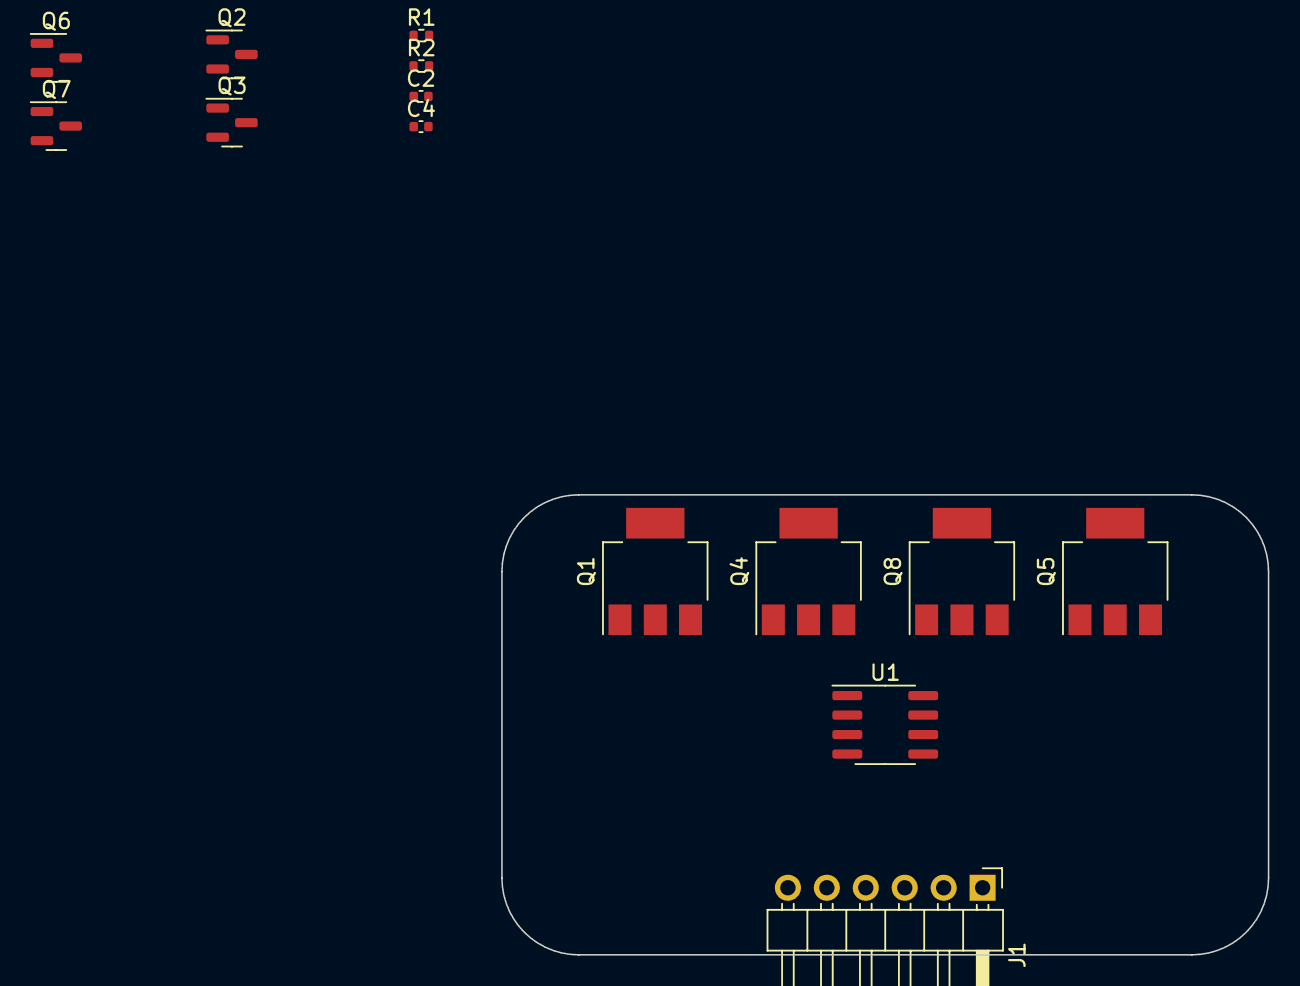
[picture p177: board 12V_linear_regulator.kicad_pcb from above]

Board: 2 copper layers, 50.0 x 30.0 mm, 14 parts (0 on the bottom side), 8 nets, no tracks yet.

Parts:
C2, C4: 100p; C_0402_1005Metric
J1: Conn_01x06; PinHeader_1x06_P2.54mm_Horizontal
Q1, Q4: PZT2222AT3G; SOT-223
Q2, Q3: BC857; SOT-23
Q5, Q8: PZT2907AT3G; SOT-223
Q6, Q7: BC847; SOT-23
R1: 780R; R_0402_1005Metric
R2: 10k; R_0402_1005Metric
U1: LM4562; SOIC-8_3.9x4.9mm_P1.27mm

Connections:
+12V: J1.3, Q4.3
+15V: J1.1, Q1.2, Q1.4
GND: C4.2, J1.2, J1.5, R2.1
unnamed: C4.1, Q3.3 (C), U1.3 (+)
unnamed: Q2.1 (B), Q3.2 (E), R1.2
unnamed: Q2.3 (C), Q3.1 (B), R2.2
unnamed: Q1.3, Q2.2 (E), Q4.2, Q4.4, R1.1
unnamed: Q4.1, U1.1
