HeinVerhallen/Audio-DSP/Firmware/SDRAM_R1.0/quartus project/synthesis/SDRAM.vhd

-- SDRAM.vhd

-- Generated using ACDS version 17.0 595

library IEEE;
use IEEE.std_logic_1164.all;
use IEEE.numeric_std.all;

entity SDRAM is
	port (
		clk_clk                       : in    std_logic                     := '0';             --             clk.clk
		clk143_clk                    : out   std_logic;                                        --          clk143.clk
		reset_reset_n                 : in    std_logic                     := '0';             --           reset.reset_n
		sdramcontroller_address       : in    std_logic_vector(24 downto 0) := (others => '0'); -- sdramcontroller.address
		sdramcontroller_byteenable_n  : in    std_logic_vector(1 downto 0)  := (others => '0'); --                .byteenable_n
		sdramcontroller_chipselect    : in    std_logic                     := '0';             --                .chipselect
		sdramcontroller_writedata     : in    std_logic_vector(15 downto 0) := (others => '0'); --                .writedata
		sdramcontroller_read_n        : in    std_logic                     := '0';             --                .read_n
		sdramcontroller_write_n       : in    std_logic                     := '0';             --                .write_n
		sdramcontroller_readdata      : out   std_logic_vector(15 downto 0);                    --                .readdata
		sdramcontroller_readdatavalid : out   std_logic;                                        --                .readdatavalid
		sdramcontroller_waitrequest   : out   std_logic;                                        --                .waitrequest
		wire_addr                     : out   std_logic_vector(12 downto 0);                    --            wire.addr
		wire_ba                       : out   std_logic_vector(1 downto 0);                     --                .ba
		wire_cas_n                    : out   std_logic;                                        --                .cas_n
		wire_cke                      : out   std_logic;                                        --                .cke
		wire_cs_n                     : out   std_logic;                                        --                .cs_n
		wire_dq                       : inout std_logic_vector(15 downto 0) := (others => '0'); --                .dq
		wire_dqm                      : out   std_logic_vector(1 downto 0);                     --                .dqm
		wire_ras_n                    : out   std_logic;                                        --                .ras_n
		wire_we_n                     : out   std_logic                                         --                .we_n
	);
end entity SDRAM;

architecture rtl of SDRAM is
	component SDRAM_PLL_143MHz is
		port (
			refclk   : in  std_logic := 'X'; -- clk
			rst      : in  std_logic := 'X'; -- reset
			outclk_0 : out std_logic;        -- clk
			outclk_1 : out std_logic;        -- clk
			locked   : out std_logic         -- export
		);
	end component SDRAM_PLL_143MHz;

	component SDRAM_SDRAM_controller is
		port (
			clk            : in    std_logic                     := 'X';             -- clk
			reset_n        : in    std_logic                     := 'X';             -- reset_n
			az_addr        : in    std_logic_vector(24 downto 0) := (others => 'X'); -- address
			az_be_n        : in    std_logic_vector(1 downto 0)  := (others => 'X'); -- byteenable_n
			az_cs          : in    std_logic                     := 'X';             -- chipselect
			az_data        : in    std_logic_vector(15 downto 0) := (others => 'X'); -- writedata
			az_rd_n        : in    std_logic                     := 'X';             -- read_n
			az_wr_n        : in    std_logic                     := 'X';             -- write_n
			za_data        : out   std_logic_vector(15 downto 0);                    -- readdata
			za_valid       : out   std_logic;                                        -- readdatavalid
			za_waitrequest : out   std_logic;                                        -- waitrequest
			zs_addr        : out   std_logic_vector(12 downto 0);                    -- export
			zs_ba          : out   std_logic_vector(1 downto 0);                     -- export
			zs_cas_n       : out   std_logic;                                        -- export
			zs_cke         : out   std_logic;                                        -- export
			zs_cs_n        : out   std_logic;                                        -- export
			zs_dq          : inout std_logic_vector(15 downto 0) := (others => 'X'); -- export
			zs_dqm         : out   std_logic_vector(1 downto 0);                     -- export
			zs_ras_n       : out   std_logic;                                        -- export
			zs_we_n        : out   std_logic                                         -- export
		);
	end component SDRAM_SDRAM_controller;

	component altera_reset_controller is
		generic (
			NUM_RESET_INPUTS          : integer := 6;
			OUTPUT_RESET_SYNC_EDGES   : string  := "deassert";
			SYNC_DEPTH                : integer := 2;
			RESET_REQUEST_PRESENT     : integer := 0;
			RESET_REQ_WAIT_TIME       : integer := 1;
			MIN_RST_ASSERTION_TIME    : integer := 3;
			RESET_REQ_EARLY_DSRT_TIME : integer := 1;
			USE_RESET_REQUEST_IN0     : integer := 0;
			USE_RESET_REQUEST_IN1     : integer := 0;
			USE_RESET_REQUEST_IN2     : integer := 0;
			USE_RESET_REQUEST_IN3     : integer := 0;
			USE_RESET_REQUEST_IN4     : integer := 0;
			USE_RESET_REQUEST_IN5     : integer := 0;
			USE_RESET_REQUEST_IN6     : integer := 0;
			USE_RESET_REQUEST_IN7     : integer := 0;
			USE_RESET_REQUEST_IN8     : integer := 0;
			USE_RESET_REQUEST_IN9     : integer := 0;
			USE_RESET_REQUEST_IN10    : integer := 0;
			USE_RESET_REQUEST_IN11    : integer := 0;
			USE_RESET_REQUEST_IN12    : integer := 0;
			USE_RESET_REQUEST_IN13    : integer := 0;
			USE_RESET_REQUEST_IN14    : integer := 0;
			USE_RESET_REQUEST_IN15    : integer := 0;
			ADAPT_RESET_REQUEST       : integer := 0
		);
		port (
			reset_in0      : in  std_logic := 'X'; -- reset
			clk            : in  std_logic := 'X'; -- clk
			reset_out      : out std_logic;        -- reset
			reset_req      : out std_logic;        -- reset_req
			reset_req_in0  : in  std_logic := 'X'; -- reset_req
			reset_in1      : in  std_logic := 'X'; -- reset
			reset_req_in1  : in  std_logic := 'X'; -- reset_req
			reset_in2      : in  std_logic := 'X'; -- reset
			reset_req_in2  : in  std_logic := 'X'; -- reset_req
			reset_in3      : in  std_logic := 'X'; -- reset
			reset_req_in3  : in  std_logic := 'X'; -- reset_req
			reset_in4      : in  std_logic := 'X'; -- reset
			reset_req_in4  : in  std_logic := 'X'; -- reset_req
			reset_in5      : in  std_logic := 'X'; -- reset
			reset_req_in5  : in  std_logic := 'X'; -- reset_req
			reset_in6      : in  std_logic := 'X'; -- reset
			reset_req_in6  : in  std_logic := 'X'; -- reset_req
			reset_in7      : in  std_logic := 'X'; -- reset
			reset_req_in7  : in  std_logic := 'X'; -- reset_req
			reset_in8      : in  std_logic := 'X'; -- reset
			reset_req_in8  : in  std_logic := 'X'; -- reset_req
			reset_in9      : in  std_logic := 'X'; -- reset
			reset_req_in9  : in  std_logic := 'X'; -- reset_req
			reset_in10     : in  std_logic := 'X'; -- reset
			reset_req_in10 : in  std_logic := 'X'; -- reset_req
			reset_in11     : in  std_logic := 'X'; -- reset
			reset_req_in11 : in  std_logic := 'X'; -- reset_req
			reset_in12     : in  std_logic := 'X'; -- reset
			reset_req_in12 : in  std_logic := 'X'; -- reset_req
			reset_in13     : in  std_logic := 'X'; -- reset
			reset_req_in13 : in  std_logic := 'X'; -- reset_req
			reset_in14     : in  std_logic := 'X'; -- reset
			reset_req_in14 : in  std_logic := 'X'; -- reset_req
			reset_in15     : in  std_logic := 'X'; -- reset
			reset_req_in15 : in  std_logic := 'X'  -- reset_req
		);
	end component altera_reset_controller;

	signal pll_143mhz_outclk0_clk                   : std_logic; -- PLL_143MHz:outclk_0 -> [SDRAM_controller:clk, rst_controller:clk]
	signal rst_controller_reset_out_reset           : std_logic; -- rst_controller:reset_out -> rst_controller_reset_out_reset:in
	signal reset_reset_n_ports_inv                  : std_logic; -- reset_reset_n:inv -> [PLL_143MHz:rst, rst_controller:reset_in0]
	signal rst_controller_reset_out_reset_ports_inv : std_logic; -- rst_controller_reset_out_reset:inv -> SDRAM_controller:reset_n

begin

	pll_143mhz : component SDRAM_PLL_143MHz
		port map (
			refclk   => clk_clk,                 --  refclk.clk
			rst      => reset_reset_n_ports_inv, --   reset.reset
			outclk_0 => pll_143mhz_outclk0_clk,  -- outclk0.clk
			outclk_1 => clk143_clk,              -- outclk1.clk
			locked   => open                     -- (terminated)
		);

	sdram_controller : component SDRAM_SDRAM_controller
		port map (
			clk            => pll_143mhz_outclk0_clk,                   --   clk.clk
			reset_n        => rst_controller_reset_out_reset_ports_inv, -- reset.reset_n
			az_addr        => sdramcontroller_address,                  --    s1.address
			az_be_n        => sdramcontroller_byteenable_n,             --      .byteenable_n
			az_cs          => sdramcontroller_chipselect,               --      .chipselect
			az_data        => sdramcontroller_writedata,                --      .writedata
			az_rd_n        => sdramcontroller_read_n,                   --      .read_n
			az_wr_n        => sdramcontroller_write_n,                  --      .write_n
			za_data        => sdramcontroller_readdata,                 --      .readdata
			za_valid       => sdramcontroller_readdatavalid,            --      .readdatavalid
			za_waitrequest => sdramcontroller_waitrequest,              --      .waitrequest
			zs_addr        => wire_addr,                                --  wire.export
			zs_ba          => wire_ba,                                  --      .export
			zs_cas_n       => wire_cas_n,                               --      .export
			zs_cke         => wire_cke,                                 --      .export
			zs_cs_n        => wire_cs_n,                                --      .export
			zs_dq          => wire_dq,                                  --      .export
			zs_dqm         => wire_dqm,                                 --      .export
			zs_ras_n       => wire_ras_n,                               --      .export
			zs_we_n        => wire_we_n                                 --      .export
		);

	rst_controller : component altera_reset_controller
		generic map (
			NUM_RESET_INPUTS          => 1,
			OUTPUT_RESET_SYNC_EDGES   => "deassert",
			SYNC_DEPTH                => 2,
			RESET_REQUEST_PRESENT     => 0,
			RESET_REQ_WAIT_TIME       => 1,
			MIN_RST_ASSERTION_TIME    => 3,
			RESET_REQ_EARLY_DSRT_TIME => 1,
			USE_RESET_REQUEST_IN0     => 0,
			USE_RESET_REQUEST_IN1     => 0,
			USE_RESET_REQUEST_IN2     => 0,
			USE_RESET_REQUEST_IN3     => 0,
			USE_RESET_REQUEST_IN4     => 0,
			USE_RESET_REQUEST_IN5     => 0,
			USE_RESET_REQUEST_IN6     => 0,
			USE_RESET_REQUEST_IN7     => 0,
			USE_RESET_REQUEST_IN8     => 0,
			USE_RESET_REQUEST_IN9     => 0,
			USE_RESET_REQUEST_IN10    => 0,
			USE_RESET_REQUEST_IN11    => 0,
			USE_RESET_REQUEST_IN12    => 0,
			USE_RESET_REQUEST_IN13    => 0,
			USE_RESET_REQUEST_IN14    => 0,
			USE_RESET_REQUEST_IN15    => 0,
			ADAPT_RESET_REQUEST       => 0
		)
		port map (
			reset_in0      => reset_reset_n_ports_inv,        -- reset_in0.reset
			clk            => pll_143mhz_outclk0_clk,         --       clk.clk
			reset_out      => rst_controller_reset_out_reset, -- reset_out.reset
			reset_req      => open,                           -- (terminated)
			reset_req_in0  => '0',                            -- (terminated)
			reset_in1      => '0',                            -- (terminated)
			reset_req_in1  => '0',                            -- (terminated)
			reset_in2      => '0',                            -- (terminated)
			reset_req_in2  => '0',                            -- (terminated)
			reset_in3      => '0',                            -- (terminated)
			reset_req_in3  => '0',                            -- (terminated)
			reset_in4      => '0',                            -- (terminated)
			reset_req_in4  => '0',                            -- (terminated)
			reset_in5      => '0',                            -- (terminated)
			reset_req_in5  => '0',                            -- (terminated)
			reset_in6      => '0',                            -- (terminated)
			reset_req_in6  => '0',                            -- (terminated)
			reset_in7      => '0',                            -- (terminated)
			reset_req_in7  => '0',                            -- (terminated)
			reset_in8      => '0',                            -- (terminated)
			reset_req_in8  => '0',                            -- (terminated)
			reset_in9      => '0',                            -- (terminated)
			reset_req_in9  => '0',                            -- (terminated)
			reset_in10     => '0',                            -- (terminated)
			reset_req_in10 => '0',                            -- (terminated)
			reset_in11     => '0',                            -- (terminated)
			reset_req_in11 => '0',                            -- (terminated)
			reset_in12     => '0',                            -- (terminated)
			reset_req_in12 => '0',                            -- (terminated)
			reset_in13     => '0',                            -- (terminated)
			reset_req_in13 => '0',                            -- (terminated)
			reset_in14     => '0',                            -- (terminated)
			reset_req_in14 => '0',                            -- (terminated)
			reset_in15     => '0',                            -- (terminated)
			reset_req_in15 => '0'                             -- (terminated)
		);

	reset_reset_n_ports_inv <= not reset_reset_n;

	rst_controller_reset_out_reset_ports_inv <= not rst_controller_reset_out_reset;

end architecture rtl; -- of SDRAM
