HeinVerhallen/Audio-DSP/(commit log)

2023-02-28 Cleaned up directories
    Cleaned up .DS_store file and unnecessary files.
    Added planning and code of conduct.
    [Planning.xlsx]
2023-02-28 Create AD conversion example Excel.xlsx
    AD conversion example Excel
    [AD conversion example Excel.xlsx]
2023-02-28 Create Power supply functional decomposition.drawio
    Added block diagram to be used for answering research question
2023-03-01 Update Power supply functional decomposition.drawio
2023-03-09 Added SRD with current word content
2023-03-13 DAC+ADC datasheets
2023-03-15 Cleaned up directory
    Removed all folders except the Documentation and block diagrams folder. All other files are now on the teams environment.
    [AD conversion example Excel.xlsx, Planning.xlsx]
2023-03-15 Create Power supply.drawio
    Power supply copy
2023-03-15 Create .$Power supply.drawio.bkp
    PS
2023-03-15 Update Power supply.drawio
2023-03-16 BACK-END system design
    Updated : Smoothing filter, I added a separate lowpass filter/ Gain Buffer for each channel and then a MUX with a SEL to select which Channel goes to the output.
2023-03-20 Updated system design diagrams
    Updated system context diagram.
    Updated channel manager design diagram and added new page with design for I2C implementation.
2023-03-21 Added an simulations folder for LTspice with an high PSRR ±12V and ±5V regulator
    Added an simulations folder for LTspice with an high PSRR ±12V and ±5V regulator
2023-03-21 Added dropout voltage to design
2023-03-21 Update Discrete linear regulator with high PSRR ±5V.asc
2023-03-22 Update UI design.drawio
    created the UI flow with the effect manager in mind
2023-03-23 Power supply changes
2023-03-23 Power map
2023-03-23 Created signal processor vhdl
    Created signal processor block in VHDL.
    Made working sequential effect loop that gathers the effect loop information from a register.
    On each rising clock edge the input signal will be modified by the effect loop and after its finished through the effect loop the output will be written.
    [c5_pin_model_dump.txt]
2023-03-26 Buck update
2023-03-27 simulations of the buck con
2023-03-30 Updated 12V low noise regulator
2023-03-30 Added -15V sepic
    Added -15V sepic LTspice design with WE-DD library for the coupled inductor.
2023-03-30 Update RF filter, AAF with ADC driver.asc
2023-03-31 update diagram
    [Calculations.xlsx]
2023-04-03 Update PS
    [Calculations.xlsx]
2023-04-03 Increased input series resistance of -15V SEPIC
2023-04-03 update, buck converters
2023-04-03 Updated buck converter
2023-04-03 Create Input filter.asc
2023-04-03 Created arduino screen control
    Created a platformIO project to loop through the screens of the nextion display
2023-04-04 created dropdown menu
    Created a functional dropdown menu using arduino.
2023-04-04 Changed EU symbols of linear regulators to US symbols and decreased dropout to <2V.
    Changed EU symbols of linear regulators to US symbols and decreased dropout to <2V.
2023-04-05 Created DAS project
    Copied DAS DD3P project to test using Audio Codec of FPGA board.
    [c5_pin_model_dump.txt]
2023-04-05 Specified ESD protection devices
2023-04-05 Updated file structure
    [Main board.kicad_pcb, Main board.sch]
2023-04-05 update pcb
2023-04-05 Added standard KiCAD files
    [-15V SEPIC.kicad_pcb, -15V SEPIC.kicad_sch, Negative linear regulator.kicad_pcb, Negative linear regulator.kicad_sch, Positive linear regulator.kicad_pcb, Positive linear regulator.kicad_sch]
2023-04-05 Create Audio_DSP.kicad_sym
    migrated the kicad library
2023-04-05 renamed footprint
2023-04-05 Updated block diagram a bit
    [Positive linear regulator.kicad_sch]
2023-04-05 PCB update
2023-04-05 Updated footprint
2023-04-05 Created UI menu navigation
    updated the arduino code to make it navigate the menu of the nextion screen
2023-04-06 Update Audio_DSP.kicad_sym
    fixed 2 symbols who disapperared
2023-04-06 Create 12V buck converter-2023-04-06_134947.zip
2023-04-06 Create Sampler design.drawio
    Created sampler architecture design to clarify communication between ADCs and DACs
2023-04-06 Added 2nd 12V buck converter to spread load for new buck converters
2023-04-07 Revert "Update Audio_DSP.kicad_sym"
    This reverts commit 97b942fca452e34f375103c1d3247380b4b68824.
2023-04-07 Revert "Update PCB"
    This reverts commit 1b87af315b9f6bfd0c2cdaaff937156b521a3363, reversing
    changes made to eaa0f94790ef4127411d201ada7ecce6da68ceff.
2023-04-07 Revert "Update pcb"
    This reverts commit eaa0f94790ef4127411d201ada7ecce6da68ceff.
    [12V buck converter.kicad_sch]
2023-04-07 Fix footprint merge conflict
2023-04-10 BACK-END PCB
    [DAC CH 1_2.kicad_sch, DAC CH 5_6.kicad_sch, DAC CH3_4.kicad_sch, Main board.kicad_pcb, Main board.kicad_sch, untitled.kicad_sch]
2023-04-11 Updated footprint
    Added solder paste and 3D model
2023-04-11 moved the UI code to correct folder
    [Button.cpp, Button.h, Nextion.cpp, Nextion.h, main.cpp]
2023-04-11 Updated architecture designs
    Updated Front-end design: Set to ADC to master mode, fixed clock divider setting so its now 128xfs.
    Updated Sampler design: 24.576MHz clock now comes from FPGA.
2023-04-11 Pcb test
    [12V buck converter.kicad_pcb, 12V buck converter.kicad_sch]
2023-04-11 Pcb test2
2023-04-11 Symbol update
    [12V buck converter.kicad_sch]
2023-04-11 Added two components to our KiCAD lib
    [Positive linear regulator.kicad_sch]
2023-04-12 update 5V sim
2023-04-13 PS drawio IC update
    [12V buck converter.kicad_pcb]
2023-04-13 Create 12V buck converter-2023-04-12_145752.zip
2023-04-13 Updated KiCAD library and main board schematic
    [DAC CH 1_2.kicad_sch]
2023-04-13 Added some LTspice simulations for the power dissipation of the inductors of the buck converters
    Added some LTspice simulations for the power dissipation of the inductors of the buck converters
2023-04-13 Created audio sampler project
    Started with I2C protocol. Used I2C master from open-source file. Made initializer block which programs the WM8731 in the FPGA board using the I2C master block.
2023-04-15 Updated BACK-END
    [DAC CH 5_6.kicad_sch, DAC CH3_4.kicad_sch, Main board.kicad_sch]
2023-04-17 Started on Front-END
    [ADC CH1_2.kicad_sch, DAC CH3_4.kicad_sch, Main board.kicad_sch, untitled.kicad_sch]
2023-04-17 Update DAS / Audio sampler
    Added i2c master and initializer in DAS project to check if the sampler still works with the new code. It still works perfectly.
2023-04-18 I2S Block
    [c5_pin_model_dump.txt]
2023-04-18 Create Positive linear regulator-2023-04-18_131644.zip
2023-04-18 Added symbol and footprint for general buck converter
2023-04-18 Worked on main board
    [ADC CH 3_4.kicad_sch, ADC_CH 3_4.kicad_sch, ADC_CH1_2.kicad_sch, ADC_CH3_4.kicad_sch, DAC_CH 1_2.kicad_sch, DAC_CH 5_6.kicad_sch, DAC_CH1_2.kicad_sch, DAC_CH3_4.kicad_sch]
2023-04-18 Added remaining buck converters to KiCAD library
2023-04-18 Add Generic PCB to Git
    [Generic_Buck_Converter.kicad_pcb, Generic_Buck_Converter.kicad_sch, Generic_Buck_Converter.step]
2023-04-18 Worked on KiCAD
    [FPGA.kicad_sch, Main board.kicad_pcb, Main board.kicad_sch, POWER_SUPPLIES.kicad_sch]
2023-04-18 Made a start on the +-12V linear regulator
    [12V_linear_regulator.kicad_pcb, 12V_linear_regulator.kicad_sch, 12V_linear_regulator.step, Negative linear regulator.kicad_pcb, Negative linear regulator.kicad_sch, Positive linear regulator.kicad_pcb, Positive linear regulator.kicad_sch]
2023-04-18 Worked a bit on the main board
    [12V_linear_regulator.step, ADC_CH1_2.kicad_sch, DAC_CH1_2.kicad_sch, DAC_CH3_4.kicad_sch, DAC_CH5_6.kicad_sch, Discrete_linear_regulator.kicad_pcb, Discrete_linear_regulator.kicad_sch, Discrete_linear_regulator.step]
2023-04-18 Worked on the main board
    [ADC_CH3_4.kicad_sch, POWER_SUPPLIES.kicad_sch]
2023-04-19 fixed 3D viewer
    [Main board.kicad_pcb]
2023-04-19 Added STEP file of main board
2023-04-19 Updated main step
    [Main board.kicad_pcb]
2023-04-19 Updated main board
    [Main board.kicad_pcb]
2023-04-19 2 codes for the i2s encoder
2023-04-19 Deleted the playground test
    [12V buck converter.kicad_pcb, 12V buck converter.kicad_sch]
2023-04-20 added LT3579 footprint
2023-04-20 fixed symbols excluding from board
    [ADC_CH1_2.kicad_sch, ADC_CH3_4.kicad_sch, DAC_CH1_2.kicad_sch, FPGA.kicad_sch, Main board.kicad_sch]
2023-04-20 update kicad
    [-15V SEPIC.kicad_pcb, -15V SEPIC.kicad_sch]
2023-04-20 Buck PCB
    [Generic_Buck_Converter.kicad_pcb]
2023-04-20 update sepic
    [-15V SEPIC.kicad_pcb]
2023-04-24 Update Audio sampler VHDL
    Created I2S encoder and decoder. Tested the code but the audio has a lot of noise.
    [Audio_sampler.vhd, Initializer.vhd, PLL_MLCK.vhd, PLL_MLCK_0002.v, clk_div.vhd, gpt.vhd, i2s_block.vhd]
2023-04-24 Updated Audio sampler VHDL
    Imported I2S_transceiver VHDL block from internet. This block uses the audio-codec inside the FPGA board as a slave. This has been tested and the audio is sampled correctly without any noise.
    [Audio_sampler.vhd, Initializer.vhd]
2023-04-24 Update Audio sampler
    Improved I2S encoder and decoder such that it now works. Tested with FPGA board and Audio came out correctly.
    [Audio_sampler.vhd, Initializer.vhd, i2s_encoder_v2.vhd]
2023-04-24 work on speic schematic and PCB
    [-15V SEPIC.kicad_pcb, -15V SEPIC.kicad_sch]
2023-04-25 Added 3D model 744871004
    [Main board.kicad_pcb]
2023-04-25 Update Audio sampler
    Fixed bug where sampler worked at 32 bit but not at 24 bit. Now its able to sample at all bit resolutions. Saved .sof files for different scenarios.
    [Audio_sampler.vhd, Initializer.vhd]
2023-04-25 Update audio sampler
    Cleaned up VHDL code and added comments.
2023-04-25 Made symbol and footprint for the FPGA board
    [FPGA.kicad_sch, Main board.kicad_pcb]
2023-04-25 Update Audio sampler
    Created signal processor manager block.
    Created signal processor VHDL.
    Created shift register VHDL block.
    Implemented signal processor block with shift registers in signal processor manager.
2023-04-26 Worked on the linear voltage regulators
    [Discrete_linear_regulator.kicad_sch]
2023-04-28 Create Loading samples for FFT and IFFT timing.drawio
    Made timing diagram for confirming better approach in loading samples and processing them with a latency of at least 1 sample.
2023-05-08 kicad sepic update
    [-15V SEPIC.kicad_pcb, -15V SEPIC.kicad_sch]
2023-05-08 sepic step file
    [Discrete_linear_regulator.kicad_pcb, Discrete_linear_regulator.kicad_sch]
2023-05-09 Schematic orderlist update
    [Generic_Buck_Converter.csv, Generic_Buck_Converter.kicad_pcb, Generic_Buck_Converter.kicad_sch]
2023-05-09 Worked on main board SCH
    [ADC_CH1_2.kicad_sch, DAC_CH1_2.kicad_sch, FPGA.kicad_sch]
2023-05-09 layout pcb discrete linear regulator
2023-05-10 update SDD front/back end
    [Discrete_linear_regulator.kicad_pcb, Discrete_linear_regulator.kicad_sch]
2023-05-10 Created Signal processor framework with FFT
2023-05-10 Added SEPIC symbol and footprint and worked on main board
    [-15V SEPIC.kicad_pcb, -15V SEPIC.kicad_sch, Main board.kicad_pcb, Main board.kicad_sch, POWER_SUPPLIES.kicad_sch]
2023-05-10 Worked on main board schematic
2023-05-10 Worked on main board and added nettie 0.3mm
    [DAC_CH1_2.kicad_sch, Main board.kicad_pcb]
2023-05-11 Added Gerber + Excel-sheet
    [Generic_Buck_Converter-B_Cu.gbl, Generic_Buck_Converter-B_Mask.gbs, Generic_Buck_Converter-B_Paste.gbp, Generic_Buck_Converter-B_Silkscreen.gbo, Generic_Buck_Converter-Edge_Cuts.gm1, Generic_Buck_Converter-F_Cu.gtl, Generic_Buck_Converter-F_Mask.gts, Generic_Buck_Converter-F_Paste.gtp]
2023-05-16 added datasheets to -15V Sepic
    [-15V SEPIC.csv, -15V SEPIC.kicad_sch]
2023-05-17 linear regulators changes
    [-15V SEPIC.csv, Discrete_linear_regulator.kicad_pcb, Discrete_linear_regulator.kicad_sch]
2023-05-17 Worked on SDD, main board schematic and LTspice discrete linear regulator
    [DAC_CH1_2.kicad_sch, DAC_CH3_4.kicad_sch, DAC_CH5_6.kicad_sch, Main board.kicad_pcb]
2023-05-22 update linear regulator pcb
    [Discrete_linear_regulator.kicad_pcb, Discrete_linear_regulator.kicad_sch]
2023-05-23 Matlab DFT with cosine and sine
    Created matlab script and simulink model to compute real and imaginary values of certain coefficients in input signal by multiplying input samples with sine and cosine for one period.
2023-05-23 update linear regulators
    [Discrete_linear_regulator.kicad_sch]
2023-05-23 Worked on main board schematic and PCB, added symbols to symbol library
    [ADC_CH1_2.kicad_sch, ADC_CH3_4.kicad_sch, DAC_CH1_2.kicad_sch, DAC_CH3_4.kicad_sch, DAC_CH5_6.kicad_sch, FPGA.kicad_sch, Main board.kicad_pcb, Main board.kicad_sch]
2023-05-23 Worked on main board design
    [ADC_CH1_2.kicad_sch, ADC_CH3_4.kicad_sch, DAC_CH1_2.kicad_sch, FPGA.kicad_sch, Main board.kicad_pcb, Main board.kicad_sch, POWER_SUPPLIES.kicad_sch]
2023-05-24 Schematic update Liniar
    [Discrete_linear_regulator.kicad_sch]
2023-05-24 Linear regulator schematic update
    [Discrete_linear_regulator.kicad_sch]
2023-05-24 Linear regulator update
2023-05-24 update linear pcb
    [Discrete_linear_regulator.kicad_pcb]
2023-05-25 Schematic update
    [Discrete_linear_regulator.csv, Discrete_linear_regulator.kicad_sch]
2023-05-25 Worked in main board
    [ADC_CH1_2.kicad_sch, DAC_CH1_2.kicad_sch, DAC_CH3_4.kicad_sch, DAC_CH5_6.kicad_sch, FPGA.kicad_sch, Main board.kicad_pcb, Main board.kicad_sch, POWER_SUPPLIES.kicad_sch]
2023-05-26 Test FPGA overclocking
    created new Quartus project to test PLL block capabilities to overclock the FPGA. This is possible up to a certain frequency. Highest frequency so far was 670MHz. See .sof files.
    [c5_pin_model_dump.txt]
2023-05-29 update linear
    [Discrete_linear_regulator.kicad_pcb, Discrete_linear_regulator.kicad_sch]
2023-05-30 Main board
    [ADC_CH1_2.kicad_sch, POWER_SUPPLIES.kicad_sch]
2023-05-30 update linear and gerbers
    [Discrete_linear_regulator.kicad_pcb, Discrete_linear_regulator.kicad_sch]
2023-05-30 Mainboard buck_converter symbol update
2023-05-30 Mainboard buck_converter footprint update
2023-05-30 Added 3D file for buck converter
2023-05-30 main PCB update DAC CH_1_2
    [Main board.kicad_pcb]
2023-05-31 new gerbers
2023-05-31 added drill map files :)
    [-15V SEPIC.kicad_pcb, Discrete_linear_regulator.kicad_pcb]
2023-05-31 update linear regulator footprint
2023-05-31 Completed ordering folder JLCPCB
    [Order form 31-05-2023 JLCPCB.xlsm]
2023-06-01 FFT processing architecture diagram
    Made first draft of FFT butterfly system within the FPGA system. Designed the subblocks and started on designing indexation formula for every processing stage.
2023-06-01 Test FPGA memory allocation VHDL
    Made a test program in VHDL to check how much memory is used by the FPGA for certain data arrays.
    [c5_pin_model_dump.txt]
2023-06-01 Mainboard pcb update
    [Main board.kicad_pcb]
2023-06-05 Main board, ordering of PCBs and LTspice simulations
    [ADC_CH1_2.kicad_sch, ADC_CH3_4.kicad_sch, DAC_CH1_2.kicad_sch, Order form 31-05-2023 JLCPCB.xlsm]
2023-06-05 Main PCB update
    [Main board.kicad_pcb]
2023-06-05 Update Audio sampler VHDL
    Updated Audio sampler VHDL so audio_sampler.bdf is now top level entity.
2023-06-05 Started UART protocol in VHDL
    Created a new quartus project for the UART protocol with the schematic of the basic blocks.
2023-06-05 created and tested uart parts
    the receiving and transmitting block have been coded and tested
    The TX buffer is no finished
    The RX buffer is not started
    the clock divider is not started
2023-06-05 Updated UART protocol project
    Made transmitter faster,
    Created the TxFIFO using 2D arrays
2023-06-06 Ad good as finilized the main board schematic
    [ADC_CH1_2.kicad_sch, ADC_CH3_4.kicad_sch, DAC_CH1_2.kicad_sch, DAC_CH3_4.kicad_sch, DAC_CH5_6.kicad_sch, FPGA.kicad_sch, Main board.kicad_sch, POWER_SUPPLIES.kicad_sch]
2023-06-06 Finalizer main board schematic exept passive order links. Schematic ready for review
    [ADC_CH1_2.kicad_sch, ADC_CH3_4.kicad_sch, DAC_CH1_2.kicad_sch, DAC_CH3_4.kicad_sch, DAC_CH5_6.kicad_sch, FPGA.kicad_sch, Main board.kicad_sch, POWER_SUPPLIES.kicad_sch]
2023-06-06 Added component links to main board schematic
    [ADC_CH1_2.kicad_sch, ADC_CH3_4.kicad_sch, DAC_CH1_2.kicad_sch, DAC_CH3_4.kicad_sch, DAC_CH5_6.kicad_sch, Main board.kicad_sch, POWER_SUPPLIES.kicad_sch]
2023-06-07 Updated UART protocol
    finished simulating the system
    the hardware test is yet to be performed
    [c5_pin_model_dump.txt]
2023-06-07 Added component links
    [ADC_CH1_2.kicad_sch, ADC_CH3_4.kicad_sch, DAC_CH1_2.kicad_sch, DAC_CH3_4.kicad_sch, DAC_CH5_6.kicad_sch]
2023-06-08 Updates on main board
    [ADC_CH1_2.kicad_sch, ADC_CH3_4.kicad_sch]
2023-06-08 Main brd
    [Main board.kicad_pcb]
2023-06-08 Footprint update
2023-06-08 main pcb
    [Main board.kicad_pcb]
2023-06-08 Schematic send to Ralph for review
    [ADC_CH1_2.kicad_sch, FPGA.kicad_sch, Main board.kicad_sch, Order form xx-06-2023 JLCPCB.xlsm, Order form xx-06-2023 components.xlsm, POWER_SUPPLIES.kicad_sch]
2023-06-08 Added PDF versions of the other schematics ass wel to see back for later
2023-06-12 Main board update
    [Main board.kicad_pcb]
2023-06-13 Main board components to be ordered
    [ADC_CH1_2.kicad_sch, DAC_CH1_2.kicad_sch, Order form xx-06-2023 components.xlsm, POWER_SUPPLIES.kicad_sch]
2023-06-13 PCB Main update
    [Main board.kicad_pcb]
2023-06-13 Filled in main board BOM exept for fifth buck converter
    [ADC_CH1_2.kicad_sch, Main board.kicad_sch, Order form xx-06-2023 components main board1.xlsm, Order form xx-06-2023 components main board2.xlsm, Order form xx-06-2023 components.xlsm]
2023-06-14 Update Main board.kicad_pcb
    [Main board.kicad_pcb]
2023-06-14 Added rotary encoder and pull-up
    [ADC_CH1_2.kicad_sch, DAC_CH1_2.kicad_sch, DAC_CH3_4.kicad_sch, DAC_CH5_6.kicad_sch, FPGA.kicad_sch, Main board.kicad_sch, Order form xx-06-2023 components main board1.xlsm, Order form xx-06-2023 components main board2.xlsm]
2023-06-14 Updated order forms and ordered components 14-06-2023
    [Order form 14-06-2023 components main board1.xlsm, Order form 14-06-2023 components main board2.xlsm, Order form xx-06-2023 components main board1.xlsm, Order form xx-06-2023 components main board2.xlsm]
2023-06-15 fully working UART protocol with test controller
2023-06-16 Update multiplier_rounder.vhd
    Implemented unsigned, signed and STD_LOGIC_VECTOR multiplication functions. The unsigned and STD_LOGIC_VECTOR got to work in a very small time. But the signed one was very tricky. But in this version I have verified that the signed multiplication now also works (even though the results are odd, they are correct).
    [multiplier_rounder.vhd]
2023-06-16 Update multiplier_rounder.vhd
    Fixed bug where small value results would also be shifted to the MSB, resulting in a wrong answer. Fixed this problem for unsigned, signed and STD_LOGIC_VECTOR types. Verified that it works with the do file.
    [multiplier_rounder.vhd]
2023-06-16 Main board update ADC and DAC
    [Generic_Buck_Converter.xlsx, Main board.kicad_pcb]
2023-06-19 Create BPF_filter.vhd
    Made BPF filter with state space.
    So far the computation of the discrete state space coefficients work.
    The compression of the larger binary value to a smaller one works now for unsigned values
2023-06-20 updated UIController
    added page navigation through buttons
2023-06-21 updated the encoder schematic
    added pullup resistors to the output lines of the encoder and added debounce to the last remaining line.
    [ADC_CH1_2.kicad_sch, Main board.kicad_sch]
2023-06-21 added debounce resistor
    [Main board.kicad_sch]
2023-06-21 Updated main a bit
    [Main board.kicad_pcb]
2023-06-22 Added schematic and PCB
2023-06-23 Update MDD
    Added system context chapter from SDD and pasted that into sytem context.tex.
    Added argumentation for choosing distance between BPF bands for equalizer filter in Architecture chapter.
2023-06-24 JO LEES OMSCHRIJVING
    heeft iemand enig idee waarom onze ToC niet zichtbaar is? Heb de titlepage info nu uit de .tex gehaalld en gewoon in de mainfile gezet. Maar dat doet hij ook nog steeds niet :/
2023-06-26 Update BPF filter VHDL
    Now able to compute state-space coefficients in VHDL correctly.
    Computation of state-space output does not work yet.
    Made test bench with sinewave generator as input.
2023-06-26 Stoemp alles in de git
    Want git doet weer moeilijk
2023-06-26 added schematics as appendices
    added schematic appendices
2023-06-26 Updated I2S decoder and encoder
    Added available inputs and outputs
2023-06-26 Added appendix file for schematics
2023-06-26 Update MDD
    Finished Architecture chapter.
    Added I2C master VHDL code in appendix.
    Added explanation in firmware chapter for BPF and sinewave generator with equations.
2023-06-26 PCB finished + gerber
    [ADC_CH1_2.kicad_sch, DAC_CH3_4.kicad_sch, FPGA.kicad_sch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]
2023-06-27 Updated main board. Ready to order now
    [ADC_CH1_2.kicad_sch, FPGA.kicad_sch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]
2023-06-27 Ready to order PCB
2023-06-27 Update BPF VHDL
    Fixed bug where coefficient Bd is computed wrongly.
    Now the state-space filter works correct.
    Also the gain parameter can be configured correctly now.
2023-06-28 Order info of main board
2023-07-03 Order forms and simulation model correction
    [Order form 27-06-2023 JLCPCB main board.xlsm, Order form xx-06-2023 JLCPCB.xlsm]
2023-07-03 Update BPF + sinewave gen
    Corrected for -6dB resonance frequency in BPF filter computation by multiplying gain by 2 default.
    Changed sinewave generic desired_freq variable to an input for doing tests with different frequencies, so the frequency spectrum could be seen.
    New results of the frequency spectrum response for a BPF of 400Hz have been made and varying the gain so the signal will be clipped is also simulated corrreclty. These PDF files are also in this commit.
    [sinewave_generator.vhd]
2023-07-04 Update BPF + sinewave VHDL
    Implemented output available triggering correctly 180 degrees out of phase to the MCLK.
    [sinewave_generator.vhd]
2023-07-05 Updated I2S decoder and encoder
    Implemented output available bit in decoder and input available bit in encoder and made it so it pulses only once and that it can detect that pulse correctly. Tested it in modelsim, see result pdf in this commit.
    [Audio_sampler.vhd]
2023-07-05 Update Audio-sampler VHDL
    Implemented improved availability bit in I2S encoder and made it synthesizable. See resulting working simulation of Audio-dsp in this commit .pdf.
    BPF VHDL: moved signal state into process and made it a variable.
2023-07-05 update sdram
    [c5_pin_model_dump.txt]
2023-07-05 Create BPF_filter_v3.vhd
    Created new version for fixed point implementation.
    [BPF_filter_v3.vhd]
2023-07-05 Create fixedPointTest.vhd
    Created new file for testing the fixed point package.
    [fixedPointTest.vhd]
2023-07-05 Updated BPF filter VHDL
    Implemented Fixed Point in the BPF VHDL code. Now the code is synthesizable. Sadly the included BPF in the system results in a tremendous amount of noise, the audio is slightly hearable. But the noise is unbearable.
    Replaced the gain computation with a lookup table that contains all the gain values for the different dB's from the param input.
    Did the frequency test and gain test again. Simulation results can be seen in the .pdf from this commit.
    [BPF_filter_v3.vhd, BPF_filter_v3_sinewave_test.vhd]
2023-07-07 Created audio_sampler testbench
    Created audio sampler testbench where sinewave generator is the input.
    Did tests on different sample frequencies.
    Result of 192kHz, 10kHz input sinewave with 1kHz bpf can be seen in pdf from this commit.
2023-07-10 Create Drill stencil.pdf
2023-07-10 Update BPF VHDL
    Updated BPF such that the nrst is implemented. Still does not work. We have chosen not to continue debugging the BPF.
    Fixed bug in the Initializer block where the index is not reset when the block is reset. Now the system can be reset correctly and restarts correctly.
    [Audio_sampler.vhd, Audio_sampler_testbench.vhd, BPF_filter_v3.vhd, Initializer.vhd]
2023-07-10 Update Audio-DSP
    Fixed bug in clock divider VHDL. Now the clock has 50% duty cycle.
    Remade I2S encoder and decoder in V2. They now dont use the handshake protocol anymore.
    Remade volume effect such that it now works continuous. Fixed bug in gain lookup table. It is now a constant and the values are now limited to three decimals.
    The volume effect can also be controlled with switched and this has worked, see .sof files.
    [Audio_sampler.vhd, clk_div.vhd, controller_eff.vhd, i2s_decoder_v2.vhd, i2s_encoder_v2.vhd, volume_eff_v2.vhd]
2023-07-10 Update Volume Effect VHDL
    Gave the lookup gain more decimals and now it still works with a varying gain with the switches.
2023-07-10 Update BPF VHDL
    Made a new schematic file in quartus to test the system with the BPF. Tried to fix it by making the gain lookup table a constant but it still just gives out noise a lot. The music can be heard very little.
    So skip the BPF and focus on the report.
    [BPF_filter_v3.vhd]
2023-07-11 Update Audio-DSP
    Implemented volume range from -87dB to 40dB. Removed clock divider and made MCLK for audio_codec with PLL. This seems to have fixed a bug where sometimes the left audio channel was not working.
    The working volume controls from -87dB to 40dB are saved in the .sof files from this commit.
    Also made a text file with the C code to generate the lookup table for the gains.
    [Audio_sampler.vhd, Initializer.vhd, PLL_audio_codec.vhd, PLL_audio_codec_0002.v, controller_eff.vhd, volume_eff_v2.vhd]
2023-07-11 probably fully functional encoder
    [c5_pin_model_dump.txt]
2023-07-12 menu fix
    still some bug in touchscreen
    [UIController.vhd]
